hybridgroup/gobot/v2/platforms/opencv/lena-256x256.jpg

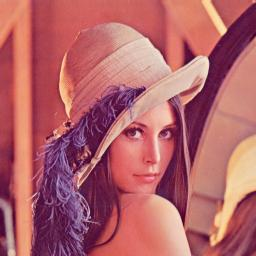
v2/platforms/opencv/lena-256x256.jpg
