hybridgroup/gobot/platforms/dji/README.md

# DJI

This package contains the Gobot drivers for DJI (https://www.dji.com/) drones.

This package currently supports the following drones:
- [DJI Tello](https://www.ryzerobotics.com/tello)
