hybridgroup/gobot/platforms/upboard/README.md

# Upboard

This package contains the Gobot adaptor for the [UP2]() IoT platforms.

This package currently supports the following hardware:
- UP2 (Squared)
