hybridgroup/gobot/.chglog/CHANGELOG.gobot.md

# {{ .Info.Title }}

Please adjust manually before add content to CHANGELOG.md.

{{ if .Versions -}}
## [Unreleased]({{ .Info.RepositoryURL }}/compare/{{ $latest := index .Versions 0 }}{{ $latest.Tag.Name }}...HEAD)

{{ if .Unreleased.CommitGroups -}}
{{ range .Unreleased.CommitGroups -}}
### {{ .Title }}
{{ range .Commits -}}
* {{ if .Scope }}**{{ .Scope }}:** {{ end }}{{ .Subject }}
{{ end }}
{{ end -}}
{{ end -}}
{{ end -}}

{{ range .Versions }}## {{ if .Tag.Previous }}[{{ .Tag.Name }}]({{ $.Info.RepositoryURL }}/compare/{{ .Tag.Previous.Name }}...{{ .Tag.Name }}){{ else }}{{ .Tag.Name }}{{ end }} ({{ datetime "2006-01-02" .Tag.Date }})

{{ range .CommitGroups -}}
### {{ .Title }}

{{ range .Commits -}}
* {{ if .Scope }}**{{ .Scope }}:** {{ end }}{{ .Subject }}
{{ end }}
{{ end -}}

{{- if .NoteGroups -}}
{{ range .NoteGroups -}}
### {{ .Title }}

{{ range .Notes }}
{{ .Body }}
{{ end }}
{{ end -}}
{{ end -}}
{{ end -}}
