hybridgroup/gobot/(threads)

Thread 166 (2014-12-21):

Cant start gobot with raspberry pi adapter and servo driver

razic, 2014-12-21:
here is my code:

```go
package main

import (
        "github.com/hybridgroup/gobot"
        "github.com/hybridgroup/gobot/platforms/gpio"
        "github.com/hybridgroup/gobot/platforms/raspi"
        "log"
        "time"
)

func main() {
        gbot := gobot.NewGobot()
        r := raspi.NewRaspiAdaptor("raspi")
        servo := gpio.NewServoDriver(r, "servo", "23")
        work := func() {
                gobot.Every(10*time.Second, func() {
                        i := uint8(gobot.Rand(180))
                        log.Printf("Moving servo to %d", i)
                        servo.Move(i)
                })
        }
        robot := gobot.NewRobot(
                "servoBot",
                []gobot.Connection{r},
                []gobot.Device{servo},
                work,
        )

        gbot.AddRobot(robot)
        gbot.Start()
}
```

and this is the error is get

```bash
./main.go:14: cannot use r (type *raspi.RaspiAdaptor) as type gpio.Servo in argument to gpio.NewServoDriver:                                                                                                        │
        *raspi.RaspiAdaptor does not implement gpio.Servo (missing InitServo method)
```

any suggestions?

razic, 2015-01-03:
@zankich great. sounds like we're almost there. is it possible you would be able to explain on a high level a bit more in-depth what it would take to get the pi blaster support going?

correct me if i'm wrong, but it seems like pi-blaster is either a process or a script that needs to be run at least once. then, we can write values to `/dev/pi-blaster`?

zankich, 2015-01-03:
@razic I created a branch with initial pi-blaster support https://github.com/hybridgroup/gobot/tree/raspi_pwm. In order to get this to work you'll have to follow the installation instructions for [pi-blaster](https://github.com/sarfata/pi-blaster#how-to-build-and-install). I don't currently have access to a raspberry pi, so I only tested locally with manually verifying values and it should work.... If you're feeling brave you can check out that branch and let me know how it goes!

SellJamHere, 2015-06-25:
Has there been any further work on PWM support?

zankich, 2015-06-30:
@razic and @SellJamHere pwm support has just landed in the master branch. You need to follow the instructions [here](https://github.com/hybridgroup/gobot/tree/master/platforms/raspi#enabling-pwm-output-on-gpio-pins) to enable PWM pins.

edgarsilva, 2015-07-03:
We should close this since pwm support has been added, or are we waiting for release?

zankich, 2015-07-03:
This has been released and I tested with a servo and led on a raspi b+

matipan, 2018-10-08:
@zankich Do you have an example I could follow? I'm trying with a MG90 servo tower connected to GPIO 11 on a pi b+ but it does not seem to be working

deadprogram, 2018-10-08:
You might want to open a new issue @matipan this one has been closed for a long time.

Closed 2015-07-03.

Thread 172 (2015-01-15):

Servos: setting minimum and maximum "pulse width" - Arduino

pipejesus, 2015-01-15:
Using the Arduino libraries i can set the maximum and minimum pulse width for my servo so that i can calibrate it. Is it possible with Gobot ? What i mean is this : http://arduino.cc/en/Reference/ServoAttach

zankich, 2015-01-15:
@pipejesus at the moment no, we don't have that capability, however I'm currently working on a refactor of our firmata implementation and based off of the [servo](https://github.com/firmata/protocol/blob/master/servos.md) protocol document, it should be easy to add.

pipejesus, 2015-01-15:
Superb! Great project, thank you Adrian for bringing Gobot to Earth :-)

losinggeneration, 2016-07-17:
It looks like this might be implemented (at least on the client library.) https://github.com/hybridgroup/gobot/blob/dev/platforms/firmata/client/client.go#L217 However, it looks like the bytes are sent as max,min instead of min,max unless I'm misunderstanding the code and/or protocol doc.

deadprogram, 2016-07-19:
Hi @losinggeneration looks to me like you are absolutely correct. Would you be willing to submit a PR with that fix?

losinggeneration, 2016-07-20:
I'll pick up a servo tomorrow to verify it works and then get a PR in for it.

deadprogram, 2016-11-05:
Seems like this was addressed already. Please reopen if needed.

Closed 2016-11-05.

Thread 173 (2015-02-04):

Running firmata_blink on Arduino fails on second attempt.

dkinzer, 2015-02-04:
If I control C out of a running process and retry then the new process hangs unless I unplug and replug the USB port from the Arduino device.

```

(examples)(master)$./firmata_blink
2015/02/04 09:51:06 Initializing Robot bot ...
2015/02/04 09:51:06 Initializing connections...
2015/02/04 09:51:06 Initializing connection arduino ...
2015/02/04 09:51:06 Initializing devices...
2015/02/04 09:51:06 Initializing device led ...
2015/02/04 09:51:06 Starting Robot bot ...
2015/02/04 09:51:06 Starting connections...
2015/02/04 09:51:06 Starting connection arduino on port /dev/ttyACM0...
2015/02/04 09:51:12 Starting devices...
2015/02/04 09:51:12 Starting device led on pin 13...
2015/02/04 09:51:12 Starting work...
^C2015/02/04 09:51:35 Stopping Robot bot ...
dkinzer09:51[~/go/src/github.com/hybridgroup/gobot/examples]
(examples)(master)$./firmata_blink
2015/02/04 09:51:47 Initializing Robot bot ...
2015/02/04 09:51:47 Initializing connections...
2015/02/04 09:51:47 Initializing connection arduino ...
2015/02/04 09:51:47 Initializing devices...
2015/02/04 09:51:47 Initializing device led ...
2015/02/04 09:51:47 Starting Robot bot ...
2015/02/04 09:51:47 Starting connections...
2015/02/04 09:51:47 Starting connection arduino on port /dev/ttyACM0...
```

saljam, 2015-03-31:
I can reproduce this but only on Linux. OS X seems to work fine.

Also worth mentioning that unbinding and rebinding the USB serial driver doesn't seem to affect it. Only unplugging and plugging back in again or pressing the reset button on the Arduino seems to do the job.

dkinzer, 2015-03-31:
Yes, I should have mentioned that I was using Ubuntu 14.04 LTS when I ran into this issue.

saljam, 2015-03-31:
OK it seems that when the Firmata firmware is reset it preemptively sends over its firmwareQuery answer, which triggers the rest of the initialisation process in the package.

But for some reason, the reset command doesn't actually register on my Arduino when send from a Linux host :-/ Explicitly sending a firmwareQuery when connecting works around this, however. I'll send a PR in a bit.

zankich, 2015-04-06:
@dkinzer does https://github.com/hybridgroup/gobot/pull/180 fix the problem you're experiencing?

dkinzer, 2015-04-07:
Sorry, I can't check this until tomorrow.

dkinzer, 2015-04-08:
@saljam @zankich it works, but not consistently.  Almost invariable on the first attempt it fails.  I control C out of that and try again and then it works.  Sometimes have to even try several failed attempts before it works.

By the way, what's the canonical way of trying out patches in go projects.  For this one I just manually made the change on my local firmata.go file.

saljam, 2015-04-08:
@dkinzer thanks for testing! I'll try to make it produce the same behaviour as that when I get some time. When I tried it it seemed to work fine here.

To try out a pull request you could run:

    $ git fetch origin pull/<pull-request-id>/head:<new-branch-name>
    $ git checkout <new-branch-name>

and rebuild the project. The [GitHub documentation](https://help.github.com/articles/checking-out-pull-requests-locally/) has more about this.

dkinzer, 2015-04-08:
@saljam thanks.  The problem regarding testing of a patch had more to do with the Go System then the technicality of pulling in new code and running it, because go imports take repo source direclty (i.e "github.com/hybridgroup/gobot/platforms/firmata").

saljam, 2015-04-08:
The go tool checks out the repository into $GOPATH if it doesn't already exist, and that's pretty much all it knows about version control. Other than that, the import path is just the path to the package source files. So if you `cd $GOPATH/github.com/hybridgroup/gobot` then fetch and checkout the pull request in there it will use the new version.

dkinzer, 2015-04-08:
cool. thanks!

zankich, 2015-06-30:
@dkinzer the firmata package has been updated, can you please pull the latest master branch and test, thanks!

saljam, 2015-07-01:
FWIW the latest master works for me. Thanks again.

edgarsilva, 2015-07-04:
Closing this since it seems fixed in master and latest release.

Closed 2015-07-04.

Thread 174 (2015-02-04):

beaglebone usr led path incorrect

blalor, 2015-02-04:
Trying out gobot with a white Beaglebone running Debian.  The path to the usr leds on my device is `/sys/devices/ocp.3/gpio-leds.7/leds/beaglebone:green:`, but the Beaglebone adaptor is hard-coded to `/sys/devices/ocp.3/gpio-leds.8/leds/beaglebone:green:`.  So the blinking doesn't happen (and worse, there's no error).

I haven't found a canonical source for this info, but from [this](http://derekmolloy.ie/beaglebone-controlling-the-on-board-leds-using-c/) it appears (and I've verified) that there are symlinks in `/sys/class/leds` that point to the appropriate `gpio-leds.X` location.  Also referenced [here](http://robotic-controls.com/book/export/html/69).

If there's not already a fix in the works (haven't seen any other issues filed for this), I'll whip up a PR.

zankich, 2015-02-04:
@blalor it seems like doing a `glob` similarly to how the `ocp` and `slots` are figured out should be an easy fix. I would gladly accept a pr to fix this issue :+1:

deadprogram, 2015-11-07:
Hi, @blalor

Did you ever create a fix for this issue, and if so, can you submit a PR?

Thanks!

deadprogram, 2016-11-27:
This issue should now be addressed in the https://github.com/hybridgroup/gobot/tree/feature/beaglebone-4 branch.

deadprogram, 2016-11-30:
Here is a PR for any comments: https://github.com/hybridgroup/gobot/pull/342

deadprogram, 2016-12-03:
This has been merged into the `dev` branch. Thanks everyone!

Closed 2016-12-03.

Thread 176 (2015-02-21):

problem in blink led gobot

myalexer, 2015-02-21:
hi
my platform is arduino - os : win7
my code :
package main

import (
	"time"
	"github.com/hybridgroup/gobot"
	"github.com/hybridgroup/gobot/platforms/firmata"
	"github.com/hybridgroup/gobot/platforms/gpio"
)

func main() {
	gbot := gobot.NewGobot()

	firmataAdaptor := firmata.NewFirmataAdaptor("arduino", "COM15")
	led := gpio.NewLedDriver(firmataAdaptor, "led", "13")

	work := func() {
		gobot.Every(1 * time.Second, func() {
			led.Toggle()
		})
	}

	robot := gobot.NewRobot("bot3",
		[]gobot.Connection{firmataAdaptor},
		[]gobot.Device{led},
		work,
	)

	gbot.AddRobot(robot)

	gbot.Start()
}

all things is ok
i type go run blink.go
it return :
2015/02/21 00:07:40 Initializing Robot bot3 ...
2015/02/21 00:07:40 Initializing connections...
2015/02/21 00:07:40 Initializing connection arduino ...
2015/02/21 00:07:40 Initializing devices...
2015/02/21 00:07:40 Initializing device led ...
2015/02/21 00:07:40 Starting Robot bot3 ...
2015/02/21 00:07:40 Starting connections...
2015/02/21 00:07:40 Starting connection arduino on port COM15...

program start successful but led do not Toggle every 1 second
how do i do?

zankich, 2015-02-23:
@myalexer Is your arduino flashed with firmata and are you sure that COM15 is the correct port number? I just tested on windows 7 and it worked for me...

myalexer, 2015-02-24:
yes i test it with arduino program - in arduino ide port is COM15  - blink program with arduino syntax is ok and it work

myalexer, 2015-02-24:
how can i found COM port number?

mukosolu, 2015-04-09:
Hi, I also struggled with this problem. it might be an idea for this page: http://gobot.io/documentation/getting-started/ to also tell users to run the firmata example first.

myalexer, 2015-04-12:
i test it but it can't work
i found port . but led not toggle every second
i think it's bug

LaraChicharo, 2015-04-27:
I have the same problem on Arduino uno, but Ubuntu 14.10. It blinks three times no matter what port I set, even when led is not in that port. According to me, my serial port is correct 'ttyACM0'. If I get something I will let you know.

LaraChicharo, 2015-04-27:
I can run it now!
My problem was that I was not flashed the Arduino with firmata.
http://firmata.org/wiki/Main_Page#Arduino_Uno

I'm not really sure, but, in gobot's getting started documentation there is nothing about firmata.

zankich, 2015-04-27:
@LaraChicharo I'll add more documentation about steps for loading firmata on your arduino, sorry for the confusion!

myalexer, 2015-05-02:
zankich please help me for solved this problem
i start 2 month ago , but still i have problem in blink led !!!!

pedromorgan, 2015-06-20:
Yea I;m kinda stuck with Firmata not working also,... amd confused..

edgarsilva, 2015-07-03:
Hi guys,

First things first, the process to get the blink example working is as follows:

### Upload Firmata Sketch to the Arduino.
You can do this using the Arduino IDE or using (gort.io)[gort.io].

When using the Arduino IDE just click on file > examples > firmata > StandardFirmata and upload that sketch to the arduino.

When using (gort.io)[gort.io] first install it, then run:
```
# This installs avrdude, which allows to upload the firmata sketch to the arduino
gort arduino install

# Scan serial port for arduino serialport address
gort scan serial

# Upload firmata protocol/sketch to the correct port the arduino is connected to
$ gort arduino upload firmata /dev/ttyACM0
```

### Compile and run arduino_blink.go

Make sure you are using the correct port, in the case of windows you can check the port is the correct one if you can upload an example (like blink sketch) in the arduino IDE. If it uploads and works you should be good. Just update the port in the gobot example and compile.

In Linux is even easier to identify the serial port by using either `gort scan serial` or just checking `/dev/ttyACM*`.

Compile and run the program, after that it should work fine.

Let me know if that helps.

deadprogram, 2015-11-07:
Hi, everyone

I think the docs located here are sufficient: https://github.com/hybridgroup/gobot/blob/dev/platforms/firmata/README.md

If not, someone can re-open this issue. Thanks, and closing.

kedare, 2017-01-07:
Same problem here, Arduino Uno with the firmata firmware flashed fine ( I could use pyFirmata to test), nothing happens, I added some logs in the program to have more information :

```
package main

import (
	"fmt"
	"time"

	"gobot.io/x/gobot"
	"gobot.io/x/gobot/drivers/gpio"
	"gobot.io/x/gobot/platforms/firmata"
)

func main() {
	firmataAdaptor := firmata.NewAdaptor("/dev/cu.usbmodem1411")
	led := gpio.NewLedDriver(firmataAdaptor, "13")

	work := func() {
		gobot.Every(1*time.Second, func() {
			fmt.Println("Updating LED")
			led.Toggle()
		})
	}

	robot := gobot.NewRobot("bot",
		[]gobot.Connection{firmataAdaptor},
		[]gobot.Device{led},
		work,
	)

	fmt.Println("Starting")
	robot.Start()
	fmt.Println("Started")
}
```

```
2017/01/07 22:43:22 Initializing connections...
2017/01/07 22:43:22 Initializing connection Firmata ...
2017/01/07 22:43:22 Initializing devices...
2017/01/07 22:43:22 Initializing device LED ...
2017/01/07 22:43:22 Robot bot initialized.
Starting
2017/01/07 22:43:22 Starting Robot bot ...
2017/01/07 22:43:22 Starting connections...
2017/01/07 22:43:22 Starting connection Firmata on port /dev/cu.usbmodem1411...
```

It's not even running the work function.

The TTY port is correct (Detected by Arduino IDE and working fine with pyFirmata)

What could be the cause ?

kedare, 2017-01-07:
Ok I found the issue, looks like for master part is missing from the example code, here is the working one :

```
package main

import (
	"fmt"
	"time"

	"gobot.io/x/gobot"
	"gobot.io/x/gobot/drivers/gpio"
	"gobot.io/x/gobot/platforms/firmata"
)

func main() {
	gbot := gobot.NewMaster()
	firmataAdaptor := firmata.NewAdaptor("/dev/cu.usbmodem1411")
	led := gpio.NewLedDriver(firmataAdaptor, "13")

	work := func() {
		gobot.Every(1*time.Second, func() {
			fmt.Println("Updating LED")
			led.Toggle()
		})
	}

	robot := gobot.NewRobot("bot",
		[]gobot.Connection{firmataAdaptor},
		[]gobot.Device{led},
		work,
	)

	gbot.AddRobot(robot)

	fmt.Println("Starting")
	gbot.Start()
	fmt.Println("Started")
}
```

deadprogram, 2017-01-08:
Hi @kedare the original example code works for me, albeit by changing my serial port to `/dev/ttyACM0` as I am on Linux.

```
$ go run ./examples/check.go
2017/01/08 17:29:05 Initializing connections...
2017/01/08 17:29:05 Initializing connection Firmata ...
2017/01/08 17:29:05 Initializing devices...
2017/01/08 17:29:05 Initializing device LED ...
2017/01/08 17:29:05 Robot bot initialized.
Starting
2017/01/08 17:29:05 Starting Robot bot ...
2017/01/08 17:29:05 Starting connections...
2017/01/08 17:29:05 Starting connection Firmata on port /dev/ttyACM0...
2017/01/08 17:29:10 Starting devices...
2017/01/08 17:29:10 Starting device LED on pin 13...
2017/01/08 17:29:10 Starting work...
Updating LED
Updating LED
Updating LED
Updating LED
Updating LED
Updating LED
```

Since the v1.0 release you can use "Classic Gobot" as the first example does, so no need for the `Master()` part.

I then tested the code on OSX, and both examples worked with my serialport `/dev/tty.usbmodem1421`. I suggest you use the `tty` vs the `cu` version of the serial port on OSX.

Hope that helps!

Closed 2015-11-07.

Thread 177 (2015-02-26):

Arduino LED example doesnt work with runtime error: index out of range

lkalneus, 2015-02-26:
Error screenshot: https://yadi.sk/i/3PPaJ05eeuQ9Z

OS: Win8 x64, Platform: Arduino UNO v3.0

deadprogram, 2015-02-26:
Hi, @lkalneus did you flash the Firmata sketch onto your Arduino before running Gobot? You can use Gort (http://gort.io) to do this.

lkalneus, 2015-03-16:
@deadprogram, yeah you are right.
It was a stupid mistake, sorry)

Closed 2015-03-16.

Thread 182 (2015-04-15):

Docs clarification: what is the MCP?

Symmetric, 2015-04-15:
I've had a look at the docs, and this project looks very useful -- but the demo examples don't discuss the high-level architecture very thoroughly.

There's mention of an MCP in a few places, but this isn't really covered in the docs. After a bit of digging and watching your videos and so on, I think I've got a grasp on these concepts -- but I think it would be useful to extend the docs to clearly cover a few of these points:

* What is the MCP?
 * For a "Hello world" usecase, probably a laptop
 * For an IOT household sensor project, I suppose this could be a Raspberry Pi?
 * Any other use cases you have envisioned?
* Can you load a program onto a microcontroller and then run it in standalone mode?
 * The docs seem to suggest that I need to keep my laptop (MCP?) connected all the time, rather than the Arduino way of compiling and loading a program onto the microcontroller. This is a big difference which isn't explicitly called out, and I think should be clarified.
 * I think a corrolary of this is that if I want to use an Arduino with GoBot, it must be connected to another device at all times.
 * What about ARM microcontrollers (such as the Teensy) which can run Go code natively? It looks like GoBot doesn't currently support running these guys in standalone mode.

If any of these points are wrong/incomplete please correct me, this is just what I've gleaned from a bunch of digging on your site.

zankich, 2015-04-15:
@Symmetric so basically the `MCP` is what controls and coordinates all of your [robots](http://godoc.org/github.com/hybridgroup/gobot#Robot). It is represented as the [gobot](http://godoc.org/github.com/hybridgroup/gobot#Gobot) type. When you do a `NewGobot()` you are instantiating a new `MCP` which you can then add robots to. The `MCP` can run locally on a computer, in the case of a laptop or raspberry pi, or it can run in a cloud instance, and remotely control robots, or communicate with other `MCP` instances to do some work. The `MCP` is the part that allows the [api](http://godoc.org/github.com/hybridgroup/gobot/api) to access your robots, and does the auto initialization and cleanup of your robots in your program. This architecture [diagram](http://cylonjs.com/images/elements/architecture-mcp.png) might help understand what's going on. Our sister project cylon.js has a section on the website discussing the architecture, which needs to be added to the gobot site as well. You can check it out [here](http://cylonjs.com/documentation/architecture/) and even though it's talking about cylon, the general architecture is still the same.

As far as running gobot on a microcontroller, that is currently not possible due the limitations in the go language. Go requires an operating system to run, so if your board does not have an OS then you can't run go on it. This however does not mean that you can't use gobot to control a microcontroller. If the microcontroller has a remote interface, such as firmata, littlewire, etc, then you can use gobot to remotely control the device. In the case of a teensy or an arduino, if you add something like a zigbee or wifi radio, you can use gobot to remotely control them from a central server, which will hold your app logic and coordinate your devices.

I hope this helps answer some of your questions. The architecture diagram and info really needs to be added to the website so that more of this stuff is clear.

deadprogram, 2016-10-21:
The `dev` branch of Gobot has many changes, one of which is that you can now run Gobot just using Robots aka "Classic Gobot". You can also use "Master Gobot" if what you want is to control multiple robots or use the API.

I am going to close this issue, please reopen if needed. Thanks.

Closed 2016-10-21.

Thread 183 (2015-04-15):

Suppor for Teensy boards?

Symmetric, 2015-04-15:
Currently there's no support listed for the ARM Cortex-M4 based [Teensy 3.1](https://www.pjrc.com/store/teensy31.html) board. Do you have plans to add support for this board?

It's appealing since it has an interrupt-driven USB stack, so it can support high bandwidth applications.

zankich, 2015-04-15:
@Symmetric I've used gobot on a teensy 3.0 using the [firmata](https://github.com/hybridgroup/gobot/tree/master/platforms/firmata) package, so it should work with the 3.1. The teensy website has more information about firmata compatibility [here](http://www.pjrc.com/teensy/td_libs_Firmata.html). Unfortunately you can't run go directly on the board itself, due to go's runtime requirements.

Symmetric, 2015-04-18:
Thanks!

Closed 2015-04-18.

Thread 188 (2015-05-13):

Gobot not working on Arduino Duemilanove

razasayed, 2015-05-13:
I have an Arduino Duemilanove. It works fine and i am able to use it from Processing code in Arduino IDE v1.6.3 on my OSX machine.
I installed gobot,but the arduino example given on gobot.io does not work on it. The LED on pin 13 does not blink every 1 second. I see the list of supported hardware is Arduino uno R3 and Teensy, as given on http://gobot.io/documentation/platforms/arduino/.
Any way i can make gobot work with Arduino Duemilanove  ?

Thanks

razasayed, 2015-05-13:
OK, finally got it to work :). Uploaded Standard Firmata to the board using the IDE.

Closed 2015-05-13.

Thread 195 (2015-07-09):

Stack trace when ctrl+c this program

zankich, 2015-07-09:
This program stack traces when you ctrl+c it

```go
package main                                                                                 
                                                                                             
import (                                                                                     
  "fmt"                                                                                      
                                                                                             
  "github.com/hybridgroup/gobot"                                                             
  "github.com/hybridgroup/gobot/platforms/gpio"                                              
  "github.com/hybridgroup/gobot/platforms/intel-iot/edison"                                  
)                                                                                            
                                                                                             
func main() {                                                                                
  gbot := gobot.NewGobot()                                                                   
                                                                                             
  board := edison.NewEdisonAdaptor("board")                                                  
  sensor := gpio.NewAnalogSensorDriver(board, "sensor", "0")                                 
                                                                                             
  work := func() {                                                                           
    gobot.On(sensor.Event("data"), func(data interface{}) {                                  
      fmt.Println("sensor", data)                                                            
    })                                                                                       
  }                                                                                          
                                                                                             
  robot := gobot.NewRobot("sensorBot",                                                       
    []gobot.Connection{board},                                                               
    []gobot.Device{sensor},                                                                  
    work,                                                                                    
  )                                                                                          
                                                                                             
  gbot.AddRobot(robot)                                                                       
                                                                                             
  gbot.Start()                                                                               
}
```
```
^C2015/07/09 17:21:26 Stopping Robot sensorBot ...
panic: runtime error: invalid memory address or nil pointer dereference
[signal 0xb code=0x1 addr=0x1 pc=0x8098519]

goroutine 1 [running]:
github.com/hybridgroup/gobot/platforms/intel-iot/edison.(*EdisonAdaptor).Finalize(0x1843a060, 0x0, 0x0, 0x0)
        /home/adrian/code/go/gopath/src/github.com/hybridgroup/gobot/platforms/intel-iot/edison/edison_adaptor.go:298 +0x4e9
github.com/hybridgroup/gobot.(*Connections).Finalize(0x18438130, 0x0, 0x0, 0x0)
        /home/adrian/code/go/gopath/src/github.com/hybridgroup/gobot/connection.go:66 +0xb3
github.com/hybridgroup/gobot.func·006(0x1843a090)
        /home/adrian/code/go/gopath/src/github.com/hybridgroup/gobot/gobot.go:82 +0x3db
github.com/hybridgroup/gobot.(*Robots).Each(0x184380e0, 0x18478ea8)
        /home/adrian/code/go/gopath/src/github.com/hybridgroup/gobot/robot.go:73 +0x5e
github.com/hybridgroup/gobot.(*Gobot).Start(0x18436480, 0x0, 0x0, 0x0)
        /home/adrian/code/go/gopath/src/github.com/hybridgroup/gobot/gobot.go:88 +0x341
main.main()
        /home/adrian/code/hybridgroup/gobot/examples/edison_grove_rotary_sensor.go:31 +0x409

goroutine 5 [syscall]:
os/signal.loop()
        /home/adrian/code/go/go1.4.2/src/os/signal/signal_unix.go:21 +0x21
created by os/signal.init·1
        /home/adrian/code/go/go1.4.2/src/os/signal/signal_unix.go:27 +0x34

goroutine 6 [chan receive]:
github.com/hybridgroup/gobot.(*Event).Read(0x184380f0)
        /home/adrian/code/go/gopath/src/github.com/hybridgroup/gobot/event.go:39 +0x52
github.com/hybridgroup/gobot.func·003()
        /home/adrian/code/go/gopath/src/github.com/hybridgroup/gobot/event.go:22 +0x31
created by github.com/hybridgroup/gobot.NewEvent
        /home/adrian/code/go/gopath/src/github.com/hybridgroup/gobot/event.go:24 +0x125

goroutine 7 [chan receive]:
github.com/hybridgroup/gobot.(*Event).Read(0x18438100)
        /home/adrian/code/go/gopath/src/github.com/hybridgroup/gobot/event.go:39 +0x52
github.com/hybridgroup/gobot.func·003()
        /home/adrian/code/go/gopath/src/github.com/hybridgroup/gobot/event.go:22 +0x31
created by github.com/hybridgroup/gobot.NewEvent
        /home/adrian/code/go/gopath/src/github.com/hybridgroup/gobot/event.go:24 +0x125

goroutine 8 [runnable]:
github.com/hybridgroup/gobot/platforms/gpio.func·002()
        /home/adrian/code/go/gopath/src/github.com/hybridgroup/gobot/platforms/gpio/analog_sensor_driver.go:71 +0x186
created by github.com/hybridgroup/gobot/platforms/gpio.(*AnalogSensorDriver).Start
        /home/adrian/code/go/gopath/src/github.com/hybridgroup/gobot/platforms/gpio/analog_sensor_driver.go:77 +0xc6
```

zankich, 2015-07-09:
fixed with https://github.com/hybridgroup/gobot/commit/5b94e593ec443639c2f0ca38d47d3fc6c5d0d22b

Closed 2015-07-09.

Thread 205 (2015-07-11):

PWM exported functions for Intel Edison

mattetti, 2015-07-11:
To be able to properly use the PWM possibilities of the Edison, one needs to set the `period` and `duty cycle` to create a pulse at a given frequency:

```
If you want a 1.6kHz wave that is a 625 microsecond period or 626000 nanoseconds (assuming a 50% duty cycle).

echo -n "625000" > /sys/class/pwm/pwmchip0/pwm3/period
echo -n "312500" > /sys/class/pwm/pwmchip0/pwm3/duty_cycle
```

Unfortunately, right now, gobot developers don't have access to period and duty cycle, as a matter of fact, they have almost no access to anything pwm related and only `func (e *EdisonAdaptor) PwmWrite` seems exposed (and it does a lot of magic).

My suggestion is to export `pwmPin` and its methods so developers interested in going a bit lower level can have fun ;)

mattetti, 2015-07-11:
@zankich @deadprogram This is currently a blocker for me to generate a proper audio signal via PWM.
For anyone else looking at this issue, here is a good document on PWM: https://www.arduino.cc/en/Tutorial/SecretsOfArduinoPWM

mattetti, 2015-07-13:
Adrian and I discussed this issue in RL and he suggested to create a new PWM interface for devices offering access to period and duty cycles

deadprogram, 2017-05-03:
Finally addressed this is part of the working done in reference to https://github.com/hybridgroup/gobot/pull/410

There is now a PWMPin that can used with all of the Linux SoC boards for more granular control over the PWM on each board.

For example:

```
a := edison.NewAdaptor()
pin := a.PWMPin("3")

// get period
period := pin.Period()

// set to 50% duty cycle
duty := period / 2
pin.SetDutyCycle(duty)
```

This is all available in the `dev` branch. I will close this issue as soon as it lands in `master` as part of the next release.

deadprogram, 2017-05-10:
This code has now been released as part of Gobot 1.5 so please either open a new issue if needed with any specifics, or reopen this one.

Thanks.

mattetti, 2017-05-10:
😎 thanks

Closed 2017-05-10.

Thread 206 (2015-07-11):

Grove LCD / Intel Edison text not displaying

mattetti, 2015-07-11:
For some reason, the demo example of the LCD doesn't correctly work on my device. While the backlit RGB colors do change properly, no text gets displayed.

deadprogram, 2015-07-11:
Make sure the switch on the side of the Grove shield is set to 5V instead of 3.3V

mattetti, 2015-07-11:
That was indeed the issue, thank you Ron!

Closed 2015-07-11.

Thread 207 (2015-07-12):

jhd1313m1 driver is missing the scrolling API

mattetti, 2015-07-12:

mattetti, 2015-07-12:
I tried to implement this method:

```go
// Scroll scrolls the dispay to the right or the left based on the passed
// param.
func (h *JHD1313M1Driver) Scroll(leftToRight bool) error {

	if leftToRight {
		return h.connection.I2cWrite(h.rgbAddress, []byte{LCD_CMD, LCD_CURSORSHIFT | LCD_DISPLAYMOVE | LCD_MOVELEFT})
	}

	return h.connection.I2cWrite(h.rgbAddress, []byte{LCD_CMD, LCD_CURSORSHIFT | LCD_DISPLAYMOVE | LCD_MOVERIGHT})
}
```

Which is supposed to be a port of https://github.com/intel-iot-devkit/upm/blob/master/src/lcd/jhd1313m1.cxx#L109

Unfortunately this feature doesn't seem to work, I'm not getting an error but nothing happens and the backlit seems to be in a weird state where I can't set the rgb colors anymore.
I also tried on an arduino and on the edison. I tried to change the first byte we write, from `0x80` to `0x40`, it wasn't doing anything on the arduino and it returned an error on the edison.

mattetti, 2015-07-12:
addressed in #209

Closed 2015-07-13.

Thread 211 (2015-07-12):

errors when reading from LIDARLiteDriver and JHD1313M1Driver

mwhooker, 2015-07-12:
code to reproduce is here https://github.com/mwhooker/speedo/tree/b6a116c9403cd26db63183fe1aaea9f006d43dc7

Every time I run the program I get an error, although the behavior varies:

```
root@edison:~# ./speedo
2015/07/12 07:04:36 Initializing Robot screenBot ...
2015/07/12 07:04:36 Initializing connections...
2015/07/12 07:04:36 Initializing connection edison ...
2015/07/12 07:04:36 Initializing devices...
2015/07/12 07:04:36 Initializing device lidar ...
2015/07/12 07:04:36 Initializing device screen ...
2015/07/12 07:04:36 Starting Robot screenBot ...
2015/07/12 07:04:36 Starting connections...
2015/07/12 07:04:36 Starting connection edison...
2015/07/12 07:04:36 Starting devices...
2015/07/12 07:04:36 Starting device lidar...
2015/07/12 07:04:36 Starting device screen...
[  505.390547] i2c-designware-pci 0000:00:09.1: i2c_dw_handle_tx_abort: lost arbitration
2015/07/12 07:04:36 Error: Robot "screenBot": Device "screen": write /dev/i2c-6: resource temporarily unavailable
2015/07/12 07:04:36 Stopping Robot screenBot ...
root@edison:~# ./speedo
2015/07/12 07:04:40 Initializing Robot screenBot ...
2015/07/12 07:04:40 Initializing connections...
2015/07/12 07:04:40 Initializing connection edison ...
2015/07/12 07:04:40 Initializing devices...
2015/07/12 07:04:40 Initializing device lidar ...
2015/07/12 07:04:40 Initializing device screen ...
2015/07/12 07:04:40 Starting Robot screenBot ...
2015/07/12 07:04:40 Starting connections...
2015/07/12 07:04:40 Starting connection edison...
2015/07/12 07:04:40 Starting devices...
2015/07/12 07:04:40 Starting device lidar...
2015/07/12 07:04:40 Starting device screen...
2015/07/12 07:04:40 Starting work...
Distance (in) 0
Distance (in) 0
Distance (in) 0
^C2015/07/12 07:04:42 Stopping Robot screenBot ...
```

I can get the lidar to start outputting correct distance if I unplug both the screen and the lidar, and then plug the lidar back in. Unplugging and replugging only one or the other does not work.

zankich, 2015-07-12:
@mwhooker the problem is that the i2c rgb led on the jhd1313m1 has the same i2c address of the lidar....

mwhooker, 2015-07-12:
that's unfortunate. Is there any chance of a workaround? perhaps I can take a screwdriver to the lcd i2c controller...

zankich, 2015-07-12:
@mwhooker there is a [pwm](https://github.com/PulsedLight3D/LIDARLite_Basics/blob/master/Arduino/LIDARLite_PWM_GetDistance_ContinuousRead/LIDARLite_PWM_GetDistance_ContinuousRead.ino) interface to the lidar, but that will require implementing a `pulseIn` equivalent in Gobot

mwhooker, 2015-07-12:
okay. I think I'll just modify https://github.com/hybridgroup/gobot/blob/f63fab81a3fecf2d9cc6fdfd643625fdb60fd834/platforms/i2c/jhd1313m1_driver.go to not interact with the led, or perhaps a hardware solution. thanks!

mwhooker, 2015-07-13:
above didn't work, which should have been obvious. the i2c slave still listens on the conflicting address

according to http://www.nxp.com/documents/data_sheet/PCA9533.pdf, the slave address is hard coded, but there's another version I can get with a different address (PCA9533/02). I think I'll try to track down one of those. closing, thanks!

I'm not sure this is possible, but it would be neat if gobot could detect i2c collisions and give me an error about it.

Closed 2015-07-13.

Thread 213 (2015-07-14):

Robot.Start should run r.Work() as a goroutine.

pborman, 2015-07-14:
In gobot/robot.go, around line 134, func (r *Robot) Start() calls r.Work().  If r.Work() does not return then Start will hang.  If this hangs then func (r *Robots) Start() will also hang and not call Start on any further Robots.  The solution is to make the call a goroutine.  Patch attached below.

diff --git a/robot.go b/robot.go
index 8775e87..131fade 100644
--- a/robot.go
+++ b/robot.go
@@ -131,7 +131,7 @@ func (r *Robot) Start() (errs []error) {
 	}
 	if r.Work != nil {
 		log.Println("Starting work...")
-		r.Work()
+		go r.Work()
 	}
 	return
 }

pborman, 2015-07-14:
The patch, without being marked down, is:

```
diff --git a/robot.go b/robot.go
index 8775e87..131fade 100644
--- a/robot.go
+++ b/robot.go
@@ -131,7 +131,7 @@ func (r *Robot) Start() (errs []error) {
 	}
 	if r.Work != nil {
 		log.Println("Starting work...")
-		r.Work()
+		go r.Work()
 	}
 	return
 }
```

zankich, 2015-07-14:
@pborman can you please create a pull request with this patch?

joushou, 2015-07-21:
The suggestion in #216 (split gobot.Start into gobot.Start and gobot.Stop) would most likely deprecate Work (it would no longer serve a purpose), which I find to be a bit of a peculiar construct.

zankich, 2015-07-21:
@joushou the work routine is a primitive of a `Robot` once it has successfully `Started`. When you start your `Robot` it has it's `Work` that it does. Adding the `Gobot.Start/Stop` wouldn't change that behavior.

joushou, 2015-07-21:
Ah, I think I was a bit too quick and rough in my wording. Work is called is called at the end of Robot.Start. It is currently necessary because Gobot.Start, which has the responsibility of calling Robot.Start, blocks, and doesn't terminate before os.Interrupt is issued.

Now, if Gobot.Start only called Robot.Start, or a Robot.Stop is made available so that Gobot.Start wasn't necessar, then normal program flow can follow immediately after Robot.Start/Gobot.Start, effectively making Work a slightly funky construct. It would make:

       r := gbot.NewRobot(lalala, lalala, func(){ fmt.Println("DONE!") })
       r.Start()

completely equivalent to:

       r := gbot.NewRobot(lalala, lalala)
       r.Start()
       fmt.Println("DONE!")

Therefore, while the issue of changing Gobot.Start/Stop doesn't directly affect the behaviour of Work, it does make it somewhat redundant, and I was suggesting that its presence should maybe be reconsidered.

Does my message make more sense this way?

deadprogram, 2015-10-31:
@joushou the `Work` is the user's defined function for whatever the `Robot` is supposed to do. `robot.Start` should mean "robot, start doing your defined work".

As such, "work" is an important part of the semantics of the design patterns behind Gobot.

Anyhow, this is somewhat off topic of the original issue. @pborman any chance of getting a PR against `dev` branch?

Thanks everyone!

deadprogram, 2016-10-21:
There has been substantial changes to how Gobot handles Work. Cross-posted from https://github.com/hybridgroup/gobot/issues/283#issuecomment-255311798

There has been subtancial changes to how Gobot creates and manages the goroutines used. Please take a look at the dev branch to see what we've been doing: https://github.com/hybridgroup/gobot/tree/dev

In short:

    every Robot's Work is now run inside of a separate goroutine that exists for the life of the Robot.
    every Device's On and Once event handlers are each run in a separate goroutine that exists for the life of the Device.
    channels are now used for Events, and the implementations of On and Once use the event channels as their implementation to communicate when things happen.

The dev branch has a lot of breaking changes, but I think you will find the syntax is simpler, and the implementation much cleaner and more concurrent by default.

I am going to close this issue, please reopen if so needed. Thanks everyone!

Closed 2016-10-21.

Thread 219 (2015-07-21):

Aggressive spam with firmata

joushou, 2015-07-21:
I haven't debugged this issue deeper, but making a simple robot with firmata, and making an analog reader with interval of 5 seconds causes the arduino to send aggressive rates of messages, which does not seem right (if I log in firmata/client.go@process, my stdout is spammed to death, and the TX light is practically permanently lit on the arduino).

Unsure if bug in firmware or gobot, or if but at all.

deadprogram, 2015-08-25:
Hi, @joushou

Using Firmata requires polling the serial port that is connected to the Arduino. THis is needed to determine if there are any pin changes, new i2c data, etc. As such, a fairly constant rate of communication is required with the serial port being used when using the Firmata protocol.

Please let me know if I can provide any further info, and reopen this issue if so. Thanks!

joushou, 2015-08-25:
If I read the implementation correctly, you're not supposed to poll any of that. REPORT_DIGITAL is supposed to handle info about digital pins, I2C will report back if it's set to continous mode, etc., etc.. It's meant to be a push protocol, not polling.

Of course, I may be wrong, but that's what it looks like from the StandardFirmata Arduino implementation.

joushou, 2015-08-25:
Also, I can't reopen issues. :/

deadprogram, 2016-11-04:
Hi @joushou the implementation of the Firmata's digital and analog readers should have been awaiting report notifications for a while now. I did not testing myself recently and did not see the behavior you are describing. This time I really am going to close, please open a new issue if you see this behavior. Thanks again!

joushou, 2016-11-04:
Sounds good to me. I'll reopen if I get around to testing and trying this again.

Closed 2016-11-04.

Thread 222 (2015-08-24):

Cannot run non-main package

4ur3l13n, 2015-08-24:
trying to (re) install gobot on beagleblone (archlinux) because of the issue https://github.com/hybridgroup/gobot/issues/221 I get a new issue.
bot@icecube:~/go/src/github.com/hybridgroup/gobot/platforms/beaglebone$ ls
beaglebone_adaptor.go  beaglebone_adaptor_test.go  doc.go  LICENSE  pwm_pin.go  README.md
bot@icecube:~/go/src/github.com/hybridgroup/gobot/platforms/beaglebone$ go build beaglebone_adaptor.go
 command-line-arguments
./beaglebone_adaptor.go:130: undefined: pwmPin
bot@icecube:~/go/src/github.com/hybridgroup/gobot/platforms/beaglebone$ go run beaglebone_adaptor.go
go run: cannot run non-main package
bot@icecube:~/go/src/github.com/hybridgroup/gobot/platforms/beaglebone$ uname -a && go version
Linux icecube 4.1.6-1-ARCH #1 Thu Aug 20 22:52:03 MDT 2015 armv7l GNU/Linux
go version go1.5 linux/arm
bot@icecube:~/go/src/github.com/hybridgroup/gobot/platforms/beaglebone$

deadprogram, 2015-08-25:
The problem here is that you are trying to run the wrong thing in Gobot. You want to run your own program, that uses the various adaptors/drivers. For example, you should be trying to run one off the BBB examples.

Hope that helps!

4ur3l13n, 2015-08-28:
Thanks for your light!
Sorry for the disturb.
Sure that helps!

Closed 2015-08-28.

Thread 223 (2015-08-26):

beaglebon_led_brightness.go run but does not do the job on the board BBB

4ur3l13n, 2015-08-26:
I have copy/write and execute your code directly on a BBB
It does not change the brightness of the led, it make blink like other code. I have read he beaglebone pdf and try to find the led ... it correspond to a gpio and change it to another one and the result is just same.
I have also modify the value in the code itself and the result is the same.
I conclude for the moment that the code modify something on the BBB but does not run as it should.
I have get time to also look the bonescript, it use the same led.
http://beagleboard.org/show/makerfairedetroit2013
/*

BeagleBone Led Brightness - GoBot - beaglebone_led_brightness.go

*/

package main

import (
        "time"

        "github.com/hybridgroup/gobot"
        "github.com/hybridgroup/gobot/platforms/beaglebone"
        "github.com/hybridgroup/gobot/platforms/gpio"
)

func main() {
        gbot := gobot.NewGobot()
        beagleboneAdaptor := beaglebone.NewBeagleboneAdaptor("beaglebone")
        led := gpio.NewLedDriver(beagleboneAdaptor, "led", "p9_14")

        work := func() {
                brightness := uint8(0)
                fadeAmount := uint8(5)

                gobot.Every(100*time.Millisecond, func() {
                        led.Brightness(brightness)
                        brightness = brightness + fadeAmount
                        if brightness == 0 || brightness == 255 {
                                fadeAmount = -fadeAmount
                        }
                })
        }

        robot := gobot.NewRobot("pwmBot",
                []gobot.Connection{beagleboneAdaptor},
                []gobot.Device{led},
                work)

        gbot.AddRobot(robot)

        gbot.Start()
}

4ur3l13n, 2015-08-26:
I have get time to also look the bonescript, it use the same led.

4ur3l13n, 2015-08-27:
Sorry I was wrong .. I have not well writtent the line "p9_14" it should be "P9_14"

Closed 2015-08-27.

Thread 224 (2015-08-27):

How to communicate wirelessly with Arduino

alioygur, 2015-08-27:
hi,

how can i direct upload my go project to arduino ? I tried that,

```
gort arduino upload blink  /dev/ttyACM0

avrdude: AVR device initialized and ready to accept instructions

Reading | ################################################## | 100% 0.00s

avrdude: Device signature = 0x1e950f
avrdude: reading input file "gobot"
avrdude: invalid record at line 5316 of "gobot"
avrdude: read from file 'gobot' failed

avrdude done.  Thank you.

2015/08/27 20:27:03 exit status 1
```

deadprogram, 2015-08-27:
Hi, @alioygur

You cannot run Golang directly on an Arduino. Gobot communicates with the Firmata program running on an Arduino microcontroller, by using a serial interface.

Please let me know if that is clear. Thank you!

alioygur, 2015-08-27:
So it doesn't work standalone ?
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

stewart, 2015-08-27:
Hey @alioygur - Arduinos are [microcontrollers](https://en.wikipedia.org/wiki/Microcontroller), and incapable of hosting an operating system or running Go code directly. To provide support in Gobot, we leverage the [Firmata protocol](https://www.arduino.cc/en/Reference/Firmata) to communicate with a sketch the Arduino _is_ capable of running. We then send commands to Firmata over a serial port the Arduino is connected to, and Firmata executes them for us.

However, on more complex single-board Linux computers (Beaglebone Black, Intel Edison, Raspberry Pi, etc), Gobot can be installed and run directly on-board.

alioygur, 2015-08-27:
Okey, thank you so much
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

alioygur, 2015-08-27:
Dear, can I communicate with it over network instead of USB?
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

deadprogram, 2015-08-28:
People have done this several different ways, usually with some cloud-based component such as how Particle does it. I do not have any specific links offhand, I will look into it.

deadprogram, 2017-01-04:
Hi @alioygur please checkout the recent support added to the `dev` branch for the ESP8266 using `firmata.TCPAdaptor()` here: https://github.com/hybridgroup/gobot/blob/dev/examples/wifi_firmata_blink.go

This will also work with any Arduino that is using a WiFi shield and has the Wifi variation of ConfigurableFirmata loaded onto the board.

alioygur, 2017-01-04:
good job!

deadprogram, 2017-01-09:
Experimental support for this was just released as part of v1.1.0. Now closing.

Closed 2017-01-09.

Thread 227 (2015-09-04):

support camera

brunoksato, 2015-09-04:
Gotbot support camera work with arduino

example drive camera OV9655

have support ? thanks

deadprogram, 2015-09-05:
Hi, @brunoksato we currently use the "Firmata" protocol with the Arduino platform. You would need to either extend Firmata, or use some different custom firmware on the Arduino, to support the digital interface used by most of these cameras (SCCB).

We do have OpenCV support, but that is running on a Linux system, not on the Arduino itself. Perhaps that might suit your needs?

brunoksato, 2015-09-06:
i'm need communication for camera + motor + arduino, need to make the communication of these three synchronous way, one depending on the other, using opencv the Gobot I can integrate with Arduino Gobot?

deadprogram, 2015-09-06:
If in that scenario you will have a Linux single-board computer controlling everything, then yes. Since you cannot run Golang on the Arduino itself, that is the only way to do what you describe.

deadprogram, 2015-11-10:
@brunoksato did my last answer address your question?

brunoksato, 2015-11-11:
Sorry delay, yes resolved !

Thanks

Closed 2015-11-11.

Thread 236 (2015-10-01):

Constant Values with MPU6050 on Raspberry Pi

ryanskidmore, 2015-10-01:
I've got my MPU6050 connected via I2C to my Raspberry Pi (WHOAMI returns correct address) but I seem to be getting constant values, despite moving the sensor (quite a lot!).

I've attached a stripped down version of my code below in hopes that it's just an issue with my code, rather than deeper in the Gobot library.

If it isn't a code issue on my end, could there potentially be an issue with the way Gobot configures the MPU6050?

```go
MPU6050Work := func() {
		gobot.Every(50*time.Millisecond, func() {
			fmt.Println("Accelerometer", qc.Sensors.MPU6050.MPU6050Driver.Accelerometer)
			fmt.Println("Gyroscope", qc.Sensors.MPU6050.MPU6050Driver.Gyroscope)
			fmt.Println("Temperature", qc.Sensors.MPU6050.MPU6050Driver.Temperature)
			qc.Sensors.MPU6050.Accel.Values = &qc.Sensors.MPU6050.MPU6050Driver.Accelerometer
			qc.Sensors.MPU6050.Gyro.Values = &qc.Sensors.MPU6050.MPU6050Driver.Gyroscope
		})
	}
MPU6050Bot := gobot.NewRobot("MPU6050Bot", []gobot.Connection{qc.RPiAdaptor}, []gobot.Device{qc.Sensors.MPU6050.MPU6050Driver}, MPU6050Work)
qc.GBot.AddRobot(MPU6050Bot)
qc.GBot.Start()

go func(ss *Sensor_MPU6050, dm *map[int64]string) {
		DLInst := &DataLog{
			Accel: ss.Accel.Values,
			Gyro:  ss.Gyro.Values,
		}
		CTime := time.Now().UnixNano()
		DLInstString, err := json.Marshal(structs.Map(DLInst))
		if err != nil {
			color.Red("[!] Failed to marshal DataLog map:" + err.Error())
		} else {
			(*dm)[CTime] = string(DLInstString)
		}
		time.Sleep(25 * time.Millisecond)
	}(qc.Sensors.MPU6050, &DataMap)

```

deadprogram, 2015-10-03:
Hi, @ryanskidmore

I was just looking at our implementation for MPU6050 in Cylon.js and I see a couple of differences. One in particular being https://github.com/hybridgroup/cylon-i2c/blob/master/lib/mpu6050.js#L113

I will try to find my MPU6050 and play around with this, but if you have a chance to write a little code to send the "wake up" that looks to be worth trying.

ryanskidmore, 2015-10-03:
@deadprogram When I first looked at the driver I initially thought the wakeup instruction was handled by https://github.com/hybridgroup/gobot/blob/dev/platforms/i2c/mpu6050_driver.go#L104, but now that i've looked at it again I can't see any wake up instruction. Just noticed this line though https://github.com/hybridgroup/gobot/blob/dev/platforms/i2c/mpu6050_driver.go#L128 - not entirely sure what this does "setSleepEnabled" gives the impression it's putting it back into sleep mode.

I know that a 0x00 needs to be sent to the PWR_MGMT_1 Register, so I'm guessing that's what's going wrong. I'll try and work on a fix next week sometime.

ryanskidmore, 2015-10-07:
I've had a chance to modify the gobot code but no luck - I removed the set sleep enabled part and send the wake up byte to pwr_mgmt_1 but still getting constant values.

deadprogram, 2015-10-07:
I will play with this when I'm back in the lab later this week. Thanks for reporting.

sgilani, 2015-10-30:
Hi @ryanskidmore

i think you have the same problem like me before. I think this will help you:

open the file mpu6050_driver.go and change:

const MPU6050_PWR1_SLEEP_BIT = 6

to

const MPU6050_PWR1_SLEEP_BIT = 0

Closed 2016-02-17.

Thread 239 (2015-10-25):

Arduino MPU6050

sgilani, 2015-10-25:
I get only back this when i run the Go Prog. on Windows, i checked the Adress with I2C Scanner for Adruino and i get back 0x68, some where the communication is broken.

Plattform Windows 8.1 & Adruino Mega 2560 and the RX/TX Light are On on the Board when i run "go run test_mpu.go", COM Port is set to 57600.

Connection: Adruino to MPU6050 (Not Sparkfun Version)

ADRUINO - 5V to MPU6050 VCC
ADRUINO - GND to MPU6050 GND
ADRUINO - SCL 21 to MPU6050 SCL
ADRUINO - SDA 20 to MPU6050 SDA

Any ideas?

Accelerometer {0 0 0}
Gyroscope {0 0 0}
Temperature 0

package main

import (
  "fmt"
  "time"

  "github.com/hybridgroup/gobot"
  "github.com/hybridgroup/gobot/platforms/firmata"
  "github.com/hybridgroup/gobot/platforms/i2c"
)

func main() {
  gbot := gobot.NewGobot()

  firmataAdaptor := firmata.NewFirmataAdaptor("firmata", "COM4")
  mpu6050 := i2c.NewMPU6050Driver(firmataAdaptor, "mpu6050")

  work := func() {
    gobot.Every(300*time.Millisecond, func() {
      fmt.Println("Accelerometer", mpu6050.Accelerometer)
      fmt.Println("Gyroscope", mpu6050.Gyroscope)
      fmt.Println("Temperature", mpu6050.Temperature)
    })
  }

  robot := gobot.NewRobot("mpu6050Bot",
    []gobot.Connection{firmataAdaptor},
    []gobot.Device{mpu6050},
    work,
  )

  gbot.AddRobot(robot)

  gbot.Start()
}

sgilani, 2015-10-26:
By the end i solved my problem in another way for get the values in go:

1.: Adruino Uploaded the MPU6050 RA Example
2.: Done a conection with serial to get the values

package main

import (
         serial "github.com/tarm/serial"
         "log"

)

func main() {
         conf := new(serial.Config)
         conf.Name = "COM4"
         conf.Baud = 57600
				 conf.ReadTimeout = 0

         sc, err := serial.OpenPort(conf)
         if err != nil {
                 log.Fatal(err)
         }

         buf := make([]byte, 1024)

         for {
                 n, err := sc.Read(buf)
                 if err != nil {
                         log.Fatal(err)
                 }
                 log.Printf("%s\n", buf[:n])
         }
}

sgilani, 2015-10-26:
UPDATE:

In Release 8.2 the MPU6050 Driver is Broken. In Version 8.1 it works more or less, the Values are not refreshed, after removing in github.com/hybridgroup/gobot/platforms/i2c/mpu6050_driver.go this part:

	// setSleepEnabled
	if err = h.connection.I2cWrite([]byte{MPU6050_RA_PWR_MGMT_1,
		MPU6050_PWR1_SLEEP_BIT,
		0}); err != nil {
		return
	}

All looks fine and i have all my values. Later i will make a diff between 8.2 and 8.1 to see what is broken and why.

Maybe for the moment it is helpfull for other users.

deadprogram, 2015-10-26:
Hi, @sgilani

Can you please try this code in substitute for the `initialize` method?

```
func (h *MPU6050Driver) initialize() (err error) {
	if err = h.connection.I2cStart(mpu6050Address); err != nil {
		return
	}

	// setClockSource
	if err = h.connection.I2cWrite(mpu6050Address, []byte{MPU6050_RA_PWR_MGMT_1,
		MPU6050_PWR1_CLKSEL_BIT,
		MPU6050_PWR1_CLKSEL_LENGTH,
		MPU6050_CLOCK_PLL_XGYRO}); err != nil {
		return
	}

	// setFullScaleGyroRange
	if err = h.connection.I2cWrite(mpu6050Address, []byte{MPU6050_RA_GYRO_CONFIG,
		MPU6050_GCONFIG_FS_SEL_BIT,
		MPU6050_GCONFIG_FS_SEL_LENGTH,
		MPU6050_GYRO_FS_250}); err != nil {
		return
	}

	// setFullScaleAccelRange
	if err = h.connection.I2cWrite(mpu6050Address, []byte{MPU6050_RA_ACCEL_CONFIG,
		MPU6050_ACONFIG_AFS_SEL_BIT,
		MPU6050_ACONFIG_AFS_SEL_LENGTH,
		MPU6050_ACCEL_FS_2}); err != nil {
		return
	}

	return nil
}
```

Please let me know if that works for you!

sgilani, 2015-10-26:
HI deadprogramm,

thanks for help, this is the result after implentation, no values.

Accelerometer {0 0 0}
Gyroscope {0 0 0}
Temperature 0

sgilani, 2015-10-27:
Maybe also helpful for debuging:

This freezes the values:

h.adaptor().I2cWrite([]byte{MPU6050_RA_PWR_MGMT_1,
		MPU6050_PWR1_SLEEP_BIT,
		0})

but when i remove just MPU6050_RA_PWR_MGMT_1 so the part looks like this:

h.adaptor().I2cWrite([]byte{
		MPU6050_PWR1_SLEEP_BIT,
		0})

I get again refreshed values, but some are missing:

Accelerometer {20268 -120 14648}
Gyroscope {-5008 -747 0}
Temperature 0

Gyro part 3 and Temp are lost somewhere... really strange

sgilani, 2015-10-27:
Solved for v.8.1, change this

const MPU6050_PWR1_SLEEP_BIT = 6

to this

const MPU6050_PWR1_SLEEP_BIT = 0

then we can also use the setSleepEnabled part without troubles, to get the right values:

Accelerometer {16472 -680 1772}
Gyroscope {-3872 406 -13133}
Temperature 35
Accelerometer {17472 408 4456}
Gyroscope {-3888 -3898 -3417}
Temperature 33
Accelerometer {16836 -120 856}
Gyroscope {-3824 -625 238}
Temperature 35

deadprogram, 2015-10-27:
According to the MPU6050 docs I could find:

```
Get sleep mode status. Setting the SLEEP bit in the register puts the device into very low power sleep mode. In this mode, only the serial interface and internal registers remain active, allowing for a very low standby current. Clearing this bit puts the device back into normal mode. To save power, the individual standby selections for each of the gyros should be used if any gyro axis is not used by the application.
```

So perhaps, a better thing would be to add a new constant `const MPU6050_PWR1_ENABLE_BIT = 0` and use that. I'd love a a PR that did that! :)

sgilani, 2015-10-27:
You are right and i like your idea :) i will change it and share it.

deadprogram, 2015-11-18:
Hi, @sgilani did you ever have a chance to work up a PR with this? :)

Closed 2016-02-17.

Thread 240 (2015-10-29):

OpenCV Window Crash Windows

sgilani, 2015-10-29:
Hello again,

when i try the examples from go-opencv, i have no troubles the webcam and also the hello.go works fine, but with gobot opencv i think the camera works fine (LED is ON), but the window to show the image from the camera, freezes.. not responding.. i tryed on different pc with different web cam, all with the same results.. window not responding.

Then i removed everything with the camera, so just a simple basic window.. result: window not responding..

I tryed this example on different windows computers and with version 0.10 and 0.8, any ideas?

package main

import (
    cv "github.com/hybridgroup/go-opencv/opencv"
    "github.com/hybridgroup/gobot"
    "github.com/hybridgroup/gobot/platforms/opencv"
)

func main() {
    gbot := gobot.NewGobot()

```
window := opencv.NewWindowDriver("window")
camera := opencv.NewCameraDriver("camera", 1)

work := func() {
    gobot.On(camera.Event("frame"), func(data interface{}) {
        window.ShowImage(data.(*cv.IplImage))
    })
}

robot := gobot.NewRobot("cameraBot",
    []gobot.Device{window, camera},
    work,
)

gbot.AddRobot(robot)

gbot.Start()
```

}

sgilani, 2015-10-29:
I changed the code and for creating the window i am using now the original go-opencv and a cv.WaitKey(0) helps a lot, i think you need ti implement this WaitKey to, then all will be fine.

package main

import (
	cv "github.com/hybridgroup/go-opencv/opencv"
	"github.com/hybridgroup/gobot"
	"github.com/hybridgroup/gobot/platforms/opencv"
)

func main() {
	gbot := gobot.NewGobot()

	window := cv.NewWindow("Go-OpenCV")
	defer window.Destroy()

	camera := opencv.NewCameraDriver("camera", 0)

	work := func() {
		gobot.On(camera.Event("frame"), func(data interface{}) {
			window.ShowImage(data.(*cv.IplImage))
			cv.WaitKey(0)
		})
	}

	robot := gobot.NewRobot("cameraBot",
		[]gobot.Device{camera},
		work,
	)

	gbot.AddRobot(robot)

	gbot.Start()
}

deadprogram, 2015-10-30:
Hi, @sgilani thanks for looking into this. From reading OpenCV docs, seems like `WaitKey(0)` waits indefinitely until keyboard input occurs. Can you please try `WaitKey(10)` and see if it redraws display correctly for you?

sgilani, 2015-10-30:
Hello,

Yes also with WaitKey(10) all is fine, but we need to fix some other parts.

Like:

window := cv.NewWindow("Go-OpenCV")
defer window.Destroy()

Here i am using the original part from opencv the gobot part for creating the window crashes. and another point for the Camera which is missing in Gobot Opencv is the camera.Release()  without this every frame stays in the memory and the app crash after the memory is full.

Regards,
Saber

deadprogram, 2015-10-30:
What exact version of opencv are you using? Also which version of Windows?

sgilani, 2015-10-30:
Hi,

i tryed 2.4.2 , 2.4.9 , 2.4.10 and 3.0 with gobot 0.8.2 and 0.10 in differnt combination, all with the same result.

Tryed on Windows 8.1 32bit and 64bit and also on Windows 10 32bit and 64bit all with the same result, i would like to try on Windows 7 but i have no active install anymore.

deadprogram, 2015-10-30:
OK, so if I get it working correctly with any of those versions, sounds like we should be good. I'll get my Windows 8.1 VM unpacked.

sgilani, 2015-10-30:
Ohh yes please when you got it working, share with me your setup details so i can get it working with gobot. :) Thanks

deadprogram, 2017-10-23:
The previous OpenCV implementation in Gobot has now been replaced by GoCV (https://gocv.io) in this release https://github.com/hybridgroup/gobot/releases/tag/v1.7.0

I am going to close this issue, please reopen if needed.

Closed 2017-10-23.

Thread 241 (2015-10-29):

Reading from Arduino analog pin A5

fjukstad, 2015-10-29:
Hey,

I'm trying to read some input on analog pin A5 from an Arduino Uno, but it fails with a `index out of bounds` at `github.com/hybridgroup/gobot/platforms/firmata/firmata_adaptor.go:206`. This is how I get things going:

```
gbot := gobot.NewGobot()
firmataAdaptor := firmata.NewFirmataAdaptor("firmata", "/dev/cu.wchusbserial1420")
sensor := gpio.NewAnalogSensorDriver(firmataAdaptor, "sensor", "5")
work := func() {
        gobot.On(sensor.Event("data"), func(data interface{}) {
            fmt.Println(data)
        })
}
robot := gobot.NewRobot("myrobot",
        []gobot.Connection{firmataAdaptor},
        []gobot.Device{sensor},
        work,
    )
gbot.AddRobot(robot)
gbot.Start()
```

Any idea of what might be wrong? It works fine to read analog input from pin A0 and A1.

Cheers!

sgilani, 2015-10-30:
You are using firmata and A4 & A5 is by default for I2C, open the StandardFirmata.ino and disable I2C, then all must be fine i think.

deadprogram, 2015-10-31:
Sounds like this could use to be in the README for the Firmata platform.

deadprogram, 2016-12-23:
This is now part of the docs for the Firmata platform https://github.com/hybridgroup/gobot/tree/master/platforms/firmata#how-to-use

Thanks everyone!

Closed 2016-12-23.

Thread 244 (2015-11-07):

Fill Out Bebop Events, GPS Support?

cathalgarvey, 2015-11-07:
Hi folks,

Gobot support figured highly in my purchasing decision to get a Bebop, and I'm having fun already getting to know Gobot and imagining ways to paste my Bebop to Arduino or microcomputer hacks.

Looking through the Bebop code in Gobot versus other frameworks, including some by HybridGroup, I see that it doesn't have much support yet for onboard events? For example, the "flying" event is fired by Gobot presumptively after sending the TakeOff instruction, whereas it seems (from perusal of the...difficult...official API documentation) that the device itself issues events when its state changes from "Taking off" to "Hovering" to "Flying" to "Landing" to "Emergency".

Likewise, the official API makes it very difficult to understand, but I gather the device either regularly, or on request, issues sensor updates including GPS, accelerometer, etcetera. GPS in particular would be *very* valuable, because it would allow one to write homing code to help the device navigate through flight-paths.

I would happily help contribute these features, if there were somewhere to go learn about the low-level Bebop API that Gobot is reimplementing. Which of the defined magic Bytes are commands sent *to* the drone, and which are tokens designating what kind of data is being received *from* the drone? How does one write code to issue an instruction including arguments, and how does one receive and post (all?) events to the Gobot event handler? If I could get this kind of information I'd happily run off and try to implement this stuff myself, but the official API is very oddly laid out and the documentation stops short of anything but the basics, much less GPS.

Thanks again for Gobot, looking forward to helping or at least making use of it. :)

cathalgarvey, 2015-11-08:
Just documenting my learning process as I tease apart the code..

In [bebop's client](https://github.com/hybridgroup/gobot/blob/dev/platforms/bebop/client/client.go), UDP messages seem to be received by the goroutine on line *273*, and are passed to the `Bebop.packetReceiver([]byte)` method, which at present appears to only decide what, if any, ACKs to send.

If I'm not mistaken then, this is the appropriate place to put code that decodes the data returned by the device, looking for telemetry data and state changes?

For a more specific guidance-question then, is there any readable documentation on how incoming packets are structured, how to parse and identify them relative to one another, and how the payload data is structured (besides its being Little-Endian..)? Will keep digging.

If I figure this out and can parse packets, I can start doing something with them.. what's the `Gobot`-way to handle streams of incoming events like this? I imagine registering more event handlers (currently only "flying") is a good place to start, and then just start pushing them to the global event queue?

deadprogram, 2015-11-08:
Hi, @cathalgarvey

Totally love what you are doing here.

So yes, you are exactly correct about `packetReceiver`.

This is how we did the same thing in node-bebop https://github.com/hybridgroup/node-bebop/blob/master/lib/bebop.js#L198

If you implemented the same equivalent in Gobot as we have done there in Node.js, it would be an amazing step forward.

The best docs I've found on the Bebop protocol are thanks to @robotika located here:

https://github.com/robotika/katarina/blob/master/bebop-protocol.md

cathalgarvey, 2015-11-08:
Fantastic, thanks; I'll go read up. :)

cathalgarvey, 2015-11-08:
By way of documentation and to invite comment early: I'm in the process of writing something I hope will suffice. Rough outline of where I'm going with this so far:

* Adding a method to the Bebop client: `Telemetry() chan struct{Title string, Data []byte}` (I don't know if re-using anon structs between packages in this way is kosher, I'll find out when it fails to compile). This returns a 10-buffered channel that telemetry events are sent back on. All non-video Bebop frames received are sent; if they aren't handled specifically, they are sent as "unknown". Telemetry data is parsed if it's understood, but is still returned as a `[]byte`. So, a uint32 decoded to an expected byte between 1 and 8 is cast to a single byte and sent back. This is probably the wrong way to do things.
* Setting up a goroutine in the Bebop driver to pull from this channel and post global events in the usual way. This happens in the drivers' "start" method.
* Trying to cleanly shut down this telemetry system when the driver's "stop" method is called. Likewise the client's "Stop" method closes a channel to let all existing goroutines waiting on Telemetry stop.

Has anyone got a handy reference of the heirarchy of constants? I.e. which Classes belong to which Types/Projects, and which Ids belong to which Classes? Assuming they are heirarchical, which is perhaps not a reasonable assumption, but it *is* based on an XML template..

cathalgarvey, 2015-11-08:
Finally getting the hang of reading the XML code, thanks to having @robotika's [code to compare against](https://github.com/robotika/katarina/blob/master/navdata.py) and learn from.

Have some [raw, untested, incomplete code committed to my repo](https://github.com/hybridgroup/gobot/compare/dev...cathalgarvey:dev), will spend some time tomorrow adding more.

Looking forward to testing this. If even the GPS works, I'll be happy; killer feature, right there. :)

cathalgarvey, 2015-11-08:
Oh yea, and I changed things so the events are emitting JSON, which is slightly more sane than emitting parsed-then-re-dumped binary. Not ideal, but compatible with the way things are done in gobot already and somewhat intuitive provided the keys in the JSON correspond to Bebop API parameters (which I've tried to hew to).

deadprogram, 2015-11-08:
Seems like you are making some great progress!

Please let me know anything I can do to help out.

cathalgarvey, 2015-11-09:
OK, I've pushed to my own repo some incomplete additions that have partial telemetry support. It appears to be working on my Bebop *while it rests on the table*, and when it encounters events it can't yet handle it posts "unknown" event with a useful message.

There's a new example file: `platforms/bebop/client/examples/telemetry.go` (which properly ought to live a directory down as technically it's using the Driver, not the Client). This connects to the 'bot, issues no instructions, and just prints all incoming events that aren't too spammy to handle.

Observation: there are only two "commandProject" values expected according to the XML layouts and other reference code, but according to this it's picking up an incrementing set of commandProjects that rise to 255 and roll over. This likely indicates something nasty going on in the frame handling code. It doesn't stop the spammier events (camerastate!) from getting through though, so actual data frames appear unaffected?

I'm not confident that this won't blow up a drone yet so I'm not issuing a PR, but would love thoughts if you have time. Or, if you feel like risking a bot and have space to test (which I lack right now), a flight test! :)

cathalgarvey, 2015-11-11:
OK, good news: I tracked down and killed a bunch of bugs, implemented an incomplete but acceptable set of telemetry class handlers, and tested on my drone in live flight, and I've got telemetry working. :)

There's a lot of it: It spams a load of information about attitude/altitude/gps, though GPS is either broken or simply returns dummy values (500,500,500) in indoor mode. Altitude only reports greater than nil in flight. Attitude appears to work even when inactive.

I don't suggest a pull yet, and am not issuing a PR, because the Land() method seems not to be working anymore, which is odd because I don't recall touching it! When I get that working I'll issue a PR?

Before I do, if you have a chance to check out the coding arrangement I've got going it might avoid questions later.

Basic strategy: Dataframes go to a dispatcher, which looks up commandProject in a map, then looks up commandClass in the returned sub-map, and issues the frame to the handler. Handlers mostly use a switch to pick the right code by commandId, and dispatch, passing back (found bool, commandName string, err error) for error messaging context. Dispatching of all telemetry is done in its own goroutine but when it comes to messaging to the global cue it happens through a 10-length channel, discarding overflow, so if the telemetry channel isn't read the messages (and goroutines) are discarded.

The incoming telemetry is pulled by a goroutine that's spun up at Bebop starttime and posted to the Gobot event cue, though the event names could do with an overhaul to namespace them and make them clearer.

Hope you like it! :)

deadprogram, 2016-02-17:
Hi, @cathalgarvey just wondering if you were still up for submitting a PR for your changes for Bebop?

In the interim, we've got the "full API" supported now in https://github.com/hybridgroup/node-bebop thanks to work from @johan-olsson that might be helpful to look at.

cathalgarvey, 2016-02-17:
Yes, absolutely; they should still be considered "beta grade" though, I
haven't flown the Bebop much yet and certainly haven't been controlling
it much from the computer, either (life's been busy..). Here be dragons
and flying death machines of another sort, etcetera.

I'll give it a code review later and check my stale notes to be sure
nothing glaring is yet to be finished, finally check if it's OK with the
master branch as-is, then issue a PR.

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

deadprogram, 2016-02-17:
Sounds great, thanks @cathalgarvey

cathalgarvey, 2016-02-17:
Right.. I've done some cleanup, and some re-org, currently incomplete. I haven't tested the code as-is on my bebop, so I'm not comfortable PRing yet. But, you're welcome to give it a look over, if you like!

deadprogram, 2016-12-27:
Hi @cathalgarvey I was just checking out your branch with the Bebop changes, and there are a bunch of interesting ideas and useful-looking code there. Thanks again for having worked on that.

Of course is way out of date with the massive refactors that have happened with Gobot 1.0. Sorry about that. You might not be doing anything with Bebop these days, but I'd love to figure out how to get some of this back into the mainline Gobot, if possible. Or at least incorporate some of it. Any thoughts?

Thread 246 (2015-11-11):

Arduino and Ultrasonic Sensor (firmata)

sgilani, 2015-11-11:
Hi,

i have now no ideas anymore, how can a get the distance from a Ultrasonic Sensor and Arduino with Gobot.

Can you give me a Tip, i am stocked here:

//----------AND NOW??--------------//
//This is the Part from a Arduino Sketch
duration = pulseIn(echoPin, HIGH)
//--------------------------------//

I have no idea how to dev. this in Go "pulseIn(echoPin, HIGH)"

package main

import (
    "fmt"
    "time"

```
"github.com/hybridgroup/gobot"
"github.com/hybridgroup/gobot/platforms/firmata"
"github.com/hybridgroup/gobot/platforms/gpio"
```

)

func main() {
    gbot := gobot.NewGobot()

```
firmataAdaptor := firmata.NewFirmataAdaptor("firmata", "COM7")
trigPin := gpio.NewDirectPinDriver(firmataAdaptor, "sensor", "11")
echoPin := gpio.NewDirectPinDriver(firmataAdaptor, "sensor", "12")
led := gpio.NewLedDriver(firmataAdaptor, "led", "13")

work := func() {

    maximumRange := 200
    minimumRange := 0

    duration := 0
    distance := 0

    gobot.Every(100*time.Millisecond, func() {

        trigPin.DigitalWrite(byte(0))
        time.Sleep(2 * time.Microsecond)

        trigPin.DigitalWrite(byte(1))
        time.Sleep(10 * time.Microsecond)

        trigPin.DigitalWrite(byte(0))

        //----------AND NOW??--------------//
        //This is the Part from Arduino Sketch
        duration = pulseIn(echoPin, HIGH)
        //--------------------------------//

        //Calculate the distance (in cm) based on the speed of sound.
        distance = duration / 58

        if distance > maximumRange || distance < minimumRange {
            /* Send a negative number to computer and Turn LED ON
            to indicate "out of range" */
            fmt.Println("-1")
            led.On()
        } else {
            /* Send the distance to the computer using Serial protocol, and
            turn LED OFF to indicate successful reading. */
            fmt.Println(distance)
            led.Off()
        }

    })

}

robot := gobot.NewRobot("makeyBot",
    []gobot.Connection{firmataAdaptor},
    []gobot.Device{trigPin, echoPin, led},
    work,
)

gbot.AddRobot(robot)

gbot.Start()
```

}

deadprogram, 2015-11-20:
Well, in that case I am closing this issue :sob:

All joking aside, I think this is a duplicate of https://github.com/hybridgroup/gobot/issues/152

Bottom line is I need to work on this!

billettc, 2016-12-21:
Here your solution ...

`package main

import (
	"gobot.io/x/gobot/platforms/raspi"
	"gobot.io/x/gobot/drivers/gpio"
	"gobot.io/x/gobot"
	"time"
	"fmt"
)

func main() {
	r := raspi.NewAdaptor()

	trigPin := gpio.NewDirectPinDriver(r, "11")
	echoPin := gpio.NewDirectPinDriver(r, "12")
	led := gpio.NewLedDriver(r, "7")

	work := func() {

		gobot.Every(1 * time.Second, func() {

			println("Starting probing ")
			led.Toggle()

			trigPin.DigitalWrite(byte(0))
			time.Sleep(2 * time.Microsecond)

			trigPin.DigitalWrite(byte(1))
			time.Sleep(10 * time.Microsecond)

			trigPin.DigitalWrite(byte(0))
			start := time.Now()
			end := time.Now()

			for {
				val, err := echoPin.DigitalRead();
				start = time.Now()

				if (err != nil) {
					println(err)
					break
				}

				if val == 0 { continue }

				break
			}

			for {
				val, err := echoPin.DigitalRead();
				end = time.Now()
				if (err != nil) {
					println(err)
					break
				}

				if val == 1 {
					continue
				}

				break
			}

			duration := end.Sub(start)
			durationAsInt64 := int64(duration)
			distance := duration.Seconds() * 34300
			distance = distance / 2 //one way travel time
			fmt.Printf("Duration : %v %v %v \n", distance, duration.Seconds(), durationAsInt64)
		})
	}

	robot := gobot.NewRobot("makeyBot",
		[]gobot.Connection{r},
		[]gobot.Device{trigPin, echoPin, led},
		work,
	)

	robot.Start()
}`

willmendil, 2020-12-28:
Have there been any updates on this mater?

gen2thomas, 2023-01-29:
An alternative sensor would be the SRF08 I2C sensor, see #327

gen2thomas, 2023-11-10:
I'm going to close this issue, because there will be no good solution for this requirement. Please see the referenced issues for better alternatives.

Closed 2023-11-10.

Thread 247 (2015-11-20):

Restrictive I2c modelization

abourget, 2015-11-20:
Hi there,

I'm trying to implement the Edison miniboard and I see that the I2cStart, I2cRead and I2cWrite functions are all attached to the Adaptor. However, the Edison miniboard has 2 I2C controllers..

The mraa exposes the different I2C controllers using an `i2c_context`.. and you can have many such contexts (or `devices`) for a given board.

Also, it's not possible for a user to select a certain I2C device, the Adaptor has its default and that's it.

Could you imagine reworking this design ?  Would such a proposition be mergeable ?

abourget, 2015-11-20:
I'm looking at many things in `mraa` that we could use.. is the goal here to have a clean rewrite of those features ? or could we imagine using `mraa` (cgo)  at some point ?

deadprogram, 2015-11-20:
You could be easily done in Gobot by extending via the needed Linux files paths to the other i2c buses in the intel-iot-/edison platform. I do not think you need to drag in all of MRAA just for that.

MRAA has the limitations of blocking, and cgo also has many limitations. The current implementation has the advantage of being pure Go.

That said, there are platforms in Gobot that use cgo wrappers, such as opencv. Nothing prevents a parallel implementation that wraps mraa and/or upm. But the pure Golang approach has many benefits.

abourget, 2015-11-20:
Yeah.. I'd want to keep pure go too.. what about adding a layer behind I2cStart / I2cRead / I2cWrite .. which would use a `DefaultI2cBus`.. and add the notion of an I2cBus .. I2cStart for all platforms that have only one would continue to work, creating a Adaptor.I2cBus .. but some adaptors could expose the different `I2cBus`es as a list or map or something..

This would keep retrocompatibility, keep the easy way like it is, but allow for adaptors with many buses.. and give you a way to pass the I2cBus around if you want..

What do you think ?

deadprogram, 2015-11-20:
That sounds like a good approach towards a first implementation to me. If you work on this, and you want feedback, submit a PR early with comment that it is Work In Progress and not ready to merge. Or just do it! :)

abourget, 2015-11-24:
I wanted to implement the LSM9DS0 first.. and see what would be needed.

You can take a look here: https://github.com/abourget/gobot/commits/master

The i2c interface isn't very slick.. but I do feel it should be more furnished.. It *is* a re-implementation
of what we have in C in the kernel or in mraa.. and I agree it's useful that it be in Go, but I think we'd need to make it a more generic solution.. perhaps that other projects could use.. but that would be more complete.

What do you think ?  Most boards use the /dev/i2c-X bus.. only the firmara doesn't use that.. I'm not sure what messages can go through there.. but it'd be neat to have a solid /dev/i2c-X interface.

I'd like to model an I2CDevice with its address (and keep Go conventions of caps for acronyms), an `I2CBus` to represent `/dev/ì2c-X`..  and a few read/write methods.. this would make porting libs a lot easier..  Also, it'd be nice to be able to decouple the Adaptor from an I2CBus.. and perhaps get a DefaultI2CBus() on the Adaptor .. or embed it, so the Adaptor is also an I2CBus (with a default bus?)

there.. my 2 cents and a half ! good night

ryanhatfield, 2016-02-18:
If there's no objections, I'll likely take a crack at this in the next week or so.

My plan is to convert the [i2cStarter.i2cStart](https://github.com/hybridgroup/gobot/blob/dev/platforms/i2c/i2c.go#L24) method to accept a params object, something like below:

```go
type i2cParams struct {
  // Address would help retain existing functionality
  Address int
  // BusID would default to existing behavior in platforms with multiple i2c bus
  //   but be configurable now for platforms like the Intel Edison that have multiple i2c bus available
  BusID int
}
```

I need to be able to use the `/dev/i2c-2` bus instead of the `/dev/i2c-6` bus that's currently hard coded. What's the best way to do this, so I can have it pulled back into the main repo? :smile:

@deadprogram or @abourget thoughts?

deadprogram, 2016-02-18:
The only possible problem would be with breaking compatibility with other platforms. Since we're really only talking about 1 more optional param, perhaps a variadic param would be a better idea.

abourget, 2016-02-19:
Didn't I push any proposal ? I remember working on this quite a bit.. maybe
it's only in my fork..

Le jeu. 18 févr. 2016 12:50, Ron Evans <notifications@github.com> a écrit :

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

deadprogram, 2016-02-19:
Looks like you really did make progress on this, @abourget sorry I did not look into it sooner. @ryanhatfield this does appear to solve some of your needs, although I think you have a good idea in making the code modular to support multitudes of different breakout boards.

How can we put this all together into something coherent with the latest dev branch? Seems to me there is some good work here, we just need to put it all together.

deadprogram, 2016-02-27:
Hi, @abourget & @ryanhatfield anything I can do to help unify your respective work? :busts_in_silhouette:

deadprogram, 2016-10-07:
As mentioned here https://github.com/hybridgroup/gobot/issues/317#issuecomment-252161858 after the current refactoring effort merges, I'll *also* be turning my attentions back to this issue. Likewise, if there has been any progress, or further ideas, please share. Thanks everyone!

Hadlock, 2016-10-22:
Merging in lsm9ds0 would be fantastic, currently using @abourget 's fork for my project due to support for this device

deadprogram, 2016-12-23:
Now that version 1.0 is out, I'd like to help out further with this effort.

erkkah, 2017-01-19:
I spent a little time on this, since I needed to get better control of i2c when working on drivers for the Adafruit TSL2561 and DRV2605L lux meter and haptic controller.

I incorporated some of the changes from @abourget to sysfs/i2c_device.go and added a layer in drivers/i2c/i2c.go to use multiple buses.

I kept the old interface in parallel, but an added bonus is that the new interface is leaner on each adaptor as well.

https://github.com/erkkah/gobot/commits/better-i2c

deadprogram, 2017-02-08:
The code from https://github.com/hybridgroup/gobot/pull/364 is now in the `dev` branch. I'd love to hear any feedback from anyone about it.

Next step will be another set of changes intended to expose to developer the ability to specify exactly which bus to use for a particular i2c device.

deadprogram, 2017-02-16:
All of the work I referred to has now been released as part of v1.2.0 thanks again everyone!

Closed 2017-02-16.

Thread 248 (2015-12-15):

Gobot spawns thousands of goroutines causing it to crash everytime

osiloke, 2015-12-15:
Not sure why robot spawns that many threads (assuming, multiple goroutines are running), but it seems to be spawning threads exponentially. I'm using the current master, connecting to an arduino  uno and just blinking the led (based on the example). It spans over 2150 grooviness. That seems a bit too weird. Any suggestions would be great, i'm also taking a look at gobots source.
```
func setupArduino() *gobot.Robot {
	//Arduino bot
	device := findArduino()
	arduino := firmata.NewFirmataAdaptor("arduino", device)
  statusLed := gpio.NewLedDriver(arduino, "led", "13")

	work := func() {
    gobot.Every(1*time.Second, func() {
      statusLed.Toggle()
    })
  }

  return gobot.NewRobot("arduinoExpansion",
    []gobot.Connection{arduino},
		[]gobot.Device{statusLed},
    work,
  )
}
func main() {
  gbot := gobot.NewGobot()
  gbot.AddRobot(setupArduino())

  gbot.Start()
}
```

osiloke, 2015-12-15:
reinstalled gobot, and it stopped spawning infinite goroutines. I must not have been using the latest master. Although, i now notice that a signal interrupt (ctrl+c) does not shut it down

trevrosen, 2015-12-15:
@osiloke have a look at the commits referenced in #216 and you should have a sense of how to get the behavior you're looking for. Thanks for using Gobot!

Closed 2015-12-15.

Thread 250 (2015-12-29):

LED pin 18 not blinking with raspb

TheInsideMan, 2015-12-29:
Hello, Im trying to get a LED on pin 18 to flash with a raspberry pi 2 with the following code... any help appreciated...

error: Starting work... open /sys/class/gpio/gpio24/direction: permission denied
```
gbot := gobot.NewGobot()
r := raspi.NewRaspiAdaptor("raspi")
led := gpio.NewLedDriver(r, "led", "18")

work := func() {
   gobot.Every(1*time.Second, func() {
      err := led.Toggle()
      if err != nil {
	      fmt.Println(err.Error())
      }
   })
}

robot := gobot.NewRobot("blinkBot",
   []gobot.Connection{r},
   []gobot.Device{led},
   work,
)

gbot.AddRobot(robot)
gbot.Start()
```

I've got pi-blaster deamon running.

Im able to get the LED flashing using python so I know it isnt a hardware issue.
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

TheInsideMan, 2015-12-29:
I tried to run $ sudo ./aambr

This does stop the error printing but still no flashing LED :(

deadprogram, 2015-12-29:
Hi, @TheInsideMan thank you for the photo. Looks to me line you are plugged into pin labeled on board number 12, which maps to Linux BCM18. When programming using Gobot, you just use whatever the board is labelled, and we do the mapping for you, so you code should be using "12" for the pin number. We probably need to make a bigger deal of explaining this on every platform.

TheInsideMan, 2015-12-30:
thank you @deadprogram thats working now! much appreciated. Let take the opportunity to thank you fro you work on Gobot.

Depado, 2016-03-28:
Hi, yes that sure needs some explanation !
I had the exact same issue as you @TheInsideMan, thanks a lot for the clarification @deadprogram :D
(When I say, exact same issue, we have the exact same setup and approximately quite the same code haha)

gherlein, 2017-06-25:
Probably need some error handling if you call gpio.NewLedDriver with a pin that is not a GPIO pin...

nilskuhn, 2018-01-12:
Where do you see labels on the raspberry gpio pins?
I'm using version 2 B of the pi.

deadprogram, 2018-01-12:
I highly recommend https://pinout.xyz/

nilskuhn, 2018-01-12:
thx, I already found it in the meanwhile

Closed 2015-12-30.

Thread 255 (2016-01-19):

Support for Chip

hrishikesh195, 2016-01-19:
I was wondering if anybody is planning to add support for the new $9 single-board computer C.H.I.P. (http://www.getchip.com/). If not, I'd be happy to start working on that. I don't have any I2C or PWM devices right now to test any code for that but I can submit a pull request for basic GPIO digital read/write functionality to get the ball rolling.

deadprogram, 2016-01-19:
I'd love to see this. I have a couple of them, but have not had a chance to really dig into cross-compiling golang for it yet.

hrishikesh195, 2016-01-31:
I have coded up the support for GPIO and I2C for the CHIP. The GPIO (digital read/write) seems to be working fine but I'm having trouble with I2C. The device I'm using is a Wii Nunchuk. When I start the code the following error floods the screen -

```
2016/01/31 22:15:53 Event does not exist
2016/01/31 22:15:53 Event does not exist
2016/01/31 22:15:53 Event does not exist
2016/01/31 22:15:53 Event does not exist
2016/01/31 22:15:53 Event does not exist
...
...
```

To see if this was something specific to the CHIP, I tried to run it on a Raspberry Pi but the same thing happened. Here's the raspi example code -

```go
package main

import (
	"fmt"

	"github.com/hybridgroup/gobot"
	"github.com/hybridgroup/gobot/platforms/i2c"
	"github.com/hybridgroup/gobot/platforms/raspi"
)

func main() {
	gbot := gobot.NewGobot()

	raspiAdaptor := raspi.NewRaspiAdaptor("raspi")
	wiichuck := i2c.NewWiichuckDriver(raspiAdaptor, "wiichuck")

	work := func() {
		gobot.On(wiichuck.Event("joystick"), func(data interface{}) {
			fmt.Println("joystick", data)
		})

		gobot.On(wiichuck.Event("c"), func(data interface{}) {
			fmt.Println("c")
		})

		gobot.On(wiichuck.Event("z"), func(data interface{}) {
			fmt.Println("z")
		})
	}

	robot := gobot.NewRobot("chuck",
		[]gobot.Connection{raspiAdaptor},
		[]gobot.Device{wiichuck},
		work,
	)

	gbot.AddRobot(robot)

	gbot.Start()
}
```

Using the command line tools (i2cset and i2cdump) I'm able to read bytes off of the nunchuk on both the CHIP and the Pi -

```
# i2cset -y 0 0x52 0x40 0x00
# i2cset -y 0 0x52 0x00
# i2cdump -y -r 0-5 0 0x52 c
     0  1  2  3  4  5  6  7  8  9  a  b  c  d  e  f    0123456789abcdef
00: 7e 70 8e 4b 73 7b                                  ~p?Ks{
```

Are there any known issues with the Wii Nunchuk code in gobot? I'm using the code from the latest `dev` branch.

deadprogram, 2016-02-01:
Hi, @hrishikesh195 I have not been using my wiichuck for so long, it is certainly possible there is some problem with the Gobot driver. Do you have any other i2c devices to test with? Perhaps you can submit a preliminary PR, and I can setup my CHIP to test with.

hrishikesh195, 2016-02-01:
Unfortunately I don't have any other I2C device right now. I have submitted a PR. It would be great if you could test it with some other I2C device. Thanks.

deadprogram, 2016-02-03:
Hi, @hrishikesh195 took a little longer to test things, but I was able to use my GroveLCD https://vine.co/v/iJ6VwDqB737

Seems like we need to open a separate issue on the wiichuck. In the meantime, I am merging this, thank you!

hrishikesh195, 2016-02-05:
Great! Thanks.

I looked into the wiichuck problem a little bit more. Let me open a new issue and add my findings there.

Also, I had tried the forums to get more details on PWM (here's the [post](https://bbs.nextthing.co/t/chip-pwm-output/1474/9?u=hrishikesh195)) but didn't have much luck there. Let me see if directly emailing them helps.

deadprogram, 2016-02-05:
There is a Node.js module from @sandeepmistry that looks like it may have run into the same blocker. I added a GH issue on that repo, just so we can all share info on implementation. https://github.com/sandeepmistry/node-chip-io/issues/1

deadprogram, 2016-02-18:
This was released, closing. Thanks again @hrishikesh195

Closed 2016-02-18.

Thread 256 (2016-01-27):

Stepper motor

SellJamHere, 2016-01-27:
Does the current roadmap include support for stepper motors? If not, I'll take a crack at implementing it.

deadprogram, 2016-01-28:
Hi, @SellJamHere we'd love your PR adding support for steppers. Please and thank you!

deadprogram, 2016-02-27:
Hi, @SellJamHere ever have a chance to work on this? :) We'd still love your PR, if you have.

npotts, 2016-07-29:
So Im giving this a shot.  Before I start getting buried in details and state charts - A few questions:
  - Should there be a "platforms/motors" category or just cram everything in "platforms/gpio"?
  - In order to fulfill the gobot.Driver interface, Ill need to implement the gobot.Connection interface.  Do you have any other places where multiple pins are marshaled into a single robot.Connection (eg i2c, spi, etc) so I can see what would be a reasonable approach?

deadprogram, 2016-07-29:
Hi, @npotts

A couple answers:

- Probably should go into GPIO, since that is the required interface to be able to support s stepper motor controller.
- The RGB Led is the closest one to what you are doing, I think. Check it out here: https://github.com/hybridgroup/gobot/blob/dev/platforms/gpio/rgb_led_driver.go

Thank you!

npotts, 2016-07-30:
Hey @deadprogram

Im not ready for a pull request as Ive got to mock this mess up and actually make some motors move, but Ive stubbed out the logic [on my fork](https://github.com/npotts/gobot/blob/dev/platforms/gpio).  My question is more asking if [this](https://github.com/npotts/gobot/blob/dev/platforms/gpio/unipolar-stepper.go) the right idea?  Ive never used a stepper in "go" mode, but always in more of a "step 230 times to the left" fashion.

Ravenwater, 2016-08-25:
Is there appetite to design a proper abstraction for the concept of motor control so that both stepper as well as DC+Encoder solutions can be used to accomplish motion control? The higher level abstractions would be valuable for simplifying/unifying GN&C solutions, so it would be good to build this into the overall structure of Gobot. As motion control requires the geometry of the drive configuration this is a non-trivial task. Hierarchical GN&C can be used to subsystem the motion control so that you can used closed loop motor control algorithms to approximate positioning.

From a system design point of view the idea that stepper motors are like LEDs is not helping the architecture of the software.

deadprogram, 2016-08-26:
Well, these are really 2 different activities (simple motor control vs. coordinated steppers).

For sure, some higher level abstraction around stepper motor control would be very useful. For example, something that would allow for an "easy" inverse kinematics API.

deadprogram, 2017-03-24:
Hello, all. I'm getting ready to devote some attention again to this subject. I will likely implement the simplest possible 4-pin stepper based on the ULN200XA first, and then look at any abstractions on top of it.

Any thoughts on this from anyone here?

coding-yogi, 2017-11-29:
any updates on this? If not, I would like to contribute as well

deadprogram, 2017-11-29:
Hi @coding-yogi I have not had tome to work on this. However, I think that perhaps someone has done so in a fork? In any case, we'd love to have a contribution!

coding-yogi, 2017-11-29:
I am planning to replicate [this](https://github.com/mikedamage/wpi-stepper/blob/master/es6/lib/stepper.js)

deadprogram, 2017-11-29:
That looks good to me!

coding-yogi, 2017-12-02:
@deadprogram , please check [this](https://github.com/coding-yogi/gobot/commit/0fa30aeb62b6b777d70df00c03b367f76f44bed6). Works fine for me

deadprogram, 2017-12-02:
That looks great to me, @coding-yogi

Please submit a PR at your convenience, and thank you!

deadprogram, 2017-12-02:
The new stepper created by @coding-yogi is now in the `dev` branch. Please check it out, everyone.

I will close this issue once the code makes it into the next release.

deadprogram, 2017-12-21:
Stepper motor driver was included in v1.8.0 so I am now closing this issue. Please reopen if needed, and thank you to everyone especially @coding-yogi for the PR.

Closed 2017-12-21.

Thread 258 (2016-02-01):

1wire protocol

pbdeuchler, 2016-02-01:
I'm currently trying to use a DS18B20 temperature sensor with an arduino and gobot but I can't find any golang implementations of the 1wire protocol. Has anyone used one of these sensors in go? If not does anyone know where the protocol is documented so I can implement it in go?

pbdeuchler, 2016-02-01:
FYI there is support with [arduino configurable firmata](https://github.com/firmata/ConfigurableFirmata/blob/master/src/OneWireFirmata.cpp), if that would be easier to write a go shim for

ryanhatfield, 2016-02-18:
As I remember, the 1 wire protocol is fairly slow and easy to implement if you can time things right.

Here's the [wiki article about the 1 wire protocol](https://en.wikipedia.org/wiki/1-Wire), and they explain the timing structure there if you wanted to implement it in go.

Also, here's a [1 wire protocol for RaspberryPi](https://github.com/aqua/raspberrypi) written in go, and looks simple enough.

deadprogram, 2016-02-18:
Hi, @ryanhatfield thanks for those links... I'll dig in soon.

pbdeuchler, 2016-02-18:
Seconded on the thanks @ryanhatfield... I might implement this as well @deadprogram since I'm currently in need of it for a project. Just glad I don't have to reverse engineer the arduino library.

pbdeuchler, 2016-02-18:
On a quick inspection it looks like that go library is just using the official driver to read/write from a device file, which we won't have the luxury of doing since AFAIK gobot requires direct control due to the different platforms

deadprogram, 2016-02-18:
The solution to that in Gobot, is to define an interface for 1Wire, and then adaptors for different platforms can implement that interface in their own way. For Raspi & other Linux systems probably using driver, for Arduino targeting ConfigurableFirmata, etc.

gen2thomas, 2025-02-16:
fixed in v2.5.0

Closed 2025-02-16.

Thread 259 (2016-02-05):

Wiichuck driver doesn't work with the sysfs i2cDevice

hrishikesh195, 2016-02-05:
When using the Wiichuck driver with a Raspberry Pi or C.H.I.P. (through the sysfs i2cDevice implementation), the following error floods the screen -

```
2016/01/31 22:15:53 Event does not exist
2016/01/31 22:15:53 Event does not exist
...
...
```

Some findings -

There are 2 parts to this problem - a) what is the event that's triggering the specific "event does not exist" error? b) why is that event getting generated?

a) The Wiichuck driver only adds the C, Z and Joystick events, but not the Error event. In `wiichuck_driver.go` -

```go
	w.AddEvent(Z)
	w.AddEvent(C)
	w.AddEvent(Joystick)
	return w
```

So whenever any kind of error is encountered (eg in I2cRead()) the above message gets generated. The fix for that is trivial. Just add `w.AddEvent(Error)` before returning.

b) The i2cDevice code in `sysfs/i2c_device.go` uses the I2C_SMBUS block transfer mode. It appears that the Wii nunchuk doesn't support it -

```
# i2cdump -y 0 0x52 s
Error: Adapter does not have SMBus block read capability
```

The thing to note here is that this only affects I2cRead() for the wiichuck. Although I2cWrite is also called, it is only called for writing 1 or 2 bytes and for those lengths, the code doesn't do I2C_SMBUS but instead writes directly on the file descriptor -

```go
func (d *i2cDevice) Write(b []byte) (n int, err error) {
	if len(b) <= 2 {
		return d.file.Write(b)
	}
...
```

Looking at the relevant i2c header file in linux kernel source (http://lxr.free-electrons.com/source/include/uapi/linux/i2c-dev.h#L47) it appears that there is an ioctl command to get the functionality (I2C_FUNCS). So a possible way to fix this would be to first query the [functionality supported](http://lxr.free-electrons.com/source/include/uapi/linux/i2c.h#L83) by the specific adapter and then pick an appropriate transfer mode.

hrishikesh195, 2016-02-06:
It turns out that the ioctl for I2C_FUNCS doesn't take in any argument identifying the specific device address. So the available I2C functionality depends on the hardware and not the device being used. I wrote a little [C program](http://pastebin.com/pzx78BwQ) to get the functionality available on a Raspberry Pi.

The mask turns out to be `0xeff0009`, which includes the following -

```
#define I2C_FUNC_I2C            0x00000001                                                                                                                                                                                 
#define I2C_FUNC_SMBUS_PEC      0x00000008                                                                                                                                                                                 
#define I2C_FUNC_SMBUS_QUICK        0x00010000                                                                                                                                                                             
#define I2C_FUNC_SMBUS_READ_BYTE    0x00020000                                                                                                                                                                             
#define I2C_FUNC_SMBUS_WRITE_BYTE   0x00040000                                                                                                                                                                             
#define I2C_FUNC_SMBUS_READ_BYTE_DATA   0x00080000                                                                                                                                                                         
#define I2C_FUNC_SMBUS_WRITE_BYTE_DATA  0x00100000                                                                                                                                                                         
#define I2C_FUNC_SMBUS_READ_WORD_DATA   0x00200000                                                                                                                                                                         
#define I2C_FUNC_SMBUS_WRITE_WORD_DATA  0x00400000                                                                                                                                                                         
#define I2C_FUNC_SMBUS_PROC_CALL    0x00800000                                                                                                                                                                                                                                                                                                                                                              
#define I2C_FUNC_SMBUS_WRITE_BLOCK_DATA 0x02000000                                                                                                                                                                         
#define I2C_FUNC_SMBUS_READ_I2C_BLOCK   0x04000000 /* I2C-like block xfer  */                                                                                                                                              
#define I2C_FUNC_SMBUS_WRITE_I2C_BLOCK  0x08000000 /* w/ 1-byte reg. addr. */
```

Notably absent is -

```
#define I2C_FUNC_SMBUS_READ_BLOCK_DATA  0x01000000
```

On a CHIP, the mask is 0xeff000b (for `/dev/i2c-1`); I2C_FUNC_SMBUS_READ_BLOCK_DATA is absent there as well.

I ran an experiment to read and write using basic read/write syscalls on the file descriptor and it seems to be pretty reliable. Here's the C code to do that on the Raspberry Pi -

```C
#include <sys/ioctl.h>
#include <sys/types.h>
#include <sys/stat.h>
#include <linux/i2c-dev.h>
#include <stdio.h>
#include <stdlib.h>
#include <fcntl.h>
#include <errno.h>
#include <string.h>
#include <unistd.h>

#define WII_ADDR 0x52

int main()
{
        int i, fd;
        char init_seq[] = {0x40, 0x00};
        char reset_seq[] = {0x00};
        char buf[6];
        bzero(buf, sizeof(buf));

        if ((fd = open("/dev/i2c-0", O_RDWR)) < 0) {
                fprintf(stderr, "open failed: %s\n", strerror(errno));
                exit(1);
        }
        if (ioctl(fd, I2C_SLAVE, WII_ADDR) < 0) {
                fprintf(stderr, "ioctl failed: %s\n", strerror(errno));
                exit(1);
        }
        if (write(fd, init_seq, sizeof(init_seq)) < 0) {
                fprintf(stderr, "write init sequence failed: %s\n", strerror(errno));
                exit(1);
        }
        usleep(10000);  // let the wiichuck recover
        if (write(fd, reset_seq, sizeof(reset_seq)) < 0) {
                fprintf(stderr, "write reset sequence failed: %s\n", strerror(errno));
                exit(1);
        }
        usleep(10000);  // let the wiichuck recover
        if (read(fd, buf, sizeof(buf)) < sizeof(buf)) {
                fprintf(stderr, "read failed: %s\n", strerror(errno));
                exit(1);
        }

        printf("Wiichuck data: ");
        for (i = 0; i < sizeof(buf); i++) {
                printf("%x ", buf[i]);
        }
        printf("\n");
        return 0;
}
```

Example run -

```
$ gcc -Wall basic_io.c && ./a.out
Wiichuck data: 70 71 81 7f 69 3
```

So we can fix this by either always doing direct read/write calls to the file descriptor like in the code above, or by querying for functionality first and falling back to the above method if SMBus block read/write is not available. What do you think @deadprogram ?

hrishikesh195, 2016-02-07:
Resolved by commit 4fdcb6e71850458134aec567c1507a6ba649283e. Closing the issue.

Closed 2016-02-07.

Thread 262 (2016-02-18):

Errors on Intel Edison, Sans-Arduino

ryanhatfield, 2016-02-18:
I have an Intel Edison without the Arduino Development board, and the [edison_adapter](https://github.com/hybridgroup/gobot/blob/dev/platforms/intel-iot/edison/edison_adaptor.go#L199) is looking for pins that don't exist.

According to this [Guide on Multiplexing](http://www.emutexlabs.com/project/215-intel-edison-gpio-pin-multiplexing-guide) with the Intel Edison, some of the pins with hard references in code won't exist if you're using the Intel Edison without the pin expanders.

Removing any [GPIO Pins larger than 200](https://github.com/hybridgroup/gobot/blob/dev/platforms/intel-iot/edison/edison_adaptor_test.go#L64) should help show what would happen if those pins are missing, and any pins over 200 are added by the i2c port expander. (as I understand it).

I'll be working to remove the pins that are causing issues right now, but is there any larger issues I'll run into with these pins being unavailable?

deadprogram, 2016-02-18:
Hi, @ryanhatfield thanks for pointing this out, you are correct that the current implementation makes some assumptions about the Arduino-compatible breakout board being present.

Are you using the mini-breakout board, the Sparkfun board, or something else entirely?

One possible solution that comes to mind, is pulling out the shared Edison muxing functions into a separate file, and then creating new adaptors for each of the specific breakout boards.

What do you think?

ryanhatfield, 2016-02-18:
I think having the _Arduino_ section as it's own _Platform_ or device would be another way to solve this. I would think since the i2c expansion is being added, a "i2c port expander" device could be added, and the edison arduino might have a platform specific version to handle the unique way it gets added?

I have the mini-breakout board, the Sparkfun Edison blocks, and a fully custom board at my disposal, so pure abstraction of the Intel Edison's base functionality is a requirement for me.

Also, I do a certain amount of Kernel configuration for some pins / registers, I will likely look into a way of dynamically or statically defining the pin mappings (if different than default) and that could also facilitate the additional pins available on the Arduino variant.

ryanhatfield, 2016-02-18:
Also, with the speed I'm moving at with some of these things, I might not take the time to back port functionality into all platforms right away. I might just keep a branch open on my fork to hold these modifications and when someone (possibly me) has time, they can be fully integrated or modified to be pulled back upstream.

deadprogram, 2016-02-18:
I also have mini-breakout board + Sparkfun blocks, so I can help as well, as far as either covering, or at least documenting any gaps. This sounds great!

devfubar, 2016-10-06:
Is there any update on this?  I just ran into exactly this issue.....

deadprogram, 2016-10-07:
As mentioned here https://github.com/hybridgroup/gobot/issues/317#issuecomment-252161858 after the current refactoring effort merges, I'll be turning my attentions back to this. If there has been any progress, or further ideas, please do tell. Thanks!

devfubar, 2016-10-07:
Thanks, was just interested to see if this was still on the agenda since the last comment was a while ago.

I'm under a bit of time pressure for my project to create a POC.  I really want to use gobot so is there anything I can do as a work around?  I have tried commenting out the offending parts such as [this section](https://github.com/hybridgroup/gobot/blob/5442e0bd8b0c909b552677b2790b4eddbb7e7e48/platforms/intel-iot/edison/edison_adaptor.go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) as @ryanhatfield mentioned however I suspect this has consequences as I see some weird behaviour.

deadprogram, 2016-10-07:
@devfubar which board are you using?

devfubar, 2016-10-07:
Sparkfun with GPIO block

deadprogram, 2016-10-07:
OK, I have a WIP branch here https://github.com/hybridgroup/gobot/tree/feature/edison-other-boards that I cannot test myself due to not having the HW right now. However, it might work :)

To use, you need to change the expansion board using `SetBoard()` to something other than `"arduino"` like this:

```go
board := edison.NewAdaptor()
board.SetBoard("miniboard")
```

If anyone can give this a try with a Miniboard or Sparkfun expansion board, that would be awesome!

devfubar, 2016-10-07:
Thanks @deadprogram .  I'll give it a bash and see how far I get...

deadprogram, 2016-10-21:
All of these changes have been merged into the current `dev` branch https://github.com/hybridgroup/gobot/tree/dev please take a look and try it out!

Note that there have been some other substantial changes to Gobot that will be coming soon as part of the upcoming 1.0 release that are also part of the dev branch.

devfubar, 2016-10-21:
OK, I'll probably give it a shot over the weekend.  I also want to add an Edison pinmap file and a switch [here](https://github.com/hybridgroup/gobot/blob/54d9b161417e4b329dc27070d460936be35ba444/platforms/intel-iot/edison/edison_adaptor.go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) to handle the arduino, miniboard and SparkFun GPIO block.
The reason for the new pinmap is because the miniboard one has differant labels to what people with a SparkFun would expect eg ["J19-9"](https://github.com/hybridgroup/gobot/blob/54d9b161417e4b329dc27070d460936be35ba444/platforms/intel-iot/edison/miniboard_pinmap.go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) should be just "14".

How does that sound @deadprogram ?

deadprogram, 2016-10-21:
That sounds amazing, exactly what it needs. Thanks!

deadprogram, 2016-11-01:
The `dev` branch now has all of these changes, any interested parties should please give it a try. Reopen this issue if needed, thank you very everyone who contributed to the discussion and the resulting code.

Closed 2016-11-01.

Thread 266 (2016-02-21):

Analog joystick lag

kittuov, 2016-02-21:
### How to reproduce the issue:
run example provide and move the analog stick of device very fast (Basically producing events faster than poll interval) the last state is reflected after a lag. the lag is even prominent if two sticks are used at the same time.
### Possible fix:
in ```go func (j *JoystickDriver) Start() (errs []error) ``` the goroutine can be modified as
>Note:  *this leads to yet another bug*
```go
go func() {
		for {
			event := j.poll()
			for {
				if tem:=j.poll();tem==nil{
					break
				}else {
					event = tem
				}
			}
			if event != nil {
				if err = j.handleEvent(event); err != nil {
           ...

The code above is actually gets the latest event and lets the gobot process that.
### Bug in this code:
* If two axis are moved at the same time, only one of the event is processed.
* some button events also may not be processed.

#### TODO: In case of stacked events, loop through all new events and,
1. get latest of all axis events and processes them.
2. get all of button events and process them.
3. *No idea what a hat is*

deadprogram, 2016-02-22:
This was fixed by @kittuov https://github.com/hybridgroup/gobot/commit/e84326b129610719bbad88ab3d596411b3839e7e

Closed 2016-02-22.

Thread 272 (2016-03-17):

Intel Edison read specific i2c register

allanglen, 2016-03-17:
I am writing a driver for the MPU9150 IMU.  I am attempting to read a byte from a specific register and am always getting back the value from the first register on the device.

The sysfs i2c implementation sets the command byte to 0 for all reads:
https://github.com/hybridgroup/gobot/blob/dev/sysfs/i2c_device.go#L103

Per the documentation here (https://www.kernel.org/doc/Documentation/i2c/smbus-protocol), an I2C_SMBUS_I2C_BLOCK_DATA operation uses the command byte to set the starting register for the read but that is always set to 0.

An I2C_SMBUS_READ_BYTE operation will use the register from a previous write but not I2C_SMBUS_I2C_BLOCK_DATA.

Are all drivers that currently implemented just happening to be reading from the first register or am I missing something obvious?

deadprogram, 2016-03-18:
Looks like this is an oversight that does not impact you if you are using an i2c adaptor that does not support the block data reads.

The solution is probably use the first byte of `b` as the register for that call. What do you think?

deadprogram, 2016-12-06:
Hi @allanglen looked at this with fresh eyes, and I see that the `Write()` command is doing the right thing: https://github.com/hybridgroup/gobot/blob/dev/sysfs/i2c_device.go#L128

I am going to make a similar change to `Read()`, would you be able to test this out on your hardware config?

deadprogram, 2017-01-02:
Hi @allanglen this should now be fixed in the `dev` branch.

Closed 2017-01-09.

Thread 275 (2016-04-03):

Support for new cape manager in Linux 4.x on Beaglebone Black

dsockwell, 2016-04-03:
Since the Beaglebone cape manager has been moved to kernel mainline, some parts of it have changed. The existing beaglebone GPIO driver works great on Linux 3.8 as delivered with the Wheezy images for bbb, but fails in a cryptic way on 4.x. Users might not know to downgrade in order for gobot to work.

The best documentation/example I've been able to find on the difference is at https://github.com/cdsteinkuehler/beaglebone-universal-io/blob/master/config-pin - the script branches based on the existence of a certain part of the 4.x implementation and configures pins a little differently.

I am working on my first Go project, but I may come up with a PR for 4.x kernels in the future. Someone else already more proficient with Go would probably not have much trouble making an alternate driver or putting the alternate behavior in the current one.

deadprogram, 2016-04-03:
Hi @dsockwell thanks for creating this issue. I'm still running Wheezy myself on my various BBBs, so I've not run into this yet.

dsockwell, 2016-04-03:
A big part of the difference is that the current GPIO driver calls on cape files that are not present in 4.x. It looks like individual pin configuration could be worked into the individual pin drivers as opposed to the overarching GPIO driver for the BBB, but also approximating the PWM configuration at least could go into the connect code to keep things laid out the same. This is a plug-and-play framework so i wouldn't be too upset about dictating pin configurations for the sake of keeping it uniform.

nevers, 2016-08-07:
I just upgraded to Debian Jessy and I stumbled on this very same issue. Really sad that its still broken... Is anyone still working on this? I'll try and an have a look myself too.

deadprogram, 2016-11-26:
Hi everyone. Please check out the https://github.com/hybridgroup/gobot/tree/feature/beaglebone-4 branch which should work with the latest Debian, as well as with the older kernel versions if needed.

deadprogram, 2016-11-30:
Here is a PR for any comments: https://github.com/hybridgroup/gobot/pull/342

deadprogram, 2016-12-03:
This has been merged into the `dev` branch. Thanks everyone!

Closed 2016-12-03.

Thread 276 (2016-04-14):

Add GoPiGo Support

DexterInd, 2016-04-14:
Is it possible to add GoPiGo support?  https://github.com/DexterInd/GoPiGo/tree/master/Software

deadprogram, 2016-04-15:
Hi @DexterInd I was reviewing your code/hardware. I see you have a daughterboard which is an i2c device. Seems like the slick route is to use the Gobot raspi platform and its i2c support, to create a new platform for GoPiGo. This new platform would implement an adaptor with the standard Gobot interfaces:

```
var _ gobot.Adaptor = (*GoPiGoAdaptor)(nil)

var _ gpio.DigitalReader = (*GoPiGoAdaptor)(nil)
var _ gpio.DigitalWriter = (*GoPiGoAdaptor)(nil)
var _ gpio.AnalogReader = (*GoPiGoAdaptor)(nil)
var _ gpio.PwmWriter = (*GoPiGoAdaptor)(nil)
var _ gpio.ServoWriter = (*GoPiGoAdaptor)(nil)
```

This would allow using any of the current GPIO devices.

The new GoPiGo Gobot platform would also want to additionally implement some Gobot devices specific to the GoPiGo's built-in hardware, such as the IRReceiver. These devices would ideally define their own interfaces. In the IRReceiver's case something based on `io.Reader` might be cool.

Does all this make sense?

deadprogram, 2016-05-13:
Hi @DexterInd I was looking thru my gear, and seems I was one of your Kickstarter backers, as I have one of your boards. Do please let us know anything needed to help out.

DexterInd, 2016-05-16:
Hey @deadprogram , we are going to put this on our list of projects, sorry for the slow response here.  Just need to find the time.  If anyone is interested in developing on this or working on this though, we're happy to send along a GoPiGo.

deadprogram, 2017-10-23:
GoPiGO3 support has just been released as part of https://github.com/hybridgroup/gobot/releases/tag/v1.7.0 so I am now going to close this. Thank you everyone who contributed!

Closed 2017-10-23.

Thread 277 (2016-04-14):

MQTT reconnect?

tlrobinson, 2016-04-14:
It looks like MQTT doesn't support automatic reconnection (or a way to set custom ClientOptions): https://github.com/hybridgroup/gobot/blob/dev/platforms/mqtt/mqtt_adaptor.go#L92

This seems like it would be a very useful thing. Is there a reason it's not exposed?

deadprogram, 2016-04-15:
Him @tlrobinson we for sure need a way to set all the various `ClientOptions`. A PR that added this would be very appreciated... :)

tlrobinson, 2016-04-16:
(Sorry, accidentally closed this)

Happy to submit a PR, just wanted to make sure it was desirable.

I'm guessing even if you set `AutoReconnect` to true it won't automatically re-subscribe to any topics you initially subscribed to, so you should do so in an `OnConnectHandler`. I'm new to gobot, is there an existing pattern for that sort of thing?

deadprogram, 2016-04-17:
The simplest implementation is probably:

- add a slice to the Adaptor struct to keep track of the current topics.
- in the Adaptors's `Connect()` method you can hookup the `OnConnectHandler` to a method that subscribes to all of the topics in your list.
- the Adaptor's `On` handler can add new topics to the list, and also calls `Subscribe()` if the connection is already live.
- When a connect or reconnect occurs, it will call the `OnConnectHandler` to subscribe to all the list topics

Does that sound about right to you?

tlrobinson, 2016-04-18:
That makes sense, and would be really nice to use in a lot of cases. I went ahead and implemented this and it seems to work well.

However, in my case I need to ignore the first message my MQTT server sends when I subscribe, so if we transparently re-subscribe I won't be able to know if it's the first message or not (though I suppose I could check to see if it's identical to the previous message). There may be other reasons why someone would want to know if the connection is lost as well, so perhaps we should expose `OnConnect` and `OnDisconnect` events?

deadprogram, 2016-04-18:
That sounds like a very reasonable idea to me as well.

deadprogram, 2016-05-02:
Hi @tlrobinson did you ever have a chance to do anything on this, or do you need any additional assistance? Please let us know if there is anything we can do to help. Thanks.

deadprogram, 2017-01-26:
I was just looking at the code for the Paho MQTT lib, and looks to me like a `reconnect()` will maintain the same subscribe handlers, since all of the clidnt.msgRouter routes are preserved until the `mqtt.Client` is destroyed.

Basically, all we need to do is expose the clientoptions, and let Paho do the rest.

deadprogram, 2017-01-26:
OK this feature is now in the `dev` branch, and I verified it against a remote MQTT broker. I will close this issue next release.

Closed 2017-02-16.

Thread 283 (2016-06-06):

run only one goroutine at a time

nhooyr, 2016-06-06:
Every time a button is pressed, I want to ensure that if a goroutine is already running and handling previous input, the new goroutine exits. I see two ways to do this. One is using a channel with one sized buffer or launching a always running goroutine and sending the button presses to it using a select to make it nonblocking.

Here is option one (work is the robot's work function):

``` go
var running = make(chan struct{}, 1)

func work() {
    gobot.On(button.Event("push"), func(data interface{}) {
        log.Print(data)
        select {
        case running <- struct{}{}:
        default:
            return
        }
        defer func() {
            <-running
        }()
        // work
    })
}
```

``` go
var push = make(chan struct{})

func work() {
    go realWork()
    gobot.On(button.Event("push"), func(data interface{}) {
        log.Print(data)
        select {
        case push <- struct{}{}:
        default:
            return
        }
    })
}

func realWork() {
    for {
        <-push
        // work
    }
}
```

Which would be better?

nhooyr, 2016-06-07:
I think I realized a small problem with option two. There is no guarantee that the real work goroutine is launched and listening on the channel for input when the button is pressed whereas in option one it is guaranteed. Thus I think option one is the cleaner approach.

nhooyr, 2016-06-23:
I think I realized a small problem with option two. There is no guarantee that the work goroutine is launched and listening on the channel for input when the button is pressed. Thus at the start, it could lose input (unless I add a timeout or something instead of using default) whereas in option one it is guaranteed. Thus I think option one is the cleaner approach.

Ravenwater, 2016-08-25:
Conceptually, what would be the situation you want to avoid:
1- that the initiator has multiple outstanding requests queuing up, or
2- that the target has multiple overlapping state updates?

For #1, the initiator would test the button press state and filter out concurrent presses (it doesn't matter that you don't know if the down stream has started, all you need to know is if you have dispatched the work, at which point it is in play). For #2, the target would filter the state update overlap. Using a single slot channel should be sufficient to never have multiple overlapping state updates). There is one condition that is up to you to define and that is what to do with multiple button presses? Do you want to keep them as actual actionable events, or can you drop them if they overlap? Clearly, dropping them would yield a simpler system.

deadprogram, 2016-08-31:
I've been thinking a lot about this issue since it was opened, and it identified 2 things. One was that the internal architecture of how Gobot handled events needed to be refactored. The second was that we needed to explain a lot better what is happening "under the hood" as well as better allow for "bare metal" style of development using Gobot as a library and not necessarily the entire framework.

https://github.com/hybridgroup/gobot/pull/306 is the result of our current work on the first issue. Events will be now handled using event channels, which makes the concurrency just work how you expect in Golang.

Regarding the documentation of this, we've started an issue here https://github.com/hybridgroup/gobot-site/issues/48 that should also include information such as being discussed in this one.

Let the conversation continue, and thanks!

deadprogram, 2016-10-21:
Hi there.

There has been subtancial changes to how Gobot creates and manages the goroutines used. Please take a look at the `dev` branch to see what we've been doing: https://github.com/hybridgroup/gobot/tree/dev

In short:

- every Robot's Work is now run inside of a separate goroutine that exists for the life of the Robot.
- every Device's On and Once event handlers are each run in a separate goroutine that exists for the life of the Device.
- channels are now used for Events, and the implementations of On and Once use the event channels as their implementation to communicate when things happen.

The `dev` branch has a lot of breaking changes, but I think you will find the syntax is simpler, and the implementation much cleaner and more concurrent by default.

nhooyr, 2016-10-21:
Thank you, I will take a closer look when I get back to using my raspberry pi.

deadprogram, 2016-11-03:
I am going to close this issue now, please reopen if needed. Thanks, everyone!

Closed 2016-11-03.

Thread 284 (2016-06-08):

raspberry pi does not support analog

nhooyr, 2016-06-08:
https://gobot.io/documentation/drivers/analog-sensor/

It says below that the raspberry pi is supported but the pi has no analog pins?

deadprogram, 2016-06-08:
Hi, @nhooyr you are correct, that is an error in that docs page. As you pointed out, the raspi has no AIO.

If you have a moment, would you mind opening an issue on https://github.com/hybridgroup/gobot-site

Thanks!

deadprogram, 2016-12-21:
The docs are now updated with this info. Thanks, everyone.

Closed 2016-12-21.

Thread 287 (2016-06-11):

why is raspberry pi PWM limited between 0 and 255?

nhooyr, 2016-06-11:
The underlying pi-blaster daemon supports 1000 steps. Why only limit PWM write values between 0 and 255?

deadprogram, 2016-07-20:
Hi, @nhooyr the interface only supports that many, to provide compatibility with other interfaces such as Firmata etc. So really no good reason at all.

Perhaps a "PWMScale" method or something like that to allow setting different variations of PWM control. What do you think?

I'd be happy to accept a PR for the Raspi platform which added this. ;)

deadprogram, 2016-11-04:
I'm going to close this issue due to inactivity, please reopen if needed. Thanks!

verrol, 2019-07-31:
Hi,

Please re-open this issue to add some kind of scale method for PWM modules that uses more than 8bits.

Since gpio.DirectPinDriver.PwmWrite() uses a byte value, the max duty cycle on an ESP8266 is ~25%.

The ESP8266 appears to have a 10-bit resolution, so when specifying 255, the duty cycle is only a fraction of the max. Please see the attached screenshot from my logic analyzer.

The following code was used to test all 4 PWM pings for the ESP8266.

Thanks,

.v

```go
package main

import (
	"flag"
	"log"
	"time"

	"gobot.io/x/gobot"
	"gobot.io/x/gobot/drivers/gpio"
	"gobot.io/x/gobot/platforms/firmata"
)

/*

 NodeMCU Pin  | GPIO   | Function Pin
--------------+--------+-------
 10           | 12     | PWM0
 13           | 15     | PWM1
 9            | 14     | PWM2
 16           | 4      | PWM3

*/
const (
	pwm0Pin     = "12"
	pwm1Pin     = "15"
	pwm2Pin     = "14"
	pwm3Pin     = "4"
	defaultPort = "10.10.100.175:3030"
)

func main() {
	flag.Parse()

	port := defaultPort

	if len(flag.Args()) == 1 {
		port = flag.Args()[0]
	}

	log.Printf("Using port %v\n", port)

	board1 := firmata.NewTCPAdaptor(port)
	pwm0 := gpio.NewDirectPinDriver(board1, pwm0Pin)
	pwm1 := gpio.NewDirectPinDriver(board1, pwm1Pin)
	pwm2 := gpio.NewDirectPinDriver(board1, pwm2Pin)
	pwm3 := gpio.NewDirectPinDriver(board1, pwm3Pin)

	var speed byte

	work := func() {
		gobot.Every(2*time.Second, func() {
			log.Printf("Setting PWM to %v", speed)
			pwm0.PwmWrite(speed)
			pwm1.PwmWrite(speed)
			pwm2.PwmWrite(speed)
			pwm3.PwmWrite(speed)

			speed ^= 0xFF // toggle between 0% and 100% duty
		})

	}

	robot := gobot.NewRobot("my-robot",
		[]gobot.Connection{board1},
		[]gobot.Device{pwm0, pwm1, pwm2, pwm3},
		work,
	)

	robot.Start()
}
```

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

Closed 2016-11-04.

Thread 298 (2016-07-18):

ble/gatt/ollie: panic: runtime error: cgo argument has Go pointer to Go pointer

broady, 2016-07-18:
```
$ go run rover/ollie/1-color.go BB-EFCC
2016/07/17 21:25:43 Initializing Robot ollieBot ...
2016/07/17 21:25:43 Initializing connections...
2016/07/17 21:25:43 Initializing connection ble ...
2016/07/17 21:25:43 Initializing devices...
2016/07/17 21:25:43 Initializing device ollie ...
2016/07/17 21:25:43 Starting Robot ollieBot ...
2016/07/17 21:25:43 Starting connections...
2016/07/17 21:25:43 Starting connection ble...
State: PoweredOn
scanning...
2016/07/17 21:25:44 Unhandled event: xpc.Dict{"kCBMsgId":53, "kCBMsgArgs":xpc.Dict{"kCBMsgArgDeviceUUID":xpc.UUID{0xf6, 0x92, 0xb4, 0x84, 0xa6, 0xe1, 0x47, 0xa, 0x94, 0x5b, 0x8f, 0x1e, 0xb4, 0xef, 0xaf, 0x85}, "kCBMsgArgATTMTU":23}}

Connected Peripheral ID:f692b484a6e1470a945b8f1eb4efaf85, NAME:()
Failed to set MTU, err: Not implemented
2016/07/17 21:25:44 Unhandled event: xpc.Dict{"kCBMsgId":81, "kCBMsgArgs":xpc.Dict{"kCBMsgArgConnectionLatency":0, "kCBMsgArgSupervisionTimeout":175, "kCBMsgArgDeviceUUID":xpc.UUID{0xf6, 0x92, 0xb4, 0x84, 0xa6, 0xe1, 0x47, 0xa, 0x94, 0x5b, 0x8f, 0x1e, 0xb4, 0xef, 0xaf, 0x85}, "kCBMsgArgConnectionInterval":11}}
2016/07/17 21:25:45 Starting devices...
2016/07/17 21:25:45 Starting device ollie...
panic: runtime error: cgo argument has Go pointer to Go pointer

goroutine 35 [running]:
panic(0x40e5560, 0xc420110a50)
    /Users/cbro/go/src/runtime/panic.go:500 +0x1a1
github.com/currantlabs/gatt/xpc._cgoCheckPointer0(0xc42005c724, 0x0, 0x0, 0x0, 0x40d8901)
    ??:0 +0x59
github.com/currantlabs/gatt/xpc.valueToXpc(0x40d8900, 0xc420112480, 0x97, 0x40d8900)
    /Users/cbro/src/gocode/src/github.com/currantlabs/gatt/xpc/xpc_darwin.go:254 +0x3ff
github.com/currantlabs/gatt/xpc.valueToXpc(0x40e2f40, 0xc420110a40, 0x94, 0x40da560)
    /Users/cbro/src/gocode/src/github.com/currantlabs/gatt/xpc/xpc_darwin.go:269 +0x68b
github.com/currantlabs/gatt/xpc.valueToXpc(0x40f8e00, 0xc420011830, 0x15, 0x40f8e00)
    /Users/cbro/src/gocode/src/github.com/currantlabs/gatt/xpc/xpc_darwin.go:239 +0x8b2
github.com/currantlabs/gatt/xpc.valueToXpc(0x40e2f40, 0xc4201109c0, 0x94, 0x40da560)
    /Users/cbro/src/gocode/src/github.com/currantlabs/gatt/xpc/xpc_darwin.go:269 +0x68b
github.com/currantlabs/gatt/xpc.valueToXpc(0x40f8e00, 0xc4200118c0, 0x15, 0xc4200118c0)
    /Users/cbro/src/gocode/src/github.com/currantlabs/gatt/xpc/xpc_darwin.go:239 +0x8b2
github.com/currantlabs/gatt/xpc.goToXpc(0x40f8e00, 0xc4200118c0, 0x0)
    /Users/cbro/src/gocode/src/github.com/currantlabs/gatt/xpc/xpc_darwin.go:213 +0x57
github.com/currantlabs/gatt/xpc.(*XPC).Send(0xc4200a00b0, 0x40f8e00, 0xc4200118c0, 0xc4200f7e00)
    /Users/cbro/src/gocode/src/github.com/currantlabs/gatt/xpc/xpc_darwin.go:23 +0x85
github.com/currantlabs/gatt.(*device).sendCBMsg(0xc4200a0080, 0x42, 0xc420011830)
    /Users/cbro/src/gocode/src/github.com/currantlabs/gatt/device_darwin.go:509 +0x15b
github.com/currantlabs/gatt.(*peripheral).loop.func1(0xc4200a0180, 0xc4200d8000)
    /Users/cbro/src/gocode/src/github.com/currantlabs/gatt/peripheral_darwin.go:243 +0x119
created by github.com/currantlabs/gatt.(*peripheral).loop
    /Users/cbro/src/gocode/src/github.com/currantlabs/gatt/peripheral_darwin.go:253 +0x7f
exit status 2
Exit code 1
```

broady, 2016-07-18:
```
$ go version
go version devel +29ed5da Wed Jul 13 21:18:19 2016 +0000 darwin/amd64
```

deadprogram, 2016-07-19:
You have to disable the cgo check by using the flag `GODEBUG=cgocheck=0` flag when running on OSX, as mentioned here: https://github.com/paypal/gatt/issues/76

For example, use:

```
GODEBUG=cgocheck=0 go run rover/ollie/1-color.go BB-EFCC
```

deadprogram, 2016-12-21:
The docs are now updated with this info. Thanks, everyone.

Closed 2016-12-21.

Thread 302 (2016-08-18):

Is it possible to use gobot libraries without all the gobot/robot initialization.

ericho, 2016-08-18:
I'm wondering if it's possible to have a program like this

```go
package main

import (
    "time"

    "github.com/hybridgroup/gobot/platforms/gpio"
    "github.com/hybridgroup/gobot/platforms/intel-iot/edison"
)

func main() {
    e := edison.NewEdisonAdaptor("edison")
    led := gpio.NewLedDriver(e, "led", "13")
    for {
        led.Toggle()
        time.Sleep(1)
    }
}
```

That could be part of another program. For instance if I want to read values from a sensor and send it to a database or another process. I think that I can achieve this by using a channel but the idea would be to have a simple way to get the ports/sensors data, something like the mraa library.

Is there a way to have such functionality on gobot?

Thanks

trevrosen, 2016-08-20:
Try something like this, but with the Edison adaptor and let me know what happens.

https://github.com/hybridgroup/gobot/blob/dev/examples/beaglebone_basic_direct_pin.go

trevrosen, 2016-08-20:
You're basically on the right track, you just need to `Connect()` the adaptor.

ericho, 2016-08-23:
Awesome! The `connect()` was the thing I needed. Now this code works

```go
package main

import (
	"time"
	"github.com/hybridgroup/gobot/platforms/gpio"
	"github.com/hybridgroup/gobot/platforms/intel-iot/edison"
)

func main() {
	e := edison.NewEdisonAdaptor("edison")
	led := gpio.NewLedDriver(e, "led", "13")
	e.Connect()
	for {
		led.Toggle()
		time.Sleep(1000 * time.Millisecond)
	}
}
```

Thanks :)

deadprogram, 2016-08-23:
One other small thing worth mentioning. You should also call `Start()` on the driver, to ensure that it is properly initialized:

```
package main

import (
    "time"
    "github.com/hybridgroup/gobot/platforms/gpio"
    "github.com/hybridgroup/gobot/platforms/intel-iot/edison"
)

func main() {
    e := edison.NewEdisonAdaptor("edison")
    led := gpio.NewLedDriver(e, "led", "13")
    e.Connect()
    led.Start()
    for {
        led.Toggle()
        time.Sleep(1000 * time.Millisecond)
    }
}
```

deadprogram, 2016-08-23:
We should update the docs with this info, so people realize they can use Gobot as a set of Golang device libraries, not just use the entire framework.

trevrosen, 2016-08-23:
@deadprogram if you want to make an issue and assign it to me w/ some details about what you'd like to see and what platforms to cover, I can take on that docs update.

deadprogram, 2016-08-25:
Hi @trevrosen I just added https://github.com/hybridgroup/gobot-site/issues/48 to discuss this.

Closed 2016-08-23.

Thread 304 (2016-08-27):

"Cannot read from unknown characteristic" when connect to rolling spider via the BLE support from latest gobot

deadjoe, 2016-08-27:
Hi , after long waiting finally got the ble support to my device(rolling spider). #234
Great works !
Just gave it a try and failed, below are the environment and running information.
Appreciate if any clue.
## 1. Environment

uname -a
Darwin bearbone-2.local 15.6.0 Darwin Kernel Version 15.6.0:

go version
go version go1.7 darwin/amd64
## 2.Return info by running gatt/example/discover.go

`go run discoverer.go`

```
Peripheral ID:8b2f8032290143e18fc7c426619632e8, NAME:()
  Local Name        = RS_B016314
  TX Power Level    = 0
  Manufacturer Data = [67 0 207 25 0 9 1 0]
  Service Data      = []

Peripheral ID:8b2f8032290143e18fc7c426619632e8, NAME:()
  Local Name        = RS_B016314
  TX Power Level    = 0
  Manufacturer Data = []
  Service Data      = []
```
## 3. Main test code

``` Go
package main

import (
        "fmt"
        "os"

        "github.com/hybridgroup/gobot"
        "github.com/hybridgroup/gobot/platforms/ble"
)

func main() {
        gbot := gobot.NewGobot()

        bleAdaptor := ble.NewBLEClientAdaptor("ble", os.Args[1])
        info := ble.NewBLEDeviceInformationDriver(bleAdaptor, "info")

        work := func() {
                fmt.Println("Model number:", info.GetModelNumber())
                fmt.Println("Firmware rev:", info.GetFirmwareRevision())
                fmt.Println("Hardware rev:", info.GetHardwareRevision())
                fmt.Println("Manufacturer name:", info.GetManufacturerName())
                fmt.Println("PnPId:", info.GetPnPId())
        }

        robot := gobot.NewRobot("bleBot",
                []gobot.Connection{bleAdaptor},
                []gobot.Device{info},
                work,
        )

        gbot.AddRobot(robot)

        gbot.Start()
}
```
## 4.Failed info when running the above test code

`go run spider.go 8b2f8032290143e18fc7c426619632e8 (this ID was obtained from the above discover.go step which represented to my rolling spider device)`

```
2016/08/28 01:21:55 Initializing Robot bleBot ...
2016/08/28 01:21:55 Initializing connections...
2016/08/28 01:21:55 Initializing connection ble ...
2016/08/28 01:21:55 Initializing devices...
2016/08/28 01:21:55 Initializing device info ...
2016/08/28 01:21:55 Starting Robot bleBot ...
2016/08/28 01:21:55 Starting connections...
2016/08/28 01:21:55 Starting connection ble...
State: PoweredOn
scanning...
2016/08/28 01:21:56 Unhandled event: xpc.Dict{"kCBMsgId":81, "kCBMsgArgs":xpc.Dict{"kCBMsgArgConnectionInterval":22, "kCBMsgArgConnectionLatency":0, "kCBMsgArgSupervisionTimeout":500, "kCBMsgArgDeviceUUID":xpc.UUID{0x8b, 0x2f, 0x80, 0x32, 0x29, 0x1, 0x43, 0xe1, 0x8f, 0xc7, 0xc4, 0x26, 0x61, 0x96, 0x32, 0xe8}}}
2016/08/28 01:21:56 Unhandled event: xpc.Dict{"kCBMsgArgs":xpc.Dict{"kCBMsgArgDeviceUUID":xpc.UUID{0x8b, 0x2f, 0x80, 0x32, 0x29, 0x1, 0x43, 0xe1, 0x8f, 0xc7, 0xc4, 0x26, 0x61, 0x96, 0x32, 0xe8}, "kCBMsgArgATTMTU":104}, "kCBMsgId":53}

Connected Peripheral ID:8b2f8032290143e18fc7c426619632e8, NAME:()
Failed to set MTU, err: Not implemented
2016/08/28 01:21:57 **Unhandled event: xpc.Dict{"kCBMsgId":81, "kCBMsgArgs":xpc.Dict{"kCBMsgArgConnectionInterval":18, "kCBMsgArgConnectionLatency":0, "kCBMsgArgSupervisionTimeout":500, "kCBMsgArgDeviceUUID":xpc.UUID{0x8b, 0x2f, 0x80, 0x32, 0x29, 0x1, 0x43, 0xe1, 0x8f, 0xc7, 0xc4, 0x26, 0x61, 0x96, 0x32, 0xe8}}}**
2016/08/28 01:22:00 Starting devices...
2016/08/28 01:22:00 Starting device info...
2016/08/28 01:22:00 Starting work...
2016/08/28 01:22:00 Unknown service ID: 180a
2016/08/28 01:22:00 Cannot read from unknown characteristic
Model number:
2016/08/28 01:22:00 Unknown service ID: 180a
2016/08/28 01:22:00 Cannot read from unknown characteristic
Firmware rev:
2016/08/28 01:22:00 Unknown service ID: 180a
2016/08/28 01:22:00 Cannot read from unknown characteristic
Hardware rev:
2016/08/28 01:22:00 Unknown service ID: 180a
2016/08/28 01:22:00 Cannot read from unknown characteristic
Manufacturer name:
2016/08/28 01:22:00 Unknown service ID: 180a
2016/08/28 01:22:00 Cannot read from unknown characteristic
PnPId:
```

deadjoe, 2016-08-27:
Just to confirm that the central to device are working well, i tried the cylon.js via https://github.com/ChrisTheBaron/cylon-rolling-spider and it does working perfect.

```
"use strict";

var Cylon = require("cylon");

Cylon.robot({
       	connections: {
       		/*
       		 * Remember to change the uuid to your own devices uuid
       		 */
       		spider: { adaptor: "rolling-spider", uuid: "8b2f8032290143e18fc7c426619632e8" }
       	},

       	devices: {
       		drone: { driver: "rolling-spider" }
       	},

       	work: function (my) {
       		my.drone.wheelOn();
       		my.drone.flatTrim();
       		my.drone.takeOff();

       		after(5000, function () {
       			my.drone.land();
       		});
       	}
}).start();
```

deadprogram, 2016-08-31:
Wow @deadjoe that is one incredibly well entered Github issue. Let me look into that on my OSX machine, and I will get back to you.

deadjoe, 2016-09-12:
Any luck  or clue?

deadprogram, 2016-09-14:
Hi @deadjoe I do not think that the Parrot Minidrone supports those particular characteristics. Did you try running https://github.com/hybridgroup/gobot/blob/master/examples/minidrone.go by any chance?

deadjoe, 2016-09-22:
Hi @deadprogram , below are the result when running minidrone.go

```
 examples git:(master) ✗ go run minidrone.go 8b2f8032290143e18fc7c426619632e8
2016/09/22 21:33:38 Initializing Robot bleBot ...
2016/09/22 21:33:38 Initializing connections...
2016/09/22 21:33:38 Initializing connection ble ...
2016/09/22 21:33:38 Initializing devices...
2016/09/22 21:33:38 Initializing device drone ...
2016/09/22 21:33:38 Starting Robot bleBot ...
2016/09/22 21:33:38 Starting connections...
2016/09/22 21:33:38 Starting connection ble...
State: PoweredOn
scanning...
2016/09/22 21:33:39 Unhandled event: xpc.Dict{"kCBMsgId":81, "kCBMsgArgs":xpc.Dict{"kCBMsgArgConnectionInterval":22, "kCBMsgArgConnectionLatency":0, "kCBMsgArgSupervisionTimeout":500, "kCBMsgArgDeviceUUID":xpc.UUID{0x8b, 0x2f, 0x80, 0x32, 0x29, 0x1, 0x43, 0xe1, 0x8f, 0xc7, 0xc4, 0x26, 0x61, 0x96, 0x32, 0xe8}}}
2016/09/22 21:33:39 Unhandled event: xpc.Dict{"kCBMsgId":53, "kCBMsgArgs":xpc.Dict{"kCBMsgArgDeviceUUID":xpc.UUID{0x8b, 0x2f, 0x80, 0x32, 0x29, 0x1, 0x43, 0xe1, 0x8f, 0xc7, 0xc4, 0x26, 0x61, 0x96, 0x32, 0xe8}, "kCBMsgArgATTMTU":104}}

Connected Peripheral ID:8b2f8032290143e18fc7c426619632e8, NAME:()
Failed to set MTU, err: Not implemented
2016/09/22 21:33:40 Unhandled event: xpc.Dict{"kCBMsgId":81, "kCBMsgArgs":xpc.Dict{"kCBMsgArgConnectionInterval":18, "kCBMsgArgConnectionLatency":0, "kCBMsgArgSupervisionTimeout":500, "kCBMsgArgDeviceUUID":xpc.UUID{0x8b, 0x2f, 0x80, 0x32, 0x29, 0x1, 0x43, 0xe1, 0x8f, 0xc7, 0xc4, 0x26, 0x61, 0x96, 0x32, 0xe8}}}
2016/09/22 21:33:41 Starting devices...
2016/09/22 21:33:41 Starting device drone...
2016/09/22 21:33:41 Starting work...
[4 1 2 3 0 0]
panic: runtime error: cgo argument has Go pointer to Go pointer

goroutine 35 [running]:
panic(0x40ea540, 0xc42011c450)
	/usr/local/go/src/runtime/panic.go:500 +0x1a1
github.com/currantlabs/gatt/xpc._cgoCheckPointer0(0xc42005a104, 0x0, 0x0, 0x0, 0x40dd601)
	??:0 +0x59
github.com/currantlabs/gatt/xpc.valueToXpc(0x40dd6e0, 0xc42011a5e0, 0x97, 0x40dd6e0)
	/Users/joe/goproj/src/github.com/currantlabs/gatt/xpc/xpc_darwin.go:254 +0x3ff
github.com/currantlabs/gatt/xpc.valueToXpc(0x40e7f80, 0xc42011c440, 0x94, 0x40df300)
	/Users/joe/goproj/src/github.com/currantlabs/gatt/xpc/xpc_darwin.go:269 +0x68b
github.com/currantlabs/gatt/xpc.valueToXpc(0x40fe180, 0xc420113890, 0x15, 0x40fe180)
	/Users/joe/goproj/src/github.com/currantlabs/gatt/xpc/xpc_darwin.go:239 +0x8b2
github.com/currantlabs/gatt/xpc.valueToXpc(0x40e7f80, 0xc42011c380, 0x94, 0x40df300)
	/Users/joe/goproj/src/github.com/currantlabs/gatt/xpc/xpc_darwin.go:269 +0x68b
github.com/currantlabs/gatt/xpc.valueToXpc(0x40fe180, 0xc4201138c0, 0x15, 0xc4201138c0)
	/Users/joe/goproj/src/github.com/currantlabs/gatt/xpc/xpc_darwin.go:239 +0x8b2
github.com/currantlabs/gatt/xpc.goToXpc(0x40fe180, 0xc4201138c0, 0x0)
	/Users/joe/goproj/src/github.com/currantlabs/gatt/xpc/xpc_darwin.go:213 +0x57
github.com/currantlabs/gatt/xpc.(*XPC).Send(0xc4200a0030, 0x40fe180, 0xc4201138c0, 0xc4200d6e00)
	/Users/joe/goproj/src/github.com/currantlabs/gatt/xpc/xpc_darwin.go:23 +0x85
github.com/currantlabs/gatt.(*device).sendCBMsg(0xc4200a0000, 0x42, 0xc420113890)
	/Users/joe/goproj/src/github.com/currantlabs/gatt/device_darwin.go:509 +0x15b
github.com/currantlabs/gatt.(*peripheral).loop.func1(0xc4200a0200, 0xc4200cc3c0)
	/Users/joe/goproj/src/github.com/currantlabs/gatt/peripheral_darwin.go:243 +0x119
created by github.com/currantlabs/gatt.(*peripheral).loop
	/Users/joe/goproj/src/github.com/currantlabs/gatt/peripheral_darwin.go:253 +0x7f
exit status 2
```

deadjoe, 2016-09-22:
and corresponding code of /Users/joe/goproj/src/github.com/currantlabs/gatt/peripheral_darwin.go:253 is

```
236 func (p *peripheral) loop() {
237         rspc := make(chan message)
238
239         go func() {
240                 for {
241                         select {
242                         case req := <-p.reqc:
243                                 p.d.sendCBMsg(req.id, req.args)
244                                 if req.rspc == nil {
245                                         break
246                                 }
247                                 m := <-rspc
248                                 req.rspc <- m.args
249                         case <-p.quitc:
250                                 return
251                         }
252                 }
253         }()
```

deadprogram, 2016-09-25:
Hi, @deadjoe

Just noticed you have the `panic: runtime error: cgo argument has Go pointer to Go pointer` error as discussed here: https://github.com/hybridgroup/gobot/issues/298

Please try running your code like this:

```
GODEBUG=cgocheck=0 go run minidrone.go 8b2f8032290143e18fc7c426619632e8
```

deadprogram, 2016-10-21:
Hi @deadjoe did you ever have a chance to try the command i suggested?

juliancheal, 2016-11-16:
I have a feeling this is related to https://github.com/currantlabs/ble/issues/16 in either `currantlabs/ble` or `currantlabs/gatt`

deadprogram, 2016-12-21:
The docs are now updated with this info. Thanks, everyone.

Closed 2016-12-21.

Thread 307 (2016-08-31):

Change new adaptor/new driver function signatures to not require name

deadprogram, 2016-08-31:
This is derived from an email conversation I had with @mattetti thanks Matt!

It started me thinking about the naming thing. Seems like a little more separation of concerns might be useful to better accommodate devs who want to use Gobot as library not the full framework.

Specifically, I think that devs who care about a specific name to be used by the API can easily define that themselves, and everyone else will be satisfied with an auto-generated name, or not care about the internal name.

So what is currently this:

```go
e := edison.NewEdisonAdaptor("edison")
led := gpio.NewLedDriver(e, "led", "13")
button := gpio.NewButtonDriver(e, "button", "5")
```

would become:

```go
e := edison.NewAdaptor()
led := gpio.NewLedDriver(e, "13")
button := gpio.NewButtonDriver(e, "5")
```

If you wanted a specific name, you would then just do this:

```go
e := edison.NewAdaptor()
e.Name = "board"
led := gpio.NewLedDriver(e, "13")
led.Name = "flashlight"
button := gpio.NewButtonDriver(e, "5")
button.Name = "on-switch"
```

To reduce stuttering we should rename all single adaptors and drivers such as this:

```go
ardrone.ArdroneAdaptor
ardrone.NewArdroneAdaptor()
```

to this:

```go
ardrone.Adaptor
ardrone.NewAdaptor()
```

I think this will simplify most people use cases, however it would mean a breaking change to the new Adaptor and new Driver functions.

Feedback, please!

trevrosen, 2016-09-02:
👍 this is much more idiomatic and clear. Since it's a breaking change, would you want to take the version to `1.0.0` here? That's what semver compliance would require. That being said, there are probably enough people NOT doing this yet that you might be able to get away with just a minor version bump (i.e. to `0.13.1`)

agocs, 2016-09-02:
Would it make sense to allow currying `NewAdaptor()` and `Name`, e.g.

```
e := edison.NewAdaptor().Name("board")
```

deadprogram, 2016-09-03:
@trevrosen I was thinking exactly the same thing.

@agocs given that currying is not a common Golang idiom, I am very hesitant to add this.

agocs, 2016-09-03:
@deadprogram It wouldn't have to disallow the other method. E.g.

```
func (a *Adaptor) Name(name string) *Adapter {}
```

would both mutate the adaptor on which it is a method, and would return a reference to the mutated adaptor such that

```
e := edison.NewAdaptor()
e.Name("Bob")
```

is equivalent to

```
e := edison.NewAdaptor().Name("Bob")
```

Nevertheless, I understand why you might not want to add an affordance for currying.

trevrosen, 2016-09-06:
Yeah I'd also be hesitant to use currying here. I feel like porting the existing behavior of passing in the name as the constructor's only argument keeps it simple and honors the principle of least surprise.

deadprogram, 2016-09-06:
Well-thought out feedback, thanks.

@trevrosen adding `SetName` to the interface, combined with a clearly-defined auto-naming, seems like a nicer way to go. The common case where there are params to the constructor that are significant such as pin numbers or a port, are more interesting to consider than the simpler Edison case. For example, if we just go with "default" names:

```go
a := firmata.NewFirmataAdaptor("firmata", "/dev/ttyACM0")
led := gpio.NewLedDriver(a, "led", "13")
```

looks a lot better to me as:

```go
a := firmata.NewAdaptor("/dev/ttyACM0") // Name() == "firmata"
led := gpio.NewLedDriver(a, "13") // Name() == "led"
```

If we do care about specific names to be used by external APIs:

```go
a := firmata.NewFirmataAdaptor("arduino", "/dev/ttyACM0")
led := gpio.NewLedDriver(a, "blinker", "13")
```

becomes

```go
a := firmata.NewAdaptor("/dev/ttyACM0")
a.SetName("arduino")
led := gpio.NewLedDriver(a, "13")
led.SetName("blinker")
```

I do appreciate the consideration of reducing the breakage, but since it would change anyhow, seems like getting the work out of the way all at once would be kinder.

deadprogram, 2016-09-25:
This is the branch where my WIP on this can be found: https://github.com/hybridgroup/gobot/tree/feature/new-adaptor-driver-signatures

deadprogram, 2016-10-10:
This has now been merged into the `dev` branch, thanks everyone for all the great feedback!

Closed 2016-10-10.

Thread 310 (2016-09-06):

I²C mcp23017 pin input mode

th002, 2016-09-06:
How to setting mcp23017 pin input mode?

deadprogram, 2016-09-06:
Hi @th002 looks to me that https://github.com/hybridgroup/gobot/blob/dev/platforms/i2c/mcp23017_driver.go#L160 is missing some code like https://github.com/hybridgroup/gobot/blob/dev/platforms/i2c/mcp23017_driver.go#L147-L150 to set to input mode.

I do not have one of these handy to test out with at the moment, but a PR with this would be gladly accepted.

th002, 2016-09-06:
I had add function PinMod
```
func (m *MCP23017Driver) PinMode(pin, val uint8, portStr string) (err error) {
	selectedPort := m.getPort(portStr)
	// Set IODIR register bit for given pin to an output/input.
	if err = m.write(selectedPort.IODIR, uint8(pin), val); err != nil {
		return
	}
	return
}
```

deadprogram, 2016-09-06:
That looks like a good approach.

deadprogram, 2016-09-07:
Hi @th002 can you submit a PR with this fix? I'm sure all users of this expander would appreciate it.

Thanks!

Closed 2016-09-07.

Thread 311 (2016-09-07):

raspberry pi 3 support SMBus block read

th002, 2016-09-07:
raspberry pi 3 support SMBus block read, but gobot/sysfs/i2c_device.go L92
```
if d.funcs&I2C_FUNC_SMBUS_READ_BLOCK_DATA == 0 {
	// Adapter doesn't support SMBus block read
	return d.file.Read(b)
}
```
but the if condition is true

deadprogram, 2016-09-07:
If the platform does not support block reads, it performs the file-based read https://github.com/hybridgroup/gobot/blob/dev/sysfs/i2c_device.go#L94

Otherwise, it continues executing the `Read()` using the block-based read https://github.com/hybridgroup/gobot/blob/dev/sysfs/i2c_device.go#L97-L119

Hope that helps!

th002, 2016-09-07:
The data from file-based read is difference of the data from SMBus block-base read

deadprogram, 2016-09-07:
Hi @th002 please provide some more specific details about the differences, and then we can come up with a plan to accommodate them. Sounds good?

th002, 2016-09-09:
```
package main

import (
	"fmt"
	"os"
	"syscall"
	"unsafe"
)

const (
	I2C_SLAVE = 0x0703
	I2C_SMBUS = 0x0720

	I2C_SMBUS_READ           = 1
	I2C_SMBUS_I2C_BLOCK_DATA = 8
	// Adapter functionality
	I2C_FUNCS = 0x0705
)

type i2cSmbusIoctlData struct {
	readWrite byte
	command   byte
	size      uint32
	data      uintptr
}

func main() {
	f, err := os.OpenFile("/dev/i2c-1", os.O_RDWR, os.ModeExclusive)
	if err != nil {
		fmt.Println("open file error====>", err)
		return
	}

	var funcs uint64
	_, _, errno := syscall.Syscall(
		syscall.SYS_IOCTL,
		f.Fd(),
		I2C_FUNCS,
		uintptr(unsafe.Pointer(&funcs)),
	)
	if errno != 0 {
		fmt.Printf("Querying functionality failed with syscall.Errno %v\n", errno)
		return
	}

	_, _, errno = syscall.Syscall(
		syscall.SYS_IOCTL,
		f.Fd(),
		I2C_SLAVE,
		uintptr(byte(0x20)),
	)

	if errno != 0 {
		fmt.Printf("Setting address failed with syscall.Errno %v\n", errno)
		return
	}

	//SMBus block read mcp23017 pin 0 port A
	b := make([]byte, 19)
	data := make([]byte, len(b)+1)
	data[0] = byte(len(b))

	smbus := &i2cSmbusIoctlData{
		readWrite: I2C_SMBUS_READ,
		command:   0,
		size:      I2C_SMBUS_I2C_BLOCK_DATA,
		data:      uintptr(unsafe.Pointer(&data[0])),
	}
	_, _, errno = syscall.Syscall(
		syscall.SYS_IOCTL,
		f.Fd(),
		I2C_SMBUS,
		uintptr(unsafe.Pointer(smbus)),
	)

	if errno != 0 {
		fmt.Printf("Read failed with syscall.Errno %v\n", errno)
		return
	}
	copy(b, data[1:])
	fmt.Println("read from SMBus data==========>", b)
	f.Close()

	f, err = os.OpenFile("/dev/i2c-1", os.O_RDWR, os.ModeExclusive)
	if err != nil {
		fmt.Println("open file error====>", err)
		return
	}
	defer f.Close()

	_, _, errno = syscall.Syscall(
		syscall.SYS_IOCTL,
		f.Fd(),
		I2C_FUNCS,
		uintptr(unsafe.Pointer(&funcs)),
	)

	if errno != 0 {
		fmt.Printf("Querying functionality failed with syscall.Errno %v\n", errno)
		return
	}

	_, _, errno = syscall.Syscall(
		syscall.SYS_IOCTL,
		f.Fd(),
		I2C_SLAVE,
		uintptr(byte(0x20)),
	)

	if errno != 0 {
		fmt.Printf("Setting address failed with syscall.Errno %v\n", errno)
		return
	}

        //file-base read mcp23017 pin 0 port A
	data2 := make([]byte, 19)
	_, err = f.Read(data2)
	if err != nil {
		fmt.Println("file-based read error====>", err)
		return
	}
	fmt.Println("read from file-base data=======>", data2)
}
```
* This result is the first run this code:
```
    read from SMBus data==========> [255 255 0 0 0 0 0 0 0 0 0 0 1 0 0 0 0 0 255]
    read from file-base data=======> [127 0 0 255 255 0 0 0 0 0 0 0 0 0 0 1 0 0 0]
```

* This result is the second run this code:
```
   read from SMBus data==========> [255 255 0 0 0 0 0 0 0 0 0 0 1 0 0 0 0 0 3]
   read from file-base data=======> [0 0 0 255 255 0 0 0 0 0 0 0 0 0 0 1 0 0 0]
```

* This result is the third run this code:
```
   read from SMBus data==========> [255 255 0 0 0 0 0 0 0 0 0 0 1 0 0 0 0 0 3]
   read from file-base data=======> [0 0 0 255 255 0 0 0 0 0 0 0 0 0 0 1 0 0 0]
```

* This result is the fourth run this code:
```
   read from SMBus data==========> [255 255 0 0 0 0 0 0 0 0 0 0 1 0 0 0 0 0 255]
   read from file-base data=======> [255 0 0 255 255 0 0 0 0 0 0 0 0 0 0 1 0 0 0]
```

Platform is raspberry pi 3 B

deadprogram, 2016-09-20:
Hi @th002 did you mean to close this on purpose?

th002, 2016-09-20:
Yeah,Raspberry pi 3 is not support SMBus block read.
```
 smbus := &i2cSmbusIoctlData{
        readWrite: I2C_SMBUS_READ,
        command:   0,
        size:      I2C_SMBUS_I2C_BLOCK_DATA,
        data:      uintptr(unsafe.Pointer(&data[0])),
    }
```
This code is i2c_smbus_read_i2c_block_data?

Closed 2016-09-20.

Thread 314 (2016-09-14):

Support for kuman relay boards?

DaBlitzStein, 2016-09-14:
Hello,
I understad Kuman relay boards are not supported (https://www.amazon.es/gp/product/B014L10Q52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)

If i am wrong and they are supported, how can use it (Raspberry PI 3B+)

deadprogram, 2016-09-14:
Hola, @DaBlitzStein

Looks like that board is basically 8 relays on a single board. You should be able to use the Gobot `Relay` driver with it, just by connecting the various Raspi pins to the `IN1`, `IN2` pins on the Kuman board.

For example, this should work with the Raspi pins 32-40 conneccted to IN1 thru IN8 on the Kuman board:

```go
package main

import (
	"time"

	"github.com/hybridgroup/gobot"
	"github.com/hybridgroup/gobot/platforms/raspi"
  "github.com/hybridgroup/gobot/platforms/gpio"
)

func main() {
	gbot := gobot.NewGobot()

	r := raspi.NewRaspiAdaptor("raspi")
	relay1 := gpio.NewRelayDriver(r, "relay1", "33")
        relay2 := gpio.NewRelayDriver(r, "relay2", "34")
        relay3 := gpio.NewRelayDriver(r, "relay3", "35")
        relay4 := gpio.NewRelayDriver(r, "relay4", "36")
        relay5 := gpio.NewRelayDriver(r, "relay5", "37")
        relay6 := gpio.NewRelayDriver(r, "relay6", "38")
        relay7 := gpio.NewRelayDriver(r, "relay7", "39")
        relay8 := gpio.NewRelayDriver(r, "relay8", "40")

	work := func() {
		gobot.Every(3*time.Second, func() {
			relay1.Toggle()
                        relay2.Toggle()
                        relay3.Toggle()
                        relay4.Toggle()
                        relay5.Toggle()
                        relay6.Toggle()
                        relay7.Toggle()
                        relay8.Toggle()
		})
	}

	robot := gobot.NewRobot("kuman",
		[]gobot.Connection{r},
		[]gobot.Device{relay1, relay2, relay3, relay4, relay5, relay6, relay7, relay8},
		work,
	)

	gbot.AddRobot(robot)

	gbot.Start()
}
```

DaBlitzStein, 2016-09-14:
Thank you, I will try. I tell you. If not, we will try to develop the driver.

deadprogram, 2016-09-17:
Hi, @DaBlitzStein I'm going to close this issue. Please reopen if you need further assist.

DaBlitzStein, 2016-09-17:
It worked perfectly, only the pinout have to be changed due the gnd pins. After this everything ok. Thank you!

Closed 2016-09-17.

Thread 315 (2016-09-26):

Platform request: SPI using GPIO's for e.g. LED strip LDP8806

Inux, 2016-09-26:
I would like to implement an LED strip driver in the GPIO package. But I have some questions which have to be answered before I can start.

The LDP8806 is basically an SPI slave but I would like to implement it with normal GPIO's instead of the HW SPI. Therefore I thought it would make sense to add a new interface into gpio.go.
I would like to implement it so that other led strips can be integrated easily.

To my questions:
Does it makes sense to implement a new interface in gpio.go for SW SPI? (SW SPI means SPI with normal GPIO's) or is there an other way?
Are there already plans for led strip implementation?

deadprogram, 2016-10-03:
Hi, @Inux I think we need a standard SPI interface. If there is a software SPI implementation, also, that would be great.

Then whatever SPI drivers can use that interface, such as the LED strip you mention.

Does this make sense?

gen2thomas, 2022-12-08:
As far as I can see, the "warthogs gpiod" implementation brings such [SPI implementation](https://github.com/warthog618/gpiod/blob/master/spi/spi.go) using the GPIOs. So I will prepare the possibility to switch between different implementations and maybe already integrate the new implementation, since we use the library already for character device Kernel ABI.

gen2thomas, 2023-05-15:
part of release v2.0.0

Closed 2023-05-15.

Thread 317 (2016-10-06):

Edison documentation

devfubar, 2016-10-06:
I am new to gobot and I was trying to get my Intel Edison working. I do not have the arduino breakout board and spent some time figuring our that you make an assumption that it is present when using the Edison. I am interested in issue #262 however I think that the documentation should be updated to state the Arduino breakout board assumption to prevent people scratching their heads for as long as I did.

deadprogram, 2016-10-07:
Hi @devfubar that is no doubt true. Once the current refactoring in PR has been merged into master, I expect to add some code to handle the Arduino as well as the mini-breakout board, as well as to show other contributors how to more easily add other Edison breakout boards.

devfubar, 2016-10-07:
Thanks @deadprogram for getting back to me.  I was just interest to see if this was still the plan as the last comment on #262 was in Feb. I raised this issue as an interim solution to prevent people from wondering why the basic example wasn't working.

I'm happy to contribute so some sort of guide that you mentioned would be very useful.

deadprogram, 2016-11-01:
The `dev` branch now has all of these changes, thank you very much @devfubar for your awesome contributions on this.

Closed 2016-11-01.

Thread 319 (2016-10-10):

go get failing due to missing platform libs in dev branch

conoro, 2016-10-10:
I'm trying to install Gobot on a C.H.I.P and I'm failing on the first hurdle.

```
go get -d -u github.com/hybridgroup/gobot/...
```

gives

```
cannot find package "github.com/hybridgroup/gobot/platforms/i2c"
```

i2c and gpio seem to be missing on the default dev branch in GitHub but they are on master. Is there some trick to getting master other than checking everything out manually? Thanks.

deadprogram, 2016-10-10:
Hi @conoro

both the `i2c` and `gpio` packages are now under `/drivers` in the `dev` branch, but this seems to be an unforeseen consequence of Github, having set the default branch to `dev`, and how Golang gets packages.

What I thought was happening was Golang would simply always get the `master` branch, sinec that used to be the default behavior. My knowledge on that subject was way out of date, it would seem. What appears to actually be happening is that Github serves up the default branch https://github.com/golang/go/issues/9032

Ouch, my bad. So much for our careful release planning.

I think the best thing to do for now, is switch the default branch back to master. Hopefully that will give a chance to complete the refactoring work taking place right now, for which the docs are not yet complete.

conoro, 2016-10-10:
@deadprogram Thanks! I also found a quick workaround which was just to use govendor like so:

```
govendor init
govendor fetch github.com/hybridgroup/gobot/...@master
```

I was then able to build and run the sample app

deadprogram, 2016-10-10:
Did you obtain the code for that sample from the web site? I ask because the code in the repo itself has been modified for compatibility with the latest changes.

conoro, 2016-10-10:
Yeah I just used the code from the bottom of this page: https://gobot.io/documentation/platforms/chip/

deadprogram, 2016-10-11:
I cut a release yesterday (0.13.0) with the code up the point I merged the new refactored branch on Monday, and then switched back the master branch to be the default branch. This way, anyone who was tracking the default up to that point has a master branch to match.

I will close this issue now, thanks for pointing it out @conoro

Closed 2016-10-11.

Thread 324 (2016-10-21):

Initial level question

gpaixao, 2016-10-21:
Hi,

I'm starting now with arduino and already developing in Golang, my problem is maybe easy.

My `func` work don't work 😄

```go
package main

import (
	"fmt"

	"github.com/hybridgroup/gobot"
	"github.com/hybridgroup/gobot/platforms/firmata"
	"github.com/hybridgroup/gobot/platforms/gpio"
)

func main() {
	gbot := gobot.NewGobot()

	firmataAdaptor := firmata.NewFirmataAdaptor("arduino", "/dev/cu.usbmodem1421")
	sensor := gpio.NewAnalogSensorDriver(firmataAdaptor, "sensor", "0")

	work := func() {
		fmt.Println(sensor.Read())
	}

	robot := gobot.NewRobot("bot",
		[]gobot.Connection{firmataAdaptor},
		[]gobot.Device{sensor},
		work,
	)

	gbot.AddRobot(robot)

	gbot.Start()
}

```

Anybody, can you help me ?

tks

deadprogram, 2016-10-21:
Hi, @gpaixao

I ran your code against the current release, and received the following output:

```
$ go run examples/firmata_analog.go
2016/10/21 08:40:44 Initializing Robot bot ...
2016/10/21 08:40:44 Initializing connections...
2016/10/21 08:40:44 Initializing connection arduino ...
2016/10/21 08:40:44 Initializing devices...
2016/10/21 08:40:44 Initializing device sensor ...
2016/10/21 08:40:44 Starting Robot bot ...
2016/10/21 08:40:44 Starting connections...
2016/10/21 08:40:44 Starting connection arduino on port /dev/ttyACM0...
2016/10/21 08:40:49 Starting devices...
2016/10/21 08:40:49 Starting device sensor on pin 0...
2016/10/21 08:40:49 Starting work...
0 <nil>
```

It ran, and printed a single value from the sensor, in this case 0. Is that not what you expected? If you want to print the value over and over, you need to do that in your work. For example, to read and print the value every 1 second:

```go
package main

import (
	"fmt"
	"time"

	"github.com/hybridgroup/gobot"
	"github.com/hybridgroup/gobot/platforms/firmata"
	"github.com/hybridgroup/gobot/platforms/gpio"
)

func main() {
	gbot := gobot.NewGobot()

	firmataAdaptor := firmata.NewFirmataAdaptor("arduino", "/dev/cu.usbmodem1421")
	sensor := gpio.NewAnalogSensorDriver(firmataAdaptor, "sensor", "0")

	work := func() {
		gobot.Every(1*time.Second, func() {
			fmt.Println(sensor.Read())
		})
	}

	robot := gobot.NewRobot("bot",
		[]gobot.Connection{firmataAdaptor},
		[]gobot.Device{sensor},
		work,
	)

	gbot.AddRobot(robot)

	gbot.Start()
}
```

Hope that helps!

gpaixao, 2016-10-23:
Don't work, my log:

Closed 2016-10-24.

Thread 325 (2016-10-22):

Request: PIR Motion Sensor

rraulinio, 2016-10-22:
I recently got a motion sensor for my Arduino Uno and I'm interested in programming it via Gobot, because I've done everything so far in Gobot. Are you able to dev something in the next 2-3 months? Because I would like to use this application I'm making in Golang+Gobot as my bachelor's degree project. :)
The sensor is [this one](https://www.google.ro/search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).

Looking forward for an answer!

deadprogram, 2016-10-22:
Hi @rraulinio please take a look at this feature branch with initial PIR sensor support: https://github.com/hybridgroup/gobot/tree/feature/devices/pirmotion

You would use it as follows:

```go
package main

import (
	"github.com/hybridgroup/gobot"
	"github.com/hybridgroup/gobot/drivers/gpio"
	"github.com/hybridgroup/gobot/platforms/firmata"
)

func main() {
	firmataAdaptor := firmata.NewAdaptor("/dev/ttyACM0")

	sensor := gpio.NewPIRMotionDriver(firmataAdaptor, "5")
	led := gpio.NewLedDriver(firmataAdaptor, "13")

	work := func() {
		sensor.On(gpio.MotionDetected, func(data interface{}) {
			led.On()
		})
		sensor.On(gpio.MotionStopped, func(data interface{}) {
			led.Off()
		})
	}

	robot := gobot.NewRobot("motionBot",
		[]gobot.Connection{firmataAdaptor},
		[]gobot.Device{sensor, led},
		work,
	)

	robot.Start()
}
```

Note that this branch is based on the `dev` branch, and so will not be compatible with the current `master`. Please give it a try if you have a chance.

rraulinio, 2016-10-22:
You forgot to put the gpio folder in platforms/ ?
Also, here is the output I receive when I try to compile a simple blink program.
[https://s17.postimg.org/ineo61zv3/Untitled.png](https://s17.postimg.org/ineo61zv3/Untitled.png)

rraulinio, 2016-10-22:
@deadprogram I will test the PIR sensor on monday and come back with a later edit. Tested the branch files, everything works fine (after editing main.go as you said). Also, when will it be available on master? I'm asking because I need to know if it's worth to commit to git or not. :)

rraulinio, 2016-10-26:
Nope, the function doesn't work. The sensor is not detecting anything or it isn't starting, don't know exactly. Please help me asap!

deadprogram, 2016-10-30:
Hi @rraulinio I had to make another commit to correct an error in the original code, and I just tested it with my HC-SR501 sensor. Please give another try when you get a chance.

rraulinio, 2016-10-30:
Are you sure that you commited the right code? It still doesn't work and you forgot that fmt.println in an infinite loop...

deadprogram, 2016-10-30:
The correct code is now checked in. This is my output:

```
$ go run examples/firmata_pir_motion.go
2016/10/30 22:05:21 Initializing connections...
2016/10/30 22:05:21 Initializing connection Firmata ...
2016/10/30 22:05:21 Initializing devices...
2016/10/30 22:05:21 Initializing device PIRMotion ...
2016/10/30 22:05:21 Initializing device LED ...
2016/10/30 22:05:21 Robot motionBot initialized.
2016/10/30 22:05:21 Starting Robot motionBot ...
2016/10/30 22:05:21 Starting connections...
2016/10/30 22:05:21 Starting connection Firmata on port /dev/ttyACM0...
2016/10/30 22:05:26 Starting devices...
2016/10/30 22:05:26 Starting device PIRMotion on pin 5...
2016/10/30 22:05:26 Starting device LED on pin 13...
2016/10/30 22:05:26 Starting work...
motion-detected
motion-stopped
motion-detected
motion-stopped
motion-detected
```

rraulinio, 2016-10-30:
Mnope, still not working. Not detecting any motion at all, don't even know if it's calibrating or something... Be sure that everything is plugged corectly, because as I said, it works runned by Arduino compiler. I'm running this very basic example and nothing... led on 13, sensor on 7... nothing. I don't know...

deadprogram, 2016-10-30:
I know my HW is plugged in correctly, and as you can see form the above output is working. There is no calibration on the sensor from software, it just does it's thing.

rraulinio, 2016-10-31:
Mnope, tested again via Arduino's compiler and works perfectly.
Reuploaded Firmata.
Testing via Gobot, not working. I'm out of ideas...

rraulinio, 2016-10-31:
https://s17.postimg.org/rdo910isf/image.png

deadprogram, 2016-10-31:
I'd check your version of Firmata. Where did you obtain it from? Also verify your pin, my test used digital pin 5, you mentioned you were using digial 7. Also make sure you are using correct 5v voltage.

I used an Arduino Uno. Are you using some other Arduino variant?

In any case, check all the above, since we know the code itself "works".

rraulinio, 2016-10-31:
Firmata is at ir's latest version, from October 2016, being updated in Arduino's compiler and then uploaded by me.
I'm sure that the cables are plugged in ok and the sensor works, because as i said, if i run "pir motion example on arduino compiler" it works perfectly.
I'm using Uno, compatible with Arduino... it's the same thing.

rraulinio, 2016-10-31:
I really can't see why it does not work, mostly because it worked for you. Are you sure that you uploaded all the corrections for the code? Maybe you forgot something, don't know.

deadprogram, 2016-10-31:
Did you verify that the Gobot `firmata_blink.go` program works as you expect? Try testing that on the Gobot `dev` branch as sanity check.

I use ConfigurableFirmata with most everything activated (DigitalIO, AIO, I2C), usually uploaded via the latest version of Gort (https://github.com/hybridgroup/gort). Also have tested using Arduino101 using the Firmata uploaded via IMRAA.

If not, something else must be different on your setup. Are you just running the https://github.com/hybridgroup/gobot/blob/feature/devices/pirmotion/examples/firmata_pir_motion.go program, or something else?

rraulinio, 2016-10-31:
Everything runs properly.
In parallel, I run 3 leds and a buzzer from the breadboard, so yes, everything is allright at this point.
I'm running that example, yes.

deadprogram, 2016-10-31:
This is my hw setup:
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

rraulinio, 2016-10-31:
Uploaded firmata via Gort, retested...  still nothing.
Tested in that very basic example... nothing.
It can't be possible that the configuration could have something, because in this case, running it via Arduino's compiler wouldn't work at all, in the first place. It's crystal clear that the problem is either at my version of firmata (don't think so, it's the last one), either on something related to gobot. Please post 2-3 more pictures, with the connections of wires and all, so I can make a check with yours.

deadprogram, 2016-10-31:
When you said "Tested in that very basic example... nothing" did you mean that the `firmata_blink.go` example did not work for you?

deadprogram, 2016-10-31:
Here are my connections to the HC-SR501:

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

The OUT pin on the sensor is connected to the digital pin 5.

rraulinio, 2016-10-31:
Yes, very basic example = firmata_blink.go.
I'm gonna get back at it in a few hours (it's morning here in Romania and I need to go away from home).

deadprogram, 2016-10-31:
Did the firmata_blink.go work, or not work?

rraulinio, 2016-10-31:
Not work. Initialising and starting sensor, but that's it, no detection further on.

deadprogram, 2016-10-31:
I was asking about the firmata_blink.go, not the firmata pir.

rraulinio, 2016-10-31:
Sorry, I was in s hurry, didn't pay full attention. Yes, it worked perfectly.

rraulinio, 2016-10-31:
I will get back at in about 6-7 hours. I think i'm gonna record a short video with the configuration and with the startup and email it to you on your account's address. Is that ok?

deadprogram, 2016-10-31:
Sounds great, thanks.

rraulinio, 2016-10-31:
No, I thank you. Than, talk to you via email and i will get back here with a new post with the solution when it's done (for others in the same situation).

rraulinio, 2016-10-31:
Email sent, check your inbox.

deadprogram, 2016-11-01:
You probably want to set the jumper to "auto-reset" right now looks like you are set to "no reset": https://www.mysensors.org/build/motion

The Arduino code from what I could tell in the video looks opposite to what I would expect. The HC-SR501 goes HIGH when motion is detected, and LOW when no motion.

rraulinio, 2016-11-01:
So what should I do? I don't understand.

deadprogram, 2016-11-01:
Switch your jumper to the "auto-reset" position, I suppose.

rraulinio, 2016-11-01:
Switched, no change... still not working. Sometimes (not always), if I replug the red wire (GRD), it goes on and detects, and than goes off. After that... nothing. I tried every single posibility, with the jumper on L and on H, nothing.

deadprogram, 2016-11-01:
I have a bunch of these same sensors, they are very slow to reset (needs at minimum 5 seconds) but generally reliable if you set the calibration. You for sure need auto reset or it will only trigger once.

I have tested successfully with a real Arduino Uno, a clone Arduino Uno, and an Arduino 101. I've also tested with a couple of different pins.

In any case, check your sensor, or your cables, or try another Arduino. Seems like everything is working as expected to me.

rraulinio, 2016-11-01:
Ok, I will see, than. I will try to figure it out. Thanks for all the help,
I really thank you. Hope this will help others, too.

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

deadprogram, 2016-11-01:
I have merged this branch into the dev branch, so please continue to test from there.

2 other questions:

- which brand of Arduino are you using?
- what version of Golang are you running.

Please let me know anything new you might discover.

rraulinio, 2016-11-01:
Uno R3, made like Arduino. Is a replica of Arduino, it's around $6-7 here and does the same thing as an original one. :)) I've tested a lot of algorithms on it, made by me or not, and it works very well. I'm running Go 1.7.3 on Win.

rraulinio, 2016-11-01:
No, I just can't make it work. I've tried everything, really everything. I doesn't work with Gobot... only with that Arduino's Compiler. I need to give up for now, I can't focus on this anymore. I will get back at it in a few weeks or something like this. Thanks again for all your help!

deadprogram, 2016-11-04:
This device is now in the 'dev' branch. I am closing this issue, please reopen if needed, and thanks to @rraulinio for your work on this.

Closed 2016-11-04.

Thread 329 (2016-10-25):

Buzzer beep Arduino

rraulinio, 2016-10-25:
How can I play a simple beep on the Arduino's buzzer, like using beep() in the Arduino compiler? I just can't find the tone for that... it's annoying.
Example of function in c here: [click](http://www.hobbytronics.co.uk/arduino-tutorial7-piezo-beep).

rraulinio, 2016-10-25:
I've managed to play a perfect beep by modifying the function by myself, in a way that I want it to be. Let me know if there is any other way, without modifying the original function.

New function:
`func (l *BuzzerDriver) Tone(duration float64, out bool) (err error) {
	// Modified by Raul M Crivineanu
	if out == true {
		return
	}
	tempo := ((60 / l.BPM) * (duration * 1000))
	for i := 0.0; i < tempo*7000; i += 550 {
			l.connection.DigitalWrite(l.Pin(), 100)
			time.Sleep(time.Duration(duration)*time.Millisecond)
			l.connection.DigitalWrite(l.Pin(), 0)
			time.Sleep(time.Duration(duration)*time.Millisecond)
	}
	return
}
`

Calling:
`buzzer1.Tone(1.0, false)`

rraulinio, 2016-10-25:
I've managed to do it properly. I've left Tone() alone and created a separate function called Buzz, with some code similiar with that above.
Look at the result (<3): [https://www.youtube.com/watch?v=hYrdMETpcW0](https://www.youtube.com/watch?v=hYrdMETpcW0)

Closed 2016-10-31.

Thread 348 (2016-12-28):

Sphero BB-8 sample does not work correctly on MacOS

durgeshm, 2016-12-28:
Referring to the "color change" sample here https://gobot.io/documentation/platforms/bb8/

BB-8 changes colors about 2 or 3 times and then stops. There are some errors as shown below, when the program starts.

$ GODEBUG=cgocheck=0 go run main.go BB-XXXX
2016/12/28 01:10:33 Initializing connections...
2016/12/28 01:10:33 Initializing connection BLECLient ...
2016/12/28 01:10:33 Initializing devices...
2016/12/28 01:10:33 Initializing device BB-8 ...
2016/12/28 01:10:33 Robot bb8 initialized.
2016/12/28 01:10:33 Starting Robot bb8 ...
2016/12/28 01:10:33 Starting connections...
2016/12/28 01:10:33 Starting connection BLECLient...
State: PoweredOn
scanning...
2016/12/28 01:10:37 Unhandled event: xpc.Dict{"kCBMsgId":53, "kCBMsgArgs":xpc.Dict{"kCBMsgArgDeviceUUID":xpc.UUID{0xa7, 0xc3, 0x11, 0x24, 0x17, 0x9d, 0x46, 0x68, 0x8b, 0x61, 0x7a, 0xec, 0x8c, 0x76, 0xf9, 0x65}, "kCBMsgArgATTMTU":23}}

Connected Peripheral ID:a7c31124179d46688b617aec8c76f965, NAME:()
Failed to set MTU, err: Not implemented
2016/12/28 01:10:37 Unhandled event: xpc.Dict{"kCBMsgId":81, "kCBMsgArgs":xpc.Dict{"kCBMsgArgConnectionInterval":18, "kCBMsgArgConnectionLatency":0, "kCBMsgArgSupervisionTimeout":175, "kCBMsgArgDeviceUUID":xpc.UUID{0xa7, 0xc3, 0x11, 0x24, 0x17, 0x9d, 0x46, 0x68, 0x8b, 0x61, 0x7a, 0xec, 0x8c, 0x76, 0xf9, 0x65}}}
2016/12/28 01:10:39 Starting devices...
2016/12/28 01:10:39 Starting device BB-8...
2016/12/28 01:10:39 Starting work...

Same program when cross-compiled for ARM/Linux, runs fine on Linux (on a Raspberry Pi 3) - the colors keep changing indefinitely.

Also, tested the Cylon.js example color/color.js on the same Mac against the same BB-8. That also works correctly - colors changing indefinitely.

Thus, it looks like a problem specific to MacOS and Gobot.

$ go version
go version go1.7.4 darwin/amd64

deadprogram, 2016-12-28:
What version of OSX are you running?

durgeshm, 2016-12-28:
macOS Sierra  10.12.2

deadprogram, 2016-12-28:
Hi @durgeshm if you can, please give this branch a try https://github.com/hybridgroup/gobot/tree/feature/currantlabs-ble

It uses https://github.com/currantlabs/ble instead of https://github.com/currantlabs/gatt and seems to work well on my OSX with El Capitan.

durgeshm, 2016-12-28:
Yes, feature/currantlabs-ble branch works correctly. No errors. Thank you.

mtoto, 2018-12-11:
I encountered the same issue on OSX High Sierra 10.13.6.

nehagup, 2019-11-23:
I encountered the same error on OSX Mojave 10.14.6

deadprogram, 2019-11-24:
Please see https://github.com/hybridgroup/gobot/issues/661 for more discussion on this topic.

Closed 2016-12-28.

Thread 349 (2016-12-29):

Sphero BB-8 driver - does it support collision detection?

durgeshm, 2016-12-29:
Not sure if I am missing something obvious, but does BB8Driver support collision detection?

I see that sphero.SpheroDriver has support for collision events. But BB8Driver does not use SpheroDriver at all. It basically uses ollie.Driver which does not seem to handle collisions as well. At least, that is how I am reading the code. Please correct me if I am missing anything.

deadprogram, 2016-12-29:
Hi @durgeshm you are correct, the implementation is still incomplete. There is a bunch of code in /platforms/sphero that can be reused for ollie and bb8, but I've not had a chance to work on that yet. Specifically all the packet creation code can be reused, since ollie & bb8 are the same API, but sent/received using BLE characteristics instead of Bluetooth serial.

A PR that worked on this would be gratefully accepted :)

durgeshm, 2016-12-29:
Thanks Ron. Just wanted to clarify if the code from sphero could be applied to ollie/bb8 except for BLE/serial and there wasn't some other fundamental difference. Thanks for confirming. I will see what I can do.

deadprogram, 2017-01-15:
Hi @durgeshm not sure if you are working on this, or possibly planning to, but you should check out the changes in the `dev` branch. We're now using https://github.com/currantlabs/ble for our BLE communication, and it works a lot better. There have been a couple internal API changes to be aware of that you can see in that branch.

durgeshm, 2017-01-15:
Is this different than the changes in master branch? It looks like 1.1 release already uses currantlabs/ble. Please correct me if I am missing something.

deadprogram, 2017-01-15:
https://github.com/hybridgroup/gobot/tree/dev is the dev branch.

1.1 uses currantlabs/gatt, but not currantlabs/ble which is pretty similar name.

durgeshm, 2017-01-16:
Is there a way to test the HandleResponses method? https://github.com/hybridgroup/gobot/blob/dev/platforms/sphero/ollie/ollie_driver.go#L154

It gets added as an event handler/subscriber at https://github.com/hybridgroup/gobot/blob/dev/platforms/sphero/ollie/ollie_driver.go#L107 .

I also copied (and invoked) the ConfigureCollisionDetection method from sphero_driver.

Under what conditions/events, is the "HandleResponses" method supposed to get called? Any insights would be great. Thanks.

deadprogram, 2017-01-17:
Hi @durgeshm the HandleResponses method is called whenever there is a data notification that comes in from the `responseCharacteristic`. When using any of the Sphero robots, you send commands to the `commandsCharacteristic` and then get the responses via the `responseCharacteristic`.

One way to test, would be to call HandleResponses directly using some known response byte arrays, and insure that whatever event handlers you are creating in your new implementation are being called as expected.

durgeshm, 2017-01-24:
Hi Ron,

The accompanied pull request (https://github.com/hybridgroup/gobot/pull/360) works for me. I have also added an example that is tested for BB-8.

Admittedly, I am new to BLE, but it was was not very obvious to me why ReadCharacteristic had to be called (repeatedly) in order to start receiving notification events (that were registered with Subscribe). But, this was the only way, HandleResponses started getting invoked with collision response packets.

deadprogram, 2017-01-25:
Hi @durgeshm the Sphero API does not start sending the collision packets until it receives the command packet to begin doing so. Then the notifications are just the means for sending the data. This is how the Sphero API works, which is an artifact of the serial interface on which the API was originally designed. I agree it is not exactly what a "normal" BLE app would do, but it certainly works once you understand the interaction model.

Anyhow, this is now in the `dev` branch, I will close the issue once the next release comes out. Thanks again!

deadprogram, 2017-02-16:
This has now been released as part of v1.2.0 thanks again!

Closed 2017-02-16.

Thread 354 (2017-01-06):

undefined: syscall.SYS_IOCTL (build fails on Windows)

DerekL, 2017-01-06:
Looks like missing syscall functions, can't build on Windows. Looks like this:

`C:\Work\pitest>go build -o test test.go
# gobot.io/x/gobot/sysfs
..\src\gobot.io\x\gobot\sysfs\i2c_device.go:60: undefined: syscall.SYS_IOCTL
..\src\gobot.io\x\gobot\sysfs\i2c_device.go:74: undefined: syscall.SYS_IOCTL
..\src\gobot.io\x\gobot\sysfs\i2c_device.go:107: undefined: syscall.SYS_IOCTL
..\src\gobot.io\x\gobot\sysfs\i2c_device.go:146: undefined: syscall.SYS_IOCTL
..\src\gobot.io\x\gobot\sysfs\syscall.go:32: not enough arguments in call to syscall.Syscall`

deadprogram, 2017-01-06:
Hi @DerekL you cannot build Gobot code intended for Raspi without using the correct cross-compilation flags as mentioned here https://gobot.io/documentation/platforms/raspi/#how-to-connect

The correct syntax in your case should be `GOARM=6 GOARCH=arm GOOS=linux go build -o test test.go`

DerekL, 2017-01-06:
Can confirm this works, thanks!

deadprogram, 2017-01-10:
Glad to have been of assistance. OK, closing.

Closed 2017-01-10.

Thread 359 (2017-01-23):

ServoDriver / ServoWriter inconsistencies

erkkah, 2017-01-23:
While adding a ServoWriter implementation to c.h.i.p, I noticed that the ServoDriver accepts movement in angles (0-180) and calls the underlying ServoWriter with a span (0-255).

However, the ServoWriter implementations for raspi and beaglebone both expect movement argument to be in angles, which breaks when someone uses a ServoDriver to talk to the device.

Not sure how to proceed, and not cause more problems / break compatibility.

deadprogram, 2017-01-24:
Hi @erkkah that was an error that was introduced thru some incomplete refactoring. Thanks for the catch.

What we want to be happening, is that the `gpio.ServoDriver` should be passing along the angle value to `adaptor.ServoWrite()`. Then the specific adaptor can handle it however it needs to. In the Beaglebone case, by accepting an angle and scaling to a pwm duty cycle and calling PWMWrite. In the Firmata case, by just passing along the angle value.

So the conversion logic should be in the adaptor, not the `ServoDriver`.

erkkah, 2017-01-24:
Great, thanks, that makes sense.
Then I know and will adapt the implementation accordingly.

deadprogram, 2017-01-25:
I've just corrected the servo part with this commit https://github.com/hybridgroup/gobot/commit/53ffbbd2bb0d8671362480fc0e62badf43d2ac1b which is now in the `dev` branch so you should be all good for your C.H.I.P. implementation.

Thanks again @erkkah for the report.

Closed 2017-01-30.

Thread 361 (2017-01-29):

Support DHT11/22

tiagoboldt, 2017-01-29:
Please consider adding a GPIO driver for DHT22/11 temperature and humidity sensors.

deadprogram, 2017-01-31:
This requires a `pulseIn` style of API to be able to function, in similar fashion to what https://github.com/hybridgroup/gobot/issues/246 would need.

deadprogram, 2017-02-02:
Also same as #152

pakohan, 2017-03-01:
I'd also be interested in that. I'm a little concerned about the fact that we're dealing with a digital signal where we'd need to differentiate a 28µs signal from a 50µs signal (from what I can see in the [data-sheet](http://www.micropik.com/PDF/dht11.pdf). My concern is that the Go garbage collector and/or scheduler will make it impossible to read the correct value of the GPIO pin.

I was searching for another driver that solves this problem already but the only drivers reading values from a pin are button drivers that poll in a relatively long interval to get the value of the input.

Since I'd be interested in writing the driver, here's my background: I'm a experienced Go backend software developer (writing REST APIs for our company) but I'm not very deep into the Go runtime and garbage collector. Additionally, some years ago when studying I had to write a C-Linux driver for the RPi, but just for reading a button value and toggling a LED. After that, I've done nothing anymore with embedded systems, and I never worked with Gobot before.

From [this tutorial](https://tutorials-raspberrypi.de/raspberry-pi-luftfeuchtigkeit-temperatur-messen-dht11-dht22/) I found some python that includes a C driver for the sensor. It seems like it is running in user space and so we might be able to write a driver using CGo. The relevant parts of the driver can be found [here](https://github.com/adafruit/Adafruit_Python_DHT/blob/master/source/Raspberry_Pi/pi_dht_read.c#L62). I think the fact that it sets the kernels scheduler priority so the reading process doesn't get interrupted speaks for itself.

Nevertheless, it's a nice challenge. What could be the best solution? Maybe we can implement some tiny low-level reading logic in C and make it available via a generic driver that outputs `[]byte` via the `io.Reader` interface? Asking @deadprogram, what is already there? What is missing? Since you know Gobot, how would you do it?

I'm really interested about the solution we'll come up with ;-)

pakohan, 2017-03-05:
Hey guys, I've hacked sth. together :-)

@tiagoboldt That could be interesting for you: https://github.com/pakohan/dht

@deadprogram I'd like to see [this](https://github.com/pakohan/dht) in the Gobot repo, but I think before supporting the other two platforms of the [upstream](https://github.com/adafruit/Adafruit_Python_DHT) driver the quality isn't good enough. Also, do you really want to have CGo in the Gobot repo, I think this will affect the compilation time of the whole library :-(

If you have any ideas or a solution that would be great. I still hope it's possible to write it entirely in Go, but the weather is too nice to develop and debug all of this until it works ;-)

stevemcquaid, 2018-04-25:
I'd recommend doing what pyfirmata did and use a modified firmata sketch. The network latency is never going to be fast or stable enough to get any sort of accuracy for these sensors. the timing differential really needs to be done on the hardware itself.

I will make a PR to get these changed into firmata. Would someone be able to implement that firmata PulseIn/PulseOut method in gobot?
https://github.com/jgautier/arduino-1/commit/eb48b875db50b467b59f6cd0e0b741efbf1e6a97

Thread 363 (2017-02-06):

Data races in example

anisse, 2017-02-06:
I've seen a pattern used in this example:
https://github.com/hybridgroup/gobot/blob/3daa17dd99916c36bc29018d8f985da1e19321d6/examples/ardrone_ps3.go

Which is to use a variable to share the current state of sensor (here rightStick and leftStick). This is a data-race when you copy the variable. I've wrote a simple test that reproduces the same pattern:
```go
func TestEventerDataRace(t *testing.T) {
        var r int
        e := NewEventer()

        e.On("test", func(data interface{}) {
                r++
        })

        Every(10*time.Microsecond, func() {
                x := r // this should be a race
                t.Logf("%d ...", x)
        })
        for i := 0; i < 10000; i++ {
                e.Publish("test", true)
        }
}
```
Running this `go test -race  -run DataRace` detects the issue.

It would be better to communicate using channels instead of shared memory, or even use a mutex.

I haven't looked at all the examples, but it might be good to do a sweep to ensure this isn't a common pattern.

deadprogram, 2017-02-06:
That example, and a couple others, should probably be more like this:

https://gist.github.com/deadprogram/dfe1ebf67d0b64c542a10c4260983462

@anisse what do you think?

anisse, 2017-02-07:
@deadprogram this looks good, but you'd need to drain the channels to get the same functionality as before (use latest value). Something like this:
```go
func getLeftStick() {
	for {
		select {
		case leftStick.x = <-leftX:
		case leftStick.y = <-leftY:
		default:
			return
		}
	}
}
```
And even then, it is not enough, because since channels are blocking, the function called by the stick.On Eventer will block, and you won't have the latest value all the time.

Thinking more about this, the mutex is probably the easy way out. But I'd probably use the atomic package; it doesn't support directly using float64s, but you can convert them using the math package.

deadprogram, 2017-02-07:
That was my first implementation (muted), but then I tried channels. Just discovered atomic, interesting...

deadprogram, 2017-02-07:
Not "muted", "mutex". Autocorrect...

anisse, 2017-02-07:
Just discovered the abstract atomic.Value. Looks nice. I'd probably use it with the whole structure for the sake of simplicity, like this:
```go
var leftValue atomic.Value
var leftStick pair
leftStick = pair{x: 0, y: 0}
setLeftStick(leftStick)

func setLeftStick(l pair) {
	leftValue.Store(l)
}

func getLeftStick() pair {
	return leftValue.Load()
}
```
I'm not sure this is correct code though. Needs more testing.

deadprogram, 2017-02-07:
Due to how joystick sends data indepenently per axis per stick, in this case we cannot update both at the same time. But I agree this is a much nicer implementation using `sync/atoomic`.

Here is my take on this: https://gist.github.com/deadprogram/a103e6fe5868ef24c282e73bf472d9f7

anisse, 2017-02-07:
@deadprogram : I like your implementation. Simple and straightforward.

deadprogram, 2017-02-07:
@anisse I'm glad you brought up this issue. Going to do some testing, but I think this helps refine the pattern in a way that is much clearer as well as actually thread safe, not just "seems to work".

deadprogram, 2017-02-07:
@anisse I've just pushed a commit to the `dev` branch with these changes.

Going to close this issue now, please reopen if you think is needed.

Thank you again!

Closed 2017-02-07.

Thread 371 (2017-02-19):

UART Support

kevinjos, 2017-02-19:
Has thought been put into what gobot/drivers/uart/uart.go might look like? I have a UART sensor that I am considering to control with gobot.

Examples of prior work on go serial drivers include:
https://godoc.org/github.com/pkg/term
https://godoc.org/github.com/tarm/serial

deadprogram, 2017-02-21:
Hi @kevinjos

Which sensor are you thinking about?

We have a couple of platforms that already use serial connections. For example, Firmata (https://github.com/hybridgroup/gobot/blob/master/platforms/firmata/firmata_adaptor.go#L9), and also Sphero (https://github.com/hybridgroup/gobot/blob/master/platforms/sphero/sphero_adaptor.go#L8).

How we look at the architecture, is that an Adaptor that is part of a Gobot platform typically provide an interface that uses a platform-specific implementation. An example would be GPIO. Then Gobot drivers consume that interface.

Serial interfaces, on the other hand, are more like a transport than a protocol. The protocol is dependent on the device being communicated with. For example, a GPS sensor is not going to use a different serial interface, just a different port.

Anyhow, I hope that makes some sense. I'd like to know more about what you want to do, to better understand how to address your desired use case.

Thanks!

kevinjos, 2017-02-21:
Hi @deadprogram

Here are the serial devices that I am hooking up to a BeagleBone Black:

http://www.co2meter.com/products/k-30-co2-sensor-module
https://learn.sparkfun.com/tutorials/openscale-applications-and-hookup-guide

I agree that serial UART is a transport for sensor specific protocol. I am thinking about serial UART as similar to I2C and GPIO.. a ReadWriteCloser with transport specific configurations (baud rate, data bits, parity bits, stop bits, etc.).

deadprogram, 2017-05-13:
Hi, @kevinjos

I just switched several of the Gobot platforms that use serial communication over to use https://github.com/bugst/go-serial so this issue has returned to my attentions.

One thought, is to create an Adaptor to wrap around the serial communication, and then provide Drivers as needed. Those Drivers would not need necessarily to live inside of gobot/drivers/uart or gobot/drivers/serial or whatever one might wish to call it, although that also seems like a good place to put them.

Anyhow, what do you think?

kevinjos, 2017-05-15:
Hi @deadprogram,

Thanks for bumping this back up.

I like your idea to wrap github.com/bugst/go-serial and standardize interacting with serial devices on the Adaptor and Driver interface.

gen2thomas, 2024-11-05:
Fixed with [v2.4.0](https://github.com/hybridgroup/gobot/releases/tag/v2.4.0)

Closed 2024-11-05.

Thread 372 (2017-02-20):

I2C WriteBlockData not working as expected

owenwaller, 2017-02-20:
Hi,

As discussed in [this](https://groups.google.com/forum/#!topic/golang-nuts/0_cZNZ3vykM) thread on the golang-nuts list.

I am using GoBot v1.2 that has the rewritten i2c subsystem, to try to drive a [PiGlow](https://shop.pimoroni.com/products/piglow) (based on a SN3218 IC) connected to a Raspberry Pi 1.
The code is written using the "metal bot" style as I would like to reuse this as part of another project.

My sample code is available on the Go playground as:
[https://play.golang.org/p/Xma_6zBtT2](https://play.golang.org/p/Xma_6zBtT2)

When I run this code it shows no output. None of the error values are non-nil and led zero does not light on the PiGlow.

As far as I can tell I am communicating with the PiGlow over i2c correctly. My code is based on that of Toon Schoenmakers [code](https://github.com/schoentoon/piglow). This code is not based on the GoBot 12c subsystem. However. Toon's test code works correctly and drives the PiGlow as expected.

Can someone with more experience of GoBots i2c subsystem make a suggestion as to what I might be doing wrong, or if this is a new bug in the i2c subsystem on a RaspPi.

Thanks

Owen

erkkah, 2017-02-20:
Hi there.

A difference from Toon's code is that you do a "reset" and then return. I don't know how the PiGlow works, but it seems as you init everything, turn on a light, and then reset everything again before exiting. Don't know what "reset" does, but it's not used in Toon's example.

Possibly the default raspi bus in GoBot is not the same as bus 1 used in the other code. But you should have gotten errors then, I guess.

owenwaller, 2017-02-20:
Hi Erkkah,

Firstly, if I take out the reset behaviour (aka the call to PiGlow.Halt()) I see the same behaviour - i.e. nothing. So it's not the reset call that is the problem. Although you are correct that pointing it in does seem a bit pointless if I want the led to stay on.

Secondly there is only one i2c device on the Rasp Pi 1 and its at /dev/i2c-1.
If I print the result of Adaptor.GetDefaultBus() call as used in the Adaptor.GetConnection call it will return 1.
Toon's code also uses 1 as the i2c bus number.

In fairness, I do believe that on a Rasp Pi 2 and 3 the default i2c bus is in fact 0.

Owen

deadprogram, 2017-02-20:
Hi, everyone

I notice that the implementation being used by PiGlow calls to `WriteByte()` and `WriteByteBlock()` are basically does the equivalent of what Gobot is doing as `WriteByteData()` and `WriteBlockData()`.

At least one immediate difference I see, is that the implementation of `WriteByte()` is simply using the sysfs and not actually calling the SMBUS implementation:
https://bitbucket.org/gmcbay/i2c/src/1235f1776ee749f0eaeb6de69d8804a6dd70d9d5/i2c_bus.go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

Not sure if that is actually the issue here, but seems worth pointing out.

erkkah, 2017-02-20:
Interesting.
So I guess one test would be to use the Write method instead of WriteByteData to see if it works any better.

owenwaller, 2017-02-20:
Erkkahj,

I'm not 100% sure what you mean here but...

All the WriteXXX, ReadXXX, Write and Read calls in i2c.go are just wrappers around calls to

sysfs.I2cDevice.Write(byte) or sysfs.I2cDevice.Read()

The source is [here](https://github.com/hybridgroup/gobot/blob/master/drivers/i2c/i2c.go#L49)

Where as Toon's code bypasses sysfs entirely, and writes directly on the SMBUS. Which I think is Ron's point above.

erkkah, 2017-02-20:
Hi Owen,

I think it's the other way around, or something like it :)

The WriteXXX and ReadXXX calls in i2c call the corresponding methods in sysfs, which in turn are implemented using the SMBUS ioctl calls.

The Write and Read calls on the other hand use direct file IO (direct I2C).

The library used by Toon's code mixes, and uses SMBUS for the block call and file IO for the WriteByte call.

To test with as little differences as possible, you could try to replace your WriteByteData calls with Write calls.
That was all I meant.

owenwaller, 2017-02-20:
Erkkah,

Err exactly which type do you want me to call Write on? The Connection type?

Owen

owenwaller, 2017-02-20:
Ah ha!

Okay if I take Erkkah's suggestion and swap all of the WriteXXX calls to i2cDevice.Write calls then it works. I get exactly what I expect - no errors and lights in the PiGlow.

My updated code is here:
[https://play.golang.org/p/-zcc2ODfLZ](https://play.golang.org/p/-zcc2ODfLZ)
Which enables LED zero for 5 seconds before turning it off again.

So, if this is a direct write to the i2c bus then it works. But if the WriteXXX calls are via syscalls to the ioctl on the smbus then it doesn't.

So it looks like you syscalls aren't working as you expect. Which at least narrows down the problem.

Owen

deadprogram, 2017-02-21:
This is great work, thanks for looking into it!

One question: if you replace only the `WriteByteData()` with `Write()`, but left in the `WriteBlockData()` did that work? Trying to determine of all the syscalls were not working as expected, or only that one, since this is similar to what the gmcbay/i2c package does.

erkkah, 2017-02-21:
Yes, great find!

Really interesting if the device supports SMBUS block operations but not the `WriteByteData()` call.

owenwaller, 2017-02-21:
OK so I have just tried this.

In the Start() method if I swap out the 2nd call to Write()
```
// Start initiates the Driver
func (p *PiGlowDriver) Start() error {
	b := []byte{enableOutput, 0xFF}
	w, err := p.conn.Write(b)
	if err != nil {
		return err
	}
	if w != 2 {
		return errors.New("Start: Failed to write the enableOutput bytes")
	}

	b2 := []byte{enableLeds, 0xFF, 0xFF, 0xFF}
	w, err = p.conn.Write(b2)
	if err != nil {
		return err
	}
	if w != 4 {
		return errors.New("Start: Failed to write the enableLeds bytes")
	}
}
```
for a call to WriteBlockData() like this:
```
// Start initiates the Driver
func (p *PiGlowDriver) Start() error {
	b := []byte{enableOutput, 0xFF}
	w, err := p.conn.Write(b)
	if err != nil {
		return err
	}
	if w != 2 {
		return errors.New("Start: Failed to write the enableOutput bytes")
	}
	err = p.conn.WriteBlockData(enableLeds, []byte{0xFF, 0xFF, 0xFF})
	if err != nil {
		return err
	}

	return nil
}

```
It breaks the code. Nothing happens on the PiGlow after the change to WriteBlockData - no lights and no errors when the code runs.

So whatever is going on WriteBlockData() is broken.

Owen

owenwaller, 2017-02-21:
And just to confirm this.

If I swap a call to Write() for a call to WriteByteData() for the `enableOutut` byte at the start of the Start() method. And then replace the WriteDataBlock() with a Write() again for the `enableLeds` write in the above code everything still works.

So the combinations of:
Write() everywhere works ok
WriteByteData() and Write works ok
WriteByteData() and WriteBlockData() fails
Write() and WriteBlockData() fails

So the issue is defiantly under the call-stack of WriteBlockData.

Owen

deadprogram, 2017-02-22:
Thanks @owenwaller for helping track this down. I renamed the issue to better reflect what the problem seems to be here.

Also, please feel free to create a PR with your PIGlow driver, if you get a chance. We would probably however want it to accept a `Connector` instead of an already existing `Connection` as the param, which would break your own current code.

owenwaller, 2017-02-22:
NP. Once things are fixed I'd be happy to put together a PR for the PiGlow.

I'll open a new issue for it as I need some advice as how best to achieve that.

erkkah, 2017-02-22:
I found a difference between the i2c module used in Toon's code and the Gobot implementation in that that the prior always uses the PEC block transaction while Gobot always uses the non-PEC.
Added a possible fix in PR #378.

deadprogram, 2017-02-23:
@owenwaller if you get a chance to test this, it would be greatly appreciated.

owenwaller, 2017-02-23:
So pulling the request with:
```
git fetch origin pull/378/head:i2c-pec-fix
git checkout i2c-pec-fix
```
Then trying a quick a dirty test, by swapping the previous and working call to Write() to WriteBlockByte in the Start() method. So from this:
```
func (p *PiGlowDriver) Start() error {
	err := p.conn.WriteByteData(enableOutput, 0x01)
	if err != nil {
		return err
	}
	b2 := []byte{enableLeds, 0xFF, 0xFF, 0xFF}
	w, err := p.conn.Write(b2)
	if err != nil {
		return err
	}
	if w != 4 {
		return errors.New("Start: Failed to write the enableLeds bytes")
	}
	return nil
}

```
to this
```
func (p *PiGlowDriver) Start() error {
	err := p.conn.WriteByteData(enableOutput, 0x01)
	if err != nil {
		return err
	}
	err = p.conn.WriteBlockData(enableLeds, []byte{0xFF, 0xFF, 0xFF})
	if err != nil {
		return err
	}
	return nil
}
```
The code fails. There are no lights. The first version works, the later doesn't.
So WriteDataBlock() is still broken in the PR :(

Owen

erkkah, 2017-02-23:
Hi Owen, that's curious, thanks for trying it out.

Can you go directly to  `WriteBlockData` in `sysfs/i2c_device.go` and hard code it to use `I2C_SMBUS_BLOCK_DATA_PEC`?

With that, it should be the exact same code as in the other library, it would be interesting to figure out if it's the functionality check that fails or what it is.

/Erik

owenwaller, 2017-02-23:
Hi Erkkah,

Err, I can do but I'm not entirely sure what I'm supposed to change in `WriteBlockData` to enable this.
Can you paste in a diff of some sort and I'll make the change?

Owen

owenwaller, 2017-02-23:
Err but while I look in `sysfs/i2c.go` at the `WriteBlockData code, it looks like you are throwing away data, if the function is passed more than 32 bytes. We have this circa line 167...
```
	if len(data) > 32 {
		data = data[:32]
	}
```
Which is silently throwing away data. Why? And surely that should fail with an error - the input data byte slice was to large or something similar?
In my case I'm only ever passing in 19 bytes, so I'm not falling foul of this. But others might be.

Owen

erkkah, 2017-02-23:
Sure, change the WriteBlockData method to this: https://gist.github.com/erkkah/503607981df5c3ed2b74bbde61221a3a

The 32 byte limit comes from the SMBus standard. I agree I could document the 32 byte limiting better. I did not want to change the contract when I changed the implementation during refactoring, but I guess we should return an error for too large requests.

erkkah, 2017-02-24:
Looks like I made a mistake when importing constants from the c headers. Really confusing.
I have updated the PR,  but I need to get a device that behaves consistently with block transfers to test and really fix this.
Thanks again Owen for reporting and testing on your end.
/Erik

owenwaller, 2017-02-24:
Hi Erkkah,

Yeah, it works! And err, I need to eat some humble pie....

So what I have just tried is this:
```
git fetch origin pull/378/head:i2c-pec-fix
git checkout i2c-pec-fix
```
I am assuming this includes the updates to the PR.

If I then replace just the `Start()` method with the version [above](https://github.com/hybridgroup/gobot/issues/372#issuecomment-281978596) then I get what I expect. No errors and a light on the PiGlow.

At the minute this is the only `Write()` that I have replaced with a call to `WriteDataBlock()`.

Let me add calls to `WriteDataBlock` everywhere else to confirm things, but at the minute it looks like the PR is good and works. Adding the extra error when the data is truncated would be nice, as I didn't actually know there was a 32 byte limit on the data block size.

And now for my humble pie...

Erkkah, I feel I own you an apology. I suspect your PR, may have worked first if I'd have tested it correctly.
At some point I have done either `go get github.com/hybridgroup/gobot` or a `git clone https://github.com/hybridgroup/gobot ~/go/src/github.com/hybridgroup/`. So I'd shadowed the gobot tree under `~/go/src/github.com/hybridgroup/gobot`.

Then of course when I tested your PR I pulled your PR into the source tree rooted under `~/go/src/github.com/hybridgroup/gobot` which is the wrong source tree and err, not even being built. I only realised this when I added some trace lines into you PR and they didn't appear.

`go get` aliasing might be useful in terms of keeping a project canonical path consistent but it does rely on a very fallible human, like me, to remember _not_ to `go get` or `git clone` the root repository directly from github.

Apologies if I mislead you or Ron.

Owen

owenwaller, 2017-02-24:
Hi Erkkah,

Nope we are __still__ broken. Sorry. I can't write more than a single byte using `WriteDataBlock`.
As soon as I change the code that writes the 18 byte data block needed to turn on the leds I get no output (and no errors). If I replace that call with a `Write()` that writes the 18 bytes I need for the leds + one more for the command, everything works again.

As far as I can tell there are two separate issues going on. One I can fix the second I think is down to you.

In the code the call to `copy` is wrong. You had:
```
copy(buf[:1], data)
```
But that needs to be:
```
copy(buf[1:], data)
```
Copy copies min(len(dest), len(src)) bytes. In your code `buf[:1]` is a slice is one byte. So you only copy one byte, not the whole array.

My current version - with some tracing and error detection - looks like [this gist](https://gist.github.com/owenwaller/593cfb0193e41acecbce153845edf588)

As an example of what I am trying this output using the above gist should explain things:
```
Number of bytes copied: 18
len(data)=18
data:[]byte{0xff, 0x0, 0x0, 0x0, 0x0, 0x0, 0x0, 0x0, 0x0, 0x0, 0x0, 0x0, 0x0, 0x0, 0x0, 0x0, 0x0, 0x0}
len(buf)=19
buf:[]byte{0x12, 0xff, 0x0, 0x0, 0x0, 0x0, 0x0, 0x0, 0x0, 0x0, 0x0, 0x0, 0x0, 0x0, 0x0, 0x0, 0x0, 0x0, 0x0}
```
It looks like the call to `d.smbusAccess(...)` just isn't writing (all?) of the bytes.
Your gist, includes an undefined constant `I2C_SMBUS_BLOCK_DATA_PEC` which might fix things but I need the value to try it. :)

Owen

erkkah, 2017-02-24:
Hi Owen.

Great find that silly copy thing! Looks like we can share that humble pie :)
And - that shadowing thing can be really confusing. I mainly use vendoring, and have fooled myself a number of times. Thank you so much for continuing to investigate.

My confusion, and what I would like to understand better, is the different "size" argument options. I have seen a bit of contradictory information, but now trust the "latest" linux header files (/usr/include/linux/i2c.h).

I believe the constants I have in https://github.com/erkkah/gobot/blob/i2c-pec-fix/sysfs/i2c_device.go, should work, and that the `I2C_SMBUS_BLOCK_DATA` (value 5) you use in your gist is correct.

However, the I2C lib that Toon's code is using uses `I2C_SMBUS_I2C_BLOCK_DATA` (value 8).

If it turns out that the latter is more widely supported, we should probably move to that, and change the functionality check accordingly.

Your latest gist, does it work?

/Erik

erkkah, 2017-02-24:
BTW, that copy fix made both my devices "behave", accepting `I2C_SMBUS_BLOCK_DATA` writing just fine. Changing to `I2C_SMBUS_I2C_BLOCK_DATA` made one of the devices (TSL2561) fail.

/Erik

owenwaller, 2017-02-24:
Ah ha! I have success.

So my change is:
```
I2C_SMBUS_BLOCK_DATA       = 8 //5
```
i.e. from 5 to 8. If I rebuild everying (with my copy fix) it works. I get a light on the PiGlow and no errors.

On my Pi a `uname -r` returns `4.4.38+`

So yes, redefining I2C_SMBUS_BLOCK_DATA and using my gist means I have a working solution.
But what you seem to be saying is that the value of I2C_SMBUS_BLOCK_DATA is kernel version dependant. Is that correct?

Owen

erkkah, 2017-02-24:
Great news!

To answer your question - no, but I'll try to explain.

When entering this, I did what I use to do, and read the documentation. In this case, I went to https://www.kernel.org/doc/Documentation/i2c/dev-interface and https://www.kernel.org/doc/Documentation/i2c/smbus-protocol.

From there, I got the picture that `I2C_SMBUS_BLOCK_DATA` is to be preferred over `I2C_SMBUS_I2C_BLOCK_DATA`:
```
The following I2C block transactions are supported by the
SMBus layer and are described here for completeness.
They are *NOT* defined by the SMBus specification.
```

However, when I started to look into other I2C libraries, I found that they used the `I2C_SMBUS_BLOCK_DATA_PEC` constant (value 8) for block operations, which made me read up on PEC.

Now - the meaning of that constant seems to have changed with Linux versions, and PEC control is now a separate ioctl.

Don't know exactly when that changed, but it looks like a 2.X vs 4.X change. We should be safe with the values now in `/usr/include/linux/i2c.h`.

In addition to this confusion, different devices, as we now have shown, support different block operations. The PiGlow likes 8 but not 5, while the TSL2561 is the exact opposite. The DRV2605L supports both.

I'm starting to think that we should expose both, and document thoroughly.

@deadprogram, what do you think?

/Erik

owenwaller, 2017-02-24:
You mean have a

`WriteBlockData(...)`
and new
`WriteBlockI2CData(...)`

We could make `WriteBlockData(...)` take a `[32]byte` not a `[]byte`. That would both remove the if check, and fix the block length at a maximum. Which is what the protocol docs seem to suggest. That would be a breaking change though. `WriteBlockI2CData(...)` would still take a `[]byte`. But then the protocol docs aren't clear. As I read this:
```
I2C block transactions do not limit the number of bytes transferred
but the SMBus layer places a limit of 32 bytes.
```
You can send more than 32 bytes to the IC, but things will be chunked into 32 byte blocks. So should the implementation do this chunking for the programmer?
In this case the COMM "byte" can be multi-byte so presumably more than 32 bytes + whatever length of data it needs.

All of this would be fine with me. As a driver writer you'd then have to read the IC docs and take your best guess. If as I've found out, if one write call fails then you'd just have to try the other one.

Owen

deadprogram, 2017-02-25:
This is a great conversation here.

Regarding block operations, that might also be platform/kernal version based, not device based. @owenwaller you are on Raspi but @erkkah you are using CHIP, correct? Some platforms still work on older kernels right now, I'd rather not lose that.

I'd also rather continue to let Driver authors avoid knowing quite this much about the low level i2c implementations if they do not have to. The original naive sysfs implementation has the advantage of not having to know as much about what you are doing to get it to work as you expect.

On a side not, we should probably failover to the sysfs equivalent operation if the desired block operation is not available, so Drivers can "just work", but can use the new helper functions.

The current `WriteBlockData()` should probably continue to accept `[]byte` and then either return an error if over the limit, or automatically chunk the write. We should not make Driver authors have to deal with that themselves.

If for a particular Driver we need a specific block operation, and it is supported on the platform, we could use an optional config to set that, or something?

Anyhow those are a few of my thoughts. This is awesome.

erkkah, 2017-02-25:
In my case the support is device dependent, but might very well be platform dependent as well.
So, three dimensions of compatibility.. I'm starting to think that block operations are too complex to be worth supporting at this level. It seems as direct sysfs writes "always works" for block type writes.

Failover would be great, but in my case, would not work either. I never get any errors, the functionality checks seem to pass, yet it did not work.

If we keep `WriteBlockData()` I agree we should keep the `[]byte` interface. Passing a `[32]byte` would need a separate length argument for all cases where the intention is to write less than 32 bytes.

Why I started to work on this area in the first place was that I could not get word size reads to work on the TSL2561 using the original implementation. Then I tried to make the interface as close to the underlying system calls as possible, reusing the same operation names, et.c.

I think it's easier now to write correct driver code using the exposed Byte and Word methods, but the Block stuff so far has proven the opposite.

So, right now, I would suggest removing block operations, or adding separate methods for the two kinds.

deadprogram, 2017-02-25:
That probably makes sense, @erkkah

How about we leave in the `WriteBlockData()` interface, but just use it as a wrapper for a sysfs implementation for now. We can revisit the details on the "pure" SMBUS impl in the near future.

owenwaller, 2017-02-25:
@deadprogram. Yes, I am on using a Raspi 1 running a `4.4.38+` kernel on jessie.

`WriteBlockData` should not chunk It can only ever write 32 bytes max.. The SMBus spec seems to forbid chunking in this case. From the [spec ](https://www.kernel.org/doc/Documentation/i2c/smbus-protocol)
```
The opposite of the Block Read command, this writes _up to_ 32 bytes to
a device, to a designated register that is specified through the
Comm byte. The amount of data is specified in the Count byte.
```
If the data parameter remains as a `[]byte` then it should error if its passed more than 32 bytes.
The new `WriteBlockI2CData` that I'm suggesting has no max limit, but would instead write all the data out in 32 byte chunks automatically.

I would agree that the signature or `WriteBlockData` should not change. But nor should we delete/depreciate it in favour of just a `Read`/`Write` pair.

@erkkah one difference I have with the PiGlow is that its a write only device. You can't read the values of registers from the IC itself.

In terms of knowing which function to use. I've just checked the [PiGlow's datasheet](https://github.com/pimoroni/piglow/blob/master/datasheets/sn3218-datasheet.pdf) and it doesn't say anything about writing to the SMBus in  `I2C_SMBUS_BLOCK_DATA` vs. `I2C_SMBUS_I2C_BLOCK_DATA` mode. To paraphrase the data-sheet it just says "write bytes to this address to get things to happen". So from the data-sheet alone I'd have no way to know which one of `WriteBlockData` or `WriteBlockI2CData` to call. I'd just have to try both and find which one works.
Having thought about again it this it is not ideal. It makes my question my suggestion of a new `WriteBlockI2CData` method in the first place.

But I don't see a way to avoid it. The functions act differently in relation to chunking - as per the spec.

The only other option that I see, would be to replace the implementation of `WriteBlockData` (and maybe all the `WriteXXXX` methods) with simple call the the underlying `Write`. @deadprogam is this in effect way you are saying? But then do you error if you are passed more than 32 bytes? I'm not sure you can...

Is the flip-side of this decision that we'd be using userland access to the i2c device. Rather than off loading the work to the kernel side driver as the native SMBus ioctl's would do?

I am not sure there are any easy or clear cut decisions on this, other than that we can't break existing code that is out in the wild.

Owen

Owen

owenwaller, 2017-02-25:
@erkkah Thinking about this for 2 seconds more :).

Why don't you try the reverse of what I did. In your TSL2561 code, swap all of your `ReadXXX` calls for `Read` and similarly swap all of the `WriteXXX` calls for `Write`.

Does your device still work? Do you need to care if you write (or Read?) form the SMBus in `I2C_SMBUS_BLOCK_DATA` or `I2C_SMBUS_I2C_BLOCK_DATA`?

Owen

erkkah, 2017-02-27:
Hi @owenwaller, the reason I started to look into this in the first place was that I could not get the TSL2561 to work using simple Read/Write operations. :)

I like the suggestion from @deadprogram, to back off the smbus block operations until they are really needed, but keeping the `WriteBlockData()` as a convenience. However, I think we should remove `ReadBlockData()` for now since that is not easily implemented using `Read()`.

That would leave us with a less confusing, and more widely compatible I2C layer.

The `WriteBlockData()` implementation should still limit writes to 32 bytes. Don't think it will be a problem, since that is the expected behavior. If there is a need to write more, we are back in I2C (non-SMBus) land and plain `Write()` is the appropriate operation.

deadprogram, 2017-02-27:
This seems like a good plan. What needs to be done next?

erkkah, 2017-02-27:
I put together a version with the suggested changes in place, and added capabilities checks for all smbus operations: https://github.com/erkkah/gobot/commits/i2c-remove-smbusblock.

Had to extend `MockSyscall` to make tests pass, hope that was OK.

Take a look, if it seems to work, I can make it a PR.

owenwaller, 2017-02-27:
I'm not sure. But I need to check my facts first :)

So for the PiGlow, I'm calling
`(d *i2cDevice) WriteBlockData(reg uint8, data []byte) (err error)` in `sysfs/i2c_device.go`.
And that needs to write to the SMBus in `I2C_SMBUS_I2C_BLOCK_DATA` mode not `I2C_SMBUS_BLOCK_DATA` modes which is what the code v1.2 code currently does.

But just to confuse things there we also have this:
`func (c *i2cConnection) WriteBlockData(reg uint8, b []byte) (err error) `
in `drivers/i2c/ic2.go`. Which as far as I know I'm not calling at all...

So my first dumb question is:
Why do we have both of these? They appear to do the same things in different ways. Where are they different? Which one is the "SMBus" one and which one is the "ic2" one?

I actually have two bits of code at the minute. A really simple "light an led" program for the PiGlow. This is the code I'm be using to debug the  `(d *i2cDevice) WriteBlockData` problems. I'm using GoBot with @erkkah's patch when I build this code. This is the PiGlow code I'm been discussing so far.

But I also have a much larger bit of code that I plan to turn iinto the PiGlow driver got GoBot. That code is working well but it replaces `(d *i2cDevice) WriteBlockData` with this:
```
unc (p *PiGlowDriver) writeBlockData(address byte, values []byte) error {
	b := []byte{address}
	b = append(b, values...)
	w, err := p.conn.Write(b)
	if err != nil {
		return err
	}
	if w != len(b) {
		return fmt.Errorf("failed to write the expected number of bytes. Wrote %d but expected %d", w, len(b))
	}
	return nil
}
```
where `conn` is an `	i2c.Connection`.
This code has been completely reliable.

So why don't we just replace:
`(d *i2cDevice) WriteBlockData`with a similar `Write()` in a loop approach? This has the benefit of never needing to know which SMBus(?) write mode you should be in. If we want to clip this at 32 bytes then we can.

@erkkah at the minute I don't understand why `ReadDataBlock` (I assume from `i2cDevice`) can't be similarly implemented as a `Read` in a loop.

Thoughts?

Owen

owenwaller, 2017-02-27:
@erkkah So looking at the PR you have more of less done what I suggested in `WriteBlockData`. So that's fine. I believe the `Write()` I am calling maps down to you `d.file.Write()`. But correct me if I am wrong.

But looking at the `ReadBlockData` calls that you have removed it does look like it can be reimplemented as a `Read()` in a loop.

Owen

erkkah, 2017-02-27:
@owenwaller, the layer in `drivers/i2c` does two things, first it adds support for i2c on platforms that do not have sysfs, currently the firmata has it's own implementation. Second, it makes it possible to support several different i2c buses at the same time in a consistent manner.

In the sysfs case, it acts as a proxy on top of `sysfs/i2c_device.go`, so you are right that the interfaces are duplicated.

The general idea of the chosen set of methods is to make it easy to follow datasheets and preexisting example code. WriteBlockData happens to be part of the SMBus lingo, and is always limited to 32 bytes. For a pure SMBus device, it is not possible to use `Write()` with bigger blocks.

The challenge with implementing `ReadBlockData()` using `Read()` is to write the register/command byte to the device before reading. Some devices will accept setting the register/command by a single byte write before reading. If that is not accepted, `Read()` will always start from register 0, so even if you want to read from regs 5 to 15 you would have to read the first 5 and throw away the result.

Because of this, I think it is safe to leave `ReadBlockData()` out.

owenwaller, 2017-02-28:
@erkkah. OK two different implementations to access i2c for platforms with different capabilities. That makes sense.

If I follow this correctly. Then a Raspi has both implementations available. Yes?

If I need to use `I2C_SMBUS_I2C_BLOCK_DATA` to do a block write to the PiGlow. That would suggest it's not an SMBus compliant device. SMBus isn’t mentioned in the data sheet for the IC either.
Yes?

So, if `sysfs` exists on a platform, is it intended to support the full range of i2c or just the SMBus subset?

In terms of `ReadBlockData()` yes I see what you mean. I don't think its hard to implement. You'd always try the `Write()` to limit the data first. Then, depending on the failure of the write (or not) you'd know if you needed to throw away bytes from the following `Read()`. But it is yucky.

Owen

erkkah, 2017-02-28:
Hey, @owenwaller, I'm moving forward with the PR then, it should resolve this issue.
Regarding your questions, I really don't know :) There is a lot to read on the
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

Thread 374 (2017-02-20):

Firmata fails to start a connection with Arduino mega2560

matipan, 2017-02-20:
Hi!
I'm trying to run the [blinking example](https://gobot.io/documentation/platforms/arduino/) with an Arduino MEGA2560.
These are the steps I followed:
```
$ gort scan serial
/dev/cu.Bluetooth-Incoming-Port		/dev/tty.Bluetooth-Incoming-Port
/dev/cu.usbmodem1421			/dev/tty.usbmodem1421
```
So I changed the NewAdaptor to `firmata.NewAdaptor("/dev/tty.usbmodem1421")`.
Then `gort arduino install` and it installed `avrdude-6.3` successfully.
Now I run:
```
$ gort arduino upload firmata /dev/tty.usbmodem1421 -b mega2560
avrdude: AVR device initialized and ready to accept instructions

Reading | ################################################## | 100% 0.01s

avrdude: Device signature = 0x1e9801 (probably m2560)
avrdude: reading input file "/var/folders/2l/2x1l6t5530s25fzgvyfzdp_r0000gn/T/816739554"
avrdude: writing flash (12224 bytes):

Writing | ################################################## | 100% 1.97s

avrdude: 12224 bytes of flash written
avrdude: verifying flash memory against /var/folders/2l/2x1l6t5530s25fzgvyfzdp_r0000gn/T/816739554:
avrdude: load data flash data from input file /var/folders/2l/2x1l6t5530s25fzgvyfzdp_r0000gn/T/816739554:
avrdude: input file /var/folders/2l/2x1l6t5530s25fzgvyfzdp_r0000gn/T/816739554 contains 12224 bytes
avrdude: reading on-chip flash data:

Reading | ################################################## | 100% 1.57s

avrdude: verifying ...
avrdude: 12224 bytes of flash verified

avrdude done.  Thank you.
```
According to the output of that command, the firmata software was successfully loaded. So the only thing left to do is run the program:
```
$ go run main.go
2017/02/20 20:10:49 Initializing connections...
2017/02/20 20:10:49 Initializing connection Firmata-3BD25BC8D8022818 ...
2017/02/20 20:10:49 Initializing devices...
2017/02/20 20:10:49 Initializing device LED-4A0D0593775CB601 ...
2017/02/20 20:10:49 Robot bot initialized.
2017/02/20 20:10:49 Starting Robot bot ...
2017/02/20 20:10:49 Starting connections...
2017/02/20 20:10:49 Starting connection Firmata-3BD25BC8D8022818 on port /dev/tty.usbmodem1421...
```
And it just hangs there.

I tried debugging it, and I got [here](https://github.com/tarm/serial/blob/master/serial_posix.go#L180). For some reason, the program stays in that `Read` method forever.

I'm running **macOS Sierra 10.12.2** and **go version 1.8**

**PS**: I tried the blinking example from the Arduino IDE and it worked fine

deadprogram, 2017-02-21:
Hi @matipan thanks for the detailed report.

I personally do not have a MEGA2560 to test with, so a little hard to diagnose your problem.

Any way you can provide the call stack at the point where it hangs?

matipan, 2017-02-21:
Hi @deadprogram, thanks for the quick response!

Sure, this is the stack trace I could get:
```
panic: STACK TRACE

goroutine 1 [running]:
github.com/tarm/serial.(*Port).Read(0xc420080058, 0xc42006f482, 0x3, 0x3, 0x2, 0x4294960, 0x0)
	/Users/Matias/Code/GoWorkspace/src/github.com/tarm/serial/serial_posix.go:180 +0x64
io.ReadAtLeast(0x4504098, 0xc420080058, 0xc42006f482, 0x3, 0x3, 0x3, 0x41385e0, 0x4010700, 0x4504098)
	/usr/local/opt/go/libexec/src/io/io.go:307 +0xa9
io.ReadFull(0x4504098, 0xc420080058, 0xc42006f482, 0x3, 0x3, 0x3, 0x4031afe, 0xc4200001a0)
	/usr/local/opt/go/libexec/src/io/io.go:325 +0x58
gobot.io/x/gobot/platforms/firmata/client.(*Client).read(0xc4200b6280, 0x3, 0x4, 0xc42006f481, 0x1, 0x1, 0x0)
	/Users/Matias/Code/GoWorkspace/src/gobot.io/x/gobot/platforms/firmata/client/client.go:343 +0xbb
gobot.io/x/gobot/platforms/firmata/client.(*Client).process(0xc4200b6280, 0x0, 0x12)
	/Users/Matias/Code/GoWorkspace/src/gobot.io/x/gobot/platforms/firmata/client/client.go:348 +0x4c
gobot.io/x/gobot/platforms/firmata/client.(*Client).Connect(0xc4200b6280, 0x41f37e0, 0xc420080058, 0xc420080058, 0x0)
	/Users/Matias/Code/GoWorkspace/src/gobot.io/x/gobot/platforms/firmata/client/client.go:192 +0x3db
gobot.io/x/gobot/platforms/firmata.(*Adaptor).Connect(0xc4200b0240, 0x1, 0x1)
	/Users/Matias/Code/GoWorkspace/src/gobot.io/x/gobot/platforms/firmata/firmata_adaptor.go:83 +0x53
gobot.io/x/gobot.(*Connections).Start(0xc4200826c0, 0x3, 0x3)
	/Users/Matias/Code/GoWorkspace/src/gobot.io/x/gobot/connection.go:54 +0x293
gobot.io/x/gobot.(*Robot).Start(0xc4200b0300, 0x0, 0x0, 0x0, 0xc420084190, 0xc42006f200)
	/Users/Matias/Code/GoWorkspace/src/gobot.io/x/gobot/robot.go:151 +0x1a7
main.main()
	/Users/Matias/Code/GoWorkspace/src/github.com/kriox26/gobot/main.go:30 +0x33d
exit status 2
```
The problem is that this stack trace is not complete, this is right before it hangs. I don't know which `Read` method [this function](https://github.com/tarm/serial/blob/master/serial_posix.go#L180) uses, so I can't get inside that funcion and run panic there to get the real call stack.

Do you know how I can do that?

Thanks!

matipan, 2017-02-21:
So I created a Docker image with all the things I needed to run the program.
Then I executed:
```
docker run -it --privileged --device=/dev/tty.usbmodem1411:/dev/ttyS0 [image_id]
```
to run the program inside the container, and It gets stuck in the same point. So it's not a problem of Mac OS apparently

matipan, 2017-02-22:
Hi again! I tried running the exact same program on an Arduino UNO and it worked. So it's clearly an issue with the mega2560 in general or there is a problem with mine!

tampajohn, 2017-03-06:
I just tested blink with my mega2560 and all seems to work.  It certainly may be your board.  I'm running on OSX Sierra with go 1.7.3.

tampajohn, 2017-03-06:
Well that's weird, it worked once, and now no longer works.  Will try to see what's going on.

deadprogram, 2017-03-12:
Anyone find out more information on this?

matipan, 2017-03-14:
Hi there, no updates here. I don't know what else I can do though

rkjdid, 2017-04-07:
Just want to say that I have a 95% hang-at-connect problem with a Arduino Nano (I think v3.2) - just starting to tackle that but I'm under the impression that there's a problem either with locks or order of "Events" triggered (CapabilityQuery etc.)

So yeah basically the board never connects 95/100 times, I've seen it work 2 times so far...

rkjdid, 2017-04-07:
here's the stack with relevant routines - definitely a deadlock here :

```
goroutine 10 [running]:
main.main.func3()
        /home/rkj/go/src/github.com/solar3s/regenbox/goregen/main.go:52 +0x9e
created by main.main
        /home/rkj/go/src/github.com/solar3s/regenbox/goregen/main.go:53 +0x3a1

goroutine 1 [chan receive]:
main.main()
        /home/rkj/go/src/github.com/solar3s/regenbox/goregen/main.go:55 +0x3d7

goroutine 17 [syscall, locked to thread]:
runtime.goexit()
        /usr/local/go/src/runtime/asm_amd64.s:2197 +0x1

goroutine 5 [syscall]:
os/signal.signal_recv(0x0)
        /usr/local/go/src/runtime/sigqueue.go:116 +0x104
os/signal.loop()
        /usr/local/go/src/os/signal/signal_unix.go:22 +0x22
created by os/signal.init.1
        /usr/local/go/src/os/signal/signal_unix.go:28 +0x41

goroutine 6 [chan send]:
gobot.io/x/gobot.NewEventer.func1(0xc42000c8a0)
        /home/rkj/go/src/gobot.io/x/gobot/eventer.go:68 +0x115
created by gobot.io/x/gobot.NewEventer
        /home/rkj/go/src/gobot.io/x/gobot/eventer.go:73 +0x154

goroutine 7 [chan receive]:
gobot.io/x/gobot.NewEventer.func1(0xc42000c8c0)
        /home/rkj/go/src/gobot.io/x/gobot/eventer.go:65 +0x6c
created by gobot.io/x/gobot.NewEventer
        /home/rkj/go/src/gobot.io/x/gobot/eventer.go:73 +0x154

goroutine 8 [chan receive]:
gobot.io/x/gobot.NewEventer.func1(0xc42000c9c0)
        /home/rkj/go/src/gobot.io/x/gobot/eventer.go:65 +0x6c
created by gobot.io/x/gobot.NewEventer
        /home/rkj/go/src/gobot.io/x/gobot/eventer.go:73 +0x154

goroutine 9 [chan send]:
gobot.io/x/gobot.(*eventer).Publish(0xc42000c8a0, 0x55571c, 0xd, 0x520760, 0xc420011650)
        /home/rkj/go/src/gobot.io/x/gobot/eventer.go:102 +0xa3
gobot.io/x/gobot/platforms/firmata/client.(*Client).process(0xc4200a0140, 0x0, 0x0)
        /home/rkj/go/src/gobot.io/x/gobot/platforms/firmata/client/client.go:481 +0x655
gobot.io/x/gobot/platforms/firmata/client.(*Client).Connect(0xc4200a0140, 0x7f3a40, 0xc42000e078, 0xc42000e078, 0x0)
        /home/rkj/go/src/gobot.io/x/gobot/platforms/firmata/client/client.go:192 +0x3db
gobot.io/x/gobot/platforms/firmata.(*Adaptor).Connect(0xc42006e2a0, 0x1, 0x1)
        /home/rkj/go/src/gobot.io/x/gobot/platforms/firmata/firmata_adaptor.go:83 +0x53
gobot.io/x/gobot.(*Connections).Start(0xc42000c9e0, 0x3, 0x3)
        /home/rkj/go/src/gobot.io/x/gobot/connection.go:54 +0x293
gobot.io/x/gobot.(*Robot).Start(0xc42006e3c0, 0x0, 0x0, 0x0, 0x0, 0x0)
        /home/rkj/go/src/gobot.io/x/gobot/robot.go:151 +0x1a7
main.main.func2(0xc42006e3c0)
        /home/rkj/go/src/github.com/solar3s/regenbox/goregen/main.go:44 +0x4a
created by main.main
        /home/rkj/go/src/github.com/solar3s/regenbox/goregen/main.go:48 +0x389

goroutine 13 [semacquire]:
sync.runtime_SemacquireMutex(0xc42000c8bc)
        /usr/local/go/src/runtime/sema.go:62 +0x34
sync.(*Mutex).Lock(0xc42000c8b8)
        /usr/local/go/src/sync/mutex.go:87 +0x9d
gobot.io/x/gobot.(*eventer).Unsubscribe(0xc42000c8a0, 0xc42006e540)
        /home/rkj/go/src/gobot.io/x/gobot/eventer.go:116 +0x3a
gobot.io/x/gobot.(*eventer).Once.func1(0xc42006e540, 0x55571c, 0xd, 0xc420011470, 0xc42000c8a0)
        /home/rkj/go/src/gobot.io/x/gobot/eventer.go:146 +0xe9
created by gobot.io/x/gobot.(*eventer).Once
        /home/rkj/go/src/gobot.io/x/gobot/eventer.go:150 +0x79

goroutine 14 [chan receive]:
gobot.io/x/gobot.(*eventer).Once.func1(0xc42006e5a0, 0x555cec, 0xf, 0xc420011480, 0xc42000c8a0)
        /home/rkj/go/src/gobot.io/x/gobot/eventer.go:143 +0x4e
created by gobot.io/x/gobot.(*eventer).Once
        /home/rkj/go/src/gobot.io/x/gobot/eventer.go:150 +0x79

goroutine 15 [chan receive]:
gobot.io/x/gobot.(*eventer).Once.func1(0xc42006e600, 0x5567f0, 0x12, 0xc420011490, 0xc42000c8a0)
        /home/rkj/go/src/gobot.io/x/gobot/eventer.go:143 +0x4e
created by gobot.io/x/gobot.(*eventer).Once
        /home/rkj/go/src/gobot.io/x/gobot/eventer.go:150 +0x79
```

rkjdid, 2017-04-07:
this above solves it for me, probably not the way to do it though.

@matipan could you try it on your hardware?

deadprogram, 2017-04-07:
Hi @rkjdid to me that makes sense to increase the size of the one buffered channel, and to the make the other one buffered. It does not introduce any race conditions that are not already there, certainly.

I'd be happy to accept a PR with that change, if you wanted to submit one. :)

rkjdid, 2017-04-07:
gladly, let me get back to you soon

deadprogram, 2017-04-12:
The buffered channel code that seems to have addressed this has now been released as part of Gobot 1.4 so I am now closing this issue. Please reopen if needed. Thank you!

anweiss, 2017-04-28:
I'm currently seeing this issue using the latest release of Gobot. Running go 1.8.1 on macOS 10.12.4

emmeblm, 2017-08-02:
Hi! I'm having the exact same problem with Arduino Mega2560, the blinking example, MacOS Sierra 10.12.5 but instead of running gobot, I'm running Artoo. It just stops at:

I, [2017-08-01T19:48:42.463021 #22491]  INFO -- : Registering connection 'arduino'...
I, [2017-08-01T19:48:42.463138 #22491]  INFO -- : Registering device 'board'...
I, [2017-08-01T19:48:42.463169 #22491]  INFO -- : Registering device 'led'...
I, [2017-08-01T19:48:42.463193 #22491]  INFO -- : Preparing work...
I, [2017-08-01T19:48:42.463942 #22491]  INFO -- : Initializing artoo::connection arduino...
I, [2017-08-01T19:48:42.472186 #22491]  INFO -- : Initializing artoo::device board...
I, [2017-08-01T19:48:42.473928 #22491]  INFO -- : Initializing artoo::device led...
I, [2017-08-01T19:48:42.476191 #22491]  INFO -- : Starting work...
I, [2017-08-01T19:48:42.476433 #22491]  INFO -- : Connecting to 'arduino' on port '/dev/cu.usbmodem1421'...

Any updates on the possible problem? Maybe it's not something specific with gobot but shared with artoo.

emmeblm, 2017-08-02:
Hi everyone!

I'm having the exact same problem as the original one in this issue. I'm using an Arduino Mega 2560 with the blinking example.
The problem now is that instead of hanging out in the `Starting connection Firmata-7E113A8AAF4C13D2 on port /dev/cu.usbmodem1411...` line, some seconds later this error message appears:

```
2017/08/02 15:34:45 1 error occurred:

* unable to connect. Perhaps you need to flash your Arduino with Firmata?
```

But firmdata was sucessfully loaded in the Arduino.

I'm not able to run any gobot nor artoo program into my arduino. I checked the hardware loading the same blinking example in c with Arduino Ide and the hw works fine. It's definitely something with the firmdata platform creating the adaptor that's not able to communicate with Mega 2560.

For instance, when running:
`gort arduino upload firmata /dev/tty.usbmodem1411 -b mega2560`
you can see that the _-b mega2560_ option is needed (as it doesn't work when it is not specified). Only when sending this option in the gort command, it is able to sync with the arduino and load firmdata on it. The error that outputs when you just type _gort arduino upload firmata /dev/tty.usbmodem1411_ is the following:

```
avrdude: stk500_recv(): programmer is not responding
avrdude: stk500_getsync() attempt 1 of 10: not in sync: resp=0x00
avrdude: stk500_recv(): programmer is not responding
avrdude: stk500_getsync() attempt 2 of 10: not in sync: resp=0x00
avrdude: stk500_recv(): programmer is not responding
avrdude: stk500_getsync() attempt 3 of 10: not in sync: resp=0x00
avrdude: stk500_recv(): programmer is not responding
avrdude: stk500_getsync() attempt 4 of 10: not in sync: resp=0x00
avrdude: stk500_recv(): programmer is not responding
avrdude: stk500_getsync() attempt 5 of 10: not in sync: resp=0x00
avrdude: stk500_recv(): programmer is not responding
avrdude: stk500_getsync() attempt 6 of 10: not in sync: resp=0x00
avrdude: stk500_recv(): programmer is not responding
avrdude: stk500_getsync() attempt 7 of 10: not in sync: resp=0x00
avrdude: stk500_recv(): programmer is not responding
avrdude: stk500_getsync() attempt 8 of 10: not in sync: resp=0x00
avrdude: stk500_recv(): programmer is not responding
avrdude: stk500_getsync() attempt 9 of 10: not in sync: resp=0x00
avrdude: stk500_recv(): programmer is not responding
avrdude: stk500_getsync() attempt 10 of 10: not in sync: resp=0x00

avrdude done.  Thank you.

2017/08/02 17:27:55 exit status 1
```

I can just imagine that the same is happening at the firmdata adaptor level of gobot as the error that I see is printed on port communication timeout.

Can you help me?

Thanks!

deadprogram, 2017-08-03:
Hi @emmeblm I suspect that the problem lies in the specific firmware being loaded to the Mega. The version that is part of Gort is specific to the Uno and clones, and so even tho it might flash properly, it probably is not executing correctly.

One way to test this out is to try compiling and flashing Firmata onto the Mega directly from the Arduino IDE, and then try running the Gobot code.

My man @thoughtentity is working on some updates to Gort to allow for compiling and flashing with different boards, such as the mega. Also, I now have a Mega (somewhere) to test with.

I am going to reopen this issue, since it seems like it is still around.

emmeblm, 2017-08-03:
Hi @deadprogram, thanks for the answer.. I tried what you mentiones sadly with no success.. Uploaded firmata directly from Arduino Ide and still get the message:

```
2017/08/03 12:40:19 1 error occurred:
* unable to connect. Perhaps you need to flash your Arduino with Firmata?
```

when running go run blink_led.go. I still have the feeling that this problem lies at the firmata client level.

deadprogram, 2017-08-04:
I just tried flashing my Arduino Mega 2560 with the StandardFirmata sketch. I then ran the `firmata_blink.go` program with no problems:

```
$ go run examples/firmata_blink.go /dev/ttyACM0
2017/08/04 11:25:28 Initializing connections...
2017/08/04 11:25:28 Initializing connection Firmata-19F592BB979D619A ...
2017/08/04 11:25:28 Initializing devices...
2017/08/04 11:25:28 Initializing device LED-4AC7E7C7618A98B1 ...
2017/08/04 11:25:28 Robot bot initialized.
2017/08/04 11:25:28 Starting Robot bot ...
2017/08/04 11:25:28 Starting connections...
2017/08/04 11:25:28 Starting connection Firmata-19F592BB979D619A on port /dev/ttyACM0...
2017/08/04 11:25:31 Starting devices...
2017/08/04 11:25:31 Starting device LED-4AC7E7C7618A98B1 on pin 13...
2017/08/04 11:25:31 Starting work...
```

I did notice that I needed to exit the Arduino IDE before trying to run the Gobot program, possibly the Arduino IDE connected itself to the serial port for debugging?

Also which version of Arduino and StandardFirmata did you use to flash your board?

deadprogram, 2017-09-15:
Hello, there. Just checking in to see if there was any further info, I am not able to reproduce with the latest code.

allsputnik, 2017-11-08:
Hello, I also had a problem with Arduino Mega 2560.

`sudo ./gobot
2017/11/09 00:26:10 Initializing connections...
2017/11/09 00:26:10 Initializing connection Firmata-382E6917 ...
2017/11/09 00:26:10 Initializing devices...
2017/11/09 00:26:10 Initializing device LED-789CC02E ...
2017/11/09 00:26:10 Robot bot initialized.
2017/11/09 00:26:10 Starting Robot bot ...
2017/11/09 00:26:10 Starting connections...
2017/11/09 00:26:10 Starting connection Firmata-382E6917 on port /dev/ttyACM0...
2017/11/09 00:26:25 1 error occurred:

* unable to connect. Perhaps you need to flash your Arduino with Firmata?`

"I did notice that I needed to exit the Arduino IDE before trying to run the Gobot program, possibly the Arduino IDE connected itself to the serial port for debugging?" - Did not quite understand what you meant?
I ran both in the MAC OS and in the Raspberry Pi result is the same (

allsputnik, 2017-11-09:
Hello, now I tried to do the same with Arduino Uno
```
gort scan serial

1 serial port(s) found.

1. [/dev/ttyACM0] - [usb-Arduino__www.arduino.cc__0043_5543830343935101A1D0-if00]
  USB device:  Bus 001 Device 004: ID 2341:0043 Arduino SA Uno R3 (CDC ACM)

```

```
./gobotLinux
2017/11/09 09:15:55 Initializing connections...
2017/11/09 09:15:55 Initializing connection Firmata-BA337390F6407B4 ...
2017/11/09 09:15:55 Initializing devices...
2017/11/09 09:15:55 Initializing device LED-7B8343061C1A48E4 ...
2017/11/09 09:15:55 Robot bot initialized.
2017/11/09 09:15:55 Starting Robot bot ...
2017/11/09 09:15:55 Starting connections...
2017/11/09 09:15:55 Starting connection Firmata-BA337390F6407B4 on port /dev/ttyACM0...
2017/11/09 09:16:10 1 error occurred:

* unable to connect. Perhaps you need to flash your Arduino with Firmata?
```

deadprogram, 2017-11-12:
I've been doing a bunch of experiments with different boards, and have found some cases where when  partial data has been read from the board, the messages can get out of sync. Currently experimenting with some different fixes for additional robustness.

More very soon...

deadprogram, 2017-11-12:
The `dev` branch now includes this commit https://github.com/hybridgroup/gobot/commit/eb3b166158e8a3e0acb449bda54bf5c3d70603da which should better handle cases with extra out-of-sync data bytes.

I've just tested on a real Arduino Uno R3, a real Arduino 101, a clone Arduino Uno, and a clone Arduino Mega 2560, and they all were able to connect multiple times.

Next release of Gobot will include this update. In the meantime, any testing/feedback is appreciated.

deadprogram, 2017-12-21:
This code was released in v1.8.0 so now closing. Please reopen if needed. Thanks everyone!

gyldcs, 2018-11-16:
I am getting the same issue with esp8266 and gobot 1.12

akshitj1, 2019-06-23:
For future readers still encountering this error.
`gort arduino upload firmata /dev/tty.usbmodem1411 -b mega2560`
seems to flash correctly but blinking_led eg. doesn't runs and shows message:
`* unable to connect. Perhaps you need to flash your Arduino with Firmata?`

I instead uploaded Firmata Using arduino IDE and led eg. worked fine.
Quoting [doc](https://gobot.io/documentation/platforms/arduino/)
> Open arduino IDE and go to File > Examples > Firmata > StandardFirmata and open it. Select the appriate port for your arduino and click upload.

Closed 2017-12-21.

Thread 376 (2017-02-22):

Gobot hangs while finalizing connections with Firmata on OSX

matipan, 2017-02-22:
Hi there!
This happened to me wihle running [a simple go program](https://gist.github.com/matipan/af6f0c5a4fa826984267e070d62027bd) :
```
2017/02/22 11:01:13 Initializing connections...
2017/02/22 11:01:13 Initializing connection Firmata-72720CD878A08339 ...
2017/02/22 11:01:13 Initializing devices...
2017/02/22 11:01:13 Initializing device LED-3FA3E55721925098 ...
2017/02/22 11:01:13 Robot bot initialized.
2017/02/22 11:01:13 Starting Robot bot ...
2017/02/22 11:01:13 Starting connections...
2017/02/22 11:01:13 Starting connection Firmata-72720CD878A08339 on port /dev/tty.usbmodem1411...
2017/02/22 11:01:18 Starting devices...
2017/02/22 11:01:18 Starting device LED-3FA3E55721925098 on pin 13...
2017/02/22 11:01:18 Starting work...

2017/02/22 11:01:21 HELLO

2017/02/22 11:01:22 HELLO
^C2017/02/22 11:01:24 Stopping Robot bot ...

2017/02/22 11:01:25 HELLO

2017/02/22 11:01:25 HELLO

2017/02/22 11:01:25 HELLO
2017/02/22 11:01:36 HELLO
2017/02/22 11:01:36 HELLO
2017/02/22 11:01:37 HELLO
2017/02/22 11:01:38 HELLO
2017/02/22 11:01:39 HELLO
^C^C^C^C
2017/02/22 11:01:45 HELLO
```
The go program never stops(even when I repeatedly send the interruption signal), It keeps executing what is inside the work func.

I think the problem is inside the [Stop](https://github.com/hybridgroup/gobot/blob/master/robot.go#L196) function, when it tries to finalize all the connections, for some reason it never returns from that method.
Here is the stack trace:
```
panic: STACK TRACE

goroutine 1 [running]:
github.com/matipan/gobot/vendor/gobot.io/x/gobot.(*Robot).Stop(0xc4200b0300, 0xc4200b0540, 0x0)
	/Users/Matias/Code/GoWorkspace/src/github.com/matipan/gobot/vendor/gobot.io/x/gobot/robot.go:196 +0x19e
github.com/matipan/gobot/vendor/gobot.io/x/gobot.(*Robot).Start(0xc4200b0300, 0x0, 0x0, 0x0, 0xc420084190, 0x10)
	/Users/Matias/Code/GoWorkspace/src/github.com/matipan/gobot/vendor/gobot.io/x/gobot/robot.go:182 +0x335
main.main()
	/Users/Matias/Code/GoWorkspace/src/github.com/matipan/gobot/some.go:32 +0x378
exit status 2
```

I'm using an Arduino UNO but I think that is irrelevant

Thanks!

deadprogram, 2017-04-12:
The buffered channel code that seems to have addressed this has now been released as part of Gobot 1.4 so I am now closing this issue. Please reopen if needed. Thank you!

anweiss, 2017-04-28:
I'm currently seeing this issue using the latest release of Gobot. Running go 1.8.1 on macOS 10.12.4. Running simple program:

```go
package main

import (
	"time"

	"gobot.io/x/gobot"
	"gobot.io/x/gobot/drivers/gpio"
	"gobot.io/x/gobot/platforms/firmata"
)

func main() {
	firmataAdapter := firmata.NewAdaptor("/dev/tty.usbmodem1421")
	led := gpio.NewLedDriver(firmataAdapter, "8")

	work := func() {
		gobot.Every(1*time.Second, func() {
			led.Toggle()
		})
	}

	robot := gobot.NewRobot("bot",
		[]gobot.Connection{firmataAdapter},
		[]gobot.Device{led},
		work,
	)

	robot.Start()
}
```

deadprogram, 2017-05-13:
Hello, everyone

I'm made some changes to the https://github.com/hybridgroup/gobot/tree/dev branch to refactor the Firmata client/adaptor as well as switching to https://github.com/bugst/go-serial for all serial port communication.

This bug appears to be fixed from my testing on OSX El Capitan. If anyone else can confirm or deny that it is  working for them, it would be greatly appreciated.

Thanks!

deadprogram, 2017-06-15:
Version 1.6.0 is now out, and includes fixes for this. Now closing, please reopen if needed. Thank you!

Closed 2017-06-15.

Thread 377 (2017-02-22):

[PiGlow] How to write a driver?

owenwaller, 2017-02-22:
With regard to issue #372

I'm happy to put together a pull request for the PiGlow but I do need some advice on how best to go about this. It looks like the preferred way to do this might be a new "PiGlowDriver", rooted under the drivers/i2c tree.

However the process of writing a driver seems to be pretty much undocumented.
Could someone please walk me though the process, and explain the drivers architecture?

For example what's the Commander and Eventer and why do you seem to need both in the Config. What's the Config supposed to show etc.

I don't think any of this is very hard  code to write. I already have large parts of what would be required, but a little explanation would help at this stage.

Thanks

Owen

deadprogram, 2017-02-23:
This page exists https://gobot.io/documentation/guides/adding-hardware-support/ but needs a lot more information.

owenwaller, 2017-02-23:
Hi Ron,

Yes, I've seen that page but it doesn't really help :) I'm looking for an explanation of the drivers architecture and a set of steps to create a new driver.

Although all of the existing drivers seem to follow an similar style, it is not actually obvious - at least not to me at the minute :) - what you need to to to create a new driver.

Owen

deadprogram, 2017-02-23:
Actually, I was more pointing out that is the placeholder page for the needed explanation. Right now as you mention, it tells you very little.

owenwaller, 2017-02-27:
@deadprogram I think I am going to need a few hints on this in the coming days.

At the minute the test code I have that I plan to move into the driver can:
* light any single led in any spiral
* light a single arm/spiral, so that's all 6 leds in a arm
* light a single ring, so that's the same colour lit in each of the three spiral arms
* light any random pattern of leds
* fade up-down or down-up over a period any single led, spiral arm or ring
* throb so, that's fade up-down-up or down-up-down, over a period for any led, spiral arm or ring
* flash n times over a period for any led, spiral arm or ring
* Fade, throb, or flash any random pattern of leds
* Turn all of the leds off

Plus the usual `Start()`, `Halt()`, `GetName()` and `SetName()` functions.

Also far, as far as I can tell, the code is also go routine safe.  If a fade (for example) is called in one go routing to take place over 3 second, that driver will block and prevent any changes to the PiGlows leds until the fade has finished.

So, things are getting close to needing to refactor this into the GoBot driver plan.

Owen

owenwaller, 2017-04-19:
And finally... :)

I've got my skeletal PIGlow driver in a state that I can do an early preview off.
The code is in  my new [PiGlow repo](https://github.com/owenwaller/piglow).

Please see the README for details of the current state of play. The code is released under the same Apache 2 license as GoBot. You will need GoBot v1.3.0 or better to use this as the code relies on the fix to issue #372 to function correctly.

Can someone please help me out with converting this to a proper GoBot driver so that the rest of the GoBot community can make use of this. I would very much welcome pull requests for both this and general code review comments.

Once the driver is in the correct form I can start the process of adding it to the root GoBot tree.

In the meantime I need to create a proper set of `go test` style tests by converting the demo `piglow` program into something more test friendly.

Thanks

Owen

owenwaller, 2017-04-19:
Oops... I accidentally closed the issue. Re-opening it...

gen2thomas, 2023-06-04:
The CLI was removed and the documentation was updated. Currently there is a [known issue](https://github.com/hybridgroup/gobot/issues/920) with v2+ modules. For new driver/platform one of the latest driver/platform should be used as a blueprint.

gen2thomas, 2023-06-04:
Hi @owenwaller , if you still interested in to get your driver to be part of gobot, please open a PR and I will have a look on it.

Thanks Thomas

owenwaller, 2023-06-04:
@gen2thomas My PiGlow driver been dormant for a very long time, due to many other life related things getting in the way!

Yes, if no-one else has created a alternative driver in the past 6 years, you are welcome to use my source as a starting point. Last time I looked it was complete - which was when Go added module support.

If you need any help, I can find a Pi and a PiGlow and try rebuilding the source code. I've no idea what has changed in GoBot in the intervening period however.

NB. If you do need help I don't have the bandwidth until the middle if next week at the earliest..

Good luck

Owen

owenwaller, 2023-06-04:
@gen2thomas Sorry, I spoke to soon.

Looking at my code again, it was never a fork from gobot. I built it independently an used gobot. Also, contrary to what I have just said it's not module aware yet.

So, a better idea would be for you to fork my code, and get that into shape, so that:

a) It uses go modules
b) It uses the latest gobot
c) Split my code into a pair of cmd's one that drives the hw (see mainhw.go) and one for the sim (see mainsim.go) and then change the package of piglow.go away from main to "piglow".

and send me a PR.

We can then set about transforming my piglow.go to refactor it as a gobot driver.

Regards

Owen

gen2thomas, 2023-06-05:
Hi @owenwaller , thanks for your fast reply. I can not drive this topic forward, I could just support it. So I would close this issue for now if nobody has enough time for implementing the missing tests and transform it as driver for gobot.

Best regards, Thomas

Closed 2023-07-07.

Thread 383 (2017-03-02):

Broken link on website

BChip, 2017-03-02:
I went over to: https://gobot.io/documentation/platforms/digispark/

If you click on the API Reference button, it takes you to a broken link: https://godoc.org/gobot.io/x/gobot/platforms/digispark#DigisparkAdaptor

deadprogram, 2017-03-12:
Hi @BChip this commit to the docs site https://github.com/hybridgroup/gobot-site/commit/fa6d1f638a08dcfab668653cf5239b4052559c2b corrects this problem.

Thank you!

Closed 2017-03-12.

Thread 390 (2017-03-21):

gobot.io will not build with gcc7.0 (v1.8)

rgdaddio, 2017-03-21:
I have tested gobot.io Arduino example with GCC-7.0 (gccgo)and golang v1.8 and there are build errors due to the following known go issue:
https://github.com/golang/go/issues/15628

There are workarounds if gcc is required.

Builds fine with the standard compiler.

trex58, 2017-03-27:
Would you mind elaborate about how a workaround can be built ?

rgdaddio, 2017-03-27:
At least in the Gobot with Arduino case I tested, the file causing the build error is:

github.com/hashicorp/go-multierror/prefix.go

I don't believe this file is actually used with this architecture as the link completes without it. And so can probably be safely removed or commented out to build and run successfully.

I built and ran with GCC-7.0 and golang v1.8 with the gccgo option without the prefix.go file and had no issues in a very basic compile and run it test.

HTH,
Rich

trex58, 2017-03-28:
Thx.
However, I expected a generic patch, for any Go product with the 15628 issue.
I'll reread 15628 explanations.
Tony

rgdaddio, 2017-03-28:
It didn't seem like there were anything other than "dodgy" workarounds for issue in 15628 AFAICT. Not aware of any patches. This issue with gccgo has been around for almost a year.

The best current workaround for our project was to use the standard gc compiler which works fine and seems to have much more consistent support than gccgo at this point.

gccgo is not supported for golang v1.6 and golang v1.7. in the GCC-6.x releases (golang v1.5) series. Maybe there are patches I don't know.

GCC-7.0 does support golang v1.8. So that means that you cannot use GCC with current gobot.io unless you use the yet unreleased GCC-7.0,  since gobot.io no longer support anything below golang v1.7: https://github.com/hybridgroup/gobot/issues/387

HTH,

Rich

gen2thomas, 2022-10-19:
Seems to be closed and/or outdated., so I will going to close this issue.

Closed 2022-10-19.

Thread 398 (2017-03-29):

Gobot Bebop: Fatal Error Concurrent Map Writes

mccurdyc, 2017-03-29:
When trying to use the API and Bebop libraries, I get the following issue. Before trying this, I was just using http handler functions and received the same issue. I have also posted a minimal example. The commands DO work. I am able to takeoff and land, then the program crashes.

```
2017/03/29 14:50:17 Initializing API on :3000...
2017/03/29 14:50:17 Initializing connections...
2017/03/29 14:50:17 Initializing connection Bebop-361A1C107A69ECB7 ...
2017/03/29 14:50:17 Initializing devices...
2017/03/29 14:50:17 Initializing device Bebop-32188FCF05C4CB81 ...
2017/03/29 14:50:17 Robot drone initialized.
2017/03/29 14:50:17 Starting Robot drone ...
2017/03/29 14:50:17 Starting connections...
2017/03/29 14:50:17 Starting connection Bebop-361A1C107A69ECB7...
2017/03/29 14:50:17 WARNING: API using insecure connection. We recommend using an SSL certificate with Gobot.
2017/03/29 14:50:17 Starting devices...
2017/03/29 14:50:17 Starting device Bebop-32188FCF05C4CB81...
2017/03/29 14:50:17 Starting work...
fatal error: concurrent map writes

goroutine 11 [running]:
runtime.throw(0x7030e4, 0x15)
	/usr/lib/go/src/runtime/panic.go:596 +0x95 fp=0xc42003abf0 sp=0xc42003abd0
runtime.mapassign(0x6a99a0, 0xc420015590, 0xc42003acd9, 0xc4200b8af3)
	/usr/lib/go/src/runtime/hashmap.go:499 +0x667 fp=0xc42003ac90 sp=0xc42003abf0
gobot.io/x/gobot/platforms/parrot/bebop/client.networkFrameGenerator.func1(0xc42015a770, 0xc420150d02, 0x8)
	/home/mccurdyc/dev/gocode/src/gobot.io/x/gobot/platforms/parrot/bebop/client/client.go:127 +0xd9 fp=0xc42003ad20 sp=0xc42003ac90
gobot.io/x/gobot/platforms/parrot/bebop/client.(*Bebop).createARStreamACK(0xc4200d6000, 0x1c7, 0x0, 0x0, 0x1, 0xc42014a00c, 0x1971, 0x9ff4, 0x1971)
	/home/mccurdyc/dev/gocode/src/gobot.io/x/gobot/platforms/parrot/bebop/client/client.go:795 +0x703 fp=0xc42003ae18 sp=0xc42003ad20
gobot.io/x/gobot/platforms/parrot/bebop/client.(*Bebop).packetReceiver(0xc4200d6000, 0xc42014a000, 0x197d, 0xa000)
	/home/mccurdyc/dev/gocode/src/gobot.io/x/gobot/platforms/parrot/bebop/client/client.go:546 +0x227 fp=0xc42003af30 sp=0xc42003ae18
gobot.io/x/gobot/platforms/parrot/bebop/client.(*Bebop).Connect.func2(0xc4200d6000)
	/home/mccurdyc/dev/gocode/src/gobot.io/x/gobot/platforms/parrot/bebop/client/client.go:290 +0x19f fp=0xc42003afd8 sp=0xc42003af30
runtime.goexit()
	/usr/lib/go/src/runtime/asm_amd64.s:2197 +0x1 fp=0xc42003afe0 sp=0xc42003afd8
created by gobot.io/x/gobot/platforms/parrot/bebop/client.(*Bebop).Connect
	/home/mccurdyc/dev/gocode/src/gobot.io/x/gobot/platforms/parrot/bebop/client/client.go:292 +0x322

goroutine 1 [chan receive]:
gobot.io/x/gobot.(*Master).Start(0xc420016380, 0x6fe265, 0x4)
	/home/mccurdyc/dev/gocode/src/gobot.io/x/gobot/master.go:70 +0x118
main.main()
	/home/mccurdyc/allegheny/cs383s2017/cs383s2017-team1-lab6/main.go:47 +0x428

goroutine 17 [syscall, locked to thread]:
runtime.goexit()
	/usr/lib/go/src/runtime/asm_amd64.s:2197 +0x1

goroutine 5 [syscall]:
os/signal.signal_recv(0x0)
	/usr/lib/go/src/runtime/sigqueue.go:116 +0x104
os/signal.loop()
	/usr/lib/go/src/os/signal/signal_unix.go:22 +0x22
created by os/signal.init.1
	/usr/lib/go/src/os/signal/signal_unix.go:28 +0x41

goroutine 6 [chan receive]:
gobot.io/x/gobot.NewEventer.func1(0xc4200b86a0)
	/home/mccurdyc/dev/gocode/src/gobot.io/x/gobot/eventer.go:65 +0x6c
created by gobot.io/x/gobot.NewEventer
	/home/mccurdyc/dev/gocode/src/gobot.io/x/gobot/eventer.go:73 +0x154

goroutine 7 [chan receive]:
gobot.io/x/gobot.NewEventer.func1(0xc4200b86c0)
	/home/mccurdyc/dev/gocode/src/gobot.io/x/gobot/eventer.go:65 +0x6c
created by gobot.io/x/gobot.NewEventer
	/home/mccurdyc/dev/gocode/src/gobot.io/x/gobot/eventer.go:73 +0x154

goroutine 8 [IO wait]:
net.runtime_pollWait(0x7fbda2695f00, 0x72, 0x0)
	/usr/lib/go/src/runtime/netpoll.go:164 +0x59
net.(*pollDesc).wait(0xc420110068, 0x72, 0x0, 0xc420232000)
	/usr/lib/go/src/net/fd_poll_runtime.go:75 +0x38
net.(*pollDesc).waitRead(0xc420110068, 0xffffffffffffffff, 0x0)
	/usr/lib/go/src/net/fd_poll_runtime.go:80 +0x34
net.(*netFD).accept(0xc420110000, 0x0, 0x831800, 0xc420232000)
	/usr/lib/go/src/net/fd_unix.go:430 +0x1e5
net.(*TCPListener).accept(0xc420112000, 0xc420228120, 0x6a32c0, 0xffffffffffffffff)
	/usr/lib/go/src/net/tcpsock_posix.go:136 +0x2e
net.(*TCPListener).AcceptTCP(0xc420112000, 0xc420034e38, 0xc420034e40, 0xc420034e30)
	/usr/lib/go/src/net/tcpsock.go:215 +0x49
net/http.tcpKeepAliveListener.Accept(0xc420112000, 0x70fc70, 0xc4202280a0, 0x8358c0, 0xc42010e120)
	/usr/lib/go/src/net/http/server.go:3044 +0x2f
net/http.(*Server).Serve(0xc42010a000, 0x835440, 0xc420112000, 0x0, 0x0)
	/usr/lib/go/src/net/http/server.go:2643 +0x228
net/http.(*Server).ListenAndServe(0xc42010a000, 0xc42010a000, 0xc420102010)
	/usr/lib/go/src/net/http/server.go:2585 +0xb0
net/http.ListenAndServe(0xc420102010, 0x5, 0x0, 0x0, 0x1, 0x6fe11d)
	/usr/lib/go/src/net/http/server.go:2787 +0x7f
gobot.io/x/gobot/api.NewAPI.func1.1(0xc420054070)
	/home/mccurdyc/dev/gocode/src/gobot.io/x/gobot/api/api.go:45 +0x12c
created by gobot.io/x/gobot/api.NewAPI.func1
	/home/mccurdyc/dev/gocode/src/gobot.io/x/gobot/api/api.go:47 +0x178

goroutine 9 [chan receive]:
gobot.io/x/gobot.NewEventer.func1(0xc4200b8880)
	/home/mccurdyc/dev/gocode/src/gobot.io/x/gobot/eventer.go:65 +0x6c
created by gobot.io/x/gobot.NewEventer
	/home/mccurdyc/dev/gocode/src/gobot.io/x/gobot/eventer.go:73 +0x154

goroutine 10 [runnable]:
syscall.Syscall(0x1, 0x3, 0xc420110480, 0x14, 0x14, 0x14, 0x0)
	/usr/lib/go/src/syscall/asm_linux_amd64.s:18 +0x5
syscall.write(0x3, 0xc420110480, 0x14, 0x40, 0x77, 0x0, 0x0)
	/usr/lib/go/src/syscall/zsyscall_linux_amd64.go:1064 +0x55
syscall.Write(0x3, 0xc420110480, 0x14, 0x40, 0x17, 0x3, 0x0)
	/usr/lib/go/src/syscall/syscall_unix.go:181 +0x49
net.(*netFD).Write(0xc420054230, 0xc420110480, 0x14, 0x40, 0x0, 0x0, 0x0)
	/usr/lib/go/src/net/fd_unix.go:332 +0x15e
net.(*conn).Write(0xc42000e090, 0xc420110480, 0x14, 0x40, 0x14, 0x0, 0x0)
	/usr/lib/go/src/net/net.go:193 +0x70
gobot.io/x/gobot/platforms/parrot/bebop/client.(*Bebop).Connect.func1(0xc4200d6000)
	/home/mccurdyc/dev/gocode/src/gobot.io/x/gobot/platforms/parrot/bebop/client/client.go:274 +0x9c
created by gobot.io/x/gobot/platforms/parrot/bebop/client.(*Bebop).Connect
	/home/mccurdyc/dev/gocode/src/gobot.io/x/gobot/platforms/parrot/bebop/client/client.go:280 +0x2fd

goroutine 12 [sleep]:
time.Sleep(0x17d7840)
	/usr/lib/go/src/runtime/time.go:59 +0xf9
gobot.io/x/gobot/platforms/parrot/bebop/client.(*Bebop).Connect.func3(0xc4200d6000)
	/home/mccurdyc/dev/gocode/src/gobot.io/x/gobot/platforms/parrot/bebop/client/client.go:303 +0xb4
created by gobot.io/x/gobot/platforms/parrot/bebop/client.(*Bebop).Connect
	/home/mccurdyc/dev/gocode/src/gobot.io/x/gobot/platforms/parrot/bebop/client/client.go:305 +0x347

goroutine 18 [chan receive]:
gobot.io/x/gobot.(*Robot).Start.func2(0xc420060480)
	/home/mccurdyc/dev/gocode/src/gobot.io/x/gobot/robot.go:166 +0x52
created by gobot.io/x/gobot.(*Robot).Start
	/home/mccurdyc/dev/gocode/src/gobot.io/x/gobot/robot.go:167 +0x291

goroutine 19 [select, locked to thread]:
runtime.gopark(0x7101c8, 0x0, 0x6fe84f, 0x6, 0x18, 0x2)
	/usr/lib/go/src/runtime/proc.go:271 +0x13a
runtime.selectgoImpl(0xc420039f50, 0x0, 0x18)
	/usr/lib/go/src/runtime/select.go:423 +0x1364
runtime.selectgo(0xc420039f50)
	/usr/lib/go/src/runtime/select.go:238 +0x1c
runtime.ensureSigM.func1()
	/usr/lib/go/src/runtime/signal_unix.go:434 +0x2dd
runtime.goexit()
	/usr/lib/go/src/runtime/asm_amd64.s:2197 +0x1

goroutine 50 [IO wait]:
net.runtime_pollWait(0x7fbda2695cc0, 0x72, 0x7)
	/usr/lib/go/src/runtime/netpoll.go:164 +0x59
net.(*pollDesc).wait(0xc42015ac38, 0x72, 0x8329c0, 0x82f538)
	/usr/lib/go/src/net/fd_poll_runtime.go:75 +0x38
net.(*pollDesc).waitRead(0xc42015ac38, 0xc4201b8000, 0x1000)
	/usr/lib/go/src/net/fd_poll_runtime.go:80 +0x34
net.(*netFD).Read(0xc42015abd0, 0xc4201b8000, 0x1000, 0x1000, 0x0, 0x8329c0, 0x82f538)
	/usr/lib/go/src/net/fd_unix.go:250 +0x1b7
net.(*conn).Read(0xc420112008, 0xc4201b8000, 0x1000, 0x1000, 0x0, 0x0, 0x0)
	/usr/lib/go/src/net/net.go:181 +0x70
net/http.(*connReader).Read(0xc4200169c0, 0xc4201b8000, 0x1000, 0x1000, 0x0, 0xc4201c5bb0, 0x55d538)
	/usr/lib/go/src/net/http/server.go:754 +0x140
bufio.(*Reader).fill(0xc420106060)
	/usr/lib/go/src/bufio/bufio.go:97 +0x117
bufio.(*Reader).Peek(0xc420106060, 0x4, 0x0, 0x0, 0x0, 0x0, 0xc4201c5c10)
	/usr/lib/go/src/bufio/bufio.go:129 +0x67
net/http.(*conn).readRequest(0xc420084640, 0x835800, 0xc420016980, 0x0, 0x0, 0x0)
	/usr/lib/go/src/net/http/server.go:931 +0xe91
net/http.(*conn).serve(0xc420084640, 0x835800, 0xc420016980)
	/usr/lib/go/src/net/http/server.go:1763 +0x49a
created by net/http.(*Server).Serve
	/usr/lib/go/src/net/http/server.go:2668 +0x2ce
exit status 2
```

```
package main

import (
	"fmt"

	"gobot.io/x/gobot"
	"gobot.io/x/gobot/api"
	"gobot.io/x/gobot/platforms/parrot/bebop"
)

func main() {
	// bebop drone
	bebopAdaptor := bebop.NewAdaptor()
	drone := bebop.NewDriver(bebopAdaptor)

	// Starts the API server on default port 3000
	gbot := gobot.NewMaster()
	api.NewAPI(gbot).Start()

	// Accessible via http://localhost:3000/api/commands/say_hello
	gbot.AddCommand("say_hello", func(params map[string]interface{}) interface{} {
		return "Master says hello!"
	})

	d := gbot.AddRobot(gobot.NewRobot("drone",
		[]gobot.Connection{bebopAdaptor},
		[]gobot.Device{drone},
	))

	// Accessible via http://localhost:3000/robots/Eve/commands/say_hello
	d.AddCommand("say_hello", func(params map[string]interface{}) interface{} {
		return fmt.Sprintf("%v says hello!", d.Name)
	})

	d.AddCommand("takeoff", func(params map[string]interface{}) interface{} {
		drone.TakeOff()
		return 0
	})

	d.AddCommand("land", func(params map[string]interface{}) interface{} {
		drone.Land()
		return 0
	})
	gbot.Start()
}
```

mccurdyc, 2017-03-29:
Here is information about my Go version: `go version go1.8 linux/amd64`
And system information: `4.9.11-1-ARCH x86_64 GNU/Linux`
Wireless chip: `04:00.0 Network controller: Intel Corporation Wireless 8260 (rev 3a)`

Let me know if there is any additional information that would help you! Thank you in advance!

losinggeneration, 2017-07-15:
@mccurdyc After GopherCon would you be able to give my branch a try?

mccurdyc, 2017-07-15:
@losinggeneration I would love to, but I don't have access to the drone anymore. It was a course I was taking in school.

losinggeneration, 2017-07-16:
I talked with @deadprogram and he said he has some, it's just a matter of digging them out and trying it out.

matiasinsaurralde, 2017-08-31:
I'm having the same issue, also I'm not able to get the video when using Bebop 2, any idea?

gen2thomas, 2024-11-05:
Fixed with [v2.4.0](https://github.com/hybridgroup/gobot/releases/tag/v2.4.0)

Closed 2024-11-05.

Thread 399 (2017-03-29):

Raspberry Pi 3 Completely Unresponsive

SafaiWeb, 2017-03-29:
I'm sorry if there is something I am not seeing in here, I'm really trying to use this framework and any help would be appreciated:

I have had issues with this for days using a RP3 and the newest version of Raspbian.

I copy/pasted the program from the platform page at https://gobot.io/documentation/platforms/raspi/.

I set up the circuit exactly as shown in the led light diagram.

The program compiled without errors on MacOSX (cross-compiled with GOARM=7 GOARCH=arm GOOS=linux).

When I run the program from the Pi (transferred with a USB drive), I get no response. I do have to use chmod to execute the program.

I tested the circuit against one of the power pins, and the LED lights up.

But, when used with the GPIO pins, I can't get so much as a flicker.

Any suggestions or am I just going crazy?

deadprogram, 2017-03-30:
Hello, @SafaiWeb perhaps you can upload a photo of your exact setup, in particular your circuit.

SafaiWeb, 2017-03-30:
Thank you so much, I feel like it has to be something very silly on my part:

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

deadprogram, 2017-03-30:
Looks like the LED is reversed in that photo. The flat side should be GND (negative). Normally I use a black wire to indicate ground, and use colors for pins. I reserve red for power.

Hope that helps!

SafaiWeb, 2017-03-30:
I have tried it in both directions just to be sure :(

deadprogram, 2017-03-30:
It will only work in one direction, that is for sure! :) Flat means GND.

deadprogram, 2017-03-30:
Also, looks like you are using a 1K ohm resistor. You might want to try 270 ohm instead.

SafaiWeb, 2017-04-01:
Have now tried a different resistor.  Have tried a different RP3.  No response.

Took circuit and switched to an arduino UNO. Followed instructions, used Gort. Uploaded Firmata, copy-pasted led blinking program.  No response.  The only discernable difference between the arduino and the RP3 is that when I execute the compiled program for the RP3 the terminal says "starting work..." before not responding, whereas with the arduino it says "starting connection firmata...on port...." before giving me a new command prompt and also not responding.

I'm as lost as a lamb in a snowstorm as to what could be wrong.

SafaiWeb, 2017-04-01:
I also attached a PIR Motion Sensor to both the PI and the Arduino with the hopes of printing a line on the screen when motion was detected.  The Pi gave no response to either motion or lack of motion.

The Arduino returns a new command prompt, so there was no way to print to the terminal.

Given the strange behavior of lights, and inability of motion sensing technology to detect me, current working theory is that I am a vampire.

deadprogram, 2017-04-01:
Hi @SafaiWeb I'm not exactly sure what you mean by "The Arduino returns a new command prompt, so there was no way to print to the terminal."

Perhaps bringing in both an Arduino and other sensors into the mix might be clouding your original issue, as opposed to clearing it. Not sure on that, perhaps it is helping establish a baseline.

In any case, a few more basic questions:
- What version of OS X are you using on your desktop machine?
- What version of Golang do you have installed?
- How exactly did you load Fimata onto your Arduino?
- Which Arduino model are you using?
- What is the command line you are using to run the firmata_blink.go program?

SafaiWeb, 2017-04-01:
I wasn't sure if it was helpful to change up the hardware or not. I thought there might be a potential defect in my actual pi, but it seems my issue is not there.

1. MacOS Sierra. I have also tried using an Ubuntu 14.04 installation on a separate computer.
2. I am using Golang 1.8. Installed via the binary on the Go project webpage on the mac. Installed via gvm on tge ubuntu machine
3. I uploaded with gort using the "gort arduino upload firmata /dev/ttyACM0". As this is the default address I also tried it once without the /dev/ttyACM0. This was the address given by gort scan serial. I really like Gort, by the way.
4. Arduino UNO R3.
5. Go run firmata_blink.go

deadprogram, 2017-04-01:
If you are running the firmata_blink.go from your OSX machine to the connected Arduino, you would need to change up the serial interface name here https://github.com/hybridgroup/gobot/blob/master/examples/firmata_blink.go#L16 to match the name of whatever serial port your Arduino is mapped to on OS X.

SafaiWeb, 2017-04-01:
I am running it on my Ubuntu machine, gort scan serial gives me the address [/dev/ttyACM0] as the address for my arduino.

deadprogram, 2017-04-01:
Ubuntu happens to be my own preferred desktop OS. Perhaps permissions related? Try building, and then execute your program using sudo.

deadprogram, 2017-04-01:
You probably will need to run your code on the raspi using sudo as well, unless you have added udev rules to give yourself whatever needed permissions to read/write to GPIO.

deadprogram, 2017-04-01:
OK so I have a solution now thanks to a tip from @fivdi to ensure that the GPIO exports have correctly happened before trying to use the GPIO pins. This addresses the issue when running as a normal user.

The code is now in the `dev` branch @SafaiWeb if you want to try it out on your raspi. I will leave this issue open until this code has made it into the next release.

Thanks you @SafaiWeb for pointing this problem out.

trevrosen, 2017-04-07:
@deadprogram just chiming in to say I think this export check is a great idea and something that has bitten me in the past, so I'm excited to see it land on mainline.

deadprogram, 2017-04-12:
This code has now been released as part of Gobot 1.4 so I am now closing this issue. Please reopen if needed. Thank you everyone!

Closed 2017-04-12.

Thread 401 (2017-04-01):

importing firmata causes a `signal: killed`

matipan, 2017-04-01:
Hi there, I have an issue that appeared a few days ago. The import `gobot.io/x/gobot/platforms/firmata` causes a `signal: killed` when trying to run a simple program.

This is how I verified it was that import:
```go
package main

import (
	"log"

	_ "gobot.io/x/gobot"
	_ "gobot.io/x/gobot/drivers/gpio"
	_ "gobot.io/x/gobot/platforms/firmata"
)

func main() {
	log.Println("hello")
}
```
When you do a `go run main.go` to that file, it prints a `signal: killed`
Now, if we run this program:
```go
package main

import (
	"log"

	_ "gobot.io/x/gobot"
	_ "gobot.io/x/gobot/drivers/gpio"
	// _ "gobot.io/x/gobot/platforms/firmata"
)

func main() {
	log.Println("hello")
}
```
It logs as I expected `hello`.

So there seems to be an issue with the `firmata` import. Any idea what it could be?

go version:`go version go1.8 darwin/amd64`
I'm on macOS

deadprogram, 2017-04-01:
Hmm, @matipan only thing I could find on this error is https://forum.golangbridge.org/t/go-build-exits-with-signal-killed/513

deadprogram, 2017-04-01:
OK seems like an open issue possibly https://github.com/golang/go/issues/19734

matipan, 2017-04-02:
Ok, thanks for pointing out that issue. It seems to be a problem with Xcode 8.3. I checked the update logs and the day this started to happen is the day Xcode got updated.

So, for anybody that reads this issue, a quick workaround is to build the program using the `-ldflags` and `-s` flags. There seems to be with an issue with how the linker in Darwin invokes dsymutil. The `-s` flag disables that invocation.

Another workaround is going back to Xcode 8.2

According to what is being discussed they will try to have it fix for go 1.8.1, but there are no guarantees.

As always, thanks for the quick response @deadprogram!

Closed 2017-04-02.

Thread 404 (2017-04-07):

Microbit OSX signal:killed

willis7, 2017-04-07:
I can't seem to get the ubit to work with gobot. I did the firmware install with gort:

```
gort microbit download
gort microbit install /Volumes/MICROBIT
```

but when I run (with the example):

`GODEBUG=cgocheck=0 go run main.go "BBC micro:bit [tupov]"`

I get `signal: killed`.

I used LightBlue to discover the Bluetooth name on the mac, but the ubit isn't doing anything.

Happy to make a PR with doc updates if I can fix it.

deadprogram, 2017-04-08:
Hi @willis7 I think your problem is probably the same as https://github.com/hybridgroup/gobot/issues/401

willis7, 2017-04-09:
Thanks for getting back to me. If I add the flags as suggested then the application gets a little further, but there's still no output on the device:

```
wills7:pomodoro-bit/ $ GODEBUG=cgocheck=0 go run -ldflags -s main.go "BBC micro:bit [tupov]"                                                                                                                                                                         [17:05:00]
2017/04/09 17:05:07 Initializing connections...
2017/04/09 17:05:07 Initializing connection BLEClient-666C9345B9D5A4E4 ...
2017/04/09 17:05:07 Initializing devices...
2017/04/09 17:05:07 Initializing device Microbit LED-583534B99F62E730 ...
2017/04/09 17:05:07 Robot blinkBot initialized.
2017/04/09 17:05:07 Starting Robot blinkBot ...
2017/04/09 17:05:07 Starting connections...
2017/04/09 17:05:07 Starting connection BLEClient-666C9345B9D5A4E4...
2017/04/09 17:05:10 Starting devices...
2017/04/09 17:05:10 Starting device Microbit LED-583534B99F62E730...
2017/04/09 17:05:10 Starting work...
```

deadprogram, 2017-04-10:
Hi @willis7 try connecting by ID instead of name, that might help you out.

deadprogram, 2017-04-10:
This might sound silly, but did you rotate the Microbit in a circle first after flashing the firmware, but before trying to connect?

Step 4 from here:
https://github.com/sandeepmistry/node-bbc-microbit#flashing-microbit-firmware

We absolutely need to add this to the Gobot docs.

deadprogram, 2017-04-12:
The docs have now been updated. @willis7 did that solve your problem?

willis7, 2017-04-12:
Hi @deadprogram,

I stupidly took the ubit into work and haven't been able to test it. I will test it tomorrow and get back to you.

If it helps I had actually performed the calibration step. I haven't tried connecting by ID, so I shall give that a go.

deadprogram, 2017-04-27:
Hi @willis7 any update on testing this? Thanks!

willis7, 2017-05-02:
Apologies for the delay.

I had performed the rotation and got the smiley face.

I tried using the UUID of the device, but it didn't even reach the `Starting work...` line in the logs.

Are there any restrictions on versions? I'm fairly certain I had one of the pre-release devices.

deadprogram, 2017-05-03:
No restrictions I am aware of. That said, I do almost all of my work on Linux.

The `ble` package that Gobot uses is different for Linux vs. OSX, in that the OSX code uses the Mac's API. I will need to setup to do some further testing.

willis7, 2017-05-03:
Is there anything I can do my end to support the debugging?

Thread 405 (2017-04-08):

Robot.AutoRun feature and Robot.done chan

rkjdid, 2017-04-08:
Hello, I think there is a bad implementation out of a proper intention, around robot.done chan and AutoRun feature.

First question I had was around this line : https://github.com/hybridgroup/gobot/blob/dev/robot.go#L196
I like using channels for the idea of notifying a work is done, but to me this is a case where channel needs to be closed. So anybody waiting on this can exit, not only one guy.

Further inquiries showed me that the only place that I can see where the channel actually read, is right here, https://github.com/hybridgroup/gobot/blob/dev/robot.go#L196 - which makes no apparent sense to me - I think this is a bug, maybe the idea behind is would be instead to notify Work() has returned - notifying AutoRun block, that it can safely exit since work is over. (nothing more is to be done)

So yeah, this train of thoughts lead to the 2 patches here: https://github.com/solar3s/gobot/commits/autorun  - let me know if you find it relevant

On a side note, I will be working (if I manage to organize my time correctly) on a small Arduino project for a little while, nothing too fancy but there is data to be collected etc. so yeah I want to be up here with go, it's easier for me, so this project seems the obvious choice. I can see there is work to be done though, are there concrete directions to contribute, a roadmap or something you guys want help on?

This kind of stuff I like, channels sync and race funniness.. Not an expert at all but I've been doing a fair amount of it last year on bittorrent stuff in go (see taipei-torrent which was our base fork)

Cheers,
Romain

deadprogram, 2017-04-08:
Hi @rkjdid thanks for your thoughts.

The idea, perhaps not well expressed, is that in most cases, what you want is for your Gobot code to run indefinately, letting the various goroutines that have been started up by `On()` and `Once()` event handlers run awaiting their events. We called this `Autorun == true` although in retrospect that was not a good naming. Perhaps it would be better to call it `TrapInterrupts`? In any case, this is supposed to run until the user interrrupts the program with a Ctrl-C.

In the case of a program that is supposed to just do some Work, and exit afterwards, the condition is supposed to be `Autorun == false`. Since this is not my own personal usual use case, it has not received the kind of attentions the first case has.

Regarding the implementation of Work being done, etc. it would be much better to switch to using `context`, since we have already stated the intentions of only supporting Golang 1.7+ for all active Gobot development. I agree that we need to way for Work itself to notify any calling goroutine that the Work is done. However, in the "Autorun" case, the Work is never done, it just gets started, and runs until interrupted.

I really like this conversation and seeing your ideas. What do you think of the above?

deadprogram, 2017-04-28:
Hi @rkjdid not sure if you saw my response. What do you think?

rkjdid, 2017-04-28:
Hey @deadprogram, I wanted to give a proper answer but I've been a swamped mofo these last weeks..

I agree with you, the use-case of no Autorun makes sense, and the trap makes sense too. What troubled me is that Work() routine which has litteraly no way of ever doing any more "work", waiting on a chan receive - taking into account the debugging purpose of seeing your routine running makes sense, but I would argue that it can be achieved better with a simple log.Print("work done"), although that might be opinionated.

What I didn't take into account are the event handlers, thus calling bot.Stop() is probably not the way to go I agree with that.

I would really like diving more into the project, unfortunately I've had to switch to a more handcrafted / simplistic communication protocol, since I had an inconsist uint value using firmata adapter when reading on an analog pin, and since I have very little time on this side project I didn't dive in the debugging of that and opted for the simple approach, for now.

rkjdid, 2017-04-28:
for the record the project lies here: https://github.com/solar3s/goregen - is just starting and is about regeneration of standard alcaline batteries : https://regenbox.org/

deadprogram, 2017-04-28:
Thanks for the response @rkjdid if you could provide any details about any problem you encountered with the Firmata adaptor that would be greatly appreciated.

https://github.com/bugst/go-serial looks like a good package, might switch over to that since it has a few cool features such as enumerating serial ports.

rkjdid, 2017-04-28:
yeah that's why I opted for it, but I have no clue who's doing the best underlying implementation, you might want to use only the port-discover feature and keep whatever serial lib you're using.

Currently I'm trying to get a proper way of keeping touch with the serial connection throughout savage disconnects/reconnects, not trivial at all!

rkjdid, 2017-04-28:
I will try to reproduce/illustrate my analog test-case, and get back to you

gm42, 2019-05-27:
It would be nice if the control flow was manageable or at least inspectable externally, this would allow to coordinate with other channels/contexts.

Thread 411 (2017-04-22):

How to stop a robot

triberraar, 2017-04-22:
I am using gobot to lean go, so please don't judge my code too harshly.
I am using gobot togheter with a sphero and want do do some simple things, right now just flashing some colors. My code looks like this:
```
package main

import (
	"bufio"
	"fmt"
	"log"
	"os"
	"strings"
	"time"

	"gobot.io/x/gobot"
	"gobot.io/x/gobot/platforms/sphero"
)

type color struct {
	r uint8
	g uint8
	b uint8
}

func main() {
	reader := bufio.NewReader(os.Stdin)
	fmt.Print("Enter the sphero port: ")
	spheroPort, _ := reader.ReadString('\n')
	// spheroPort = "/dev/tty.Sphero-GRY-AMP-SPP"
	spheroPort = strings.TrimSpace(spheroPort)

	adaptor := sphero.NewAdaptor(spheroPort)
	driver := sphero.NewSpheroDriver(adaptor)

	go goSphero(driver, adaptor)
}

func goSphero(driver *sphero.SpheroDriver, adaptor *sphero.Adaptor) {
	red := color{255, 0, 0}
	green := color{0, 255, 0}
	blue := color{0, 0, 255}
	yellow := color{255, 255, 0}
	work := func() {
		fmt.Print("Colors used are: ")
		fmt.Print("Red")
		driver.SetRGB(red.r, red.g, red.b)
		time.Sleep(1000 * time.Millisecond)
		fmt.Print("Green")
		driver.SetRGB(green.r, green.g, green.b)
		time.Sleep(1000 * time.Millisecond)
		fmt.Print("Blue")
		driver.SetRGB(blue.r, blue.g, blue.b)
		time.Sleep(1000 * time.Millisecond)
		fmt.Print("Yellow")
		driver.SetRGB(yellow.r, yellow.g, yellow.b)
		time.Sleep(1000 * time.Millisecond)
		// would like to disconnect from the robot or stop the program
	}

	robot := gobot.NewRobot("sphero",
		[]gobot.Connection{adaptor},
		[]gobot.Device{driver},
		work,
	)

	error := robot.Start()
	if error != nil {
		fmt.Print("something went horribly wrong")
		log.Fatal(error)
	}
}
```

Where i have the comment i would like the program to end or to disconnect from the robot. I tried inserting driver.Stop() at several places, but it didn't help me. Can you help me with what I am missing?

Eventually i would like to write a webservice where you can post a color and the sphero will flash in this color. I am a bit confused that you want a robot to do has to be in the work function. So any help with that is also appreciated.

deadprogram, 2017-04-28:
Hi @triberraar if what you want to do is immediately terminate your Gobot program after running, instead of continuing to run and await commands and events, you can pass `false` to the `Start()` method, which turns off the "autorun" feature.

For example:

```go
package main

import (
	"fmt"
	"time"

	"gobot.io/x/gobot"
	"gobot.io/x/gobot/platforms/sphero"
)

func main() {
	adaptor := sphero.NewAdaptor("/dev/rfcomm0")
	spheroDriver := sphero.NewSpheroDriver(adaptor)

	work := func() {
		r := uint8(gobot.Rand(255))
		g := uint8(gobot.Rand(255))
		b := uint8(gobot.Rand(255))
		spheroDriver.SetRGB(r, g, b)
	}

	robot := gobot.NewRobot("sphero",
		[]gobot.Connection{adaptor},
		[]gobot.Device{spheroDriver},
		work,
	)

	robot.Start(false)
}
```

Notice that when the program disconnects from the Sphero, the Sphero will turn off once the Bluetooth connection is broken. This is the behavior of the Sphero's firmware, not something specific to Gobot.

Hope that helps!

gm42, 2019-05-27:
I would be interested in an example for graceful termination e.g. upon SIGTERM or SIGINT, expect the robot to terminate gracefully and exit.

I could not find an (exposed) channel or context to implement such pattern. I have read in another comment (#405) about this and I agree with those conclusions.

peteut, 2020-04-17:
If a robot is used with `systemd`, `KillSignal=SIGINT` must be set, as robot looks for `os.Interrupt`.

Thread 416 (2017-05-05):

GPIO Interrupt Support

pauleyj, 2017-05-05:
Any thoughts or plans on supporting GPIO interrupts?

larsth, 2017-05-12:
Epoll is your friend:

https://godoc.org/syscall#EpollCreate
https://godoc.org/syscall#EpollCreate1
https://godoc.org/syscall#EpollCtl
https://godoc.org/syscall#EpollWait

epoll(7) man page: http://man7.org/linux/man-pages/man7/epoll.7.html
epoll(2) man page: https://linux.die.net/man/4/epoll

Use EPOLLET mode / flag when using EpollCreate, EpollCreate1

mikegleasonjr, 2017-10-22:
So should we implement this in userland and not user specific drivers?

deadprogram, 2017-10-22:
Hi everyone. Somehow I previously missed @larsth comment when it was originally made. Yes, epoll would be a great solution. Seems like by adding some wrapper code to the Gobot sysfs package, getting to work on any Linux such as Raspi, Beaglebone Black, etc. would be straightforward.

@larsth if there is a kernel module that blocks the interrupt, that probably means a kernel driver that is already using it, and so it would be best for Gobot to leave it alone, right? What is the correct way to handle this?

@mikegleasonjr yes, that seems like the most likely pattern for a Gobot implementation. I personally avoid adding kernel modules unless absolutely needed for some special purpose.

larsth, 2017-10-23:
> @larsth if there is a kernel module that blocks the interrupt, that probably means a kernel driver that is already using it, and so it would be best for Gobot to leave it alone, right?

Yes

> What is the correct way to handle this?

The only thing that can be done is to remove the module from the kernel:
`sudo rmmod >name of the offending kernel module goes here<`

What happens after that command shows whether or not removing the module from the kernel was a good idea, however, I think it would be safe to remove the module, because the user of Gobot is probably doing something else with the GPIO pins.

Controlling a piece of hardware with only one GPIO pin at a time is highly undesirable because context switches creates long delays.
If only there was a GPIO kernel module with poll syscall support it would be great, but I don't have any time anytime soon to create such a module. The 2 times earlier that I had made a character device module was very fun. It was 9 years ago.

BTW,
It is fun to watch that after fx a shell command like this:
`echo 1 > /dev/my_character_device_file`
... there continues to be action, because inertia prevents anything to happen instantly.

gen2thomas, 2023-05-15:
part of release v2.0.0

Closed 2023-05-15.

Thread 420 (2017-05-14):

firmata: analog pin number to digital mapping is not always +14

1lann, 2017-05-14:
In `firamta_adaptor.go` line 221: https://github.com/hybridgroup/gobot/blob/51f6aba47c369d95e395fca722d91ea48037ecda/platforms/firmata/firmata_adaptor.go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

The digital mapping for analog pins is hard coded as `+ 14`, however, this is not always true for some boards. For example, on the Arduino Yún, it's `+ 18`. This should be documented and/or changed to allow people to specify offset, have a database of boards, or somehow detect the correct offset value.

deadprogram, 2017-11-16:
Hello @1lann was finally looking into this, and I see that actually the `Client` is doing a `AnalogMapping` query, and so obtains the actual pin mappings for any board on initial connection.

The problem is that the Adaptor is not using this information, instead using the "hard wired" value as you pointed out. I have not had a chance to actually work on the code, but https://github.com/hybridgroup/gobot/blob/master/platforms/firmata/client/client.go#L450 is where the values are populated. The https://github.com/hybridgroup/gobot/blob/master/platforms/firmata/firmata_adaptor.go#L239 function should probably be renamed to `analogPinLookup()` and the implementation use the f.Board.Pins() to lookup the actual mapping.

Hopefully this makes sense. I will try to get to working in the next weeks on an improvement to handle this case, but if someone else wanted to write a PR to handle this, it would be greatly appreciated!

Thread 421 (2017-05-18):

Stuck at starting connection (with Firmata)

conejoninja, 2017-05-18:
I'm trying to connect to an Arduino Uno with Standard Firmata running on it, tried 3 different USB-cables and two different USB ports. Debian Jesie and user is on dialout group if that helps.

This issue happens _most of the time_, but not always. It just hangs at

```
➜  examples go run examplebot.go       
2017/05/18 09:39:17 Initializing connections...
2017/05/18 09:39:17 Initializing connection Firmata-5721E10BB1A30F02 ...
2017/05/18 09:39:17 Initializing devices...
2017/05/18 09:39:17 Initializing device LED-77F786BE130713F4 ...
2017/05/18 09:39:17 Robot sensorBot initialized.
2017/05/18 09:39:17 Starting Robot sensorBot ...
2017/05/18 09:39:17 Starting connections...
2017/05/18 09:39:17 Starting connection Firmata-5721E10BB1A30F02 on port /dev/ttyUSB0...
```

And that's it, it stays there, nothing more.

More information, I'm working on a _driver_ for a sensor, maybe the code crash or exits without closing properly the connection to /dev/ttyUSB0  (as an idea). But If I disconnect/re-connect the arduino, the problem is still there. Arduino IDE is able to flash the board without any problem, it only happens with gobot's code. Also, once it start happening, no matter what I run (my code, or gobot's examples), it's stuck there.

Probably it's a configuration issue of my setup, but not sure how to identify what is wrong

deadprogram, 2017-05-18:
The easy way to establish if it is permissions related, is to run your program under sudo.

If it runs correctly, it is permissions related. If not, it is something else.

Please give that a try.

Also, from where did you obtain your Firmata? Try using the Firmata that is uploaded using Gort (http://gort.io/) it was created using ConfigurableFirmata and includes all the needed capabilities.

conejoninja, 2017-05-18:
Same results with sudo and chmod the file, sometime it works, sometime it doesn't.
I tried with both, installing firmata from gort and from the IDE.

I will try with a different board, in case something is wrong with this one, since it works at times, it may be the problem. I'm running out of ideas.

deadprogram, 2017-05-18:
Did you try switching to the `dev` branch of Gobot? There are some important Firmata/serial related changes in that branch.

conejoninja, 2017-05-18:
Yes, I'm using dev branch, last commit 4e05c7f2c60604ae6f67ac4ae8f69378f6616d32

Even if this is a hardware problem, I think there could be some timeout, or at least some verbose option, that will help sort this out.

conejoninja, 2017-05-18:
I close this issue, I used a different board and so far so good, no problems for now. Looked like a hardware problem.

half2me, 2017-05-23:
I have the same problem with Arduino UNO and OSX 10.12.4
```
2017/05/23 15:51:22 Initializing connections...
2017/05/23 15:51:22 Initializing connection Firmata-A283223A5671633 ...
2017/05/23 15:51:22 Initializing devices...
2017/05/23 15:51:22 Initializing device LED-62505DE4731EE1DF ...
2017/05/23 15:51:22 Robot bot initialized.
2017/05/23 15:51:22 Starting Robot bot ...
2017/05/23 15:51:22 Starting connections...
2017/05/23 15:51:22 Starting connection Firmata-A283223A5671633 on port /dev/cu.usbmodem1421...
```

deadprogram, 2017-05-23:
Hi @half2me did you try the `dev` branch as I had suggested?

half2me, 2017-05-23:
@deadprogram I'm just starting to learn go, so I'm not sure how I would go about doing that :)

conejoninja, 2017-05-23:
@half2me go to your GOPATH/src/gobot.io/x/gobot/  and there just change the git branch with

```bash
git checkout dev && git pull origin dev

```

deadprogram, 2017-05-24:
We will release an update with these fixes once we have confirmation from someone else that this issue and https://github.com/hybridgroup/gobot/issues/376 have been addressed in the `dev` branch.

We've tested on OSX El Capitan, just need testing on some more recent OSX versions.

half2me, 2017-05-24:
@deadprogram  @conejoninja I just tested with dev branch... same problem :(

deadprogram, 2017-05-24:
@half2me did you flash the Arduino with Firmata first?

half2me, 2017-05-25:
@deadprogram nope :/ I didn't know I had to do that, didn't see it documented anywhere...

deadprogram, 2017-05-25:
https://gobot.io/documentation/platforms/arduino/ first paragraph in "How to install" documents this.

deadprogram, 2017-05-26:
@half2me I added some code to the `firmata.Connect()` to some ideas that have emerged from this issue. The new code is much cleaner, and provides a new `ConnectTimeout` field that defaults to 15 seconds.

In the case that Gobot is unable to connect, the updated Firmata "blink" example will display any connection errors: https://github.com/hybridgroup/gobot/blob/dev/examples/firmata_blink.go#L32

Also, the error displayed in the case of a timeout, suggests flashing Firmata on your Arduino, for people who might not realize that requirement.

I am going to reopen this issue until the new code makes it into a Gobot release. In the meantime, anyone who can test the `dev` branch, your feedback in appreciated.

conejoninja, 2017-05-26:
Nice, I can confirm the timeout is working properly, much better than before. In my case, it was a faulty hardware issue, that sometimes worked, sometimes not.

half2me, 2017-05-26:
@deadprogram Awesome work, thank you! I will test the dev branch as much as possible and report any bugs I might find. 👍

JDogHerman, 2017-06-14:
Seems to be working for me also, The dev branch let me know I was having a permissions error. After running ```ln -s /usr/local/go/bin/go /usr/bin/go``` I was able to run ```sudo go run blink.go``` without issue.

deadprogram, 2017-06-15:
Version 1.6.0 is now out, and includes all these fixes. Now closing, please reopen if needed. Thank you everyone!

Closed 2017-06-15.

Thread 424 (2017-05-29):

Humidity is disabled in the BME280 I2C driver because of a missing write operation

ssorc, 2017-05-29:
Calling the `Humidity()` function on the `BME280Driver` I2C driver results in the error: "Humidity disabled".

This is because the `initHumidity()` function is incomplete; it writes out the humidity data acquisition options, but doesn't then write to the "ctrl_meas" register, as per Section 5.4.3 of the BME280 data sheet:

> The “ctrl_hum” register sets the humidity data acquisition options of the device. Changes to
> this register only become effective after a write operation to “ctrl_meas”.

I have a patch so can generate a pull request if someone else can confirm that this is the case! I have tested this on a Raspberry Pi Model B using the Sparkfun BME280 Atmospheric Sensor Breakout with gobot 1.5.0 and golang 1.7.5.

deadprogram, 2017-05-30:
Hi @ssorc thanks for the report. I will setup to test this issue shortly and get back to you.

deadprogram, 2017-05-30:
Hi @ssorc yes, I can confirm that error is being returned.

Interestingly, restarting the program causes the readings to come thru correctly on subsequent runs.

In any case, your PR to address this would be appreciated. Thank you!

ssorc, 2017-05-30:
The restart may work because when the call to `d.initialization()` in `Start()` is writing to the `ctrl_meas` register (see the `bmp280RegisterControl` register in the BPM280 driver's `initialization()` function) and this may be enough to finally enable the humidity sensor.

I will send through a PR: it's only a couple of lines.

ssorc, 2017-05-31:
I've submitted the PR.

deadprogram, 2017-06-15:
Version 1.6.0 is now out, and includes this fix. Now closing, thanks again @ssorc for this!

Closed 2017-06-15.

Thread 429 (2017-06-14):

Having issues installing firmata platform features into Win10 system

JDogHerman, 2017-06-14:
I am attemting to install the firmata features following the steps listed [here](https://gobot.io/documentation/platforms/arduino/) and I am getting an error about not enough arguments.

```
go get -d -u gobot.io/x/gobot/... && go install gobot.io/x/gobot/platforms/firmata
# gobot.io/x/gobot/sysfs
go\src\gobot.io\x\gobot\sysfs\i2c_device.go:88: undefined: syscall.SYS_IOCTL
go\src\gobot.io\x\gobot\sysfs\i2c_device.go:102: undefined: syscall.SYS_IOCTL
go\src\gobot.io\x\gobot\sysfs\i2c_device.go:219: undefined: syscall.SYS_IOCTL
go\src\gobot.io\x\gobot\sysfs\syscall.go:34: not enough arguments in call to syscall.Syscall
        have (uintptr, uintptr, uintptr, uintptr)
        want (uintptr, uintptr, uintptr, uintptr, uintptr)
```
The issue seems to be with the 2nd command ``go install`` as the ``go get`` command run alone does not show an error. My version of windows is Windows 10 Pro v1607 Build 14393.1198

deadprogram, 2017-06-14:
All you need is the:

```
go get -d -u gobot.io/x/gobot/...
```

Docs were already updated here, just awaiting the next release: https://github.com/hybridgroup/gobot/blob/dev/platforms/firmata/README.md#how-to-install

Thanks for the report.

deadprogram, 2017-06-15:
Version 1.6.0 is now out, and includes documentation fixes for this. Now closing, please reopen if needed. Thank you!

miko-code, 2017-07-05:
IM having the same issue on win 10  i did the go get as you can see.

but I'm receiving the same error as above

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

GO  GET
> C:\WINDOWS\system32>go get -v -d -u gobot.io/x/gobot/...
Fetching https://gobot.io/x/gobot?go-get=1
Parsing meta tags from https://gobot.io/x/gobot?go-get=1 (status code 200)
get "gobot.io/x/gobot": found meta tag main.metaImport{Prefix:"gobot.io/x/gobot", VCS:"git", RepoRoot:"https://github.com/hybridgroup/gobot"} at https://gobot.io/x/gobot?go-get=1
gobot.io/x/gobot (download)
github.com/hashicorp/go-multierror (download)
Fetching https://gobot.io/x/gobot/api?go-get=1
Parsing meta tags from https://gobot.io/x/gobot/api?go-get=1 (status code 404)
github.com/bmizerany/pat (download)
Fetching https://gobot.io/x/gobot/api/robeaux?go-get=1
Parsing meta tags from https://gobot.io/x/gobot/api/robeaux?go-get=1 (status code 404)
Fetching https://gobot.io/x/gobot/cli?go-get=1
Parsing meta tags from https://gobot.io/x/gobot/cli?go-get=1 (status code 404)
github.com/codegangsta/cli (download)
Fetching https://gobot.io/x/gobot/drivers/aio?go-get=1
Parsing meta tags from https://gobot.io/x/gobot/drivers/aio?go-get=1 (status code 200)
get "gobot.io/x/gobot/drivers/aio": found meta tag main.metaImport{Prefix:"gobot.io/x/gobot", VCS:"git", RepoRoot:"https://github.com/hybridgroup/gobot"} at https://gobot.io/x/gobot/drivers/aio?go-get=1
get "gobot.io/x/gobot/drivers/aio": verifying non-authoritative meta tag
Fetching https://gobot.io/x/gobot?go-get=1
Parsing meta tags from https://gobot.io/x/gobot?go-get=1 (status code 200)
Fetching https://gobot.io/x/gobot/drivers/gpio?go-get=1
Parsing meta tags from https://gobot.io/x/gobot/drivers/gpio?go-get=1 (status code 200)
get "gobot.io/x/gobot/drivers/gpio": found meta tag main.metaImport{Prefix:"gobot.io/x/gobot", VCS:"git", RepoRoot:"https://github.com/hybridgroup/gobot"} at https://gobot.io/x/gobot/drivers/gpio?go-get=1
get "gobot.io/x/gobot/drivers/gpio": verifying non-authoritative meta tag
Fetching https://gobot.io/x/gobot/drivers/i2c?go-get=1
Parsing meta tags from https://gobot.io/x/gobot/drivers/i2c?go-get=1 (status code 200)
get "gobot.io/x/gobot/drivers/i2c": found meta tag main.metaImport{Prefix:"gobot.io/x/gobot", VCS:"git", RepoRoot:"https://github.com/hybridgroup/gobot"} at https://gobot.io/x/gobot/drivers/i2c?go-get=1
get "gobot.io/x/gobot/drivers/i2c": verifying non-authoritative meta tag
github.com/sigurn/crc8 (download)
github.com/sigurn/utils (download)
Fetching https://gobot.io/x/gobot/sysfs?go-get=1
Parsing meta tags from https://gobot.io/x/gobot/sysfs?go-get=1 (status code 200)
get "gobot.io/x/gobot/sysfs": found meta tag main.metaImport{Prefix:"gobot.io/x/gobot", VCS:"git", RepoRoot:"https://github.com/hybridgroup/gobot"} at https://gobot.io/x/gobot/sysfs?go-get=1
get "gobot.io/x/gobot/sysfs": verifying non-authoritative meta tag
Fetching https://gobot.io/x/gobot/examples?go-get=1
Parsing meta tags from https://gobot.io/x/gobot/examples?go-get=1 (status code 404)
Fetching https://gobot.io/x/gobot/platforms/raspi?go-get=1
Parsing meta tags from https://gobot.io/x/gobot/platforms/raspi?go-get=1 (status code 200)
get "gobot.io/x/gobot/platforms/raspi": found meta tag main.metaImport{Prefix:"gobot.io/x/gobot", VCS:"git", RepoRoot:"https://github.com/hybridgroup/gobot"} at https://gobot.io/x/gobot/platforms/raspi?go-get=1
get "gobot.io/x/gobot/platforms/raspi": verifying non-authoritative meta tag
Fetching https://gobot.io/x/gobot/gobottest?go-get=1
Parsing meta tags from https://gobot.io/x/gobot/gobottest?go-get=1 (status code 404)
Fetching https://gobot.io/x/gobot/platforms/audio?go-get=1
Parsing meta tags from https://gobot.io/x/gobot/platforms/audio?go-get=1 (status code 200)
get "gobot.io/x/gobot/platforms/audio": found meta tag main.metaImport{Prefix:"gobot.io/x/gobot", VCS:"git", RepoRoot:"https://github.com/hybridgroup/gobot"} at https://gobot.io/x/gobot/platforms/audio?go-get=1
get "gobot.io/x/gobot/platforms/audio": verifying non-authoritative meta tag
Fetching https://gobot.io/x/gobot/platforms/beaglebone?go-get=1
Parsing meta tags from https://gobot.io/x/gobot/platforms/beaglebone?go-get=1 (status code 200)
get "gobot.io/x/gobot/platforms/beaglebone": found meta tag main.metaImport{Prefix:"gobot.io/x/gobot", VCS:"git", RepoRoot:"https://github.com/hybridgroup/gobot"} at https://gobot.io/x/gobot/platforms/beaglebone?go-get=1
get "gobot.io/x/gobot/platforms/beaglebone": verifying non-authoritative meta tag
Fetching https://gobot.io/x/gobot/platforms/ble?go-get=1
Parsing meta tags from https://gobot.io/x/gobot/platforms/ble?go-get=1 (status code 200)
get "gobot.io/x/gobot/platforms/ble": found meta tag main.metaImport{Prefix:"gobot.io/x/gobot", VCS:"git", RepoRoot:"https://github.com/hybridgroup/gobot"} at https://gobot.io/x/gobot/platforms/ble?go-get=1
get "gobot.io/x/gobot/platforms/ble": verifying non-authoritative meta tag
github.com/currantlabs/ble (download)
github.com/pkg/errors (download)
Fetching https://golang.org/x/net/context?go-get=1
Parsing meta tags from https://golang.org/x/net/context?go-get=1 (status code 200)
get "golang.org/x/net/context": found meta tag main.metaImport{Prefix:"golang.org/x/net", VCS:"git", RepoRoot:"https://go.googlesource.com/net"} at https://golang.org/x/net/context?go-get=1
get "golang.org/x/net/context": verifying non-authoritative meta tag
Fetching https://golang.org/x/net?go-get=1
Parsing meta tags from https://golang.org/x/net?go-get=1 (status code 200)
golang.org/x/net (download)
Fetching https://gobot.io/x/gobot/platforms/chip?go-get=1
Parsing meta tags from https://gobot.io/x/gobot/platforms/chip?go-get=1 (status code 200)
get "gobot.io/x/gobot/platforms/chip": found meta tag main.metaImport{Prefix:"gobot.io/x/gobot", VCS:"git", RepoRoot:"https://github.com/hybridgroup/gobot"} at https://gobot.io/x/gobot/platforms/chip?go-get=1
get "gobot.io/x/gobot/platforms/chip": verifying non-authoritative meta tag
Fetching https://gobot.io/x/gobot/platforms/digispark?go-get=1
Parsing meta tags from https://gobot.io/x/gobot/platforms/digispark?go-get=1 (status code 200)
get "gobot.io/x/gobot/platforms/digispark": found meta tag main.metaImport{Prefix:"gobot.io/x/gobot", VCS:"git", RepoRoot:"https://github.com/hybridgroup/gobot"} at https://gobot.io/x/gobot/platforms/digispark?go-get=1
get "gobot.io/x/gobot/platforms/digispark": verifying non-authoritative meta tag
Fetching https://gobot.io/x/gobot/platforms/dragonboard?go-get=1
Parsing meta tags from https://gobot.io/x/gobot/platforms/dragonboard?go-get=1 (status code 200)
get "gobot.io/x/gobot/platforms/dragonboard": found meta tag main.metaImport{Prefix:"gobot.io/x/gobot", VCS:"git", RepoRoot:"https://github.com/hybridgroup/gobot"} at https://gobot.io/x/gobot/platforms/dragonboard?go-get=1
get "gobot.io/x/gobot/platforms/dragonboard": verifying non-authoritative meta tag
Fetching https://gobot.io/x/gobot/platforms/firmata?go-get=1
Parsing meta tags from https://gobot.io/x/gobot/platforms/firmata?go-get=1 (status code 200)
get "gobot.io/x/gobot/platforms/firmata": found meta tag main.metaImport{Prefix:"gobot.io/x/gobot", VCS:"git", RepoRoot:"https://github.com/hybridgroup/gobot"} at https://gobot.io/x/gobot/platforms/firmata?go-get=1
get "gobot.io/x/gobot/platforms/firmata": verifying non-authoritative meta tag
Fetching https://go.bug.st/serial.v1?go-get=1
Parsing meta tags from https://go.bug.st/serial.v1?go-get=1 (status code 200)
get "go.bug.st/serial.v1": found meta tag main.metaImport{Prefix:"go.bug.st/serial.v1", VCS:"git", RepoRoot:"https://go.bug.st/git/serial.v1.git"} at https://go.bug.st/serial.v1?go-get=1
go.bug.st/serial.v1 (download)
Fetching https://golang.org/x/sys/windows?go-get=1
Parsing meta tags from https://golang.org/x/sys/windows?go-get=1 (status code 200)
get "golang.org/x/sys/windows": found meta tag main.metaImport{Prefix:"golang.org/x/sys", VCS:"git", RepoRoot:"https://go.googlesource.com/sys"} at https://golang.org/x/sys/windows?go-get=1
get "golang.org/x/sys/windows": verifying non-authoritative meta tag
Fetching https://golang.org/x/sys?go-get=1
Parsing meta tags from https://golang.org/x/sys?go-get=1 (status code 200)
golang.org/x/sys (download)
Fetching https://gobot.io/x/gobot/platforms/firmata/client?go-get=1
Parsing meta tags from https://gobot.io/x/gobot/platforms/firmata/client?go-get=1 (status code 200)
get "gobot.io/x/gobot/platforms/firmata/client": found meta tag main.metaImport{Prefix:"gobot.io/x/gobot", VCS:"git", RepoRoot:"https://github.com/hybridgroup/gobot"} at https://gobot.io/x/gobot/platforms/firmata/client?go-get=1
get "gobot.io/x/gobot/platforms/firmata/client": verifying non-authoritative meta tag
Fetching https://gobot.io/x/gobot/platforms/intel-iot?go-get=1
Parsing meta tags from https://gobot.io/x/gobot/platforms/intel-iot?go-get=1 (status code 200)
get "gobot.io/x/gobot/platforms/intel-iot": found meta tag main.metaImport{Prefix:"gobot.io/x/gobot", VCS:"git", RepoRoot:"https://github.com/hybridgroup/gobot"} at https://gobot.io/x/gobot/platforms/intel-iot?go-get=1
get "gobot.io/x/gobot/platforms/intel-iot": verifying non-authoritative meta tag
Fetching https://gobot.io/x/gobot/platforms/intel-iot/curie?go-get=1
Parsing meta tags from https://gobot.io/x/gobot/platforms/intel-iot/curie?go-get=1 (status code 200)
get "gobot.io/x/gobot/platforms/intel-iot/curie": found meta tag main.metaImport{Prefix:"gobot.io/x/gobot", VCS:"git", RepoRoot:"https://github.com/hybridgroup/gobot"} at https://gobot.io/x/gobot/platforms/intel-iot/curie?go-get=1
get "gobot.io/x/gobot/platforms/intel-iot/curie": verifying non-authoritative meta tag
Fetching https://gobot.io/x/gobot/platforms/intel-iot/edison?go-get=1
Parsing meta tags from https://gobot.io/x/gobot/platforms/intel-iot/edison?go-get=1 (status code 200)
get "gobot.io/x/gobot/platforms/intel-iot/edison": found meta tag main.metaImport{Prefix:"gobot.io/x/gobot", VCS:"git", RepoRoot:"https://github.com/hybridgroup/gobot"} at https://gobot.io/x/gobot/platforms/intel-iot/edison?go-get=1
get "gobot.io/x/gobot/platforms/intel-iot/edison": verifying non-authoritative meta tag
Fetching https://gobot.io/x/gobot/platforms/intel-iot/joule?go-get=1
Parsing meta tags from https://gobot.io/x/gobot/platforms/intel-iot/joule?go-get=1 (status code 200)
get "gobot.io/x/gobot/platforms/intel-iot/joule": found meta tag main.metaImport{Prefix:"gobot.io/x/gobot", VCS:"git", RepoRoot:"https://github.com/hybridgroup/gobot"} at https://gobot.io/x/gobot/platforms/intel-iot/joule?go-get=1
get "gobot.io/x/gobot/platforms/intel-iot/joule": verifying non-authoritative meta tag
Fetching https://gobot.io/x/gobot/platforms/joystick?go-get=1
Parsing meta tags from https://gobot.io/x/gobot/platforms/joystick?go-get=1 (status code 200)
get "gobot.io/x/gobot/platforms/joystick": found meta tag main.metaImport{Prefix:"gobot.io/x/gobot", VCS:"git", RepoRoot:"https://github.com/hybridgroup/gobot"} at https://gobot.io/x/gobot/platforms/joystick?go-get=1
get "gobot.io/x/gobot/platforms/joystick": verifying non-authoritative meta tag
github.com/veandco/go-sdl2 (download)
Fetching https://gobot.io/x/gobot/platforms/keyboard?go-get=1
Parsing meta tags from https://gobot.io/x/gobot/platforms/keyboard?go-get=1 (status code 200)
get "gobot.io/x/gobot/platforms/keyboard": found meta tag main.metaImport{Prefix:"gobot.io/x/gobot", VCS:"git", RepoRoot:"https://github.com/hybridgroup/gobot"} at https://gobot.io/x/gobot/platforms/keyboard?go-get=1
get "gobot.io/x/gobot/platforms/keyboard": verifying non-authoritative meta tag
Fetching https://gobot.io/x/gobot/platforms/leap?go-get=1
Parsing meta tags from https://gobot.io/x/gobot/platforms/leap?go-get=1 (status code 200)
get "gobot.io/x/gobot/platforms/leap": found meta tag main.metaImport{Prefix:"gobot.io/x/gobot", VCS:"git", RepoRoot:"https://github.com/hybridgroup/gobot"} at https://gobot.io/x/gobot/platforms/leap?go-get=1
get "gobot.io/x/gobot/platforms/leap": verifying non-authoritative meta tag
Fetching https://golang.org/x/net/websocket?go-get=1
Parsing meta tags from https://golang.org/x/net/websocket?go-get=1 (status code 200)
get "golang.org/x/net/websocket": found meta tag main.metaImport{Prefix:"golang.org/x/net", VCS:"git", RepoRoot:"https://go.googlesource.com/net"} at https://golang.org/x/net/websocket?go-get=1
get "golang.org/x/net/websocket": verifying non-authoritative meta tag
Fetching https://gobot.io/x/gobot/platforms/mavlink?go-get=1
Parsing meta tags from https://gobot.io/x/gobot/platforms/mavlink?go-get=1 (status code 200)
get "gobot.io/x/gobot/platforms/mavlink": found meta tag main.metaImport{Prefix:"gobot.io/x/gobot", VCS:"git", RepoRoot:"https://github.com/hybridgroup/gobot"} at https://gobot.io/x/gobot/platforms/mavlink?go-get=1
get "gobot.io/x/gobot/platforms/mavlink": verifying non-authoritative meta tag
Fetching https://gobot.io/x/gobot/platforms/mavlink/common?go-get=1
Parsing meta tags from https://gobot.io/x/gobot/platforms/mavlink/common?go-get=1 (status code 404)
Fetching https://gobot.io/x/gobot/platforms/megapi?go-get=1
Parsing meta tags from https://gobot.io/x/gobot/platforms/megapi?go-get=1 (status code 200)
get "gobot.io/x/gobot/platforms/megapi": found meta tag main.metaImport{Prefix:"gobot.io/x/gobot", VCS:"git", RepoRoot:"https://github.com/hybridgroup/gobot"} at https://gobot.io/x/gobot/platforms/megapi?go-get=1
get "gobot.io/x/gobot/platforms/megapi": verifying non-authoritative meta tag
Fetching https://gobot.io/x/gobot/platforms/microbit?go-get=1
Parsing meta tags from https://gobot.io/x/gobot/platforms/microbit?go-get=1 (status code 200)
get "gobot.io/x/gobot/platforms/microbit": found meta tag main.metaImport{Prefix:"gobot.io/x/gobot", VCS:"git", RepoRoot:"https://github.com/hybridgroup/gobot"} at https://gobot.io/x/gobot/platforms/microbit?go-get=1
get "gobot.io/x/gobot/platforms/microbit": verifying non-authoritative meta tag
Fetching https://gobot.io/x/gobot/platforms/mqtt?go-get=1
Parsing meta tags from https://gobot.io/x/gobot/platforms/mqtt?go-get=1 (status code 200)
get "gobot.io/x/gobot/platforms/mqtt": found meta tag main.metaImport{Prefix:"gobot.io/x/gobot", VCS:"git", RepoRoot:"https://github.com/hybridgroup/gobot"} at https://gobot.io/x/gobot/platforms/mqtt?go-get=1
get "gobot.io/x/gobot/platforms/mqtt": verifying non-authoritative meta tag
github.com/eclipse/paho.mqtt.golang (download)
Fetching https://golang.org/x/net/proxy?go-get=1
Parsing meta tags from https://golang.org/x/net/proxy?go-get=1 (status code 200)
get "golang.org/x/net/proxy": found meta tag main.metaImport{Prefix:"golang.org/x/net", VCS:"git", RepoRoot:"https://go.googlesource.com/net"} at https://golang.org/x/net/proxy?go-get=1
get "golang.org/x/net/proxy": verifying non-authoritative meta tag
Fetching https://gobot.io/x/gobot/platforms/nats?go-get=1
Parsing meta tags from https://gobot.io/x/gobot/platforms/nats?go-get=1 (status code 200)
get "gobot.io/x/gobot/platforms/nats": found meta tag main.metaImport{Prefix:"gobot.io/x/gobot", VCS:"git", RepoRoot:"https://github.com/hybridgroup/gobot"} at https://gobot.io/x/gobot/platforms/nats?go-get=1
get "gobot.io/x/gobot/platforms/nats": verifying non-authoritative meta tag
github.com/nats-io/nats (download)
github.com/nats-io/go-nats (download)
github.com/nats-io/nuid (download)
Fetching https://gobot.io/x/gobot/platforms/neurosky?go-get=1
Parsing meta tags from https://gobot.io/x/gobot/platforms/neurosky?go-get=1 (status code 200)
get "gobot.io/x/gobot/platforms/neurosky": found meta tag main.metaImport{Prefix:"gobot.io/x/gobot", VCS:"git", RepoRoot:"https://github.com/hybridgroup/gobot"} at https://gobot.io/x/gobot/platforms/neurosky?go-get=1
get "gobot.io/x/gobot/platforms/neurosky": verifying non-authoritative meta tag
Fetching https://gobot.io/x/gobot/platforms/opencv?go-get=1
Parsing meta tags from https://gobot.io/x/gobot/platforms/opencv?go-get=1 (status code 200)
get "gobot.io/x/gobot/platforms/opencv": found meta tag main.metaImport{Prefix:"gobot.io/x/gobot", VCS:"git", RepoRoot:"https://github.com/hybridgroup/gobot"} at https://gobot.io/x/gobot/platforms/opencv?go-get=1
get "gobot.io/x/gobot/platforms/opencv": verifying non-authoritative meta tag
github.com/lazywei/go-opencv (download)
Fetching https://gobot.io/x/gobot/platforms/parrot?go-get=1
Parsing meta tags from https://gobot.io/x/gobot/platforms/parrot?go-get=1 (status code 200)
get "gobot.io/x/gobot/platforms/parrot": found meta tag main.metaImport{Prefix:"gobot.io/x/gobot", VCS:"git", RepoRoot:"https://github.com/hybridgroup/gobot"} at https://gobot.io/x/gobot/platforms/parrot?go-get=1
get "gobot.io/x/gobot/platforms/parrot": verifying non-authoritative meta tag
Fetching https://gobot.io/x/gobot/platforms/parrot/ardrone?go-get=1
Parsing meta tags from https://gobot.io/x/gobot/platforms/parrot/ardrone?go-get=1 (status code 200)
get "gobot.io/x/gobot/platforms/parrot/ardrone": found meta tag main.metaImport{Prefix:"gobot.io/x/gobot", VCS:"git", RepoRoot:"https://github.com/hybridgroup/gobot"} at https://gobot.io/x/gobot/platforms/parrot/ardrone?go-get=1
get "gobot.io/x/gobot/platforms/parrot/ardrone": verifying non-authoritative meta tag
github.com/hybridgroup/go-ardrone (download)
Fetching https://gobot.io/x/gobot/platforms/parrot/bebop?go-get=1
Parsing meta tags from https://gobot.io/x/gobot/platforms/parrot/bebop?go-get=1 (status code 200)
get "gobot.io/x/gobot/platforms/parrot/bebop": found meta tag main.metaImport{Prefix:"gobot.io/x/gobot", VCS:"git", RepoRoot:"https://github.com/hybridgroup/gobot"} at https://gobot.io/x/gobot/platforms/parrot/bebop?go-get=1
get "gobot.io/x/gobot/platforms/parrot/bebop": verifying non-authoritative meta tag
Fetching https://gobot.io/x/gobot/platforms/parrot/bebop/client?go-get=1
Parsing meta tags from https://gobot.io/x/gobot/platforms/parrot/bebop/client?go-get=1 (status code 404)
Fetching https://gobot.io/x/gobot/platforms/parrot/minidrone?go-get=1
Parsing meta tags from https://gobot.io/x/gobot/platforms/parrot/minidrone?go-get=1 (status code 200)
get "gobot.io/x/gobot/platforms/parrot/minidrone": found meta tag main.metaImport{Prefix:"gobot.io/x/gobot", VCS:"git", RepoRoot:"https://github.com/hybridgroup/gobot"} at https://gobot.io/x/gobot/platforms/parrot/minidrone?go-get=1
get "gobot.io/x/gobot/platforms/parrot/minidrone": verifying non-authoritative meta tag
Fetching https://gobot.io/x/gobot/platforms/particle?go-get=1
Parsing meta tags from https://gobot.io/x/gobot/platforms/particle?go-get=1 (status code 200)
get "gobot.io/x/gobot/platforms/particle": found meta tag main.metaImport{Prefix:"gobot.io/x/gobot", VCS:"git", RepoRoot:"https://github.com/hybridgroup/gobot"} at https://gobot.io/x/gobot/platforms/particle?go-get=1
get "gobot.io/x/gobot/platforms/particle": verifying non-authoritative meta tag
github.com/donovanhide/eventsource (download)
Fetching https://gobot.io/x/gobot/platforms/pebble?go-get=1
Parsing meta tags from https://gobot.io/x/gobot/platforms/pebble?go-get=1 (status code 200)
get "gobot.io/x/gobot/platforms/pebble": found meta tag main.metaImport{Prefix:"gobot.io/x/gobot", VCS:"git", RepoRoot:"https://github.com/hybridgroup/gobot"} at https://gobot.io/x/gobot/platforms/pebble?go-get=1
get "gobot.io/x/gobot/platforms/pebble": verifying non-authoritative meta tag
Fetching https://gobot.io/x/gobot/platforms/sphero?go-get=1
Parsing meta tags from https://gobot.io/x/gobot/platforms/sphero?go-get=1 (status code 200)
get "gobot.io/x/gobot/platforms/sphero": found meta tag main.metaImport{Prefix:"gobot.io/x/gobot", VCS:"git", RepoRoot:"https://github.com/hybridgroup/gobot"} at https://gobot.io/x/gobot/platforms/sphero?go-get=1
get "gobot.io/x/gobot/platforms/sphero": verifying non-authoritative meta tag
Fetching https://gobot.io/x/gobot/platforms/sphero/bb8?go-get=1
Parsing meta tags from https://gobot.io/x/gobot/platforms/sphero/bb8?go-get=1 (status code 200)
get "gobot.io/x/gobot/platforms/sphero/bb8": found meta tag main.metaImport{Prefix:"gobot.io/x/gobot", VCS:"git", RepoRoot:"https://github.com/hybridgroup/gobot"} at https://gobot.io/x/gobot/platforms/sphero/bb8?go-get=1
get "gobot.io/x/gobot/platforms/sphero/bb8": verifying non-authoritative meta tag
Fetching https://gobot.io/x/gobot/platforms/sphero/ollie?go-get=1
Parsing meta tags from https://gobot.io/x/gobot/platforms/sphero/ollie?go-get=1 (status code 200)
get "gobot.io/x/gobot/platforms/sphero/ollie": found meta tag main.metaImport{Prefix:"gobot.io/x/gobot", VCS:"git", RepoRoot:"https://github.com/hybridgroup/gobot"} at https://gobot.io/x/gobot/platforms/sphero/ollie?go-get=1
get "gobot.io/x/gobot/platforms/sphero/ollie": verifying non-authoritative meta tag
Fetching https://gobot.io/x/gobot/platforms/tinkerboard?go-get=1
Parsing meta tags from https://gobot.io/x/gobot/platforms/tinkerboard?go-get=1 (status code 200)
get "gobot.io/x/gobot/platforms/tinkerboard": found meta tag main.metaImport{Prefix:"gobot.io/x/gobot", VCS:"git", RepoRoot:"https://github.com/hybridgroup/gobot"} at https://gobot.io/x/gobot/platforms/tinkerboard?go-get=1
get "gobot.io/x/gobot/platforms/tinkerboard": verifying non-authoritative meta tag

Closed 2017-06-15.

Thread 430 (2017-06-17):

Neopixel RGB LED strip support?

hairyhenderson, 2017-06-17:
I'm wondering if it'd be possible to add support for NeoPixel-type RGB LED strips (https://www.adafruit.com/product/1376) - these are basically just arrays of WS2812 or SK6812 individually-addressable RGB LEDs.

There are some Raspberry-Pi specific libraries, and there's also an Arduino library, but I'm looking for something more generic that I could use with an ESP8266 over WiFi with Firmata.

Or if there's a different approach I could use, I'm open to options 🙂

hairyhenderson, 2017-06-25:
> What do you think?

I think this is awesome! Thanks @deadprogram 😁

I'll try to test this out too once I get a little free time.

joek, 2017-10-09:
Hi,
what is the status about this project? I am looking for something similar. Do you have the Arduino code, you where using somewhere? It seems the StdFirmata will not work.

One thought about the GPIO Version. There are some problems and limitations to raspberry, which makes it more complicated to implement. Details: https://learn.adafruit.com/neopixels-on-raspberry-pi/overview

deadprogram, 2017-10-10:
Hi @joek you are correct, I have a repos with some work in progress on the Arduino side of things.

https://github.com/hybridgroup/FirmataNeopixels

Sorry about the complete lack of docs, as of yet. It is a pluging for configurablefirmata if that helps get you started before I can update the READMEs.

You are indeed correct about the speed issues with the raspi, but I expect that for at least a very short length of LEDs a Golang sysfs bitbanging approach might be viable.

rucuriousyet, 2018-05-18:
any updates? I would love to use the raspberry pi with Gobot and some neopixels...

deadprogram, 2018-05-18:
Hi @hairyhenderson your best bet with Raspberry Pi is probably to use a SPI based LED strip like the APA102 https://github.com/hybridgroup/gobot/blob/master/drivers/spi/apa102.go the speed of the Raspi bus is not really enough to drive NeoPixels without an attached microcontroller.

n00dles, 2018-05-31:
Hey Guys, any update on getting this working?

Thought I had it going (1 pixel lit up for me) but I haven't been able to replicate.

When adding to the esp firmware do I need to add :

 firmataExt.addFeature(Neopixels);

or similar? to the initFirmata() function.

n00dles, 2018-05-31:
ok figured I did need to use addFeature and I get lights !!

but just a flash the I get an exception on the ESP and it goes in to a reboot loop.
I'm just using your example code.

any suggestions?

deadprogram, 2018-06-01:
The ESP8266 basically goes into the reboot loop under many circumstances and one in particular is when it does not have enough time to process all the WiFi data. I ran into that exact problem with it, and was not even using code that is so timing dependent as the Neopixels. My Neopixel experiments were using an Intel TinyTile and using BLE not WiFi, as I recall.

One thought was to switch over to using Homie on the ESP8266 https://github.com/marvinroger/homie-esp8266 and use an MQTT based protocol. I have done some experiments with defining a Firmata-like protocol on top of Homie but it is far from complete.

Another useful approach might be to do the same sort of thing as Homie, but using COAP instead of MQTT. That would have quite a few benefits, such as not requiring a server, and also allowing for pure browser-based clients to test the device, but I have not seen that anyone has done anything even close to that yet. It is just one of several ideas I have been playing with.

n00dles, 2018-06-01:
@deadprogram Thanks for the update and advise.

I have it working now on wifi on esp8266 but I still get the odd reboot after about a minute. so I'll keep at it.

I'm so close to having it for what I want, not fancy animations just to be able to light up sequences of leds.

deadprogram, 2018-06-01:
That is good news. Please update this issue with details once you get it working to your liking.

n00dles, 2018-06-03:
quick question.

what is the purpose of the lines

[code]
   Firmata.write(START_SYSEX);
   Firmata.write(NEOPIXEL_CMD);
   Firmata.write(PIXEL_SHOW);
   Firmata.write(END_SYSEX);
[/code]

in the arduino code?

Removing it seems to get rid of any exceptions I'm getting. is this required for proper operation?

deadprogram, 2018-06-04:
That is the expected Firmata response sent from the Arduino back to the caller. The exception is on the ESP8266 side or the Go side?

n00dles, 2018-06-04:
Exception is on the Arduino (esp8266) side.

without the above lines I can send pixel data for hours.
with the lines included it crashes within a minute.

Crash dump below.

`Exception: 9 (LoadStoreAlignmentCause: Load or store to an unaligned address)

epc1:     0x4022e4b5: tcp_write at core/tcp_out.c:586
epc2:     0x00000000
epc3:     0x00000000
excvaddr: 0x00110009
depc:     0x00000000

ctx: cont

sp:       0x3ffefb50
end:      0x3ffefeb0
offset:   0x000001a0

stack:
0x4022e4d8: tcp_write at core/tcp_out.c:626
0x4022e484: tcp_write at core/tcp_out.c:575
0x40203472: ClientContext::_write_some() at ??:?
0x40203514: ClientContext::_write_from_source(DataSource*) at ??:?
0x40202651: loop at ??:?
0x402035c5: WiFiClient::write(unsigned char const*, unsigned int) at ??:?
0x402060c4: WiFiClient::connect(String, unsigned short) at ??:?
0x40205921: _GLOBAL__sub_I__ZN9IPAddressC2Ev at IPAddress.cpp:?
0x4020277c: WiFiStream::write(unsigned char) at ??:?
0x4020638d: FirmataClass::sendDigitalPort(unsigned char, int) at ??:?
0x40204e1f: FirmataNeopixels::setConfig(unsigned char, unsigned short) at ??:?
0x40204f4d: FirmataNeopixels::handleSysex(unsigned char, unsigned char, unsigned char*) at ??:?
0x40204c3d: FirmataExt::handleSysex(unsigned char, unsigned char, unsigned char*) at ??:?
0x4020613c: WiFiClient::connected() at ??:?
0x40204cc3: handleSysexCallback(unsigned char, unsigned char, unsigned char*) at ??:?
0x40204140: FirmataClass::processSysexMessage() at ??:?
0x40204260: FirmataClass::parse(unsigned char) at ??:?
0x402043ca: FirmataClass::processInput() at ??:?
0x40202660: loop at ??:?
0x40205e40: esp_schedule at ??:?
0x40100700: cont_norm at cont.S.o:?`

n00dles, 2018-06-04:
Exception is on the arduino (esp8266)

Without the above line I can send data to the device for hours without issue.
With the lines the device crashes within seconds.

Dump below.

`Exception: 9 (LoadStoreAlignmentCause: Load or store to an unaligned address)

epc1:     0x4022e374: tcp_write at core/tcp_out.c:427 (discriminator 1)
epc2:     0x00000000
epc3:     0x00000000
excvaddr: 0x002b0001
depc:     0x00000000

ctx: cont

sp:       0x3ffefb30
end:      0x3ffefeb0
offset:   0x000001a0

stack:
0x4022e538: tcp_write at core/tcp_out.c:633
0x4022e4e4: tcp_write at core/tcp_out.c:586
0x40203472: ClientContext::_write_some() at ??:?
0x40203514: ClientContext::_write_from_source(DataSource*) at ??:?
0x402035c5: WiFiClient::write(unsigned char const*, unsigned int) at ??:?
0x40206124: WiFiClient::write(unsigned char) at ??:?
0x40205981: Print::write(char const*) at ??:?
0x4020277c: WiFiStream::write(unsigned char) at ??:?
0x402063ed: FirmataClass::write(unsigned char) at ??:?
0x40204e1f: FirmataNeopixels::setPixel(unsigned short, unsigned int) at ??:?
0x40204f9b: FirmataNeopixels::handleSysex(unsigned char, unsigned char, unsigned char*) at ??:?
0x40100690: free at ??:?
0x40204c3d: FirmataExt::handleSysex(unsigned char, unsigned char, unsigned char*) at ??:?
0x4020619c: WiFiClient::operator bool() at ??:?
0x40204cc3: handleSysexCallback(unsigned char, unsigned char, unsigned char*) at ??:?
0x40204140: FirmataClass::processSysexMessage() at ??:?
0x40204260: FirmataClass::parse(unsigned char) at ??:?
0x402043ca: FirmataClass::processInput() at ??:?
0x40202660: loop at ??:?
0x40205ea0: loop_wrapper() at core_esp8266_main.cpp:?
0x40100700: cont_norm at cont.S.o:?`

n00dles, 2018-06-04:
ignore the above, I was doing something stupid....

NomadMaker, 2018-06-07:
It would probably be a lot easier to use DotStar strips than NeoPixel ones. DotStar is AdaFruit's name for LED's controlled via the APA102. They don't have the strict speed requirement that the NeoPixel ones do.

I have both DotStar and NeoPixel things, but I can't get to them for the next week or so because I'm packing up my motorhome and moving it from Florida to Pennsylvania shortly. If I can find a DotStar strip fast enough then I will see if I can test it when I'm stopped for the night. However, they may be already boxed and put away and I don't have the time to search for them until I get to my destination.

I am planning on eventually replacing the LED strips on my RV with DotStar strips so that I can be ready for holidays with a simple command. Imagine various types of Christmas lighting, then 4th of July, then just basic white, then Halloween, then Easter. That way nobody can make me change lights. :)

Thread 432 (2017-06-27):

ADAFRUIT 16-CHANNEL 12-BIT PWM/SERVO DRIVER - I2C INTERFACE driver implementation

chaitanya9186, 2017-06-27:

chaitanya9186, 2017-06-27:
Overview and details: https://learn.adafruit.com/16-channel-pwm-servo-driver?view=all

deadprogram, 2017-06-27:
Hi @chaitanya9186 check out the `dev` branch where we have just recently done work on this driver:
https://github.com/hybridgroup/gobot/blob/dev/drivers/i2c/pca9685_driver.go

Example code here:
https://github.com/hybridgroup/gobot/blob/dev/examples/firmata_pca9685.go

chaitanya9186, 2017-06-27:
Awesome @deadprogram.

chaitanya9186, 2017-06-27:
Can I use this driver from Raspberry Pi as well?

deadprogram, 2017-06-27:
Yes, it is just an I2C device.

chaitanya9186, 2017-06-27:
I am pretty new to this.

In the [example](https://github.com/hybridgroup/gobot/blob/dev/examples/firmata_pca9685.go), it is using [firmata platform](https://github.com/hybridgroup/gobot/tree/dev/platforms/firmata). If I want to use in Raspberry Pi, I need to use [raspi platform](https://github.com/hybridgroup/gobot/tree/dev/platforms/raspi)

deadprogram, 2017-06-28:
Yes, that is correct. You would just use the raspi package and Adaptor instead of the firmata one. SImilar to this example: https://github.com/hybridgroup/gobot/blob/master/examples/raspi_blinkm.go#L17-L18

Hope that helps!

deadprogram, 2017-07-06:
I'm going to leave this issue open until the PCA9685 driver makes it to the master branch. Once it has been merged, I'll come back and close this issue unless further assistance is needed.

deadprogram, 2017-07-31:
Good news is this was merged into master a couple weeks ago with the release of v1.6.1 however, the needed documentation is lagging a little behind. I'll continue to leave this open until the docs update.

deadprogram, 2017-11-15:
A example of use and docs page has been added to site. Now closing this issue, thanks everyone.

Closed 2017-11-15.

Thread 434 (2017-07-04):

doesn't compile on windows

amits1995, 2017-07-04:
I get the following compilation error while trying to run the simple blink example for arduino:
```
# gobot.io/x/gobot/platforms/ble
..\go\src\gobot.io\x\gobot\platforms\ble\ble_client_adaptor.go:189: undefined: defaultDevice
# gobot.io/x/gobot/sysfs
..\go\src\gobot.io\x\gobot\sysfs\i2c_device.go:88: undefined: syscall.SYS_IOCTL
..\go\src\gobot.io\x\gobot\sysfs\i2c_device.go:102: undefined: syscall.SYS_IOCTL
..\go\src\gobot.io\x\gobot\sysfs\i2c_device.go:219: undefined: syscall.SYS_IOCTL
..\go\src\gobot.io\x\gobot\sysfs\syscall.go:34: not enough arguments in call to syscall.Syscall
	have (uintptr, uintptr, uintptr, uintptr)
	want (uintptr, uintptr, uintptr, uintptr, uintptr)
exit status 2
Process exiting with code: 1
```

Here's the actual code:
```
package main

import (
        "time"

        "gobot.io/x/gobot"
        "gobot.io/x/gobot/drivers/gpio"
        "gobot.io/x/gobot/platforms/firmata"
)

func main() {
        firmataAdaptor := firmata.NewAdaptor("COM8")
        led := gpio.NewLedDriver(firmataAdaptor, "13")

        work := func() {
                gobot.Every(1*time.Second, func() {
                        led.Toggle()
                })
        }

        robot := gobot.NewRobot("bot",
                []gobot.Connection{firmataAdaptor},
                []gobot.Device{led},
                work,
        )

        robot.Start()
}
```

deadprogram, 2017-07-06:
Hello @amits1995 this was an unexpected consequence of adding support for BLEFirmata, since there is not yet Windows support in the BLE library.

Thanks for reporting. I'll look into either making that dependency conditional, or some other soution.

eriawan06, 2017-07-07:
hallo @deadprogram, I also encountered problem like this. How to fix it?

tural-esger, 2017-07-10:
The same issue with me too.

deadprogram, 2017-07-12:
Hello, everyone.

Just committed code to the `dev` branch that corrects this issue.

In addition, I have now created a Windows-based build in Appveyor to hopefully help avoid sudden surprises in the future.

Sorry about the inconvenience, and thanks everyone who reported this issue with good debugging details.

This issue will remain open for comment until the code gets to `master` in this week's release.

deadprogram, 2017-07-18:
Hi, everyone

I released v1.6.1 a few days ago. This issue has now been resolved, so I am now closing. Thanks again to everyone who helped out!

Closed 2017-07-18.

Thread 436 (2017-07-05):

An example to convert i2c drivers written in C/C++ and Python to golang

chaitanya9186, 2017-07-05:
Hi

I would like to work on #435 (Implement LSM9DS0 device driver).

I have [reference code](https://github.com/adafruit/Adafruit_LSM9DS0_Library) available in C++. Is there anyway I can convert this straight into gobot i2c device driver.

Please provide me if there are any examples.

Thank you.

deadprogram, 2017-07-06:
Although it is possible to wrap C/C++ code in Golang, all of our i2c drivers, and most of the code that we can, is written in pure Golang to make it easier to cross-compile, and reduce dependencies.

We would normally just examine the C++ reference code, and "manually transpile" it into Golang. It would be ideal if we had some docs on this, or someone wrote a blog post.

gen2thomas, 2023-05-15:
I'm going to close this issue, because there are programs available, which can transform code to golang. Also enough documentation is out there, so we do not reinvent the wheel here.

Closed 2023-05-15.

Thread 439 (2017-07-18):

raspberry pi built-in pull up/down resistor support?

boundedinfinity, 2017-07-18:
Is there a way to configure the raspberry pi internal pull up/down resistors?  I'm looking for help (or just a pointer to documentation) do some something similar to the configuration of the GPIO pin's pull up/down resistor in the python [RPi.GPIO](https://sourceforge.net/p/raspberry-gpio-python/wiki/BasicUsage/) module.

In python the configuration is achieved by something like this:

```python
GPIO.setup(PIN, GPIO.IN, pull_up_down = GPIO.PUD_DOWN)
```

Does gobot have something similar?

spatil, 2017-11-02:
Is there any workaround for this?

gokuu, 2019-12-21:
I have the same issue :(

stuartleeks, 2020-04-25:
@deadprogram - do you have any sense of what would be needed to add this? (From what I can tell it isn't currently supported?)

gen2thomas, 2023-05-15:
part of release v2.0.0

Closed 2023-05-15.

Thread 440 (2017-07-20):

Why are we not using golang.org/x/exp/io/i2c Interface for define i2c devices?

chaitanya9186, 2017-07-20:
I have seen [golang.org/x/exp/io/i2c](https://github.com/golang/exp/blob/master/io/i2c/i2c.go), which looks most generic for the purpose of i2c interface.

1. Why did we define new [i2c interface](https://github.com/hybridgroup/gobot/blob/dev/drivers/i2c/i2c.go) when we have a one available in golang exp lib?
    What I mean is, how is the current one it different from experimental lib?
2. What are the advantages?
3. Is there any way to convert current i2c interface to use the experimental?

Thank you

deadprogram, 2017-07-21:
Hi @chaitanya9186 so the Gobot interfaces predate that work by a couple of years. Also, x/exp/io worked is not actually being developed on any longer, as you might notice from the commits. :(

The interfaces are largely equivalent. Gobot is intended to work with both embedded Linux as well as microcontrollers connected via various serial or wireless adaptors, so the interface design is informed to some extent by things like Arduino etc.

If the community at large wants to start supporting the x/exp/io interfaces, the internal implementations of Gobot could evolve in that direction. However, so far, that has not been the case.

Hope that helps clarify a bit.

chaitanya9186, 2017-07-21:
Thanks @deadprogram.

Closed 2017-07-21.

Thread 445 (2017-08-11):

Support for "retain" in MQTT messages

Remo, 2017-08-11:
I'm trying to send a message to an MQTT broker, but retain it. I did some digging and it seems like paho already supports this. The third parameters sets it to `false`: https://github.com/hybridgroup/gobot/blob/master/platforms/mqtt/mqtt_adaptor.go#L124

I'm new to go and gobot and thus wasn't able to create a pull request. Not sure how I'm uspposed to add this without optional arguments or method overloading in a way that doesn't break backwards compatibility.

Also, why not return the result of `a.client.Publish`  so that we can track the delivery of the message?

deadprogram, 2017-08-28:
Hi @Remo thanks for the comments. Seems like a good idea to implement.

Regarding optional arguments, the best way to handle this is using variadic configuration ala https://dave.cheney.net/2014/10/17/functional-options-for-friendly-apis

Gobot's i2c drivers all already do this, to provide a slightly more in-context example: https://github.com/hybridgroup/gobot/blob/master/drivers/i2c/bme280_driver.go#L42

Returning a paho.Token from Publish() certainly seems like a small but useful change, as well.

We'd be very happy to accept a PR with these changes. Please let me know if I can help out in any way.

Remo, 2017-08-28:
@deadprogram thanks! I'm still evaluating, not sure I'll spend time learning go and gobot at this point. Currently playing around with python libraries and framework.

andrewebdev, 2019-07-19:
@Remo I've just submitted a PR that should allow you to access `paho.Client` directly from the gobot `mqtt.Adaptor`.

See andrewebdev:682-public-paho-client

gen2thomas, 2022-09-19:
@deadprogram it seems the originated problem is already fixed with the merged PR #719 . Maybe you could close the issue?

Closed 2022-09-19.

Thread 446 (2017-08-20):

ssd1306_driver

qarth, 2017-08-20:
How do you display text with the ssd1306_driver driver?

deadprogram, 2017-08-28:
Hi @qarth right now the functionality is rather limited.

Once a SPI interface has landed into Gobot dev, a more performant interface to the SSD1306 will be possible, and drawing text a more reasonable prospect.

deadprogram, 2017-09-11:
I think that @ulisesflynn is going to work on the SPI version of this driver in the near future. :smile_cat:

ulisesflynn, 2017-09-11:
I've been pretty busy this past week, but I'll get to this soon!

mikegleasonjr, 2017-10-22:
Here's an example displaying the current time:

```
package main

import (
	"image"
	"time"

	"github.com/fogleman/gg"
	"gobot.io/x/gobot"
	"gobot.io/x/gobot/drivers/i2c"
	"gobot.io/x/gobot/platforms/raspi"
)

func main() {
	r := raspi.NewAdaptor()
	d := i2c.NewSSD1306Driver(r)

	work := func() {
		d.Clear()
		d.Display()

		ctx := gg.NewContext(d.Buffer.Width, d.Buffer.Height)

		gobot.Every(time.Second, func() {
			ctx.SetRGB(0, 0, 0)
			ctx.Clear()
			ctx.SetRGB(1, 1, 1)
			ctx.DrawStringAnchored(time.Now().Format("15:04:05"), 0, 0, 0, 1)
			transfer(d, ctx.Image())
		})
	}

	robot := gobot.NewRobot("blinkBot",
		[]gobot.Connection{r},
		[]gobot.Device{d},
		work,
	)

	robot.Start()
}

func transfer(d *i2c.SSD1306Driver, img image.Image) {
	d.Clear()
	for y, w, h := 0, img.Bounds().Dx(), img.Bounds().Dy(); y < h; y++ {
		for x := 0; x < w; x++ {
			c := img.At(x, y)
			r, _, _, _ := c.RGBA()
			if r == 0 {
				continue
			}
			d.Set(x, y, 1)
		}
	}
	d.Display()
}
```
Basically I render an image in memory using a 3rd party library, then I set the pixels one by one of that image on the ssd1306.

deadprogram, 2017-10-22:
Hi @mikegleasonjr that transfer looks useful. Perhaps a version of that function `TransferImage` could be added to the driver itself? I'd gladly accept such a PR.

mikegleasonjr, 2017-10-22:
@deadprogram Great, will happily do!

deadprogram, 2018-04-16:
Hi @mikegleasonjr any chance of still getting this PR? :smile_cat:

deadprogram, 2018-05-31:
Now closing this issue since ssd1306 support is in fact in Gobot. Still love to see a PR with the image transfer feature.

Closed 2018-05-31.

Thread 453 (2017-10-05):

gpiochip458 base

bake, 2017-10-05:
Hi, I am trying to use Gobot with gokrazy (on a Raspberry Pi 3). To get GPIO working, adding `CONFIG_GPIO_SYSFS=y` to the [`.config`](https://github.com/gokrazy/kernel/blob/master/cmd/gokr-build-kernel/build.go#L19) is enough. The only problem is, that the pin indices don't start with 0 but 458:

```bash
/ # ls /sys/class/gpio/
export       gpiochip458  unexport
/ # cat /sys/class/gpio/gpiochip458/base
458
/ # cat /sys/class/gpio/gpiochip458/label
pinctrl-bcm2835
```

I used [breakglass](https://github.com/gokrazy/breakglass) (as suggested in an [issue on gokrazy](https://github.com/gokrazy/gokrazy/issues/33)) to debug.

To export pin 11 ([which is mapped to GPIO17](https://github.com/hybridgroup/gobot/blob/master/platforms/raspi/raspi_pin_map.go#L23)), I had to write `458 + 17` to `/sys/class/gpio/export`.

Is there a way to, for example, set the base within Gobot (i.e. `pin + $(cat /sys/class/gpio/gpiochip*/base)`) or should pin numbers always start at 0?

gen2thomas, 2022-09-20:
Hi @bake, sorry for the long delay, but it seems there is no knowledge about working with gokrazy.

I'm not sure about this is:
* a general bug in raspi pin mapping
* a problem on interacting with gokrazy
* a request for a new/special platform (adaptation of Raspi3)

Can someone make it more clear?

bake, 2022-09-29:
Thank you for the reply! I am currently not using gocrazy but it looks like GPIO should be working now.

gen2thomas, 2022-09-29:
@bake thank your for the answer, so I going to close this issue.

Closed 2022-09-29.

Thread 454 (2017-10-07):

Use dep for dependency management

trevrosen, 2017-10-07:
## What
I'm proposing to use [dep](https://github.com/golang/dep) as a tool to ensure a canonical dependency installation process for development.

## Why
It will make development far smoother and make reproducible builds much easier.

## Caveat
The `dep` tool requires Go 1.8 or higher. I believe that this is acceptable given that the Go team has committed to making this **the** tool for managing dependencies in Go software projects, but I admit I'm not fully aware of what concerns drive Gobot using 1.7 as the minimal supported version.

deadprogram, 2017-10-08:
Hi @trevrosen this seems like a great idea to me.

deadprogram, 2017-10-08:
Hello @trevrosen regarding your question about what has been driving the backward version compatibility. We have been trying to ensure support for the current version of Go - 2, but perhaps we should instead mimic the Go languages's own policy: https://golang.org/doc/devel/release.html#policy

deadprogram, 2017-10-08:
This thread describes some specific issues regarding Go language compat. and Gobot: https://github.com/hybridgroup/gobot/issues/390#issuecomment-289812820

deadprogram, 2017-11-15:
Thanks to @trevrosen this is now in the `dev` branch. I will close this issue once it makes it into the next release.

Closed 2017-12-21.

Thread 461 (2017-10-22):

gpio.ButtonPush & gpio.ButtonRelease are inverted

mikegleasonjr, 2017-10-22:
Hi, I'm using an [adafruit oled](https://learn.adafruit.com/adafruit-128x64-oled-bonnet-for-raspberry-pi?view=all) display with buttons. Following this simple example: https://gobot.io/documentation/examples/raspi_button/, my events are reversed.

Which means I get the `release` event when I push the button, and the `push` event when I release it.

I don't know how the buttons on the hat are wired, can I do something about it beside handling the events that way?

deadprogram, 2017-10-22:
Hi @mikegleasonjr I do not have one of these hats, but was looking thru the docs on the Adafruit site. Seems like the Python code samples expect that the buttons are pulled up.

I have just added some code to the `dev` branch to the `gpio.ButtonDriver` for `DefaultState`. Please try setting `DefaultState = 1` like this:

```go
	d := NewButtonDriver(a, "1")
	d.DefaultState = 1
```

It should reverse the behavior, making a change from LOW TO HIGH trigger a release, and HIGH to LOW trigger a push.

mikegleasonjr, 2017-10-22:
@deadprogram Yup this is working fine now in dev 👍

deadprogram, 2017-10-22:
OK, cool. I'll leave this issue open until this code is released. Thanks for testing.

deadprogram, 2017-10-23:
This is now released as part of https://github.com/hybridgroup/gobot/releases/tag/v1.7.0 so closing. Thanks again!

Closed 2017-10-23.

Thread 467 (2017-11-16):

beaglebone pwm does not works as since uboot overlays there is no slots file

johanhenselmans, 2017-11-16:
Since march 2017 the beaglebone developers have decided to migrate away from kernel overlays to uboot overlays. That means there is no slots file anymore, see
https://groups.google.com/d/msg/beagleboard/iRUT7UXYjjA/LpG3OLmcBAAJ and https://elinux.org/Beagleboard:BeagleBoneBlack_Debian#U-Boot_Overlays.

I do not understand whtat the ensureSlots func in beaglebone_adaptor.go  is doing, but with the current uboot overlays it does not work.

Also mentioned is that pwmchip can change, depending on which overlay is used: so one has to look at eg (/sys/devices/platform/ocp/48302000.epwmss/48302200.pwm/pwm/) to find out which pwmchip name a specific pwm pin has.

See  https://github.com/RobertCNelson/bb.org-overlays/blob/master/examples/cape-unversal-pwm.txt#L3-L9

If I can be of any help, please let me know.

deadprogram, 2017-11-17:
Hi @johanhenselmans thanks for bringing this up.

The `ensureSlots()` function is intended to initialize the ADC interface. As you point out, that has now been deprecated.

Seems like the best solution here, is probably to use the sysfs and pixmux interfaces directly to configure pins as desired. The page https://github.com/beagleboard/bb.org-overlays/tree/master/tools/beaglebone-universal-io#details breaks down the newer simplified patterns. Seems like we just need to basically do the same thing as `config-pin` does.

So, you seem to be offering to help out, in which case the answer is "yes"!

deadprogram, 2017-11-17:
Looks like Adafruit's Python lib is doing a lot of the right things, as a source of inspiration: https://github.com/adafruit/adafruit-beaglebone-io-python

johanhenselmans, 2017-11-17:
Hmm,  I am not fluent in Gobot/Golang, so spare me some slack...
I'll see what I come up with.

deadprogram, 2017-11-17:
I can help, as well. Always happy to collaborate on improvements.

deadprogram, 2017-12-16:
Hello @johanhenselmans or anyone else interested in the BBB. I have a branch with some work in progress on this located here: https://github.com/hybridgroup/gobot/tree/feature/pocket-beaglebone

Please take a look if you can, and thanks.

johanhenselmans, 2017-12-17:
Interesting, I was working to put the adafruit python code in a go-able version. It's not working nor tested yet. I'll have time to work on it tomorrow.

deadprogram, 2017-12-20:
Code that runs on the latest Beaglebone Debian OS is now in the `dev` branch. I will leave this issue open until the next Gobot release.

deadprogram, 2017-12-26:
This was released with v1.8.0 a few days ago, so now closing. Thanks!

johanhenselmans, 2018-02-26:
Ron, I was hoping to see you at Fosdem, but was too influensa'd to get in Brussels. The current version does not take into account that about all the pins can behave as GPIO's, or as PWMs for that matter (with some PRU massaging). I tried to come up with a better solution, but I am having trouble understanding how I should compile my branch so that I can test it properly.  I seem to be missing some step.

'go build' in the $GOPATH/src/gobot.io/x/gobot does not seem to work, should I build with make? I ran make, but make ran tests, and then gave an error:

--- PASS: TestPwmPinDutyCycleError (0.00s)
PASS
ok  	gobot.io/x/gobot/sysfs	0.405s
make: *** [test] Error 2

How do I build local branches so that I can test locally and contribute afterwards?

johanhenselmans, 2018-06-12:
Ron, I have some problems with it as a bunch of pins that can also act as PWM are not defined. I have tried to come up with a solution, but I am unable to get the stuff compiled properly.

Is there some kind of manual that explains step by step how to build a test version that than can be used for submitting pull requests?

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

Vriendelijke Groeten,

Johan Henselmans
johan@netsense.nl
+31 6 51362675

Closed 2017-12-26.

Thread 471 (2017-12-02):

Question: motor driver for GoPiGo platform

kpeu3i, 2017-12-02:
Does Gobot support motor driver for GoPiGo platform?
I can't find any examples how to control motors.

Thanks in advance!

deadprogram, 2017-12-02:
Hi @kpeu3i there is support for the GoPiGo3 motors:

https://godoc.org/gobot.io/x/gobot/platforms/dexter/gopigo3#Driver.SetMotorDps
https://godoc.org/gobot.io/x/gobot/platforms/dexter/gopigo3#Driver.SetMotorLimits
https://godoc.org/gobot.io/x/gobot/platforms/dexter/gopigo3#Driver.SetMotorPosition
https://godoc.org/gobot.io/x/gobot/platforms/dexter/gopigo3#Driver.SetMotorPower

There does not appear to be a specific example using those API, but we do have a few other examples to use as reference for the GoPiGo3 in general:

https://github.com/hybridgroup/gobot/blob/master/examples/gopigo3_servo.go

Hope that helps!

kpeu3i, 2017-12-02:
Hi, @deadprogram! You've helped me a lot! it works :)

Here is a simple working example (motors will rotate forth):

```
work := func() {
    gopigoDriver.SetMotorPower(gopigo3.MOTOR_LEFT+gopigo3.MOTOR_RIGHT, 100)
}

robot := gobot.NewRobot("gopigo",
    []gobot.Connection{raspiAdaptor, dualshockAdaptor},
    []gobot.Device{gopigoDriver, servoDriver, motorDriver},
    work,
)

robot.Start()
```

kpeu3i, 2017-12-02:
It looks like method `SetMotorDps` doesn't work:

```
work := func() {
    err := gopigoDriver.SetMotorDps(gopigo3.MOTOR_LEFT, 180)
    if err != nil {
        app.workError <- err
    }
}
```

Nothing happens when I run it on my robot. Did I miss something?

deadprogram, 2017-12-03:
I'm not completely sure what that function is supposed to do. Paging Dr. @ulisesflynn for assistance.

kpeu3i, 2017-12-03:
I think this function is a port of [GoPiGo Python Driver](https://github.com/DexterInd/GoPiGo3/blob/master/Software/Python/gopigo3.py#L480).

```
Set the motor target speed in degrees per second
    Keyword arguments:
        port -- The motor port(s). MOTOR_LEFT and/or MOTOR_RIGHT.
        dps -- The target speed in degrees per second
```

ulisesflynn, 2017-12-04:
@kpeu3i I'll look at this to see if there is a problem, thanks!

ulisesflynn, 2017-12-11:
@kpeu3i I found the problem and I will get a PR soon to fix that and a few other issues.

kpeu3i, 2017-12-11:
@ulisesflynn thanks a lot for your help in resolving the problem!

deadprogram, 2017-12-21:
This code was released in v1.8.0 so now closing. Please reopen if needed.

Closed 2017-12-21.

Thread 472 (2017-12-06):

LED works, RGB not?

stuomas, 2017-12-06:
Hi, so I have one RGB led and I tried the basic example here https://gobot.io/documentation/platforms/raspi/ separately on all pins (11, 13, 15) and corresponding color fired up and blinks and everything is good.

Then I changed NewLedDriver to NewRgbLedDriver, keeping the physical connections the same. And my led does not respond to any of the functions. Anything else I need to know? Raspberry Pi 3

deadprogram, 2017-12-06:
Hello @stuomas it should work, can you please submit your exact code?

stuomas, 2017-12-06:
For example this works, and turns red led on.
`package main

import (
	"gobot.io/x/gobot"
	"gobot.io/x/gobot/drivers/gpio"
	"gobot.io/x/gobot/platforms/raspi"
)

func main() {
	r := raspi.NewAdaptor()
	led := gpio.NewLedDriver(r, "11")

	work := func() {
		led.Off()
	}

	robot := gobot.NewRobot("ledbot",
		[]gobot.Connection{r},
		[]gobot.Device{led},
		work,
	)

	robot.Start()
}`

This doesn't respond to anything
`package main

import (
	"gobot.io/x/gobot"
	"gobot.io/x/gobot/drivers/gpio"
	"gobot.io/x/gobot/platforms/raspi"
)

func main() {
	r := raspi.NewAdaptor()
	led := gpio.NewRgbLedDriver(r, "11", "13", "15")

	work := func() {
		led.SetRGB(255, 0, 0)
	}

	robot := gobot.NewRobot("ledbot",
		[]gobot.Connection{r},
		[]gobot.Device{led},
		work,
	)

	robot.Start()
}
`
On, Off, or Toggle neither work.

deadprogram, 2017-12-06:
So one important question @stuomas is have you installed pi-blaster in order to use PWM on the Raspi?

https://github.com/hybridgroup/gobot/tree/master/platforms/raspi#enabling-pwm-output-on-gpio-pins

You can now install pi-blaster using Gort, by install Gort on your Raspiberry Pi and then running the `gort raspi install piblaster` command.

stuomas, 2017-12-06:
@deadprogram I haven't. Is it mandatory with rgb functions even if you don't want to modulate the pins, but just on/off?

deadprogram, 2017-12-06:
Well, the assumption behind this particular driver is to have an LED that can support all of the RGB colors, which which requires PWM. That should probably be documented upfront.

That said, if https://github.com/hybridgroup/gobot/blob/master/drivers/gpio/rgb_led_driver.go#L141 could be modified to handle your use case.

For example:

```
if level == 0 || level == 255 {
    // use DigitalWriter instead of PwmWriter, cause we do not need it.
    return
}

// current logic using PwmWriter
```

What do you think?

stuomas, 2017-12-06:
I installed pi-blaster and now everything is fine. You're right it makes sense to require it, if you want to just turn on/off single colors of a rgb led, you can probably use the LedDriver for them separately.

Maybe it could be mentioned in the documentation though :)

Thanks!

NomadMaker, 2018-06-08:
Do you need Pi-Blaster even if you use the native PWM pins of the Raspberry Pi? There are four hardware PWM pins that I hope will work without PI-Blaster.

Unfortunately Gort can't build pi-blaster for me. And manually fails in the same way.

deadprogram, 2018-06-08:
Hi @NomadMaker the PWM mapping of the Raspi Adaptor expects that pi-blaster is installed.

Can you please open a GH issue on Gort repo with details about your pi-blaster install issue?

lw664256297, 2019-12-25:
你好，抱歉打扰你，我在使用 NewRgbLedDriver 使用上面的代码，我的RGBLED不亮，我能确保我安装了 pi-blaster 并且我使用 NewLedDriver 能正常点亮
这是我的  pi-blaster 数据
MBox Board Revision: 0xc03111
DMA Channels Info: 0x71f5, using DMA Channel: 14
Using hardware:                   PWM
Number of channels:                32
PWM frequency:                 100 Hz
PWM steps:                       1000
Maximum period (100  %):      10000us
Minimum period (0.100%):         10us
DMA Base:                  0x20007000
Initialised, Daemonized, Reading /dev/pi-blaster.

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

Closed 2024-02-21.

Thread 487 (2018-02-02):

I²C reply length should be at least 8 bytes long

conejoninja, 2018-02-02:
The length of *currentBuffer* (platform/firmata/client/client.go) of the I²C reply is 7, the code assumes it's 8 (or bigger)

I'm getting a strange bug randomly, not sure how to reproduce it or if there's anything wrong with my setup (the board, the connection,... maybe the way I'm reading the i²c replies)
I connect through TCPFirmata to an original Wemos D1 mini (it's an ESP8266-12S)
I'm developing a new driver (for APDS9960 sensor), I'm reading a bunch of data (128bytes) from an address. I tried several ways, for reading the data (the whole buffer at once or in 32-bytes batches). Not sure if any of this has any relation to the bug, which appear to be *random*

```bash
panic: runtime error: index out of range

goroutine 24 [running]:
gobot.io/x/gobot/platforms/firmata/client.(*Client).process(0xc4200b2000, 0x0, 0x0)
	/home/conejo/workspace/go/src/gobot.io/x/gobot/platforms/firmata/client/client.go:498 +0x1e26
gobot.io/x/gobot/platforms/firmata/client.(*Client).Connect.func6(0xc4200b2000)
	/home/conejo/workspace/go/src/gobot.io/x/gobot/platforms/firmata/client/client.go:230 +0x96
created by gobot.io/x/gobot/platforms/firmata/client.(*Client).Connect
	/home/conejo/workspace/go/src/gobot.io/x/gobot/platforms/firmata/client/client.go:224 +0x6d4
exit status 2
```

The I²C Reply was [240 119 0 0 24 1 247]

This bugs happens when reading sensor information, sometimes it doesn't fail and read the sensor correctly, sometimes it does fail with the above error. Any idea?

In any case, I²C is assuming the length of the buffer is at least 8 bytes
```go
Data:     []byte{byte(currentBuffer[6]) | byte(currentBuffer[7])<<7},
```
 without any checking

deadprogram, 2018-02-12:
There are some real limitations with the TCPFirmata/ESP8266 approach. The main one I ran into was that the Firmata protocol itself is just a little too chatty for the ESP8266 itself. I was locking up the microcontroller forcing it to reboot, due to this, and it took me a while to debug.

The alternative idea I was playing with was doing something based on https://github.com/maruel/homie-esp8266 and MQTT. I need to make some more progress before that could be viable.

deadprogram, 2018-02-12:
I meant to link to the main repo on Homie: https://github.com/marvinroger/homie-esp8266

conejoninja, 2018-02-12:
Thanks for the feedback, this happened with an Arduino Pro (through serial) too. I will give it another try, with different ways of reading the sensor I wasn't getting this error any more, but the ESP8266 was locking/rebooting itself.

deadprogram, 2018-02-17:
@conejoninja a couple more questions. Which version of the ESP8266 Firmata are you running? How are you controlling the number of bytes being returned in a single message?

The Firmata spec says that the data being returned uses 7-bit encoding so requires 2 bytes for each byte being moved around in LSB/MSB order, as documented here: https://github.com/firmata/protocol/blob/master/i2c.md#i2c-reply

So there should not be a proper case where there is a single byte being returned. Hope that is clear.

Regarding the ESP8266 resetting itself, that is the HW behavior when a `wdt` reset condition occurs, which can occur for many different reasons. Might be worth it to update to the master branch version of https://github.com/esp8266/Arduino since there have been a few updates that look like they might apply.

conejoninja, 2018-02-17:
I was using the one at firmatabuilder (configurable firmata 2.1.0) which should be the last stable.

I too saw the spec and it was strange, as it looks like the address is not being sent (or is 0?), there's some code for when the register is not specified and something about interrupts, which may be the issue here. I didn't have yet enough time to dig into this issue further.

I tried several ways for reading the data, reading as much bytes as the sensor told me, reading the same amount in 32-bytes batches (as the sensor really does) and reading byte by byte. And several combinations of them, reading less or more data to see if I could trigger the issue or find the bug.

I wasn't sure to open it since by the specs it shouldn't be happening, it was more of a question if anyone has experienced something similar before, I can't consistently reproduce the issue and I'm more inclined to think it's in my code. Feel free to close the issue until I could look further into it.

gen2thomas, 2022-08-25:
@deadprogram it seems nobody else has this problem reported yet. Could we close the Issue?

deadprogram, 2022-08-26:
Sounds good @gen2thomas now closing.

Closed 2022-08-26.

Thread 491 (2018-02-12):

Gobot Beaglebone Black GPIO question...

curtiswpaul, 2018-02-12:
I'm new to gobot...

I have a very simple Gobot/GPIO Button circuit.
It should show output when button is pushed and then again when released, but it doesn't do anything.
It's not working.

Running image BBB-blank-debian-9.3-iot-armhf-2018-02-04-4gb.img.xz.  (I also tried the version posted on the BeagleBone site)
Modified /boot/uEnv.txt according to instructions at https://gobot.io/documentation/platforms/beaglebone.

I can see all the gpio's in /sys/class/gpio.

I'm using gpio67, so I cat the value file and see 0 when button is not pushed, then see 1 when button is pushed.  I know my circuit is good.

This is my gobot code for interacting with the button:
FYI...P8_8 is gpio67

package main

import (
        "fmt"

        "gobot.io/x/gobot"
        "gobot.io/x/gobot/drivers/gpio"
        "gobot.io/x/gobot/platforms/beaglebone"
)

func main() {
        beagleboneAdaptor := beaglebone.NewAdaptor()
        button := gpio.NewButtonDriver(beagleboneAdaptor, "P8_8")

        work := func() {
                button.On(gpio.ButtonPush, func(data interface{}) {
                        fmt.Println("button pressed")
                })

                button.On(gpio.ButtonRelease, func(data interface{}) {
                        fmt.Println("button released")
                })
        }

        robot := gobot.NewRobot("buttonBot",
                []gobot.Connection{beagleboneAdaptor},
                []gobot.Device{button},
                work,
        )

        robot.Start()
}

This is what it looks like when the code runs.  No errors, etc...
Push the button and don't get any of the Println's.

2018/02/12 04:14:03 Initializing connections...
2018/02/12 04:14:03 Initializing connection BeagleboneBlack-65FB3BAE ...
2018/02/12 04:14:03 Initializing devices...
2018/02/12 04:14:03 Initializing device Button-51E1127C ...
2018/02/12 04:14:03 Robot buttonBot initialized.
2018/02/12 04:14:03 Starting Robot buttonBot ...
2018/02/12 04:14:03 Starting connections...
2018/02/12 04:14:03 Starting connection BeagleboneBlack-65FB3BAE...
2018/02/12 04:14:03 Starting devices...
2018/02/12 04:14:03 Starting device Button-51E1127C on pin P8_8...
2018/02/12 04:14:03 Starting work...

Shouldn't I be seeing "button pressed" when I press the P8_8 button?....I don't see anything when I push the button.

deadprogram, 2018-02-12:
Hi @curtiswpaul sounds like a permissions problem, possibly. If you run your program under sudo, what happens?

curtiswpaul, 2018-02-12:
Same issue.  Also tried root.

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

deadprogram, 2018-02-12:
I'll pull out one of my BBBs, grab the latest OS image, and check it out, then.

curtiswpaul, 2018-02-12:
Got a recommendation on golang-nuts from Silviu Capota Mera to try something like this just to see if the code is reading the button push...hold down the button and execute code, etc...

Something like this...
dVal, err := beagleboneAdaptor.DigitalRead("P8_8")
if err != nil {
  fmt.Println("Error reading the pin: ", err)
  return
}
fmt.Println("Pin read correctly, the value is: ", dVal)

deadprogram, 2018-02-12:
Sure, that seems reasonable.

deadprogram, 2018-02-13:
OK @curtiswpaul I spent a few moments, and thanks to some help from @RobertCNelson I have some updates that will address this, especially to the initial setup instructions. I will get some updates committed on this later today.

curtiswpaul, 2018-02-13:
Right on!

deadprogram, 2018-02-13:
Hi @curtiswpaul I just pushed this commit to the `dev` branch: https://github.com/hybridgroup/gobot/commit/f54403303d7e5caca9c737358f0b8f44f9c60a7c

Please note the small difference in pin naming for a couple of the pins. The examples have all been updated to the correct names.

Let me know how this works for you.

curtiswpaul, 2018-02-14:
So the issue was the instructions for the uEnv.txt?
I changed button pin over to P8_10 and it works.

deadprogram, 2018-02-14:
There were 2 issues, one being the setup instructions, the other being that the pin naming changed at some point, requiring a leading zero in the file name used by the pin muxing. If you never used a single digit pin number, you would never notice, hence why we did not get a report until now.

In any case, I appreciate the issue report, and we will be releasing a new version soon.

deadprogram, 2018-02-14:
This code has now been released as part of v1.9.0 thank you again for your help. Now closing.

Closed 2018-02-14.

Thread 493 (2018-02-22):

Is there any other way to install gobot?

ZLXT, 2018-02-22:
When i try to install gobot use the command "go get -d -u gobot.io/x/gobot/..." 。
My raspberry pi can't connect to the website。
Is there any other way to install it?
{
   package gobot.io/x/gobot/drivers/spi
        imports golang.org/x/exp/io/spi: unrecognized import path "golang.org/x/exp/io/spi" (https fetch:
  Get https://golang.org/x/exp/io/spi?go-get=1: dial tcp 216.239.37.1:443: i/o timeout)
  package gobot.io/x/gobot/platforms/ble
          imports golang.org/x/sys/unix: unrecognized import path "golang.org/x/sys/unix" (https fetch: Get
  https://golang.org/x/sys/unix?go-get=1: dial tcp 216.239.37.1:443: i/o timeout)
  package gobot.io/x/gobot/platforms/firmata
          imports go.bug.st/serial.v1: unrecognized import path "go.bug.st/serial.v1" (https fetch: Get
 https://go.bug.st/serial.v1?go-get=1: dial tcp 5.39.77.130:443: i/o timeout)
}
GFW is really annoying.

deadprogram, 2018-02-22:
Hello @ZLXT if what you want is to execute a compiled Gobot program on your Raspi, you can cross compile it on another system, and then move the executable to the Raspi using your local network a USB thumb drive/etc. No need to install Go or Gobot on the Raspi itself, since Go produces a standalone executable program.

Hope that helps!

trevrosen, 2018-02-22:
@ZLXT just to expand on what @deadprogram said, keep in mind that Gobot is a library and there's not a runtime to "install". Because Go produces static binaries, your compiled Gobot program is all you need. Something like this:

`GOOS=linux GOARCH=arm7 go build` will produce an ARM Linux binary. Hope that helps!

Closed 2018-02-22.

Thread 497 (2018-02-27):

Trouble with MCP3008 and Raspberry Pi

bloudermilk, 2018-02-27:
Hi there! I found this project the other day when looking for MCP3008 drivers in Go. I previously had my experiment wired up and successfully reading values from Python 3. However, I'm not having as much luck with Gobot (yet). I'm a complete Go novice and quite new to rpi/hardware in general, so it's probable that I'm making some beginner mistake. Any tips would be appreciated!

The following script is compiling and running on the pi just fine, but I only get zeros out.

```go
package main

import (
        "time"
        "fmt"

        "gobot.io/x/gobot"
        "gobot.io/x/gobot/drivers/spi"
        "gobot.io/x/gobot/platforms/raspi"
)

func main() {
        raspi := raspi.NewAdaptor()
        adc := spi.NewMCP3008Driver(raspi)

        work := func() {
                adc.Start()

                gobot.Every(1*time.Second, func() {
                        result, err := adc.Read(0)

                        if err == nil {
                          fmt.Printf("Hello world: %v\n", result)
                        } else {
                          fmt.Printf("Error\n")
                        }
                })
        }

        robot := gobot.NewRobot("logger",
                []gobot.Connection{raspi},
                []gobot.Device{adc},
                work,
        )

        robot.Start()
}
```

This is my Python script which works just fine:

```python
# simple example of reading the mcp3008 analog input channels and printing
# them all out.
# author: tony dicola
# license: public domain
import time

# import spi library (for hardware spi) and mcp3008 library.
import adafruit_gpio.spi as spi
import adafruit_mcp3008

# hardware spi configuration:
spi_port   = 0
spi_device = 1
mcp = adafruit_mcp3008.mcp3008(spi=spi.spidev(spi_port, spi_device))

print('reading mcp3008 values, press ctrl-c to quit...')
# print nice channel column headers.
print('| {0:>4} | {1:>4} | {2:>4} | {3:>4} | {4:>4} | {5:>4} | {6:>4} | {7:>4} |'.format(*range(8)))
print('-' * 57)
# main program loop.
while true:
    # read all the adc channel values in a list.
    values = [0]*8
    for i in range(8):
        # the read_adc function will get the value of the specified channel (0-7).
        values[i] = mcp.read_adc(i)
    # print the adc values.
    print('| {0:>4} | {1:>4} | {2:>4} | {3:>4} | {4:>4} | {5:>4} | {6:>4} | {7:>4} |'.format(*values))
    # pause for half a second.
    time.sleep(0.5)
```

deadprogram, 2018-03-27:
Hi @bloudermilk sorry about the delayed response, somehow just noticed this.

I pulled out my MCP3008 (the RasPiO Analog Zero) and just need to solder it up to look into this.

However, I have to travel this week, so I will probably not be able to help until next week.

deadprogram, 2018-03-27:
One thing I just noticed, you should not call `adc.Start()` in your `work` function. it is called for you by `robot.Start()`.

deadprogram, 2018-04-10:
There is a problem with reading SPI data that I am currently working on.

There is a very high probability of Gobot changing out the SPI API, which will fix the devices, but break the API for device implementors.

More soon...

bloudermilk, 2018-04-10:
@deadprogram thank you for following up. Now I must offer you an apology for going MIA on this issue. This week I will try to recompile my program without `adc.Start` to see if that has any affect. Let me know if there's anything else I can do to help you debug this. Happy to lend my Pi over SSH if that's helpful.

deadprogram, 2018-04-12:
Hi @bloudermilk the `dev` branch has a new set of code for SPI devices that should work a lot better for you, and others.

The sample program is located here: https://github.com/hybridgroup/gobot/blob/dev/examples/raspi_mcp3008.go

Please let me know if that solves your issue for your particular configuration.

deadprogram, 2018-04-20:
This has now been released as part of v1.10.0 so I am now closing this issue. Please reopen if needed, @bloudermilk and thanks.

Closed 2018-04-20.

Thread 498 (2018-03-06):

Add custom route in api.go?

FerventGeek, 2018-03-06:
I might be missing it, but can I add custom routes in API? For example, rather than open the default `/` with the Robeaux `index.html`, open a custom index page with a bot-specific custom UI, using `/API` underneath to make magic happen.  I can hack the source to refactor the current HTML into another page, but that's clumsy, and I heard a rumor you're making changes to the Robeaux/API features anyway.

FerventGeek, 2018-03-08:
Update. Close this :) I realized you can override any existing route after the API initializer is called.

```golang
a := api.NewAPI(gbot)
a.Get("/", func(res http.ResponseWriter, req *http.Request) {
		res.Write([]byte("hey there i see you!"))
	})
```

I'm good!  Thx

bloudermilk, 2018-03-09:
@FerventGeek you can actually close this issue yourself since you opened it. You should see a 'Close issue' button next to the 'Comment' button. 🍻

Closed 2018-03-09.

Thread 501 (2018-03-23):

Mifare MFRC522 RFID Reader/Writer support?

simonbrugger, 2018-03-23:
Hi,

do gobot support the Mifare MFRC522 RFID Reader/Writer in some way? I saw that there are already some SPI drivers available but not for MFRC522. Is there any default way to communicate with one SPI device?

And what is the best way to contribute a MFRC522 driver?

deadprogram, 2018-04-10:
There is a problem with reading SPI data that we are currently working on.

That means there is a very high probability of Gobot changing out the SPI API, which will fix the devices, but break the API for device implementors.

Once this work is completed, we will update the code generator to assist in creating the skeleton for new SPI drivers.

deadprogram, 2018-04-12:
Hi @simonbrugger the `dev` branch now has the new SPI implementation.

Take a look at any of the SPI driver implementations for inspiration. Seems like the MFRC522 has a complex API of its own, so there appears to be a fair bit of work needed to support all of its features.

gen2thomas, 2023-05-15:
part of release v2.0.0

Closed 2023-05-15.

Thread 503 (2018-03-26):

Joystick Xbox Controller - Never receives "0" event for x/y on either stick

ghostsquad, 2018-03-26:
Maybe I'm just not familiar with using a Joystick through this program, but I noticed that when I run some tests to get events, I never see `0` on the X/Y events for either left or right sticks when using a Xbox One controller. How do you "Zero" a joystick here?

ghostsquad, 2018-03-26:
Upon further investigation, and using this comment to guide a test:
https://github.com/hybridgroup/gobot/issues/363#issuecomment-277943574

I've setup the following which seems to work out really well. 3000 as the minimum x/y values seems to be a good at least for my joystick to consistently put me back to 0 on very low (but non-zero) values.

```go
package main

import (
	"fmt"
	"time"
	"sync/atomic"

	"gobot.io/x/gobot"
	"gobot.io/x/gobot/platforms/joystick"
)

type pair struct {
	x float64
	y float64
}

var leftX, leftY, rightX, rightY atomic.Value

func getLeftStick() pair {
	s := pair{x: 0, y: 0}
	s.x = leftX.Load().(float64)
	s.y = leftY.Load().(float64)
	return s
}

func getRightStick() pair {
	s := pair{x: 0, y: 0}
	s.x = rightX.Load().(float64)
	s.y = rightY.Load().(float64)
	return s
}

func main() {
	joystickAdaptor := joystick.NewAdaptor()
	stick := joystick.NewDriver(joystickAdaptor,
		"./xboxone.json",
	)

	leftX.Store(float64(0.0))
	leftY.Store(float64(0.0))
	rightX.Store(float64(0.0))
	rightY.Store(float64(0.0))

	work := func() {
		stick.On(joystick.LeftX, func(data interface{}) {
			val := float64(data.(int16))
			leftX.Store(val)
		})

		stick.On(joystick.LeftY, func(data interface{}) {
			val := float64(data.(int16))
			leftY.Store(val)
		})

		stick.On(joystick.RightX, func(data interface{}) {
			val := float64(data.(int16))
			rightX.Store(val)
		})

		stick.On(joystick.RightY, func(data interface{}) {
			val := float64(data.(int16))
			rightY.Store(val)
		})

		gobot.Every(10*time.Millisecond, func() {
			leftStick := getLeftStick()

			switch {
			case leftStick.y < -3000:
				fmt.Println("left_y", leftStick)
			case leftStick.y > 3000:
				fmt.Println("left_y", leftStick)
			default:
				fmt.Println("left_y", 0)
			}

			switch {
			case leftStick.x > 3000:
				fmt.Println("left_x", leftStick)
			case leftStick.x < -3000:
				fmt.Println("left_x", leftStick)
			default:
				fmt.Println("left_x", 0)
			}
		})

		gobot.Every(10*time.Millisecond, func() {
			rightStick := getRightStick()

			switch {
			case rightStick.y < -3000:
				fmt.Println("right_y", rightStick)
			case rightStick.y > 3000:
				fmt.Println("right_y", rightStick)
			default:
				fmt.Println("right_y", 0)
			}

			switch {
			case rightStick.x > 3000:
				fmt.Println("right_x", rightStick)
			case rightStick.x < -3000:
				fmt.Println("right_x", rightStick)
			default:
				fmt.Println("right_x", 0)
			}
		})
	}

	robot := gobot.NewRobot("joystickBot",
		[]gobot.Connection{joystickAdaptor},
		[]gobot.Device{stick},
		work,
	)

	robot.Start()
}
```

Closed 2018-03-26.

Thread 505 (2018-03-29):

BB Blink demo is misleading and its problems poorly documented - fix included

eric-s-raymond, 2018-03-29:
I modified the blink demo to be clear about what it''s toggling and when, and what its prerequisites are.

```
/*
 * blinktest - blink the USR1 LED on the Beaglebone once a second.
 *
 * usr1 is the blue LED third from the Ethernet port in the group
 * of four.  Normally it goes on when the SD is being accessed.
 * While this is running expect it to blink on and off with a
 * two-second cycle.
 *
 * Note: you must be running as root or be in the gpio group for
 * this to work.
 */
package main

import (
        "time"

        "gobot.io/x/gobot"
        "gobot.io/x/gobot/drivers/gpio"
        "gobot.io/x/gobot/platforms/beaglebone"

	"log"
)

func main() {
	log.Printf("Blink demo\n")
	pin := "usr1"
        beagleboneAdaptor := beaglebone.NewAdaptor()
        led := gpio.NewLedDriver(beagleboneAdaptor, pin)

        work := func() {
                gobot.Every(1*time.Second, func() {
			log.Printf("Toggling %s", pin)
                        led.Toggle()
                })
        }

        robot := gobot.NewRobot("blinkBot",
                []gobot.Connection{beagleboneAdaptor},
                []gobot.Device{led},
                work,
        )

        robot.Start()
}
```
This solves several specific problems:

1. As is, the demo has no visible result unless you happen to have an LED hooked to the P9_12 pin.

2. It can silently fail due to the permissions issue.

3. User doesn't know where to look or what success looks like.

Not mentioned in the comment: Whatever library code this demo is using fails to restore the default behavior of blinking on mmc0 access - instead it's not triggerred by anything, That's a bug.

deadprogram, 2018-03-31:
Hi @eric-s-raymond thanks for looking at this. A couple comments:

- there is a separate example for using the `usr` LED here https://github.com/hybridgroup/gobot/blob/master/examples/beaglebone_blink_usr_led.go
- We should probably add a comment somewhere in the example that mentions the need to connect an LED to that pin.
- There should not be a permissions issue if you are running the latest BBB Debian OS, as mentioned here: https://gobot.io/documentation/platforms/beaglebone/ Are you running under a different user account than `debian` on the BBB?
- Gobot does not do anything to restore other programs that were previously running using the usr LEDs, I'm not too sure how to do that, or if we even really should be. Any further info on that would be appreciated. In the meantime, we should add info to the docs page, and possibly use a different `usr` LED for the example. What do you think?

eric-s-raymond, 2018-04-01:
I am aware that you have a separate example for usr1.  Part of what I am trying to convey is that the "main" demo blinking P9_12 is poorly written as is and should be *replaced* with an example that blinks a visible LED and provides an indication in its output of when the LED should be blinking.

What is the point of a demo that doesn't demo without special attached equipment when you have one that works with the bare board?

Yes, I was running under a development account I created. I am aware that the debian account is in group gpio.  It is good practice to inform the user up front of preconditions like that.  The comment I added was as important as the minor code modification.

I don't think restoring the default LED binding is very important as long as warning that it will be left unbound until the next reboot is added to the header comment.  Again, if you do not inform users of these things they are  likely to be surprised, confused, and have unnecessary problems

I chose usr1 because in normal operation on the BB (as opposed to reflashing) the SD is only accessed if the user does so explicitly.  It is thus the least ambiguouspin to use as a success indicator

The incoming merge request addresses all these issues.  I don't know how to change the doc page in the repository; if I did, I'd replace the beaglebone_blink_usr_led,go with a link to the improveed version.

gen2thomas, 2023-07-07:
Fully agree, that a brief description for all examples will improve the usability. For me - I mostly add a "Println("now on")" or whatever if the example is not working for the first time, just to start investigating a wiring mistake. IMO this is also a good experience for new users, to learn how to investigate such problems.

So I would not add additional output to console by default for simple examples like LED or buzzer. But more important for me would be an output in case of internal errors - most examples just drop it. @eric-s-raymond what do you think about? Your provided change do not check the result of `led.Toggle()`.

eric-s-raymond, 2023-07-07:
Sorry, that was 5 years ago now and I've forgotten the context.

gen2thomas, 2023-07-07:
Yes, a quite long delay :smile: . Anyway thanks for the fast response!

@deadprogram what do you think about:
* add a brief description for all examples
* do not drop errors in examples

Thanks Thomas

gen2thomas, 2025-02-15:
I'm going to close this issue, because newer examples contains some wiring information, so the user can have a look and will see how it works in general.

Closed 2025-02-15.

Thread 508 (2018-04-02):

Override the default log with logrus?

FerventGeek, 2018-04-02:
Is there a method to override the default `import "log"`? It would be really handy to ship framework log messages off to an IoT agitator along with my app logging, rather than have them inaccessible out on the device. Centralized logging may be out of scope, but I thought I'd ask.

trevrosen, 2018-04-03:
I’ve actually wanted to do this for awhile. @deadprogam what say ye? There are a lot of good things we could do with better logging, but I’d want to make sure we deliberate a bit first on the best approach.

deadprogram, 2018-04-03:
I think it is an excellent idea.

FerventGeek, 2018-04-03:
Thanks. Easy may just be to allow drop in replacement Logs. Combining them into a logging interface would be cool, but as a start, just a method on a few of the major objects to update the log object. Thanks for this project.  Oh, also I added a webhook to the API host, and overrode the "/" path.  Super simple, so good. Gobot Metal, FTW.

trevrosen, 2018-05-12:
#528 might not be the final word here. As it stands it shouldn't really be landed because it breaks code that hasn't called `RegisterLogger`. I'm writing it as a way to start this conversation toward some more intuitive leveled logging.

I'm thinking that it could be interesting to have the platforms (even maybe drivers?) adopt a convention for leveled logging such that there's always `log` in scope.

Honestly it could make sense to have this just be dot imported into `gobot` as long as the resulting API is small enough...

gm42, 2019-05-27:
#528 has been closed.

If moving to logrus is a too big task, can we consider allowing injection of a logger through an interface instead?

andygrunwald, 2019-09-27:
Any push on this? Can we help somehow?

trevrosen, 2019-09-27:
We can inject with an interface - but Gobot is a big lib and has several different "modes" of usage. How are you guys envisioning this would work?

gm42, 2019-10-01:
Most other libraries/frameworks allow to override the default logging mechanism with a call like `SetLogger(...)`; so for gobot it could be either that or an option specified with a `.WithOption(...)` syntax.

trevrosen, 2019-10-01:
Yup. I'm asking basically the scope you're trying to get to w/ this logger. In the robot abstraction? Common to all drivers?

If not Logrus, then what standard logger? (Unfortunately there's not a logger interface in the `log` package from stdlib to use as a standard)

andygrunwald, 2019-10-01:
@gm42 Do you have a (code) example/project with the `.WithOption` API?

My goal is to use structured logging for gobot.
By this, I can analyze the logs better / machine-readable.

In terms of scope: I believe this can be incremental though the gobot project. It doesn't need a big bang.

A detail/implementation question that comes to my mind:
The stdlib `log` package offers `log.Printf....` method. This is also often used by gobot in the form like `log.Printf("my message %s foo %s bar", foo, bar)`.
`logrus` great power comes with structured logging by providing `foo` and `bar` as structured fields.

How do we add the feature of structured logging without breaking the logging format of the stdlogger?
Do we implement two "logging modes? standard and structured?
How would this have an effect on the code?

trevrosen, 2019-10-01:
I could perhaps be convinced to resurrect something along the lines of this old PR of mine that I wrote w/out merging: https://github.com/hybridgroup/gobot/pull/528

andygrunwald, 2019-10-01:
@trevrosen I saw this PR, but this just replaces log with logrus, but keeps the logs unstructured.

trevrosen, 2019-10-01:
@andygrunwald yeah I was just pointing out that you'd need to plumb it all the way into the driver level. Something like the above PR would be part of this afaik. As for structured, once you have `log` as being actual Logrus, you can just use `WithFields`, no?

I'm still not understanding completely what you want to do wrt structured logging that you couldn't just do in your own code when you're making a `Robot`'s function for `Work`. Afaict the only real issue here is being able to have the same logging lib/instance in place whether the call site is in your `Work` (where you have control of what's emitted), or in a driver/adaptor, (where you don't). In any case, you'd want those legacy calls to `log` to use the same configuration as the more sophisticated stuff in your `Work` function.

Do you have examples of call sites in drivers or adaptors or whatever that you'd like to see converted to some particular structured calls? **Many** of the calls in Gobot (nearly all?) would need significant re-working to conform to some structured output.

andygrunwald, 2019-10-20:
@trevrosen
> I was just pointing out that you'd need to plumb it all the way into the driver level

True. I am not 100% aware of the internal structure of gobot (yet).

> As for structured, once you have log as being actual Logrus, you can just use `WithFields`, no?

Yes, 100%. I thought the goal is also to have it configurable if you want to use the current (`log`) structure or the "new" / structured logging approach. If this would be the case, it leads to a lot of adjustments.

### Usecase

I have a small golang application ([things-with-buzzers-websocket](https://github.com/andygrunwald/things-with-buzzers-websocket)) that listens to the GPIO of raspberry pi, get the signals and pushes those out via a WebSocket. In the master branch, I have traditional logging (see https://github.com/andygrunwald/things-with-buzzers-websocket/blob/master/buzzer.go#L55).

I have also a branch prepared with structured logging, see https://github.com/andygrunwald/things-with-buzzers-websocket/blob/logrus/buzzer.go#L99-L101

When I start gobot, it outputs a lot of logging (which is great), but having my app + gobot outputting different styles of logs (structured and unstructured) makes it hard to read the logs and operate it in case of issues.

My use case is, (right now) not tailored for consuming the logs, but this would be a nice benefit with modern tools like Prometheus/Kibana.
Does this make more sense for you?

andygrunwald, 2019-11-02:
Thanks. I understand. Right now, I also don't have time for this, but maybe someone from the community picks it up. I think it is essential to clarify the use cases here. And this is what we did.

Regarding structured logging in driver messages, here is a quick example.
I am using `raspi.NewAdaptor`, `gpio.NewButtonDriver` and finally `gobot.NewRobot`.
Sourcecode can be found here: https://github.com/andygrunwald/things-with-buzzers-websocket/blob/master/buzzer_hardware.go
Here are the logs from the small app:

```
[...]
2019/11/02 09:55:18 Initializing connections...
2019/11/02 09:55:18 Initializing connection RaspberryPi-4FB3E01F6643C509 ...
2019/11/02 09:55:18 Initializing devices...
2019/11/02 09:55:18 Initializing device Button-16F7866257F69CC ...
2019/11/02 09:55:18 Initializing device Button-2EDC0CA5D4ED71EF ...
2019/11/02 09:55:18 Initializing device Button-54BEE31520E875E ...
2019/11/02 09:55:18 Initializing device Button-4EBBE40A02E8C49A ...
2019/11/02 09:55:18 Robot buzzerBot initialized.
2019/11/02 09:55:18 Starting Robot buzzerBot ...
2019/11/02 09:55:18 Starting connections...
2019/11/02 09:55:18 Starting connection RaspberryPi-4FB3E01F6643C509...
2019/11/02 09:55:18 Starting devices...
2019/11/02 09:55:18 Starting socket broadcast
2019/11/02 09:55:18 Starting device Button-16F7866257F69CC on pin 40...
2019/11/02 09:55:18 Starting device Button-2EDC0CA5D4ED71EF on pin 38...
2019/11/02 09:55:18 Starting device Button-54BEE31520E875E on pin 36...
2019/11/02 09:55:18 Starting device Button-4EBBE40A02E8C49A on pin 32...
[...]
```

As you can see, there are a couple of information available that can be better transformed into structured logging like the Button-ID (e.g. `Button-4EBBE40A02E8C49A`), the Pin (e.g. 32) and more.

Thread 509 (2018-04-07):

Segmentation Fault when using SPI with Beaglebone Black

bodokaiser, 2018-04-07:
I am working on a driver for the AD9910 direct-digital-synthesizer.

```go
package driver

import (
	"gobot.io/x/gobot"
	"gobot.io/x/gobot/drivers/spi"

	"github.com/bodokaiser/beagle/device/register"
)

// AD9910 communication ops.
const (
	AD9910Write byte = 0x80
	AD9910Read       = 0x00
)

// AD9910 register addresses.
const (
	AD9910CtrlFunc1 = iota
	AD9910CtrlFunc2
	AD9910CtrlFunc3
	AD9910AuxDACCtrl
	AD9910IOUpdateRate
	_
	_
	AD9910FreqTuningWord
	AD9910PhaseOffsetWord
	AD9910AmplScaleFactor
	AD9910MultichipSync
	AD9910DigitalRampLimit
	AD9910DigitalRampStepSize
	AD9910DigitalRampRate
	AD9910Profile0
	AD9910Profile1
	AD9910Profile2
	AD9910Profile3
	AD9910Profile4
	AD9910Profile5
	AD9910Profile6
	AD9910Profile7
	AD9910RAM
)

// AD9910 is the gobot driver for the AD9910 DDS.
type AD9910 struct {
	name       string
	connector  spi.Connector
	connection spi.Connection
	registers  *register.AD9910
}

// NewAD9910 returns an initialized AD9910.
func NewAD9910(c spi.Connector) *AD9910 {
	r := new(register.AD9910)
	r.CtrlFunc1Data = register.AD9910CtrlFunc1Default
	r.CtrlFunc2Data = register.AD9910CtrlFunc2Default
	r.CtrlFunc3Data = register.AD9910CtrlFunc3Default
	r.AuxDACCtrlData = register.AD9910AuxDACCtrlDefault
	r.StProfile1Data = register.AD9910StProfile0Default

	return &AD9910{
		name:      gobot.DefaultName("AD9910"),
		connector: c,
		registers: r,
	}
}

// Name returns the name of the device.
func (d *AD9910) Name() string {
	return d.name
}

// SetName sets the name of the device.
func (d *AD9910) SetName(s string) {
	d.name = s
}

// Connection returns the spi connection used by the device.
func (d *AD9910) Connection() gobot.Connection {
	return d.connection.(gobot.Connection)
}

// RunSingleTone configures AD9910 to run in single tone mode with amplite,
// frequency and phase.
func (d *AD9910) RunSingleTone(ampl uint16, freq uint32, phase uint16) error {
	d.registers.SetRAMEnable(false)
	d.registers.SetDigitalRampEnable(false)
	d.registers.SetParallelPortEnable(false)

	d.registers.SetStProfile0AmplScaleFactor(ampl)
	d.registers.SetStProfile0FreqTuningWord(freq)
	d.registers.SetStProfile0PhaseOffsetWord(phase)

	instructions := [][]byte{
		append([]byte{AD9910CtrlFunc1 | AD9910Write}, d.registers.CtrlFunc1Data[:]...),
		append([]byte{AD9910CtrlFunc2 | AD9910Write}, d.registers.CtrlFunc2Data[:]...),
		append([]byte{AD9910CtrlFunc3 | AD9910Write}, d.registers.CtrlFunc3Data[:]...),
	}

	w := []byte{}
	for _, i := range instructions {
		w = append(w, i...)
	}
	r := make([]byte, len(w))

	return d.connection.Tx(w, r)
}

// Start initializes the driver.
func (d *AD9910) Start() (err error) {
	bus := d.connector.GetSpiDefaultBus()
	mode := d.connector.GetSpiDefaultMode()
	speed := d.connector.GetSpiDefaultMaxSpeed()

	d.connection, err = d.connector.GetSpiConnection(bus, mode, speed)

	return err
}

// Halt stops the driver.
func (d *AD9910) Halt() (err error) {
	return d.connection.Close()
}
```

and running the whole thing with

```go
func main() {
	beagle := beaglebone.NewAdaptor()

	dds0 := driver.NewAD9910(beagle)
	dds0.Start()
	dds0.RunSingleTone(1<<15, 1<<30, 0)
}
```

however I am experiencing a segmentation fault when doing the spi transaction `d.connection.Tx(...)`.

I am using the official Debian stretch 9.4 image flashed to MMC. The universal cape manager is enabled. Using [adafruits BeagleBone python io package](https://github.com/adafruit/adafruit-beaglebone-io-python) I am able to successfully use the SPI interface, thus I don't think this is a hardware / os configuration problem.

deadprogram, 2018-04-10:
There is a problem with reading SPI data that I am currently working on.

There is a very high probability of Gobot changing out the SPI API, which will fix the devices, but break the API for device implementors.

One of the needed changes would accommodate setting both the device bus ID, and chip ID. This would address your particular concerns, @bodokaiser

More soon...

deadprogram, 2018-04-12:
Hi @bodokaiser please take a look at the `dev` branch which has the new SPI implementation.

All the the spi drivers now support optional params. You can now set the specific device bus and chip like this:

```go
a := raspi.NewAdaptor()
adc := spi.NewMCP3008Driver(a, spi.WithBus(1), spi.WithChip(0))
```

Which should give you access to `/dev/spidev1.0` as you require.

Please give it a try, your feedback is appreciated.

bodokaiser, 2018-04-12:
I can confirm that

```go
package main

import (
	"log"

	"gobot.io/x/gobot/platforms/beaglebone"
)

func main() {
	beagle := beaglebone.NewAdaptor()

	c, err := beagle.GetSpiConnection(1, 0, 0, 8, 5e6)
	if err != nil {
		log.Fatal(err)
	}

	w := []byte{
		8, 0, 0,
		1, 3, 64, 8, 32,
		14, 63, 255, 0, 0, 1, 137, 0, 0,
		0, 0, 128, 2, 2,
		9, 0, 0, 255, 252,
		7, 1, 137, 0, 0,
	}
	r := make([]byte, len(w))

	err = c.Tx(w, r)
	if err != nil {
		log.Fatal(err)
	}

	log.Printf("%v", r)
}
```

works as expected. Thank you!

Thread 510 (2018-04-08):

GrovePi support

lucavallin, 2018-04-08:
Hello, I tried to make Gobot work with my GrovePi (https://www.dexterindustries.com/grovepi/) but no success. I can't actually understand whether this is supported at all. So, is it?
Or should I add a new adapter to use this?

deadprogram, 2018-04-09:
Hello @lucavallin there is not yet GrovePi support for Gobot, but it looks like a relatively modest task to add a new i2c Driver for it, and then implement the DigitalReader/DigitalWriter and AnalogReader interfaces.

Let me know if I can be of assistance. I have a GrovePi+ around here in the lab somewhere...

Thanks!

lucavallin, 2018-04-09:
Hey @deadprogram! Thanks for your reply: I'd like to give it a shot, just starting with this kind of low level stuff so it'd be good for me to play around with it. However, do you know if there's documentation about the architecture of Gobot? Like, besides adding a dexter driver for the GrovePi, do I need to take care of anything else?
I am going to work on it this week, maybe the next one as it's getting busy now.

lucavallin, 2018-04-09:
Started to work on it, however not very clear to me the bigger picture (in the examples I see you can create e.g. a new GroveButtonDriver, but this is a "layer" below the button itself...).

Anyways, this is it so far: https://github.com/lucavallin/gobot/blob/feature/grovepi-i2c-driver/drivers/i2c/grovepi_driver.go

I'm not sure about the read methods in particular... I used to specify a size for the amount of data to read. I don't see support for that in the i2c connection we're using... any suggestions?

deadprogram, 2018-04-09:
Hi @lucavallin I think the functions you are looking for are `d.connection.Read()` and `d.connection.Write()`.

I would expect your implementation of `AnalogRead()` to be something like this:

```go
func (d *GrovePiDriver) AnalogRead(pin string) (value int, err error) {
	nPin, err := strconv.Atoi(pin)
	if err != nil {
		return 0, err
	}

	if _, err = d.connection.Write([]byte{CommandReadAnalog, nPin, 0, 0}); err != nil {
		return
	}

	time.Sleep(100 * time.Millisecond)

	if _, err = d.connection.Write([]byte{1, 1}); err != nil {
		return
	}

	val := make([]byte, 4)
	_, err = d.connection.Read(val)
	if err != nil {
		return
	}

	return ((int(val[1]) << 8) | int(val[2])), nil
}
```

lucavallin, 2018-04-10:
I see, looks good, that should be enough for me to go on with it.
Still two questions tho:

- You're doing strconv.Atoi(pin) but, pin can be "D7" or "A2" for example, is there a particular reason why these values should be converted to int?
- (int(val[1]) << 8) | int(val[2]) : I understand we're left shifting int(val[1]) by 8 bits and then OR it with int(val[2]). But why are we doing so? Also why are casting it to int first? (Just lacking some knowledge on this one!)

Thank you!

deadprogram, 2018-04-10:
The only reason for the mapping to "int" is that is seems like that is what is expected by the GrovePi's i2c interface.

That, along with the bitshifting, I copied from the @DexterInd repo here https://github.com/DexterInd/GrovePi/blob/master/Software/Go/grovepi/grovepi.go#L67

Also, looks like a 0x1 needs to be written as the first byte in any command sent to the GrovePi. Which means that the code above should actually be changed to this:

```go
if _, err = d.connection.Write([]byte{1, CommandReadAnalog, nPin, 0, 0}); err != nil {
	return
}
```
I have not found my GrovePi yet, so I have not been able to test it out myself.

lucavallin, 2018-04-10:
Thanks again! Tonight I will play around with it a bit more :)

lucavallin, 2018-04-11:
Update: I've successfully implemented DigitalWrite. Now I can turn on my leds...
One more question: in my project I have digitalRead, analogRead and dhtRead. The last one is basically a digitalRead, but it does something extra on the raw data because the DHT sensor sends a few bits, but some represent the humidity and some other the temperature. I think this should go to some kind of "parser" but I don't think we have such concept here. Where do you think that operation belongs?

deadprogram, 2018-04-12:
The DHTXX is a pulse based device, similar to some ultrasonic range finders. There is in fact already an issue discussing this https://github.com/hybridgroup/gobot/issues/361

The "best" solution is probably to use some edge-detection/epoll type solution. Some ongoing work in this area within Gobot, but still as of yet not released anywhere.

lucavallin, 2018-04-22:
Update: I just ordered a digital sensor from which I can read from, with this I should be able to add the digitalRead part

deadprogram, 2018-06-05:
Hi @lucavallin any chance of still getting a PR for this?

lucavallin, 2018-06-05:
Hi @deadprogram, need to check what I have left. I remember I had the digitalwrite working but no tests, then I moved to arduino because it's just simpler to work with. Will check asap.

lucavallin, 2018-06-24:
@deadprogram No luck so far, I don't think I'll be submitting a PR any soon, sorry!

deadprogram, 2018-08-14:
Hi @lucavallin I've just merged into the `dev` branch a driver for the GrovePi based to some extent on the code from your branch.

https://github.com/hybridgroup/gobot/blob/dev/drivers/i2c/grovepi_driver.go

It implements the `DigitalReader`, `DigitalWriter` and `AnalogReader` interfaces, so you can just use it with any of the GPIO or AIO drivers. Here are a couple examples:

https://github.com/hybridgroup/gobot/blob/dev/examples/raspi_grove_pi_button.go
and
https://github.com/hybridgroup/gobot/blob/dev/examples/raspi_grove_pi_rotary.go

Should be useful for anyone with the @DexterInd hardware. I will have to acquire a GrovePi Zero to test if that also works in the same way.

lucavallin, 2018-08-14:
Hi @deadprogram, that's awesome news! I will take  another look at it so I can see what I was missing, maybe I can help maintaining too or something... Thanks!!!

Thread 517 (2018-05-02):

I2C LCD Driver Example Program

adityaalviori, 2018-05-02:
Hello All,
I am newbie on Golang and used BeagleBone Board.

May I request the example how to program the LCD using I2C, from how to connect the BB to LCD then writing the string on LCD

Thanks for your help

gen2thomas, 2022-08-25:
Hi, although the question is quite old I will try to answer it to allow closing the Issue.

Meanwhile there is a driver and an example available for Tinkerboard: https://github.com/hybridgroup/gobot/blob/release/examples/tinkerboard_adafruit1109_lcd_keys.go

Possibly someone with a BB can adapt it to BB and add it to the repository.

Hope this helps.

gen2thomas, 2022-10-19:
I'm going to close this issue now. If a special device is needed, please open a device request issue.

Closed 2022-10-19.

Thread 518 (2018-05-03):

Unable to start video on ubuntu 16.04

rlanari, 2018-05-03:
Hi, I'm trying to run your example (go run tello_video.go): all seems to work (tello connection is ok.. the last message displayed is "connected"), but mplayer does not displays any video.
The command is correctly run (ps -ef | grep mplayer --> i find it as a running process with -fps 25 -)... but nothing is displayed.
DO you have any suggestiong about it ?
Many thanks in advance and congratulation for your hard work !!!

deadprogram, 2018-05-03:
Hi @rlanari does the player window open, but no video in it?

I don;t think you should find the mplayer process running separately from the go process when the go code is not running. Perhaps you need to kill a stray mplayer process?

rlanari, 2018-05-03:
I checked it but before running go process I didn't find any mplayer process: I saw mplayer process only after typing the command: go run tello_video.go
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
 I have this OS:
DISTRIB_ID=Ubuntu
DISTRIB_RELEASE=16.04
DISTRIB_CODENAME=xenial
DISTRIB_DESCRIPTION="Ubuntu 16.04.4 LTS"

What OS are you using ?

deadprogram, 2018-05-03:
I am using same Ubuntu as you, and I installed from package manager. So nothing very interesting.

What output do you get when you run `mplayer -h`?

deadprogram, 2018-05-03:
Also, what version of Go?

rlanari, 2018-05-04:
mplayer -h
Usage:   mplayer [options] [url|path/]filename

Basic options: (complete list in the man page)
 -vo <drv>        select video output driver ('-vo help' for a list)
 -ao <drv>        select audio output driver ('-ao help' for a list)
 vcd://<trackno>  play (S)VCD (Super Video CD) track (raw device, no mount)
 dvd://<titleno>  play DVD title from device instead of plain file
 -alang/-slang    select DVD audio/subtitle language (by 2-char country code)
 -ss <position>   seek to given (seconds or hh:mm:ss) position
 -nosound         do not play sound
 -fs              fullscreen playback (or -vm, -zoom, details in the man page)
 -x <x> -y <y>    set display resolution (for use with -vm or -zoom)
 -sub <file>      specify subtitle file to use (also see -subfps, -subdelay)
 -playlist <file> specify playlist file
 -vid x -aid y    select video (x) and audio (y) stream to play
 -fps x -srate y  change video (x fps) and audio (y Hz) rate
 -pp <quality>    enable postprocessing filter (details in the man page)
 -framedrop       enable frame dropping (for slow machines)

Basic keys: (complete list in the man page, also check input.conf)
 <-  or  ->       seek backward/forward 10 seconds
 down or up       seek backward/forward  1 minute
 pgdown or pgup   seek backward/forward 10 minutes
 < or >           step backward/forward in playlist
 p or SPACE       pause movie (press any key to continue)
 q or ESC         stop playing and quit program
 + or -           adjust audio delay by +/- 0.1 second
 o                cycle OSD mode:  none / seekbar / seekbar + timer
 * or /           increase or decrease PCM volume
 x or z           adjust subtitle delay by +/- 0.1 second
 r or t           adjust subtitle position up/down, also see -vf expand

 * * * SEE THE MAN PAGE FOR DETAILS, FURTHER (ADVANCED) OPTIONS AND KEYS * * *

MPlayer 1.2.1 (Debian), built with gcc-5.3.1 (C) 2000-2016 MPlayer Team

rlanari, 2018-05-04:
go version
go version go1.10.2 linux/amd64

deadprogram, 2018-05-04:
You are using pretty much the exact same versions of everything as I am.

OK one thought is are you already using port 6038 for something else? I have intentions to allow changing the port used for the video when received, but still have not implemented that: https://github.com/hybridgroup/gobot/blob/master/platforms/dji/tello/driver.go#L248

jyzadeh, 2018-05-06:
Hi @rlanari, I'm having the same issue. Have you found a fix?

NikolaeVarius, 2018-08-17:
I can't run this with arch either. The tello works fine but no video window opens

sebsto, 2018-08-26:
I had a similar issue on MacOSX and found out that my company IT enforced a firewall rule on our laptop preventing to accept UDP packets. Disabling the firewall solved the problem.

On Mac : type sudo pfctl -d

Thread 519 (2018-05-04):

Tello OpenCV with ffmpeg

jakeyzadeh, 2018-05-04:
I have an issue running the gobot/examples/tello_opencv.go example.

I have ffmpeg and opencv installed, and have run the env.sh script before running the opencv file.

When running the file, the output is flooded with "EOF", and the occasional "write |1: broken pipe".

Here is the initial output of running env.sh and tello_opencv.go:

```
Jakes-MacBook-Pro-5:~ jake$ source go/src/gocv.io/x/gocv/env.sh
Brew install detected
Environment variables configured for OSX
Jakes-MacBook-Pro-5:~ jake$ go run /Users/jake/Desktop/cv.go
2018/05/04 12:02:02 Initializing connections...
2018/05/04 12:02:02 Initializing devices...
2018/05/04 12:02:02 Initializing device Tello-7270070BB4EEB5CD ...
2018/05/04 12:02:02 Initializing device Window ...
2018/05/04 12:02:02 Robot tello initialized.
2018/05/04 12:02:02 Starting Robot tello ...
2018/05/04 12:02:02 Starting connections...
2018/05/04 12:02:02 Starting devices...
2018/05/04 12:02:02 Starting device Tello-7270070BB4EEB5CD...
2018/05/04 12:02:02 Starting device Window...
2018/05/04 12:02:02 Starting work...
EOF
...
```

Furthermore, whenever attempting to edit files in VSCode which have opencv/gocv imported, linting stops working because of errors in imgproc.cpp:
`error: expected '(' for function-style cast or type construction`
VSCode version:
`Version 1.23.0 (1.23.0)`

OS Info:
```
System Version:	macOS 10.13.4 (17E202)
Kernel Version:	Darwin 17.5.0
```

```
Jakes-MacBook-Pro-5:~ jake$ pkg-config opencv --cflags
-I/usr/local/Cellar/opencv/3.4.1_4/include/opencv -I/usr/local/Cellar/opencv/3.4.1_4/include
```

```
Jakes-MacBook-Pro-5:~ jake$ ffmpeg -version
ffmpeg version 4.0 Copyright (c) 2000-2018 the FFmpeg developers
built with Apple LLVM version 9.1.0 (clang-902.0.39.1)
configuration: --prefix=/usr/local/Cellar/ffmpeg/4.0 --enable-shared --enable-pthreads --enable-version3 --enable-hardcoded-tables --enable-avresample --cc=clang --host-cflags= --host-ldflags= --enable-gpl --enable-ffplay --enable-frei0r --enable-libass --enable-libfdk-aac --enable-libfreetype --enable-libmp3lame --enable-libopencore-amrnb --enable-libopencore-amrwb --enable-libopus --enable-librtmp --enable-libspeex --enable-libtheora --enable-libvorbis --enable-libvpx --enable-libx264 --enable-libxvid --enable-opencl --enable-videotoolbox --disable-lzma --enable-libopenjpeg --disable-decoder=jpeg2000 --extra-cflags=-I/usr/local/Cellar/openjpeg/2.3.0/include/openjpeg-2.3 --enable-nonfree
libavutil      56. 14.100 / 56. 14.100
libavcodec     58. 18.100 / 58. 18.100
libavformat    58. 12.100 / 58. 12.100
libavdevice    58.  3.100 / 58.  3.100
libavfilter     7. 16.100 /  7. 16.100
libavresample   4.  0.  0 /  4.  0.  0
libswscale      5.  1.100 /  5.  1.100
libswresample   3.  1.100 /  3.  1.100
libpostproc    55.  1.100 / 55.  1.100
```

deadprogram, 2018-05-05:
Hi @jyzadeh you might want to try the `dev` branch of GoCV to resolve the syntax on macOS linting.

I have a few time needed to restart the program (not the drone) to get the video to start, might be some timing issue not yet fully understood.

jyzadeh, 2018-05-05:
Is there some installation difference between the master and dev branch? How would I switch to using dev branch?

deadprogram, 2018-05-05:
You now appear to be missing the correct path for linking OpenCV to GoCV. What change did you make, if you did not checkout the dev branch?

The easiest way to switch to dev branch for GoCV is probably:

```
cd $GOPATH/src/gocv/x/gocv
git checkout dev
git fetch
```

jyzadeh, 2018-05-05:
I fixed the three
`expected '(' for function-style cast or type construction`
errors that I had by parenthesizing the types.

I undid the changes and swapped to the dev branch, and have same issue as above.

deadprogram, 2018-05-05:
Do you happen to have more than 1 version of OpenCV installed via homebrew? Some people have seen this sort of thing before https://github.com/hybridgroup/gocv/issues/129

jyzadeh, 2018-05-05:
I've only got the latest version installed.
```
$ brew info opencv
opencv: stable 3.4.1 (bottled)
Open source computer vision library
https://opencv.org/
/usr/local/Cellar/opencv/3.4.1_5 (551 files, 97.8MB) *
  Poured from bottle on 2018-05-04 at 15:26:31
```

deadprogram, 2018-05-05:
You do realize you have to run the `env.sh` script once per session, right?

jyzadeh, 2018-05-05:
Yep. I’ve been running it every time I open terminal. Program and linter behavior remain consistent.

deadprogram, 2018-05-05:
I do not have that version of macOS installed, and do not have that issue. Other people have used GoCV successfully on macOS perhaps one of them can chime in.

jyzadeh, 2018-05-05:
What version are you on?

I’ll try and install Linux with parallels and see if I can get anything working there.

deadprogram, 2018-05-05:
I personally use Ubuntu 16.04

jyzadeh, 2018-05-06:
I've swapped over to an Ubuntu 16.04 environment.
Everything compiles and runs properly now, and all go extensions for VSCode work.

The only issue is when running any files that use the video feed (mplayer, ffmpeg, opencv), no window opens up to show the video.

This is probably an issue with my Ubuntu rather than Go.
Even with just the mplayer example, the code properly runs and connects to the drone, but no mplayer window opens.
Do you have any ideas on whats going on?

jyzadeh, 2018-05-06:
```
$ netstat -l
Active Internet connections (only servers)
Proto Recv-Q Send-Q Local Address           Foreign Address         State
...      
udp6       0      0 [::]:6038               [::]:*
```

Looks like the data is properly coming through. The only issue is the literal mplayer/opencv player window doesnt open. Could it be a permission or firewall issue?

jyzadeh, 2018-05-06:
oh man. I should have realized this sooner.
The
`drone.On(tello.VideoFrameEvent, func(data interface{}) {`
block is never executing. What would cause that?

jyzadeh, 2018-05-06:
Tracing the call hierarchy, it looks like the code is getting stuck in
```
func (fd *FD) ReadFrom(p []byte) (int, syscall.Sockaddr, error) {
	if err := fd.readLock(); err != nil {
		return 0, nil, err
	}
	defer fd.readUnlock()
	if err := fd.pd.prepareRead(fd.isFile); err != nil {
		return 0, nil, err
	}
	for {
		n, sa, err := syscall.Recvfrom(fd.Sysfd, p, 0)
		if err != nil {
			n = 0
			if err == syscall.EAGAIN && fd.pd.pollable() {
				if err = fd.pd.waitRead(fd.isFile); err == nil {
					continue
				}
			}
		}
		err = fd.eofError(n, err)
		return n, sa, err
	}
}
```
in fd_unix.go

It gets to
`
if err = fd.pd.waitRead(fd.isFile); err == nil {
`
and never gets a return from that waitRead function.

jyzadeh, 2018-05-06:
I receive data for FlightDataEvent, just not for the VideoFrameEvent.

How can I check why no data is coming through to 6038?

deadprogram, 2018-07-10:
Hi @jyzadeh have you tried lately with the latest versions of Gobot, GoCV, and the Tello firmware?

Closed 2019-07-08.

Thread 530 (2018-05-14):

How to assign requested address for tello driver example

zlederman, 2018-05-14:
Hello,
I ran the tello driver_test.go program and it connects to wifi and when I originally ran it it threw
`imported and not used: "fmt"`
I fixed this by adding a blank identifier infront of "fmt"
Now whenever I run the program it gives me
`2018/05/14 10:45:53 Initializing connections...
2018/05/14 10:45:53 Initializing devices...
2018/05/14 10:45:53 Initializing device Tello-7F66FA413B622CC0 ...
2018/05/14 10:45:53 Robot tello initialized.
2018/05/14 10:45:53 Starting Robot tello ...
2018/05/14 10:45:53 Starting connections...
2018/05/14 10:45:53 Starting devices...
2018/05/14 10:45:53 Starting device Tello-7F66FA413B622CC0...
2018/05/14 10:45:53 Starting work...
`
then I guess it connects to the drone  but after a few minutes of nothing happening on the drone I get
`stick command error: write udp 192.168.10.2:8888->192.168.10.1:8889: write: can't assign requested address` over and over and over again and then the wifi connection for the TELLO-XXXXXX drops
so what is happening here and what can I do to fix it?
Thank you,
Zach

deadprogram, 2018-05-14:
Hi @zlederman you normally run tests in Go by running:

```bash
go test ./platforms/dji/tello
```

For which you should obtain the result:

```bash
ok      _/home/ron/Development/gobot/gobot/platforms/dji/tello  0.001s
```

Files in Go named `*_test.go` are literally tests, not example programs. You probably want to look at the examples directory for example, the file https://github.com/hybridgroup/gobot/blob/master/examples/tello.go

Hope that helps!

zlederman, 2018-05-14:
THANK YOU SO MUCH <3

deadprogram, 2018-05-24:
I'm going to close this now. Please reopen if needed.

Closed 2018-05-24.

Thread 544 (2018-05-19):

golint cleanup

niaow, 2018-05-19:
I have been looking through the code, and my IDE keeps finding golint issues. I would like to fix these issues.

jadr2ddude, 2018-05-19:
@deadprogram  should [this](https://github.com/hybridgroup/gobot/blob/6fb9c3991b5d9225e71c0e46b4239da33395251a/drivers/i2c/jhd1313m1_driver.go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) be JHD1313M1_REG_RED? It does not currently follow the convention you have been using.

deadprogram, 2018-05-20:
Probably so, yes @jadr2ddude

jadr2ddude, 2018-05-31:
I am currently busy at the moment. I will hopefully have this ready for the next release cycle.

gen2thomas, 2023-06-12:
I will try to add some more linters to golangci-lint and fix the related issues. Maybe starting with "gofmt" is a good idea.

Closed 2023-07-07.

Thread 545 (2018-05-19):

opencv_window sample doesn't work

tomo0310, 2018-05-19:
Hi.
I want to use opencv_window sample. But it doesn't work.
https://gobot.io/documentation/examples/opencv_window/

OS:OSX 10.12.6

`2018/05/19 17:32:54 Initializing devices...
2018/05/19 17:32:54 Initializing device Window ...
2018/05/19 17:32:54 Initializing device Camera ...
2018/05/19 17:32:54 Robot cameraBot initialized.
2018/05/19 17:32:54 Starting Robot cameraBot ...
2018/05/19 17:32:54 Starting connections...
2018/05/19 17:32:54 Starting devices...
2018/05/19 17:32:54 Starting device Window...
2018/05/19 17:32:54 Starting device Camera...
2018/05/19 17:32:55 Starting work...
2018-05-19 17:32:55.728 opencv_window[6016:520299] *** Terminating app due to uncaught exception 'NSInternalInconsistencyException', reason: 'nextEventMatchingMask should only be called from the Main Thread!'`

I saw that issue.
https://github.com/hybridgroup/gocv/issues/31

So, I Add this code to the main function.But It doesn't work too.
`runtime.LockOSThread()`

Does anyone know how to solve the problem?

emf42, 2018-05-20:
For Mac OS, all opencv code must be run from the main thread, so using the goroutines provided by gobot are out of the question.
Use this instead https://github.com/hybridgroup/gocv/blob/master/cmd/capwindow/main.go

tomo0310, 2018-05-23:
Thank you for your answer. I finally want to run tello_opencv.go. It doesn't work because of the same reason. I'll use my old windows PC until opencv for Mac OS supports multi thread.

gen2thomas, 2023-07-07:
Since this is now closed in [Allure](AllureOfTheStars/Allure/issues/79) - is it also fixed for gobot?

Thread 547 (2018-05-19):

Joystick: Dualshock 4 Mapping Off?

SMerrony, 2018-05-19:
Just got a Sony Dualshock 4 and the mappings in platforms/joystick/joystick_dualshock4.go seem to be way off.

Checking with a couple of tools seems to confirm this.

Happy for me to fix this?

SMerrony, 2018-05-20:
It's trivial to correct the existing code - I just wanted to make sure that others are also seeing wrong mappings with the current version. Eg, buttons mixed up, RH stick not mapped etc.

deadprogram, 2018-05-20:
I've been using my DS3 controllers mostly, so it is very likely that whatever you are seeing is whatever everyone is. In other words, PR appreciated please!

deadprogram, 2018-05-31:
Version 1.11.0 has just been released that includes these fixes. Now closing, thank you everyone!

mulysatest, 2018-07-27:
this code using this joystick lib, but for some reason it doesn't map the dualshock4 joystick properly on OSX any idea?
https://www.drone-engineer.com/articles/76

Closed 2018-05-31.

Thread 553 (2018-05-24):

[BUG] Joystick: xbox360 Controller certain button not working

imathno, 2018-05-24:
I have been messing around with mapping the Xbox Controller to the Tello. I have found that RT, LT, and DPAD buttons aren't being registered. I tested with multiple controllers and the problem persists.

deadprogram, 2018-05-24:
You should try the `dev` branch @imathno

imathno, 2018-05-24:
@deadprogram I checked out the dev branch and it seems to still be a problem.

imathno, 2018-05-24:
I figured out a fix should I open a PR?

deadprogram, 2018-05-24:
Yes, please and thank you.

deadprogram, 2018-05-31:
Version 1.11.0 has just been released that includes this. Now closing, thanks everyone!

Closed 2018-05-31.

Thread 558 (2018-05-30):

Recover support

Coolerfall, 2018-05-30:
Hi guys,
Thanks for sharing this awesome project. I got `panic` for some reason whatever, and the program exited. I checked the source code, there's no ·recover· for `panic` sutiation. So any plan to add `recover` support to keep gobot alive?

jadr2ddude, 2018-05-30:
Can you please share where the panic came from? In go, panic/recover is usually bad.

trevrosen, 2018-05-30:
Are you wanting to see it as like a middleware in `api`?

Coolerfall, 2018-05-30:
@jadr2ddude, some foo bar panic,  maybe we didn't get it when testing. There always come some unknown bugs and maybe these bugs will crash.
@trevrosen, yes. Maybe we should keep them alive for further updates.

jadr2ddude, 2018-05-30:
While I do think this is possible to implement, this definitely should definitely not be the default behavior. Panic is considered bad practice, with the exception of 2 conditions:
1. Conditions indicating that there is an unrecoverable error and it is impossible to continue
2. Programmer error (e.g. null deference/index out of bounds)

In neither of these conditions is it safe to continue. If you hit a bug and decide to continue, there is an indeterminate state which could/would result in a cascade of more bugs.

trevrosen, 2018-05-30:
(cc @deadprogram since this is potentially a fairly fundamental discussion)

We could think through some middleware-style patterns that let us intercept and recover from a panic in situations where that makes sense. Would need to be configurable, I'd be in favor of offering such an option.

It can be argued that the robot work construct in Gobot is very similar to an `http.HandlerFunc` in the sense that it's a chunk of code whose execution really shouldn't negatively affect the supervisory entity. It's very common practice in Go (and many other langs) to handle exceptions in such a way that a server doesn't terminate but merely logs the issue. See [Negroni](https://github.com/urfave/negroni/blob/master/recovery.go) or [grpc-ecosystem's recovery interceptor](https://github.com/grpc-ecosystem/go-grpc-middleware/tree/master/recovery) for examples of recovery concepts in a server context.

trevrosen, 2018-06-02:
Thinking out loud here:

- We could start by adding some basic recover-and-log to the [Robot work goroutine](https://github.com/hybridgroup/gobot/blob/master/robot.go#L169-L172). This would enable the user to do something with their failure panic traces before the program exits and could be very useful for anyone working with a collection of Robots, especially in some scenario where they're set up to do remote work and an operator wants to collect a mass of diagnostic info.

- Past that, we could extend with some re-try functionality. This would enable the supervisor function (`Robot.Start()`) to re-start the `Robot.Work` function a configurable number of times, logging each crash via the previous functionality. This would be useful in scenarios where failure conditions inside a `Robot.Work` function are rare or acceptable.

deadprogram, 2018-06-05:
I like where this is going. We can certainly also allow the developer to disable any auto-recovery in the case they are using "metal Gobot", but I suspect that most devs want it to "just work".

trevrosen, 2018-06-05:
@deadprogram "metal Gobot" is basically just directly accessing hardware using provided drivers and connectors, right? If so, yeah I'd not even want to touch that line of use cases here. I'm specifically thinking about making the `Robot` orchestration concept more robust in the face of specific failure modes. I'll have something whipped up for you to react to this weekend. 😃

trevrosen, 2018-06-10:
@deadprogram here's a [first stab](https://github.com/hybridgroup/gobot/compare/dev...trevrosen:feature/558/recover-support?expand=1) at what recovery support might look like. Things to note:

* **this is still a work in-progress**
* A general API improvement here is the addition of support for [functional options](https://dave.cheney.net/2014/10/17/functional-options-for-friendly-apis) to `Robot`. Due to the nature of how `NewRobot` takes arguments, you add these and then call them with `AddConfigFunc()` and `RunConfigFuncs()` after initializing a new `Robot`.
* `Robot` now also has a mutex-guarded `lastError` field that can be set with `SetLastError(error)`. This enables a panicking `Work` function to note a failure before exit. This isn't super useful right now but **1)** it gives me something relatively easy/meaningful to test and **2)** it would be very useful if/when we take the next step and implement retries.
* I added a `sync.WaitGroup` on `Robot` to make testing of concurrent code possible/easier. As a bonus, this makes it simpler to synchronize other concurrent Go code along w/ a Robot's work.
* There's a new `_gobot_test` directory that implements a `gobot_test` package. There is a single test in there now showing how a user would work with the new config func/panic handler stuff. But this also represents the beginning of some over-all refactoring I'd like to do on some of our tests:
  * Remove usage of the `gobottest` package in favor of the more widely known and capable [Testify](https://github.com/stretchr/testify) lib
  * Leverage the `TestMain` function for global init/teardown needs
  * Test the `gobot` package's primary functionality from outside the package itself, helping to enforce some API boundaries.

### Further Discussion/Questions

* Should we leave `Stop()` to be called within the panic handler function itself as I've done in the test **or** should we take the more restrictive (but possibly more responsible) approach of automatically calling `Stop()` once the panic handler has executed? **This is the key question of this new functionality, IMO.**
* How do we feel about the new WaitGroup support? I **think** the code as written is fine to keep this from breaking existing instances of `Robots` people have, but we should double-check before I finalize this into a PR.
* Anything I've missed in this overall approach?

Thread 560 (2018-06-05):

Unable to compile raspi sample from docs

algogrit, 2018-06-05:
Hi, I am not sure what exactly is causing this:

For me I am trying to compile the sample code @ https://gobot.io/documentation/platforms/raspi/

It doesn't compile and gives the following error:

    vendor/gobot.io/x/gobot/drivers/spi/spi.go:82:21: cannot use maxSpeed (type int64) as type physic.Frequency in argument to p.Connect

The code for the above is located @ https://github.com/gauravagarwalr/gobot-ble-example/blob/rpi3/main.go

Please help!

deadprogram, 2018-06-06:
This is due to a breaking change in the periph package used for Gobot's SPI support. You can solve this by installing the 2.3 version of periph:

```shell
cd $GOPATH/src/periph.io/x/periph
git fetch
git checkout v2.3.0
```

Now you can change back to your Gobot directory and should be able to build correctly. There is also a PR not yet merged with the same change but to the dep file #561

gauravagarwalr, 2018-06-06:
To anyone using `dep` & coming to this issue, add the following to your `Gopkg.toml`:

```
[[override]]
  name = "periph.io/x/periph"
  version = "2.3.0"
```

It fixes the issue for now.

gen2thomas, 2022-12-11:
@deadprogram it seams this is outdated, because we use v3.x of "periph.io/x/periph" now. So I'm going to close this issue. Please reopen it, if I'm wrong.

Closed 2022-12-11.

Thread 565 (2018-06-10):

Stopping and Starting Robot with Raspberry Pi Adapter and LED Driver - LED does not toggle on restart

acarlonvs, 2018-06-10:
**Summary**
Starting, Stopping and Starting robot with Raspi Adapter and LED driver does not work on the second Start(). The LED does not toggle and Toggle returns "pin has not been exported".

**Cause**
Given the sample code from [https://gobot.io/documentation/platforms/raspi/](url):

```
func main() {
        r := raspi.NewAdaptor()
        led := gpio.NewLedDriver(r, "7")
        work := func() {
                gobot.Every(1*time.Second, func() {
                        led.Toggle()
                })
        }
        robot := gobot.NewRobot("blinkBot",
                []gobot.Connection{r},
                []gobot.Device{led},
                work,
        )
        robot.Start()
}
```
If the robot is stopped and then restarted, the LED does not blink. The reason is in raspi_adapter.go. When the robot is stopped raspi_adapter.go `Finalize()` will `Unexport` the pins, but the pins are retained in the map. So, when the robot is again started and `DigitalWrite() -> DigitalPin() -> getExportedDigitalPin()` is called, we get to the following code:

```
        if r.digitalPins[translatedPin] == nil {
		r.digitalPins[translatedPin] = sysfs.NewDigitalPin(translatedPin)
		if err = r.digitalPins[translatedPin].Export(); err != nil {
			return
		}
	}
```
Note, the pin is still in the map, but is now unexported. This results in the "pin has not been exported" error.

**Fix**

First remove the map initialization from `NewAdaptor()`
```
 func NewAdaptor() *Adaptor {
        r := &Adaptor{
-               mutex:       &sync.Mutex{},
-               name:        gobot.DefaultName("RaspberryPi"),
-               digitalPins: make(map[int]*sysfs.DigitalPin),
-               pwmPins:     make(map[int]*PWMPin),
+               mutex: &sync.Mutex{},
+               name:  gobot.DefaultName("RaspberryPi"),
 }
```
Second, add to `Connect()`:
```
 func (r *Adaptor) Connect() (err error) {
+       r.digitalPins = make(map[int]*sysfs.DigitalPin)
+       r.pwmPins = make(map[int]*PWMPin)
        return
 }
```
This will ensure that a new map is used each time the Robot is started. Not sure if there are any unintended effects of doing this, but at least it highlights what the problem is.
I can try to do a pull request on dev with this change if that is helpful.

deadprogram, 2018-06-10:
Hi @acarlonvs I think this sounds like a very good idea. You are correct, that some tests will need to be changed to accommodate this. It also seems to me that this probably needs to be consistent across all Adaptors that support the various GPIO interfaces.

Anyone else want to weigh in on this?

acarlonvs, 2018-06-10:
@deadprogram, judging by the comments it seems that at one point Connect() was responsible for creating the digital and pwm pin adaptor maps:

```
// Connect starts connection with board and creates
// digitalPins and pwmPins adaptor maps
func (r *Adaptor) Connect() (err error) {
	return
}
```

acarlonvs, 2018-06-11:
@deadprogram, also PWM does not work quite right. Currently, pwm_pin.go does this:
```
func (p *PWMPin) Unexport() error {
	return p.piBlaster(fmt.Sprintf("release %v\n", p.pin))
}
```
`release` will actually remove this pin from the known pins in pi blaster - see `release_pin` in [https://github.com/sarfata/pi-blaster/blob/master/pi-blaster.c](url)
This means when the Robot is started, the pin can no longer be used. Error on pi-blaster is "GPIO <gpio pin> is not enabled for pi-blaster."

Ideally it would be possible to call `release_pin2gpio`, but since this is not available, the next best is to set the PWM to 0:
```
func (p *PWMPin) Unexport() error {
	return p.piBlaster(fmt.Sprintf("%v=%v\n", p.pin, 0))
}
```
A workaround would have been to set the duty cycle to 0, but pwm_pin.go does not allow it. there is the block:
```
func (p *PWMPin) SetDutyCycle(duty uint32) (err error) {
        ...
	// never go below minimum allowed duty for pi blaster
        if val < 0.05 {
		val = 0.05
	}
```
This seems incorrect, 0 should be allowed to turn off PWM without Stopping robot.

gen2thomas, 2022-11-27:
Fixed for digital pin with #887 . This was tested with sysfs and character device driver. The fix is done in the new "DigitalPinAdaptor", which is included now by "composition" in the raspi adaptor.

Following platforms are also affected, most likely:
* beaglebone
* chip
* dragonboard (no pwm)
* edison
* joule
* jetson
* tinkerboard
* up2

gen2thomas, 2022-12-05:
The release part of pi-blaster was already fixed. The PWM pin cache problem is now fixed for all affected platforms with #890 .

gen2thomas, 2023-05-15:
part of release v2.0.0

Closed 2023-05-15.

Thread 568 (2018-06-19):

MCP23017 driver and Raspberry Pi - Read Buffer not correct

barrowkwan, 2018-06-19:
I am trying to use MCP23017 with Raspberry PI to turn PortA pin 0-7 ON ( ie write "1" to port A , pin 0-7).  However,  the driver didn't keep already "ON" pin to stay "ON".  Basically it can only keep one and only one of the pin 0-7 "ON".  There is no way to turn more than one pin ON at the same time.

After some debugging, it turns out the "read" function in mcp23017_driver.go return the wrong buffer.  "IODIR" supposed to be in buf[20] but it was in buf[19].

I don't know if this is a problem specific to RPi.  I have tried both RPi2 and RPi3.   In order to fix this, I have to change "read" function to return buf[register-1] instead.

	if register != 0 {
		return buf[register-1], nil
	} else {
		return buf[register], nil
	}

deadprogram, 2018-06-19:
@ulisesflynn any comments on this?

ulisesflynn, 2018-06-20:
@barrowkwan I am looking into this now, I'll get back with you by tomorrow.

deadprogram, 2018-06-24:
Hi @barrowkwan there is a PR from @ulisesflynn that appears should fix things that is located here:
https://github.com/hybridgroup/gobot/pull/569

Are you able to test it out and ensure it solves your specific issues?

barrowkwan, 2018-06-28:
Yes that fixed it.  thanks!

barrowkwan, 2018-06-28:
Hi
  I think this clean up has introduce another bug.  I used mcp23017 to drive a 16 relay board, before the fix, I can turn the relay on or off ( I have to use the PinMode method to set the pin input/output mode ).  Right now the PinMode function has gone and I can't change the PIN's mode.

After looking at the code, I think the problem is with the WriteGPIO.  We should be able to set 1 or 0 to the pin ( ie on or off ).  However, if we try to send a value "1" ( ie write 1 to the output pin, it will change the pin to be input instead of output ).

barrowkwan, 2018-06-29:
The problem is with the WriteGPIO function.  It should always use clearBit and write to IODIR.  so instead of

```

ulisesflynn, 2018-06-30:
I'll look at this tomorrow and see what's going on, I apologize for my slow response

Get Outlook for Android<https://aka.ms/ghei36>

________________________________
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

ulisesflynn, 2018-06-30:
@barrowkwan I've pushed up a PR for the writegpio/readgpio code, let me know if this fixes it.

ulisesflynn, 2018-07-02:
Thanks again @barrowkwan for testing this out.

deadprogram, 2018-07-10:
This has just been released as part of v1.11.1 so now closing. Thanks again!

gen2thomas, 2022-03-19:
The rework of read() and other cleanups (except leftover #810) in PR #569 and #576 are fine and improve the code readability.

So, for completeness only, after some investigation for #810:
The root cause of the issue #568 is caused by the missing reset of read pointer in function read() before each read operation. This leads to something like a "random read" of any address after the last access.

The first assumption of the issuer, that "return buf[register-1], nil" would fix the bug, could maybe work in special cases, but will not work in general.

The smallest fix would be adding following lines before start reading, e.g. (first 3 lines with code added):
```
func (m *MCP23017Driver) read(reg uint8) (val uint8, err error) {
	// reset to position 0, that fixes the originated problem of #568
	// because the sequential read will change the pointer on each access
	if _, err = m.connection.Write([]uint8{0x00}); err != nil {
		return val, err
	}
	// read
	register := int(reg)
	bytesToRead := register + 1
	buf := make([]byte, bytesToRead)
	bytesRead, err := m.connection.Read(buf)
```

Closed 2018-07-10.

Thread 570 (2018-06-22):

MQTT: how do I resubscribe after reconnect?

neewbee, 2018-06-22:

neewbee, 2018-06-22:
```golang
// +build example
//
// Do not build by default.

package main

import (
	"fmt"
	"time"

	"gobot.io/x/gobot"
	"gobot.io/x/gobot/platforms/mqtt"
)

func main() {
	mqttAdaptor := mqtt.NewAdaptor("tcp://localhost:1883", "pinger")

	work := func() {
		mqttAdaptor.On("hello", func(msg mqtt.Message) {
			fmt.Println("hello")
		})
		mqttAdaptor.On("hola", func(msg mqtt.Message) {
			fmt.Println("hola")
		})
		data := []byte("o")
		gobot.Every(1*time.Second, func() {
			mqttAdaptor.Publish("hello", data)
		})
		gobot.Every(5*time.Second, func() {
			mqttAdaptor.Publish("hola", data)
		})
	}

	robot := gobot.NewRobot("mqttBot",
		[]gobot.Connection{mqttAdaptor},
		work,
	)

	robot.Start()
}
```
several seconds after stopping mqtt server, reconnect will happen. But Work no longer works

deadprogram, 2018-06-22:
@trevrosen this is one of the things we want to be able to solve with your latest work in progress.

trevrosen, 2018-06-22:
@deadprogram indeed! Speaking of which you want me to proceed to PR w/ the implementation basically as it stands? Should we talk through some implications for existing installs etc?

grtfou, 2018-12-19:
I use two settings and it looks fine to my case. (gobot v1.12.0)
Maybe it's a solution if we're hard to monitor connection status.
```go
mqttAdaptor.SetAutoReconnect(true)
mqttAdaptor.SetCleanSession(false)
```

trevrosen, 2018-12-19:
@neewbee sorry for my silence on this -- it fell through the cracks. There's a new construct in the `dev` branch called RobotWork which gives you some external control of the workloads a robot is using. Please have a look at that and let me know (via this thread) whether it gives you the semantics you need to help solve your issue.

trevrosen, 2019-01-03:
Hi @neewbee I believe that [this PR](https://github.com/hybridgroup/gobot/pull/650) may also help you. I'm going to close this issue for now.

Closed 2019-01-03.

Thread 574 (2018-06-24):

Improve error handling in joystick driver

carl-ranson, 2018-06-24:
There are a couple of unhanded error cases in the joysick_driver.go code

the Start method begins with a switch statement to handle a various conditions. The default case is to call loadFile(). The error that is returned from loadFile is discarded meaning an error in the config file path goes undetected.

Secondly, within the loadFIle method, is a call to json.Unmarshal. the error returned by this is also ignored which means a structural error in the config file goes undetected

Both of these paths should generate an error events consistent with the other error handling in this file.

gen2thomas, 2022-09-20:
The error of [json.Unmarshal](https://pkg.go.dev/encoding/json#Unmarshal) call is still [unhandled](https://github.com/hybridgroup/gobot/blob/d8081f912d324f570c6e3fa74aba7c203e53bb27/platforms/joystick/joystick_driver.go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).

Closed 2023-07-07.

Thread 575 (2018-06-25):

MCP2515 CAN Controller Driver and CAN Interface

ssnover95, 2018-06-25:
Hello,
I'm an embedded engineer and I stumbled on Gobot while searching around for a good framework for developing hardware in order to learn Go. I'd like to contribute by developing a driver for the MCP2515 which is a useful IC which lets a device communicate with a CAN network over SPI.

However, I'm aware that Go has some different styles and idioms. My thought was that this driver should also be paired with an implementation of some kind of CAN interface such that further implementation built on top could be agnostic with respect to whether CAN access is courtesy of this IC in the case of say a Raspberry Pi or internal CAN controller hardware in the case of the BeagleBone Black.

Are there any plans to implement a CAN interface in Gobot and if not any suggestions on designing this interface in a way idiomatic to Go?

jadr2ddude, 2018-06-26:
For builtin CAN devices handled by OS, x/sys/unix should be used for this interface:

https://godoc.org/golang.org/x/sys/unix#SockaddrCAN

ssnover95, 2018-06-28:
Ah good to know there's already existing utility for this. I've used SocketCAN before so I know it also works on the Raspberry Pi with this CAN controller IC.

Closed 2018-06-28.

Thread 585 (2018-07-21):

Transitioning from Arduino to Gobot and need help

carldanley, 2018-07-21:
Not sure if this is the right place to get feedback but I'm having trouble converting this code into something useable with gobot.

This arduino sketch works for me: https://gist.github.com/carldanley/81fc25e0c0899eadf21b0836cf43a5f8.

The area I'm stuck most with is converting `motor.writeMicroseconds()` and `motor.write()` to gobot related code. So far, I was trying this:

```
package main

import (
	"fmt"
	"time"

	"gobot.io/x/gobot"
	"gobot.io/x/gobot/drivers/gpio"
	"gobot.io/x/gobot/platforms/firmata"
)

var adapter *firmata.Adaptor
var esc *gpio.DirectPinDriver

func writeMicrosecond(us int) {
	fmt.Printf("turning esc on for %d us...\n", us)
	esc.DigitalWrite(1)
	time.Sleep(time.Microsecond * time.Duration(us))
	esc.DigitalWrite(0)
}

func setSpeed(value int) {
	fmt.Printf("setting speed to %d...\n", value)
	esc.ServoWrite(byte(value))
}

func delay(ms int) {
	fmt.Printf("waiting for %d ms...\n", ms)
	time.Sleep(time.Millisecond * time.Duration(ms))
}

func armForward() {
	brake()
	writeMicrosecond(1510)
	delay(60)
	writeMicrosecond(1500)
	delay(60)
}

func brake() {
	writeMicrosecond(1500)
	delay(60)
}

func armBackward() {
	brake()
	writeMicrosecond(1200)
	delay(100)
	writeMicrosecond(1500)
	delay(250)
}

func main() {
	adapter = firmata.NewAdaptor("/dev/cu.usbmodem1D161")
	esc = gpio.NewDirectPinDriver(adapter, "11")

	work := func() {
		armForward()
		setSpeed(135)
		delay(1000)
		brake()
	}

	robot := gobot.NewRobot("traxxas-slash",
		[]gobot.Connection{adapter},
		[]gobot.Device{},
		work,
	)

	robot.Start()
}
```

Note: it will `armForward()` but I cannot `armBackward()` the same... I also don't think I translated everything correctly...

trevrosen, 2019-01-03:
The Slack channel (`#gobot` in Gophers Slack) is the best place to ask these kinds of questions. I'm going to close this now, but hopefully you've figured out your issue. Thanks for your interest in Gobot!

Closed 2019-01-03.

Thread 590 (2018-08-09):

digispark i2c

vendelin8, 2018-08-09:
Hi,

I'd like to use PCA9685Driver with Digispark, through i2c. I checked the examples, code, documentations, but I can't figure it out, how to connect them.
I tried with this:

	digisparkAdaptor := digispark.NewAdaptor()
	pca9685 := i2c.NewPCA9685Driver(digisparkAdaptor.connector, i2c.WithAddress(0x27))

but it gives me:

    digisparkAdaptor.connector undefined (type *digispark.Adaptor has no field or method connector)

Please help!

vendelin8, 2018-08-11:
I started to write the missing parts, but it doesn't seem to work.
https://github.com/hybridgroup/gobot/compare/master...vendelin8:master

I'm using this code to get it work:

	digisparkAdaptor := digispark.NewAdaptor()
	pca9685 := i2c.NewPCA9685Driver(digisparkAdaptor, i2c.WithAddress(0x27))

	work := func() {
		val := 0
		gobot.Every(50 * time.Millisecond, func() {
			val += 50
			if val > 4096 {
				val = 0
			}
			pca9685.SetPWM(0, 0, val)
			fmt.Println(val)
		})
	}

	robot := gobot.NewRobot("pwmBot",
		[]gobot.Connection{digisparkAdaptor},
		[]gobot.Device{pca9685},
		work,
	)

	defer func() {
		pca9685.SetPWM(channel, 0, 0)
	}()
	robot.Start()

When I tried to add

    pca9685.SetPWMFreq(60)

It broke with:

    panic: runtime error: invalid memory address or nil pointer dereference
    [signal SIGSEGV: segmentation violation code=0x1 addr=0x40 pc=0x4af58c]

    goroutine 1 [running]:
    gobot.io/x/gobot/drivers/i2c.(*PCA9685Driver).SetPWMFreq(0xc4200620c0, 0xc442700000, 0xc420057ef8, 0x1)

I'm quite new to gobot, cgo and low level programming, that's what I could figure out by myself. If you have some time, please look at it. Thanks!

vendelin8, 2018-08-17:
I found this example, that helped me with the issue:
https://github.com/littlewire/Little-Wire/blob/master/software/examples/i2c_blinkM.c

So I improved the code. I added a Test functionality that is able to check available addresses, with a code like:

    digisparkAdaptor.TestConnection(0, 127, func(a int) {
        fmt.Println(a)
    })

It gives me 0 and 64 (=0x40), so I changed the calling code to this

    pca9685 := i2c.NewPCA9685Driver(digisparkAdaptor, i2c.WithAddress(0x40))

But it still doesn't work, not sure why. Still waiting for any help, please.

deadprogram, 2018-08-22:
Hello @vendelin8 in order for an Adaptor to support i2c it needs to implement both the `I2cOperations` interface https://github.com/hybridgroup/gobot/blob/master/drivers/i2c/i2c.go#L29 as well as the `Connector` interface https://github.com/hybridgroup/gobot/blob/master/drivers/i2c/i2c.go#L48

You can verify this is complete if you add the following lines here https://github.com/hybridgroup/gobot/blob/master/platforms/digispark/digispark_adaptor_test.go#L18

```
var _ i2c.I2cOperations = (*Adaptor)(nil)
var _ i2c.Connector = (*Adaptor)(nil)
```

vendelin8, 2018-08-22:
Ok, I added

    var _ i2c.Connector = (*Adaptor)(nil)

to the test file, and wrote some new tests as well. I think that the other line shouldn't be necessary. Because:
1. not the Adaptor itself, but the connection returned by `GetConnection` should implement `i2c.I2cOperations`.
2. if a connection returned by `GetConnection` implements `i2c.Connection`, it will implement `i2c.I2cOperations` also.
3. I grepped the whole project for `I2cOperations`, and I found it only in https://github.com/hybridgroup/gobot/blob/master/drivers/i2c/i2c.go

So my current branch looks like this:
https://github.com/hybridgroup/gobot/compare/master...vendelin8:master

It compiles, tests are passing, but it doesn't seem that my PCA9685 sends appropriate PWM signals. Possible errors are:
1. I made something wrong in the code.
2. I failed to connect hardware parts properly. Not very likely, but I'm really new to this field.

deadprogram, 2018-08-22:
Take a look at https://github.com/littlewire/littlewire.rb/blob/master/lib/i2c.rb for a working client lib that uses the i2c interface of littlewire.

vendelin8, 2018-08-23:
Nice, thanks!
https://github.com/hybridgroup/gobot/pull/598

deadprogram, 2018-08-24:
Hi @vendelin8 thank you very much for the PR. I made a few small tweaks, but it worked for me with 2 different i2c devices:

- BlinkM
- MPL115A2

I flashed my DIgispark with Littlewire firmware using Gort.

Then I connected my Digispark via P0 (SDA) P2 (SCL) 5V and GND pins to the i2c devices.

The 2 new examples that I wrote both worked as expected.

What I would suggest is to make sure that you have flashed your Digispark correctly, and also make sure that your device has 10K pullup resistors on both SDA and SCL if needed for your device.

I have now merged the PR thank you again for working on this!

I will close this issue after the next release of Gobot.

vendelin8, 2018-08-25:
Ok, finally I was able to make it work. Thanks for the assistance, and for this awesome tool! :)

Thread 593 (2018-08-14):

Allow SetPeriod() in raspi/pwm_pin.go

starryalley, 2018-08-14:
**Summary:**

I think to correctly use pi-blaster on raspberry pi, SetPeriod() in platforms/raspi/pwm_pin.go should be allowed to change the now-constant value of piBlasterPeriod.

**Details:**

On my board I modified pi-blaster CYCLE_TIME_US to suit my application. Only when we allow SetPeroid() to change piBlasterPerioid value, can one correctly use SetDutyCycle() to write correct duty cycle to pi-blaster.

**Example:**

For example, my CYCLE_TIME_US is set to 20000us (which is 20000000ns, currently it's fixed to 10000000). To set 1.5ms PWM signal the correct command to write to `/dev/pi-blaster` is `18=0.075`.  (where 18 is the pin 12). However, the following code
```
pin, _ := r.PWMPin("12")
pin.SetDutyCycle(1.5 * 1000 * 1000)
```
will write `18=0.15`.

deadprogram, 2018-08-15:
Hello, @starryalley that seems like a very useful, and modest change. Perhaps we can just change `piBlasterPeriod` to a public member of the Adaptor ala `PiBlasterPeriod` so it can be set before the work routine starts.

I'd be happy to accept a PR with this update!

starryalley, 2018-08-15:
Thanks for the suggestion and also this great project. I just sent a PR https://github.com/hybridgroup/gobot/pull/594

Let me know what you think.

starryalley, 2018-08-27:
PR merged. Closing.

Closed 2018-08-27.

Thread 600 (2018-08-29):

More than 2 Sphero SPRK+ devices doesn't work

nilskuhn, 2018-08-29:
Hi there,

first of all thanks a lot for the beautiful work. I have a lot of fun with it!

I've created a game server that receives ROLL / ROTATE / SET_RGB - Actions from mqtt topic's which than should be executed by different gobot controlled Sphero SPRK+ bots: https://github.com/iteratec/sphero-rallye-server/blob/master/sphero/sphero.go

Everything works fine so far if I control up to two Spheros. But for more than 2 devices no Bluetooth LE connection gets established :(

I am running the server from my local laptop (Dell Latitude 7480) running kde neon / ubuntu. Can anybody say if I have to do something to establish more than two Bluetooth LE connections? Could it be a hardware limitation? I haven't found anything about it so far. Or is this a bug / problem in Gobot library? Anyone else experiences with Sphero swarms of more than two Sphero SPRK+ bots?

Thanks in advance, Nils

deadprogram, 2018-08-29:
Hello @nilskuhn you probably will need to update your kernel in order to use multiple BLE connections to at least 4.13+ or at least that was my experience.

nilskuhn, 2018-08-30:
```
$ uname -a
Linux iteratec-laptop 4.15.0-32-generic #35~16.04.1-Ubuntu SMP Fri Aug 10 21:54:34 UTC 2018 x86_64 x86_64 x86_64 GNU/Linux
```
By multiple you mean more than two? Because two are already working.

nilskuhn, 2018-09-03:
The problem was my laptop or the kernel version/os on it.
On a raspberry pi version 3 it worked :)

Closed 2018-09-03.

Thread 603 (2018-08-31):

Incorrect data events when having multiple analog sensors with GrovePi

mabu, 2018-08-31:
The step6 program of https://github.com/hybridgroup/gophercon-2018/tree/master/sensor/raspi/ had a couple issues:

- Rotary movement is ignored;
- When the light sensor value changes to X, two messages are produced: "Light: X" and "Dial: X".

If I change the order of devices on [line 75](https://github.com/hybridgroup/gophercon-2018/blob/c8c0466f1425505f0f7acfcb2928f1708b906087/sensor/raspi/step6/main.go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) from "dial, light" to "light, dial", then the other sensor works:

- Light change is ignored;
- When I turn the rotary and its value changes to X, two messages are produced: "Light: X" and "Dial: X".

So, it looks like only the sensor that is listed last in the device slice works, and its events are sent to the handlers of both sensors.

deadprogram, 2018-09-06:
This appears to be an issue with the GrovePi+ as I just brought up here: https://github.com/DexterInd/GrovePi/pull/423

deadprogram, 2019-05-22:
This code was release in v1.13.0 thank you! Now closing.

Closed 2019-05-22.

Thread 609 (2018-09-10):

Bebop 2 doesn't always land when it should

krancour, 2018-09-10:
I'm using the client directly, e.g.:

```
// Connect
bebop := client.New()
if err := bebop.Connect(); err != nil {
	log.Fatalf("Connection error: %s\n", err)
}
log.Println("Connected.")
```

Later, I take off.

My program _ends_ with this:

```
// Land
if err := bebop.Land(); err != nil {
		log.Fatalf("Landing error: %s\n", err)
}
log.Println("We have touch down!")
```

While this program always exits without error, _sometimes_ after doing so, the drone continues flying. The first time this happened, I had to very quickly write a short, new "emergency landing" program that just issues the land command again.

But sometimes the program works as expected.

I am wondering if `bebop.Land()` might sometimes be returning prematurely, before the drone has ACK'ed the request to land.

deadprogram, 2018-09-10:
That is a very possible scenario. Please do report back with whatever you discover!

krancour, 2018-09-11:
@deadprogram I could be reading the bebop client code all wrong, but if I'm not, it looks a lot like the client doesn't receive any state, events, or even acks from the drone. Looking at similar libraries written in other languages, this seems like a conspicuous absence from this one... I'm not sure how to reasonably control a drone when I cannot query any of its state.

deadprogram, 2018-09-11:
The method `packetReceiver()` needs to be extended to parse the messages coming from the Bebop. Please see https://github.com/hybridgroup/gobot/blob/master/platforms/parrot/bebop/client/client.go#L526

Many of the values are already in https://github.com/hybridgroup/gobot/blob/master/platforms/parrot/bebop/client/constants.go and just need to get hooked up.

```go
if frame.Id == int(BD_NET_DC_EVENT_ID) {
    // parse the frame.Data header here
    project := uint(frame.Data[0])
    class := uint(frame.Data[1])
    commandId := int(frame.Data[2]) + int(frame.Data[3]) << 8

    // handle the now identified event...
}
```

For example,

```go
if project == ARCOMMANDS_ID_PROJECT_ARDRONE3 && class == ARCOMMANDS_ID_ARDRONE3_CLASS_PILOTINGSTATE && commandId == ARCOMMANDS_ID_ARDRONE3_PILOTINGSTATE_CMD_FLYINGSTATECHANGED {
    // next 4 bytes contain the actual flying state as little-endian int32
}
```

https://github.com/hybridgroup/gobot/blob/master/platforms/parrot/bebop/client/constants.go

My Bebop drones are currently in storage so I'm sorry I cannot directly help much at the moment. Hopefully this can point you in the right direction.

krancour, 2018-09-11:
Thanks @deadprogram.

As I pour over docs, I'm finding this client somewhat incomplete and out-of-date (as you had acknowledged). It seems the ARNetwork/ARNetworkAL protocol is only partially implemented here-- for instance, there are no retries executed for frames that time out waiting for an ack. Logic for dropping duplicate and out-of-sequence frames in the manner described by the protocol is also missing.

I'm sure you can imagine how the above could be a critical factor in a request to land seemingly having gone unacknowledged.

I'm to actually try my hand at writing a complete ARNetwork/ARNetworkAL protocol library first then I'll retrofit existing commands to use that library. I'll also probably write a layer that consumes device --> client events (much as you suggested in your previous comment) and state information so that it will become possible to do things like "land and then wait for flying state to be 'landed'".

Last, if I nail all of the above (which is all pretty generic / protocol oriented) it may be possible for me pretty easily add client support for dozens of supported commands that aren't included today.

I think in the end, what I'm going to end up with is going to be indistinguishable from the client that exists now, so I'm going to start this effort as its own library and then maybe we can discuss later if / how to fold it back into gobot.

deadprogram, 2018-09-11:
You can certainly do that. However one thing that makes writing it within Gobot a LOT easier is having the whole event system built-in. Check out the Firmata adaptor/client for example of what I mean: https://github.com/hybridgroup/gobot/tree/master/platforms/firmata

In any case, keep us all informed on your progress.

krancour, 2018-09-11:
> However one thing that makes writing it within Gobot a LOT easier is having the whole event system built-in.

Totally agree. However, as it stands now, the bebop client, as you have noted, takes all events that the drone sends it over the ARNetwork protocol and drops them on the floor. Before I can think about propagating such events up to higher levels of abstraction (i.e. a robot), I need to implement some kind of event-handling within the client itself... that's all I was referring to.

deadprogram, 2018-09-12:
So turns out I have 1 of my Bebops in the closet here, not all off them in storage. I will try to take a look at some of this next week.

krancour, 2018-09-25:
@deadprogram I'm closing in on a more complete implementation of the arnetwork and arnetworkal protocols. These will actually wait for acks for outbound data that is intended to receive an ack.

When I am done, I'd be happy to donate those. It should be fairly easy to plug the existing client into that.

I am working on my own client as well because I need a client that receives/understand drone state and makes this available to the client's user. This may be of less interest to you, but I'd be happy to donate that as well if you wanted it.

Closed 2021-09-30.

Thread 610 (2018-09-10):

Bebop 2 start/stop recording doesn't work as expected

krancour, 2018-09-10:
I'm running the latest firmware and I've encountered a few unexpected behaviors with the camera:

1. As soon as a flight begins, video is being captured. This is unexpected, as I would assume it's necessary to call `StartRecording()`.

1. In light of no. 1, I've attempted calling `StopRecording()` before take off-- it has no effect. Video is still captured.

1. Thinking it was possible (but not documented) that `StopRecording()` is only meant to be called after take off, I moved the call to immediately after takeoff. That, too, had no effect and video was captured for the entire duration of the flight.

Bottom line is it's not clear how, if at all, video capture can be suspended.

**EDIT:** I've now also noticed that starting and later stopping a recording while grounded has no effect. i.e. You can't capture video unless you're flying. This _should_ be possible because the Parrot mobile app / controller allows you to do it.

With this added bit of information, I'm questioning whether the start/stop recording functions are doing anything at all.

krancour, 2018-09-10:
@deadprogram it seems there's something in the API for setting whether video is automatically recorded from take off to a moment after landing:

https://github.com/Parrot-Developers/arsdk-xml/blob/master/xml/ardrone3.xml#L2220-L2234

The Bebop client in gobot doesn't seem to expose this. I think it would be easy enough for me to add, but I am trying to understand whatever code generation is in play for generating this client, as many of the functions have an appearance of having been generated.

Any chance of pointing me in the right direction?

deadprogram, 2018-09-10:
All of the Gobot code was written by hand, we do not have a code generator for this task. It certainly would be possible to create one...

krancour, 2018-09-10:
Well... if it's written by hand, that certainly makes it a little easier for me to wrap my head around how to expose this setting. :)

But just to confirm... in the following, example, `ARCOMMANDS_Generator_GenerateARDrone3PilotingTakeOff` in the comment is _not_ indicative of some generation?

```
func (b *Bebop) TakeOff() error {
	//
	//  ARCOMMANDS_Generator_GenerateARDrone3PilotingTakeOff
	//

	cmd := &bytes.Buffer{}

	cmd.WriteByte(ARCOMMANDS_ID_PROJECT_ARDRONE3)
	cmd.WriteByte(ARCOMMANDS_ID_ARDRONE3_CLASS_PILOTING)

	tmp := &bytes.Buffer{}
	binary.Write(tmp, binary.LittleEndian, uint16(ARCOMMANDS_ID_ARDRONE3_PILOTING_CMD_TAKEOFF))

	cmd.Write(tmp.Bytes())

	_, err := b.write(b.networkFrameGenerator(cmd, ARNETWORKAL_FRAME_TYPE_DATA, BD_NET_CD_NONACK_ID).Bytes())
	return err
}
```

deadprogram, 2018-09-10:
That comment was added by hand to provide some reference point back to the original place it came from, which was part of the old Parrot tools. It was never used to generate Go code.

krancour, 2018-09-10:
@deadprogram thanks for the explanation!

Closed 2021-09-30.

Thread 614 (2018-09-12):

Does gobot currently support Raspberry Pi Zero/Raspberry Pi Zero Wireless?

gilgameshskytrooper, 2018-09-12:
I have tried the basic Pi example with the LED and I can't seem to get it to work.

The hardware layout I used was copied from [here](http://www.tom-bennett.co/article/blink-an-led-with-raspberry-pi-zero-and-python). The Python script they provided worked as advertised.

However, using the following code in Go, I cannot seem to get the LED to blink on my Raspberry Pi Zero with the following code:

```go
package main

import (
	"time"

	"gobot.io/x/gobot"
	"gobot.io/x/gobot/drivers/gpio"
	"gobot.io/x/gobot/platforms/raspi"
)

func main() {

	r := raspi.NewAdaptor()
	led := gpio.NewLedDriver(r, "17")

	work := func() {
		gobot.Every(1*time.Second, func() {
			led.Toggle()
		})
	}

	robot := gobot.NewRobot("blinkBot",
		[]gobot.Connection{r},
		[]gobot.Device{led},
		work,
	)

	robot.Start()

}
```
I also tried using pin "13" since technically, the board numbering is 13.

gilgameshskytrooper, 2018-09-12:
Also tried the idiomatic method.

```go
package main

import (
	"time"

	"gobot.io/x/gobot/drivers/gpio"
	"gobot.io/x/gobot/platforms/raspi"
)

func main() {

	r := raspi.NewAdaptor()

	led := gpio.NewLedDriver(r, "17")
	led.Start()

	for {
		led.Toggle()
		time.Sleep(1000 * time.Millisecond)
	}

}
```

(And I tried `13`)

lucavallin, 2018-09-16:
Not sure if the case, but remember to add these flags when compiling:

`GOOS=linux GOARCH=arm GOARM=6 go build`

I remember I had some issue because of the missing GOARM

gilgameshskytrooper, 2018-09-17:
I believe this was a hardware issue. Sorry to bother you guys!

Closed 2018-09-17.

Thread 620 (2018-09-16):

No event emitted when reading from Grove Light Sensor via GrovePi

lucavallin, 2018-09-16:
```
r := raspi.NewAdaptor()
	gp := i2c.NewGrovePiDriver(r)
	light := aio.NewGroveLightSensorDriver(gp, "A2")

	work := func() {
		light.On("data", func(data interface{}) {
			fmt.Println(data)
		})
	}

	robot := gobot.NewRobot("hytta",
		[]gobot.Connection{r},
		[]gobot.Device{gp, light},
		work,
	)

	robot.Start()
```

That event never fires, if I "force" with light.Read() what I get back as value is -1. Is it an issue with Gobot or something else?

lucavallin, 2018-09-16:
Hello, just updated, it works! Thanks!

deadprogram, 2018-09-29:
OK now closing. Thanks for confirming that it works! :)

Closed 2018-09-29.

Thread 623 (2018-09-24):

platforms/chip: quickstart sample/doc broken

ahmetb, 2018-09-24:
I'm following https://gobot.io/documentation/platforms/chip/ on macOS and seeing a compilation error in the sample program:

    undefined: gobot.On

## Repro steps

I ran `go get -d -u gobot.io/x/gobot/...` (worked)

Pasted the sample listed to main.go:

```
package main

import (
    "fmt"

    "gobot.io/x/gobot"
    "gobot.io/x/gobot/drivers/gpio"
    "gobot.io/x/gobot/platforms/chip"
)

func main() {
    chipAdaptor := chip.NewAdaptor()
    button := gpio.NewButtonDriver(chipAdaptor, "XIO-P0")

    work := func() {
        gobot.On(button.Event("push"), func(data interface{}) {
            fmt.Println("button pressed")
        })

        gobot.On(button.Event("release"), func(data interface{}) {
            fmt.Println("button released")
        })
    }

    robot := gobot.NewRobot("buttonBot",
        []gobot.Connection{chipAdaptor},
        []gobot.Device{button},
        work,
    )

    robot.Start()
}
```

then I ran `GOARM=7 GOARCH=arm GOOS=linux go build .` as instructed and this cmd gives error:

    ./main.go:16:9: undefined: gobot.On
    ./main.go:20:9: undefined: gobot.On

ahmetb, 2018-09-24:
similarly chip-pro instructions are broken, too https://gobot.io/documentation/platforms/chip-pro/

It seems like `gobot.On` isn't really a thing anymore. But I can't really find an `On` method for `platforms/chip` package to handle button press to refactor/fix the example code.

Skgamer38, 2020-03-25:
I have an arduino nano with a atmel atmega328p microcontroller and idk if it can emulate a HID, to act like a keyboard and mouse. Someone can help me?

gen2thomas, 2023-07-07:
Also there is a mismatch in dragonboard docu and example. I will fix this together.

gen2thomas, 2023-10-30:
available since v2.2.0

Closed 2023-10-30.

Thread 625 (2018-09-27):

How would you "abstract" the readable devices?

lucavallin, 2018-09-27:
To reduce boilerplate, I am using something like the following:

```
	var sensors map[string]gobot.Device
	sensors["sound"] = aio.NewGroveSoundSensorDriver(gp, "A0")
	sensors["temperature"] = aio.NewGroveTemperatureSensorDriver(gp, "A1")
	sensors["light"] = aio.NewGroveLightSensorDriver(gp, "A2")

	work := func() {
		gobot.Every(timeInterval, func() {
			for name, driver := range sensors {
				val, _ := driver.Read()
				json, _:= json.Marshal(messages.NewReading(name, val))
				mqttAdaptor.Publish("from", json)
			}
		})
	}
```

This won't compile since gobot.Device does not implement a Read() method. Any idea?

lucavallin, 2018-10-05:
I see this is tagged as enhancement, but in the meantime, do you have any suggestions about how to wrap this up? Maybe by wrapping each sensor in some object which implements an interface, and then having a big list of sensors to loop through?

gen2thomas, 2023-07-07:
Hi @lucavallin , IMO this can be solved now by using "AnalogSensorDriver".

old: `var sensors map[string]gobot.Device`
new: `var sensors map[string]aio.AnalogSensorDriver`

Best regards Thomas

gen2thomas, 2023-07-07:
A more generic solution (interfaces in Go at client side):
```
type MyReader interface {
	Read() (float64, error)
}

func main() {
	gp := edison.NewAdaptor()

	sensors := make(map[string]MyReader)
	sensors["sound"] = aio.NewGroveSoundSensorDriver(gp, "A0")
	sensors["temperature"] = aio.NewGroveTemperatureSensorDriver(gp, "A1")
	sensors["light"] = aio.NewGroveLightSensorDriver(gp, "A2")
...
```

gen2thomas, 2023-11-10:
I'm going to close this issue, because this is more programming language related and do not affect gobot.

Closed 2023-11-10.

Thread 639 (2018-11-18):

lsm303DLHC Magnetometer output not updating

jobale, 2018-11-18:
Hello,
I am currently trying to write a driver for the **lsm303DLHC** sensor. It's a part of [Adafruit 9DOF sensor](https://learn.adafruit.com/adafruit-9-dof-imu-breakout) composed of l3gd20h and [lsm303DLHC](https://www.google.com/url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).
I can successfully read l3gd20h sensor and the lsm303DLHC's accelerometer output but I have a problem with the magnetometer: I can read all 3 values, but they are not updated. I am stuck with the same outputs values.

I precise the sensor works perfectly with an arduino and Adafruit C++ library.

### Devices used

 - Raspberry Pi 2 with raspbian - i2c enabled - /dev/i2c-1 working
 - Adafruit 9DOF sensor composed of l3gd20h + lsm303DLHC

### Details
The magnetometer output is composed of 6 registers continuously updated.
The sensor automatically increment the register address when you read the output (default behavior).

If I am not mistaken, here is how it goes:
 - Master write to 1st output register to initiate output reading
 - lsm303 device send back the 1st register output value
 - Master send **ACK** signal after reading the first output value
 - lsm303 receive the **ACK** signal, increment the register address and transmit the 2nd value
 - Master receive the 2nd output, etc...
 - lsm303 device send back the 6th and **last** output value and wait for a **NACK** signal this time.

 This is where the problem lies I think: If the lsm303 sensor receive a **NACK** signal it update the output values. If it receive an **ACK** signal, it doesn't update and just send the next output value (if any).
 So after sending the 6th and last register output, the sensor wait for a different signal before updating the outputs values. It wait for a **NACK** signal. Not an **ACK**.

 I based my opinion  [on this stackexchange post ](https://electronics.stackexchange.com/questions/101753/stm32f3discovery-lsm303dlhc-magnetic-field-data-not-updating) (read the last post)

Official [lsm303DLHC Datasheet](https://www.google.com/url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) doesn't mention any of this.

The lsm303DLHC works with an arduino. So I am wondering:
Does the raspberry pi 2 send a NACK signal automatically at the end of a buffer read ?
I looked at the [SMSBus and i2c documentation in the linux kernel](https://www.kernel.org/doc/Documentation/i2c/functionality) but I didn't found yet a definitive answer to my question.

I tried using [i2c_Device.go](https://github.com/hybridgroup/gobot/blob/master/sysfs/i2c_device.go) functions directly without success. I tried reading the value with *ReadByteData()* function. Nothing change. Same output every loop.

## My driver code to read the magnetometer output

    const lsm303RegisterMagOutXLSB = 0x03

    // MagneticField returns the magnetic field value for the 3 axis
	// result's unit is in microTesla (mT)

	func (d *LSM303Driver) MagneticField() (x, z, y float32, err error) {
	if _, err = d.connection.Write([]byte{lsm303RegisterMagOutXLSB}); err != nil {
		return 0, 0, 0, err
	}

	measures := make([]byte, 6)
	if _, err = d.connection.Read(measures); err != nil {
		return 0, 0, 0, err
	}

	var rawXh, rawXl, rawZh, rawZl, rawYh, rawYl uint8

	buf := bytes.NewBuffer(measures)

	binary.Read(buf, binary.BigEndian, &rawXh)
	binary.Read(buf, binary.BigEndian, &rawXl)
	binary.Read(buf, binary.BigEndian, &rawZh)
	binary.Read(buf, binary.BigEndian, &rawZl)
	binary.Read(buf, binary.BigEndian, &rawYh)
	binary.Read(buf, binary.BigEndian, &rawYl)
	...
	x := ...
	y := ...
	z := ...
	return x, z, y, nil
    }

This code is stripped of error check and unit conversion for readability.

Thanks for taking the time to read this. I tried to submit this problem the right way. I apologize if I miss or broke any rule doing it.

jobale, 2018-11-21:
I managed to get updated magnetic field values now. My code works from that point of view. My displaying of measures was the culprit. It wasn't precise enough to see the variations, hence the false impression of a never updated output. Nothing related to i2c protocol.

As for the raspberry pi 2 itself and i2c protocol I learn the following:

- It doesn't implement all SMBUS  functions on linux. To know which subset is available on your platform you can use this command on linux: `i2cdetect -F 1` (or i2cdetect -F X if you use bus X). Raspberry Pi2 lacks 2 functions: `SMBus Block Read` and `SMBus Block Process Call`.

- If you want know more about SMBus protocol you can read [this documentation on kernel.org.](https://www.kernel.org/doc/Documentation/i2c/smbus-protocol). It contains the breakdown of each SMBus function (ACK,NACK,STOP signals and more)

I still have to make sense of those outputs values. They are quite strange but this is another story ;-)
 This issue is without purpose now so I close it.

gen2thomas, 2022-10-19:
Hi @jobale , thanks for pointing this out and try to provide a new driver. Sorry for the long delay. Meanwhile I have changed and fixed some i2c related behavior (currently available on "dev" branch). Possibly your driver will now work. It would be helpful if you can provide a branch or a Draft-PR to find some further problems.

jobale, 2022-10-19:
Hi @gen2thomas, Thanks for the attention. Just to inform hybridgroup/Gobot that I won't be able to help anymore on this issue: I don't write in Go anymore and I don't have lsm303DLHC chip anymore :-( . Sorry.

gen2thomas, 2022-10-19:
@jobale thanks for the fast reply. IMO the device request can be left open. I will try to order the module and implement the driver, based on your work. Thanks again!

Closed 2018-11-21.

Thread 641 (2018-11-27):

* The system cannot find the path specified.

recabyte008, 2018-11-27:
Install gobot and gort with firmata for Arduino on Windows 10.

go run the following sample code :
package main

import (
        "time"
        "gobot.io/x/gobot"
        "gobot.io/x/gobot/drivers/gpio"
        "gobot.io/x/gobot/platforms/firmata"
)

func main() {
        firmataAdaptor := firmata.NewAdaptor("/dev/ttyACM0")
        led := gpio.NewLedDriver(firmataAdaptor, "13")

        work := func() {
                gobot.Every(1*time.Second, func() {
                        led.Toggle()
                })
        }
        robot := gobot.NewRobot("bot",
                []gobot.Connection{firmataAdaptor},
                []gobot.Device{led},
                work,
        )
        robot.Start()
}

Error Message :

D:\go\projects>go run test1.go
2018/11/27 12:28:19 Initializing connections...
2018/11/27 12:28:19 Initializing connection Firmata-1FAE66071409C015 ...
2018/11/27 12:28:19 Initializing devices...
2018/11/27 12:28:19 Initializing device LED-76D7E1BEAB86A5DF ...
2018/11/27 12:28:19 Robot bot initialized.
2018/11/27 12:28:19 Starting Robot bot ...
2018/11/27 12:28:19 Starting connections...
2018/11/27 12:28:19 Starting connection Firmata-1FAE66071409C015 on port ./dev/ttyACM0...
2018/11/27 12:28:19 1 error occurred:
        * The system cannot find the path specified.

How to solve this problem

deadprogram, 2018-11-28:
Hello @recabyte008 when using Windows your port for connecting to the Arduino is named differently than on Linux. See https://github.com/hybridgroup/gobot/tree/master/platforms/firmata#windows for more information.

trevrosen, 2018-12-17:
Do we need further work on this issue or can I close?

Closed 2019-01-02.

Thread 644 (2018-12-15):

Set QoS for MQTT Publish/Subscribe

wieringen, 2018-12-15:
It would be nice to be able to set the QoS when subscribing/publishing to events. The config stream in google cloud iot-core for instance recommends a QoS of 1.

trevrosen, 2018-12-17:
@deadprogram the QoS is currently hardcoded to `0` in the [subscription code](https://github.com/hybridgroup/gobot/blob/master/platforms/mqtt/mqtt_adaptor.go#L142) and also in the [publishing code](https://github.com/hybridgroup/gobot/blob/master/platforms/mqtt/mqtt_adaptor.go#L133). I can alter this API to allow a user to set in a variety of ways, but I'm looking to you for your opinion/direction here. For instance, variadic argument added to the function calls would be backwards compatible, but also kind of a hack. We could also add new version of the functions (not a big fan of that idea) or we could just live with a backwards-incompatible change (tho I'm not sure what that does to our semver assertions b/c I'm not certain what's covered by the versioning yet).

deadprogram, 2018-12-17:
Seems like adding a method like `SetQoS(val int)` to allow overriding this value, and keeping a sensible default, is the least intrusive. What do you think?

trevrosen, 2018-12-17:
yeah that can work as long we we're not looking for per-message granularity

deadprogram, 2018-12-17:
That works for me, since that is mostly how the current use case is setup.

wieringen, 2018-12-19:
You guys are fast! However I do think this needs to be granular for every subscription.
Take a look at this example from Google:
https://github.com/GoogleCloudPlatform/nodejs-docs-samples/blob/master/iot/mqtt_example/cloudiot_mqtt_example_nodejs.js

On line 257 you will see this:
```
// Subscribe to the /devices/{device-id}/config topic to receive config updates.
// Config updates are recommended to use QoS 1 (at least once delivery)
client.subscribe(`/devices/${argv.deviceId}/config`, {qos: 1});

// Subscribe to the /devices/{device-id}/commands/# topic to receive commands
// commands is recommended to use QoS 0 (at most once delivery)
client.subscribe(`/devices/${argv.deviceId}/commands/#`, {qos: 0});
```

trevrosen, 2018-12-19:
Yeah I tend to agree. Your only other option here would be to setup / teardown multiple clients, which would likely have other issues.

@deadprogram I think we're down to either:

1. Variadic arg at the end of the existing function signature
2. A totally new function/interface
3. Altering the existing function signature (backwards-incompatible change)

Let me know which you prefer and I'll make it happen. I'm currently leaning toward **1** as it solves the current issue and doesn't break back compat.

wieringen, 2018-12-19:
New methods and deprecating the old ones seems reasonable?

trevrosen, 2018-12-19:
Yeah honestly it's more about how @deadprogram wants to manage the semver implications of a back-incompat change in this area of Gobot.

trevrosen, 2019-01-02:
I like it. I'll make it happen.

trevrosen, 2019-01-03:
@wieringen check it out and let me know what you think: https://github.com/hybridgroup/gobot/pull/650

Closed 2019-01-26.

Thread 648 (2018-12-31):

NewRelayDriver should allow for creating inverted relay

andrewebdev, 2018-12-31:
Currently `.On()` sets the relay state to high, and `.Off()` sets the relay state to low.

We have realays boards in one of our projects that are actually inverted.
This causes us to do things in the code like `relayDriver.On()` when we want it switched off, and of course it leads to some confusion down the line.

It may be a good idea for NewRelayDriver to allow for this use case?

deadprogram, 2019-05-31:
Seems like a good idea. A PR that added this would be gladly accepted.

andrewebdev, 2019-06-15:
@deadprogram just a ping to remind that I have done a PR for this. (just in case this issue was overlooked)

kneerunjun, 2019-10-16:
```go
func (l *RelayDriver) On() (err error) {
	if err = l.connection.DigitalWrite(l.Pin(), 1); err != nil {
		return
	}

	if l.Inverted {
		l.high = false
	} else {
		l.high = true
	}

	return
}
```
I notice you are still writing 1 to DigitalWriter (Outside the Inverted if logic) in Driver.On - this is hardly helping. Most of the relays close NO-C on LOW ! Wouldn't it help to check Inverted before you DigitalWrite 1.

stuartleeks, 2020-03-29:
As @kneerunjun noted, `On()` always writes `1` and `Off()` always write `0`. I expected `inverted` to invert the value that was written as well. Unfortunately this means that I'm still having to use `Off()` to turn on the component attached to the relay.

Would you accept a PR that takes the `Inverted` field into account when writing?

deadprogram, 2020-03-29:
Yes, please, and thanks!

stuartleeks, 2020-03-29:
Great :-)

andrewebdev, 2020-03-31:
@stuartleeks Thank for this. I saw this email yesterday and was going to start updating this today; Then I noticed you already submitted a pull request :)

Not sure how I missed that it still writes 1 instead of 0. Our code that uses this functionality is currently still doing the old manual if-check, so we never actually caught this bug in our code.

Good job catching it!

stuartleeks, 2020-03-31:
Thanks @andrewebdev. I was working on a home project with my raspberry pi and thought I'd misunderstood gobot or mis-wired my relay. After checking my circuits and code I started digging in to the gobot code and found what @kneerunjun described which led me to this issue.

Hopefully we can get the PR merged and the change released soon, and then I can use the `Inverted` setting and remove the big `NOTE` comment I have in my code explaining the use of `Off()` for `On()` :grin:

gen2thomas, 2023-01-28:
Seems to be fixed. Otherwise please try "WithPinActiveLow()", available on "dev" branch.

Closed 2023-01-28.

Thread 649 (2019-01-02):

Raspi SPI seems to disconnect

schmorrison, 2019-01-02:
Hello,

I am using GoBot in a project that uses the Raspberry Pi and the MCP3008 driver to read analog sensors over SPI. It works nearly perfectly, however after about 5 days, sometimes as long as 20 days, the program stops reading analog values. Errors do not seem to be returned in the calls to the MCP3008 device. But I do get a SPI device already disconnected error when shutting down the program after the problem occurs.

I am not very familiar with the Debian SPI device so debugging this problem is a bit beyond me. Any help would be appreciated.

Thanks and happy new year.

trevrosen, 2019-02-13:
@schmorrison thanks for your interest in Gobot, and apologies for getting back late on this. Unfortunately we don't have the bandwidth to help folks debug their individual devices over GitHub. You can always reach out on Gopher Slack in #gobot and frequently there's someone there who'll have some insights.

Closed 2019-02-13.

Thread 661 (2019-03-29):

macOS BLE stack requires update for Mojave

mrubelmann, 2019-03-29:
I'm trying to run both of the BB-8 example programs on macOS, but it won't connect to the device.  It gets as far as trying to start the connection, but then never makes it into the work() function.  I added `println("In work")` to the top of work(), but as you can see, it never gets called:

```
bash-3.2$ GODEBUG=cgocheck=0 go run examples/bb8.go BB-FCOB
2019/03/28 23:37:55 Initializing connections...
2019/03/28 23:37:55 Initializing connection BLEClient-76ABEF2F2928F188 ...
2019/03/28 23:37:55 Initializing devices...
2019/03/28 23:37:55 Initializing device BB8-6C8E7A10A90D57A9 ...
2019/03/28 23:37:55 Robot bbBot initialized.
2019/03/28 23:37:55 Starting Robot bbBot ...
2019/03/28 23:37:55 Starting connections...
2019/03/28 23:37:55 Starting connection BLEClient-76ABEF2F2928F188...
```

Is it possible that the firmware has changed and the gobot driver no longer works, or am I just doing something wrong?

mrubelmann, 2019-04-16:
It turns out this is a Mac issue.  I couldn't get it to work on Mojave (10.14.4), but it's working on Ubuntu.

deadprogram, 2019-05-31:
It would be great to get some people to collaborate on macOS BLE stack updates for Go. Anyone who might want to help out and knows CGo please make yourself known! :)

deadprogram, 2019-10-25:
The https://github.com/raff/goble repo has been updated for macOS Catalina.

Also this fork of the original `gatt` package seems active https://github.com/bettercap/gatt

Bit of history, Gobot originally used gatt... seems funny to imagine going back.

Just wondering out loud if anyone would be able to look at replacing `go-ble` in Gobot with this fork of `gatt`?

gen2thomas, 2024-11-01:
Hi @mrubelmann , @deadprogram can we close this issue, maybe because we has updated our BLE drivers or Mojave is out of interest?

Thanks Thomas

deadprogram, 2024-11-01:
Closing as no longer needed.

Closed 2024-11-01.

Thread 663 (2019-04-11):

SSD1306 Screen garbled

TinHead, 2019-04-11:
Hello,

I know you can't possibly support all variants of those displays but here we go.

I have one of these:
https://www.aliexpress.com/item/0-96-Inch-SPI-OLED-Display-Module-White-blue-color-128X64-OLED-7Pin-Yellow-blue/32850341305.html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

The blue one and yes *spi* setup by default. I have modded it to i2c by moving r3 resistor to r1 and bridging r8.

I have tested it with adafruit https://github.com/adafruit/Adafruit_SSD1306 and it worked flawlessly after setting the i2c address to 0x3c, as opposed to the default 0x3d on the original ones.

Then I have tried it with gobot using the same arduino nano running firmata and the ssd1306 i2c driver in the master branch, and after fiddling with toggling the RES pin to reset the display I had it turn on and display .... completely random pixels. And this is where I'm stuck.

Questions:
1. In the datasheet and the adafruit code the 0x00 byte is used to signal a command and 0x40 to signal data however in gobot we send 0x80 for command ... Why?
2. Transfer speed seems a lot slower than adafruit looking at the scope ... 100kHz vs 400kHz is i2c bus setup to 100kHz in Gobot? Could not find anywhere.
3. Anyone else seen these issues?

Thank you,
Razvan

deadprogram, 2019-05-31:
You might want to try the latest release of Gobot as there are several commits from @ulisesflynn specific to these displays.

The I2C bus speed is usually determined on the host system, and depends on what it can support. The devices are usually more tolerant of different speeds/volatages than the hosts are capable of varying.

Anyhow, hope that helps. I use a couple of variations of these displays with no problems, but YMMV.

TinHead, 2019-05-31:
Hi,
OK I'll try the updated version, also next week I'll be able to try some factory I2C displays which I have ordered.

Thanks for your reply and keep up the good work :)

TinHead, 2019-07-14:
Closing as i don't really had much time to play.

Closed 2019-07-14.

Thread 684 (2019-07-21):

github.com/gobuffalo/uuid syntax error on Raspbian

paul-wolf, 2019-07-21:
Trying to run example on Raspberry PI 3 from <https://gobot.io/documentation/getting-started/> that makes an LED light blink and getting this error:

```
# github.com/gobuffalo/uuid
../../go/src/github.com/gobuffalo/uuid/generator.go:44: syntax error: unexpected = in type declaration
```

Am I missing something?

System info:
```
pi@raspberrypi:~/prj/gobot $ cat /etc/debian_version
9.4
pi@raspberrypi:~/prj/gobot $ cat /etc/os-release
PRETTY_NAME="Raspbian GNU/Linux 9 (stretch)"
NAME="Raspbian GNU/Linux"
VERSION_ID="9"
VERSION="9 (stretch)"
pi@raspberrypi:~/prj/gobot $ cat /proc/cpuinfo
processor       : 0
model name      : ARMv7 Processor rev 4 (v7l)
BogoMIPS        : 38.40
Features        : half thumb fastmult vfp edsp neon vfpv3 tls vfpv4 idiva idivt vfpd32 lpae evtstrm crc32
CPU implementer : 0x41
CPU architecture: 7
CPU variant     : 0x0
CPU part        : 0xd03
CPU revision    : 4

Hardware        : BCM2835
Revision        : a22082
Serial          : 00000000d8172f8c
```

deadprogram, 2019-08-12:
Perhaps is a breaking change in the `uuid` package. You might want to install the v2.0.5 version as is specified here https://github.com/hybridgroup/gobot/blob/master/Gopkg.lock#L64

paul-wolf, 2019-08-13:
Thanks, @deadprogram. I appreciate it.

redmercury, 2019-09-08:
Sounds like it might be a go version issue?

https://github.com/google/go-jsonnet/issues/172

Closed 2019-08-13.

Thread 685 (2019-07-29):

Beaglebone Green: GPIO already exported

akhudek, 2019-07-29:
On the Beaglebone Green it turns out that GPIO pins start already exported. This causes Gobot to fail on the first run because it can't export the already exported pin. However, once Gobot shuts down, it unexports the pins and subsequently works on being restarted.

This is easy enough to work around by manually unexporting pins on device boot, but it would be nice if Gobot either more gracefully handled this situation or at least provided a way for the user to handle it.

akhudek, 2019-08-04:
Actually, this is way more complicated. Turns out the beaglebone exports all the pins by default, and unexport doesn't work, it just errors out. But, if you try to export an already exported pin, *it unexports* it. Obviously unwanted behaviour.

I have a patch for gobot that checks if the pin is already exported, but it's also more complicated than I thought due to some fixed needed to the gobot testing system. Not sure if it's worth doing a PR for this given it should probably be fixed in the beaglebone firmware.

gen2thomas, 2024-11-01:
Hi @akhudek , do you know, if this is fixed now in BB green?

Thanks Thomas

akhudek, 2024-11-01:
No clue, it's been years since I've used a beaglebone at this point. Usually I just get pi's now.

gen2thomas, 2024-11-01:
Thanks for the fast response, so I'm going to close this issue, because out of interest.

Closed 2024-11-01.

Thread 691 (2019-09-15):

How do I use gobot to control servo on raspberry pi?

erkexzcx, 2019-09-15:
Hi. Spent several hours trying to find any tutorial or documentation on how to control servo on raspberry pi using gobot.

No documentation there: https://gobot.io/documentation/drivers/servo/

Nothing is working from here either: https://github.com/hybridgroup/gobot/issues/166 (tried code from there as well).

Currently trying this code, but nothing is working. My C code works just fine on raspberry pi to control servo, but can't get it to work on gobot. This is the code I am trying to use:
```go
package main

import (
        "log"
        "time"

        "gobot.io/x/gobot"
        "gobot.io/x/gobot/drivers/gpio"
        "gobot.io/x/gobot/platforms/raspi"
)

func main() {
        r := raspi.NewAdaptor()
        servo := gpio.NewServoDriver(r, "18")
        work := func() {
                gobot.Every(2*time.Second, func() {
                        i := uint8(gobot.Rand(180))
                        log.Printf("Moving servo to %d", i)
                        servo.Move(i)
                })
        }

        robot := gobot.NewRobot("blinkBot",
                []gobot.Connection{r},
                []gobot.Device{servo},
                work,
        )

        robot.Start()
}
```
Output:
```
2019/09/15 17:47:31 Initializing connections...
2019/09/15 17:47:31 Initializing connection RaspberryPi-FDF7316 ...
2019/09/15 17:47:31 Initializing devices...
2019/09/15 17:47:31 Initializing device Servo-AD871A0 ...
2019/09/15 17:47:31 Robot blinkBot initialized.
2019/09/15 17:47:31 Starting Robot blinkBot ...
2019/09/15 17:47:31 Starting connections...
2019/09/15 17:47:31 Starting connection RaspberryPi-FDF7316...
2019/09/15 17:47:31 Starting devices...
2019/09/15 17:47:31 Starting device Servo-AD871A0 on pin 18...
2019/09/15 17:47:31 Starting work...
2019/09/15 17:47:33 Moving servo to 100
2019/09/15 17:47:35 Moving servo to 47
2019/09/15 17:47:37 Moving servo to 3
2019/09/15 17:47:39 Moving servo to 80
```
But servo is not moving. It is connected it to `GPIO18`.

Any help is appreciated.

erkexzcx, 2019-09-16:
What I found out when I tested go program using LED that I need to use is index number of pin, not GPIO pin number.

For example:
- `GPIO18` - incorrect
- `18` - incorrect
- `12` - **OK**

But that still doesn't change the fact that I can't get servo to work...

deadprogram, 2019-09-16:
Please see our docs page https://gobot.io/documentation/platforms/raspi/ for the section labeled "Enabling PWM output on GPIO pins."

Hope that helps!

erkexzcx, 2019-09-16:
So these are the instructions:
1. Set-up [pi-blaster](https://github.com/sarfata/pi-blaster) on Raspberry pi.
2. Connect servo to Raspberry Pi, to pin 12 (`GPIO18`). Note that `gobot` uses pin index numbers.
3. Create file `servo.go` on your raspberry pi:
```go
package main

import (
        "log"
        "time"

        "gobot.io/x/gobot"
        "gobot.io/x/gobot/drivers/gpio"
        "gobot.io/x/gobot/platforms/raspi"
)

func main() {
        adaptor := raspi.NewAdaptor()
        servo := gpio.NewServoDriver(adaptor, "12")

        work := func() {
                gobot.Every(1*time.Second, func() {
                        i := uint8(gobot.Rand(180))
                        log.Printf("Moving servo to %d", i)
                        servo.Move(i)
                })
        }

        robot := gobot.NewRobot("Servo robot",
                []gobot.Connection{adaptor},
                []gobot.Device{servo},
                work,
        )

        robot.Start()

}
```
4. Compile it `go build servo.go`.
5. Run it `./servo.go`. Try it as root if it doesn't work (I have this issue) with command `sudo ./servo.go`.

Servo works, but somewhat not as expected (randomly doesn't work), but this is different issue anyway.

Closed 2019-09-16.

Thread 692 (2019-09-16):

Raspi servo does not work as expected

erkexzcx, 2019-09-16:
**Description**

So servo should do a 180 degrees spin using this code:
```go
package main

import (
	"time"

	"gobot.io/x/gobot/drivers/gpio"
	"gobot.io/x/gobot/platforms/raspi"
)

func main() {
	adaptor := raspi.NewAdaptor()
	adaptor.Connect()

	servo := gpio.NewServoDriver(adaptor, "12")
	servo.Start()

	for i := uint8(0); i <= 180; i++ {
		servo.Move(i)
		time.Sleep(100 * time.Millisecond)
	}
}
```
To be exact, this below code should do a 180 degree servo spin:
```go
for i := uint8(0); i <= 180; i++ {
	servo.Move(i)
	time.Sleep(100 * time.Millisecond)
}
```
So according to documentation, `gpio.NewServoDriver` provides function `Move(uint8)` that expects numbers from 0 to 180 (represents a servo degree).

Unfortunately, my servo from AliExpress (says it's _Tower Pro Micro Servo 9G SG90_) does a full rotation on a range between 9 to 45, so range from 0 to 180 is useless and does not work correctly.

**Expected behavior**

Servo fully rotates to one side when I set `Move(0)` and should do 180degree spin when I set `Move(180)`.

**Actual behavior**

Servo doesn't do anything when I set `Move(0)` and doesn't do anything when I set `Move(180)`.

Instead, It fully rotates to one side when I set `Move(9)` and fully rotates to another side when I set `Move(45)`.

**Additional notes**

This is not an issue. It's just different servo. Tower Pro SG90 has pulse width of 500-2400 µs and it also struggles with pi-blaster as well (acceptable values are from 0.05 to 0.25 for 180 degree spin).

Is it possible to change some settings or set pulse width in gobot?

erkexzcx, 2019-09-16:
Below code works as expected:
```go
package main

import (
	"time"

	"gobot.io/x/gobot/platforms/raspi"
)

func main() {
	adaptor := raspi.NewAdaptor()
	adaptor.Connect()

	for i := uint8(0); i <= 180; i++ {
		adaptor.ServoWrite("12", i)
		time.Sleep(40 * time.Millisecond)
	}
}
```

Why is everything so complicated? :(

erkexzcx, 2019-09-16:
This is likelly my own issue. `Tower Pro SG90` has pulse width of `500-2400 µs`.

Is it possible to change it?

pancakestack-io, 2022-03-19:
hi @erkexzcx

i know it has been super long since you posted this - but this helped me solve my issues. i can also only rotate 45 which ends up being 180 degrees. i am not sure if it is that the smaller servos only move in 4 degree increments or what.  if you managed to change it to move 180 degree angle let me know or if you kept it at every 1 = 4 degrees

gen2thomas, 2022-09-20:
It looks like the "servo_driver.go" needs additional parameters, e.g. NewServoDriver(a, pin, minValue, maxValue) or, much better, we should add the options functionality like i2c drivers have (e.g. "WithLimits(min, max)").

I think this would be a nice enhancement.

gen2thomas, 2023-11-10:
I'm going to close this issue as a duplicate, because it is now referenced by an issue which collect all the various problems with raspi and gpio.servo.

Closed 2023-11-10.

Thread 698 (2019-09-27):

[i2c] Example rotary sensor code on grovepi with raspi doesn't work

didrocks, 2019-09-27:
With latest gobot v1.13.0.

Trying to run the example rotary sensor code doesn't seem to work: https://github.com/hybridgroup/gobot/blob/master/examples/raspi_grove_pi_rotary.go.
My rotary sensors is connected to A1 as well, and no callback for the "On" event is called when rotating it.

Note that the rotary sensor is functional, a minimal program using `grovepi.go` directly works:
```golang
package main

import (
	"fmt"
	"log"
	"time"

	"github.com/didrocks/foo/grovepi"
)

func main() {
	var g grovepi.GrovePi
	g = *grovepi.InitGrovePi(0x04)
	err := g.PinMode(grovepi.A1, "input")
	if err != nil {
		fmt.Println(err)
	}

	t := time.NewTicker(time.Second)
	defer t.Stop()
	for {
		select {
		case <-t.C:
			i, err := g.AnalogRead(grovepi.A1)
			if err != nil {
				log.Printf("couldn't read value from rotary sensor: %v\n", err)
			}
			fmt.Println(i)
		}
	}
}
```

However, you can't mix this code of code with gobot, as after initializing gobot, the values returned by an `g.AnalogRead()` call always return the max value (I think gobot initialization change some gpio operation state?).

erkexzcx, 2019-12-08:
https://github.com/hybridgroup/gobot/issues/692

It's broken - this framework is useless for me. Instead I am using below code for my automation:

```
package main

import (
        "fmt"
        "log"
        "net/http"
        "time"

        piblaster "github.com/ddrager/go-pi-blaster"
)

const pin = 18 // GPIO18
var blaster = piblaster.Blaster{}

func main() {

        // Initialize blaster
        blaster.Start([]int64{pin})

        // Do a servo routine
        for i := 0; i < 7; i++ {
                setAngle(142)
                time.Sleep(600 * time.Millisecond)
                setAngle(129)
                time.Sleep(120 * time.Millisecond)
        }
        setAngle(48)

}

// Move servo to requested angle
func setAngle(angle uint8) {
        blaster.Apply(pin, angleToServo(angle))
}

// helper function - converts angle to servo value (aka 'map' function)
func angleToServo(val uint8) float64 {
        return (float64(val)-0)*(0.25-0.05)/(180-0) + 0.05
}

```

gen2thomas, 2024-11-01:
Hi @didrocks , the driver was reworked a bit in the last years. Do you be able to re test it?

Thanks Thomas

gen2thomas, 2025-02-15:
I'm going to close this issue due to no response and maybe it is working now after heavily rework.

Closed 2025-02-15.

Thread 700 (2019-10-20):

Spi panics when closing program with Raspberry and mcp3008

tux-eithel, 2019-10-20:
Hello!

I'm using gobot @ 1.14.0, but the problem occurs also with 1.13.0.

I'm having a panic when I hit ctrl-c to close my program. Let's see the details.

## What

I'm doing a simple example with mcp3008 chip and RaspberryPI. All works fine, until ctr-c is hit and the software crash. This is the stack:

```
^C2019/10/20 14:57:58 Stopping Robot Light Sensor ...
panic: runtime error: invalid memory address or nil pointer dereference
[signal SIGSEGV: segmentation violation code=0x1 addr=0x10 pc=0xec6a4]

goroutine 1 [running]:
periph.io/x/periph/host/sysfs.(*SPI).Close(0x1cb2000, 0x0, 0x0)
	/home/example-user/Go/pkg/mod/periph.io/x/periph@v3.6.2+incompatible/host/sysfs/spi.go:62 +0x70
gobot.io/x/gobot/drivers/spi.(*SpiConnection).Close(0x1c840c0, 0x1c6a8c0, 0x1c63e1c)
	/home/example-user/Go/pkg/mod/gobot.io/x/gobot@v1.14.0/drivers/spi/spi.go:69 +0x28
gobot.io/x/gobot/platforms/raspi.(*Adaptor).Finalize(0x1c90120, 0x0, 0x0)
	/home/example-user/Go/pkg/mod/gobot.io/x/gobot@v1.14.0/platforms/raspi/raspi_adaptor.go:123 +0x2fc
gobot.io/x/gobot.(*Connections).Finalize(0x1c740b0, 0x0, 0x0)
	/home/example-user/Go/pkg/mod/gobot.io/x/gobot@v1.14.0/connection.go:64 +0x78
gobot.io/x/gobot.(*Robot).Stop(0x1c86050, 0x0, 0x1c82240)
	/home/example-user/Go/pkg/mod/gobot.io/x/gobot@v1.14.0/robot.go:208 +0xb8
gobot.io/x/gobot.(*Robot).Start(0x1c86050, 0x0, 0x0, 0x0, 0x1, 0x1c84060)
	/home/example-user/Go/pkg/mod/gobot.io/x/gobot@v1.14.0/robot.go:194 +0x1f0
main.main()
	/home/example-user/Go/src/gitlab.com/eithel/stupid-smart-things/mcp/main.go:38 +0x1bc
```

What I was expecting is a normal ending of the program.

## How to reproduce

This is the simple program to reproduce the issue.

```go
package main

import (
	"log"
	"time"

	"gobot.io/x/gobot"
	"gobot.io/x/gobot/drivers/spi"
	"gobot.io/x/gobot/platforms/raspi"
)

func main() {

	// Create the reaspberry.
	r := raspi.NewAdaptor()

	// Create the MCP driver.
	// This driver is useful to read some analogic.
	mcp := spi.NewMCP3008Driver(r, spi.WithSpeed(1350000))
	work := func() {
		for {
			newValue, err := mcp.Read(2)
			if err != nil {
				log.Println("Error:", err)
			}
			log.Println(newValue)
			<-time.After(200 * time.Millisecond)
		}
	}

	lightRobot := gobot.NewRobot("Light Sensor",
		[]gobot.Connection{r},
		[]gobot.Device{mcp},
		work,
	)

	err := lightRobot.Start()
	if err != nil {
		log.Fatalln("Unable to start robots:", err)
	}

}
```
after running the software, if you hit ctrl-c, panic occurs.

## Why

Looking at the panic output, the nil pointer dereference occurs here https://github.com/google/periph/blob/v3.6.2/host/sysfs/spi.go#L62 because the `s.conn.f` is nil. As you can see, the function itself sets `s.conn.f` to nil (row 65). I thought that maybe that function is called twice.

Looking how a robot is closed, https://github.com/hybridgroup/gobot/blob/v1.14.0/robot.go#L201-L216 , I saw that all the devices will be `Halt`, and all the connections will be `Finalize`.

Here is where the double call happens: the device, mcp3008, close the spi connection here: https://github.com/hybridgroup/gobot/blob/v1.14.0/drivers/spi/mcp3008.go#L70-L74 then the raspberry spis connection will be finalized here https://github.com/hybridgroup/gobot/blob/v1.14.0/platforms/raspi/raspi_adaptor.go#L121-L127 . This second call causes the panic.

## Thoughts for a solution

I don't know if the bug is imputable to:

1. my program is wrong
2. how gobot manage spi devices
3.  a missing nill check on periph library
4. it behaves as design

If is "1", please, let me know what I'm doing wrong!

If you think is only the "3", feel free to close the issue, and eventually I'll open an issue on periph repo.

Looking at the current code state I think there is also a little bit of "2": every drivers/spi/* use `Start` function to initialize the driver.
This function use the connector to create the spi connection `d.connector.GetSpiConnection(bus, chip, mode, bits, maxSpeed)`, so why don't we give the same **responsibility** - to the connector - also to close the channel?

If it is 4, sorry for this issue, feel free to close it.

For now, I've edit a little bit my program, so panic doesn't occur:

```go
package main

import (
	"log"
	"time"

	"gobot.io/x/gobot"
	"gobot.io/x/gobot/drivers/spi"
	"gobot.io/x/gobot/platforms/raspi"
)

func main() {

	// Create the reaspberry.
	r := raspi.NewAdaptor()

	// Create the MCP driver.
	// This driver is useful to read some analogic.
	mcp := spi.NewMCP3008Driver(r, spi.WithSpeed(1350000))
        mcp.Start() // We manually start the device
	work := func() {
		for {
			newValue, err := mcp.Read(2)
			if err != nil {
				log.Println("Error:", err)
			}
			log.Println(newValue)
			<-time.After(200 * time.Millisecond)
		}
	}

	lightRobot := gobot.NewRobot("Light Sensor",
		[]gobot.Connection{r},
		work, // We don't pass anymore the device to the robot
	)

	err := lightRobot.Start()
	if err != nil {
		log.Fatalln("Unable to start robots:", err)
	}

}
```

Thanks for the help!

deadprogram, 2020-01-11:
Hello @tux-eithel thanks you for looking at this.

I think you are absolutely correct, the `Halt()` of a `Driver` is only supposed to cleanup after itself, not close anything on the `Connection`.

This is the only one that is actually correct: https://github.com/hybridgroup/gobot/blob/v1.14.0/drivers/spi/ssd1306_driver.go#L273

All of the other SPI drivers need to have that line removed e.g. https://github.com/hybridgroup/gobot/blob/v1.14.0/drivers/spi/mcp3304.go#L72

We would be most grateful to receive a PR with this if you have time.

Thank you!

Closed 2022-12-11.

Thread 703 (2019-10-26):

Can't move servo using raspberry pi adapter and servo driver

ezerw, 2019-10-26:
Here is my code

```go
package main

import (
	"log"
	"time"

	"gobot.io/x/gobot"
	"gobot.io/x/gobot/drivers/gpio"
	"gobot.io/x/gobot/platforms/raspi"
)

func main() {
	r := raspi.NewAdaptor()
	servo := gpio.NewServoDriver(r, "11")
	work := func() {
		gobot.Every(10*time.Second, func() {
			i := uint8(gobot.Rand(180))
			log.Printf("Moving servo to %d", i)
			servo.Move(i)
		})
	}
	robot := gobot.NewRobot(
		"servoBot",
		[]gobot.Connection{r},
		[]gobot.Device{servo},
		work,
	)

	robot.Start()
}

```

I've also have installed and running `pi-blaster` but still not able to move the servo. The program runs and I can see the logs but it seems that the signal is not being sent to the servo.

I tried using different pins and also following the indications on pi-blaster repo (`You must use the GPIO number (BCM xx in the diagram below).` but nothing works.

Any ideas how to debug or what's going on?

here the output of `pi-blaster`:

```
pi@raspberrypi:~/pi-blaster $ sudo ./pi-blaster
MBox Board Revision: 0xa020d3
DMA Channels Info: 0x7f35, using DMA Channel: 14
Using hardware:                   PWM
Number of channels:                32
PWM frequency:                 100 Hz
PWM steps:                       1000
Maximum period (100  %):      10000us
Minimum period (0.100%):         10us
DMA Base:                  0x3f007000
Initialised, Daemonized, Reading /dev/pi-blaster.
```

erkexzcx, 2019-12-08:
https://github.com/hybridgroup/gobot/issues/692

It's broken - this framework is useless for me. Instead I am using below code for my automation:

```
package main

import (
        "fmt"
        "log"
        "net/http"
        "time"

        piblaster "github.com/ddrager/go-pi-blaster"
)

const pin = 18 // GPIO18
var blaster = piblaster.Blaster{}

func main() {

        // Initialize blaster
        blaster.Start([]int64{pin})

        // Do a servo routine
        for i := 0; i < 7; i++ {
                setAngle(142)
                time.Sleep(600 * time.Millisecond)
                setAngle(129)
                time.Sleep(120 * time.Millisecond)
        }
        setAngle(48)

}

// Move servo to requested angle
func setAngle(angle uint8) {
        blaster.Apply(pin, angleToServo(angle))
}

// helper function - converts angle to servo value (aka 'map' function)
func angleToServo(val uint8) float64 {
        return (float64(val)-0)*(0.25-0.05)/(180-0) + 0.05
}

```

gen2thomas, 2023-11-10:
I'm going to close this issue as a duplicate, because it is now referenced by an issue which collect all the various problems with raspi and gpio.servo.

gen2thomas, 2023-12-09:
> PWM frequency:                 100 Hz

* pi-blaster needs to be set to 50Hz for most servos, otherwise the servo is not working at all or not working stable
* the current implementation in gobot maybe use the wrong range for the servo, this is fixed with #1046

Closed 2023-11-10.

Thread 711 (2019-12-14):

You are just a STOP-BOT

StefanL38, 2019-12-14:
the https://gobot.io -homepage offers no contact possability at all. So I chosed this way to get in contact with the gobot-creators.
Admin of this part of github if you know a better way to transport this feedback to the gobot-makers please do so and delete this issue as it is no classcial github-issue at all. I'm aware of that.

gobot-makers: Do you really think that highly sophisticated short explanations like

"go get -d -u gobot.io/x/gobot/..."  are an EASY way for totally newbees to learn about coding??

NO WAY!! . And the fact that you don't offer any feedback-possability on your website is showing that you are just nerds that are too lazy to step down from the github-heaven down to earth for really introductional material.

You should rename some parts on your homepage to say the truth:
We offer a platform for a lot of devices on a professional level. People who would like to work with this should have a good knowledge about linux, installing packages, etc.
it is NOT convenient for beginners.

ohiaia, 2020-01-03:
OK, it seems to me that you could have open an issue about the documentation.

And I would have agreed with you. A better example, some bits of code here and there (I had to search a lot, google has been my friend, right, but not a very close one! and I succeeded just because I was really curious and stubborn) in the documentation would be great!

But: there's no need to be so aggressive mate!

deadprogram, 2020-01-11:
Closing due to being too mean. Sorry if it was not all you hoped for.

Closed 2020-01-11.

Thread 712 (2019-12-22):

Run function of StepperDriver has no sleep

tdaira, 2019-12-22:
Run function of StepperDriver does not working properly because there is no Sleep function.
This function calls step function very first cycle and should have a sleep like Move function.

Current Move function which has a sleep: https://github.com/hybridgroup/gobot/blob/master/drivers/gpio/stepper_driver.go#L214

Current loop of Run function without Sleep:
https://github.com/hybridgroup/gobot/blob/master/drivers/gpio/stepper_driver.go#L127

deadprogram, 2020-01-11:
Hi @tdaira I think the idea there is that `Run()` would just keep turning the stepper continuously.

I thought that the pause in `Move()` was to ensure that the stepper only moves by the requested number of steps.

Probably adding any very short delay into `Run()` would address your issue. If you were to try that and it works perhaps you would be so kind as to submit a PR with the change.

gen2thomas, 2022-08-25:
@deadprogram the fix is merged already, can we close the Issue?

Closed 2022-09-02.

Thread 717 (2019-12-31):

Platform request: ESP32

theoretick, 2019-12-31:
I'd love to see support for ESP32 at some point. Based on https://github.com/hybridgroup/gobot/issues/301 it sounds like it might be straightforward once the upstream support for ESP32 is handled within firmata https://github.com/firmata/arduino/issues/315, but figured I'd open this issue to track this request and see if I'm missing  anything else.

Thank you for gobot ❤️

deadprogram, 2020-01-11:
Hi @theoretick I think your assessment sound correct regarding Firmata on the ESP32.

Probably everything that applies to using the ESP8266 would be the same for the ESP32 if using WiFiFirmata.

Please let us all know if you get to try this out, and how it goes.

nilsmagnus, 2021-02-04:
@theoretick have you had a chance to try this out yet?

theoretick, 2021-02-04:
> @theoretick have you had a chance to try this out yet?

@nilsmagnus no, I haven't. I was simply waiting on https://github.com/firmata/arduino/issues/315 to close, but it does look like there's a test branch available from `soundanalogous` if you're interested in trying that out. I haven't really dug into setting anything up

gen2thomas, 2023-07-07:
Hi @theoretick , @nilsmagnus and @deadprogram the [issue](https://github.com/firmata/arduino/issues/315) is now closed with the comment "ESP32 is supported for ConfigurableFirmata." Should we close our issue now or is there anything to do in gobot?

Thanks Thomas

tlindsay, 2023-09-12:
@gen2thomas According to [this comment](https://github.com/hybridgroup/gobot/issues/665#issuecomment-829943748), ESP32 is already supported? Not sure if it's accurate or not.

gen2thomas, 2023-09-13:
Hi @tlindsay , it seems nobody has tested this yet. Could you do this? I'm not experienced with firmata.

gen2thomas, 2025-02-15:
I'm going to close this issue, because is should work in general with firmata.

Closed 2025-02-15.

Thread 723 (2020-01-15):

Using PIR Motion Sensor HC-SR501 with Raspberry Pi Model 3

r3rivera, 2020-01-15:
I've been trying to use the example provided https://gobot.io/documentation/drivers/pir-motion-sensor/ but used a different pin. The code can be found in https://play.golang.org/p/f1UQDG1htvP

However, using the /dev/ttyACM0 gives me an error saying that the directory is not found. it looks like most of the search result is pointing to Arduino. I checked /dev/ folder and the one that I can see that close enough is /dev/ttyS0 and /dev/ttyAMA0.

I tried both but it gives me the error of :

2020/01/14 23:00:00 Initializing connections...
2020/01/14 23:00:00 Initializing connection Firmata-3C07783D ...
2020/01/14 23:00:00 Initializing devices...
2020/01/14 23:00:00 Initializing device PIRMotion-4B88C798 ...
2020/01/14 23:00:00 Initializing device LED-3F3261EF ...
2020/01/14 23:00:00 Robot motionBot initialized.
2020/01/14 23:00:00 Starting Robot motionBot ...
2020/01/14 23:00:00 Starting connections...
2020/01/14 23:00:00 Starting connection Firmata-3C07783D on port /dev/ttyAMA0...
2020/01/14 23:00:15 1 error occurred:
	* unable to connect. Perhaps you need to flash your Arduino with Firmata?

r3rivera, 2020-01-16:
Nevermind. I just used the default raspi driver. https://play.golang.org/p/TTQDDMgNN0W

Closed 2022-09-01.

Thread 725 (2020-01-15):

Can't run `Hello, World of Things` example on Arduino UNO

msclp, 2020-01-15:
What I have done:
1. Installed gort with homebrew
2. Ran `gort arduino install`
3. Ran `gort scan serial`
3. Ran `gort arduino upload firmata /dev/tty.usbmodem14201 -b uno`
4. Installed gobot with `go get -d -u gobot.io/x/gobot/...`
5. Copied _Hello, World of Things_ code example to `main.go` file (changed `"/dev/ttyACM0"` to `"/dev/tty.usbmodem14201"`
6. Ran `go run main.go`

Got error:
```
# github.com/go-ble/ble/darwin
../../../../go/src/github.com/go-ble/ble/darwin/device.go:67:12: cannot use d (type *Device) as type ble.DeviceOption in argument to opt:
	*Device does not implement ble.DeviceOption (missing SetConnectedHandler method)
```

gen2thomas, 2022-09-01:
Either the given code relation is outdated or the issue relates to another repository. Therefore I going to close this issue. Feel free to reopen with more/new information.

Closed 2022-09-01.

Thread 730 (2020-03-05):

gpio with DMA configuration

kelah, 2020-03-05:
does the raspi adaptor pin support dma configuration? I see that periph.io pin support dma config but not gobot adaptor. platform like AlphaBot2 need to use dma for their LED strip.

gen2thomas, 2025-02-15:
I'm going to close this issue, because there is no capacity to fix it. Also gpiodev is mostly used as a modern alternative to sysfs.

Closed 2025-02-15.

Thread 733 (2020-03-09):

How to read the value of MCP3002 via  Raspberry Pi's SPI

u2yto, 2020-03-09:
I tried to read the temperature sensor value using MCP3002 via Raspberry Pi's SPI but it didn't work.

I ran the following code but got the error:
```golang
package main

import (
	"log"

	"gobot.io/x/gobot"
	"gobot.io/x/gobot/platforms/raspi"
	"gobot.io/x/gobot/drivers/spi"
)

func main() {
	r := raspi.NewAdaptor()
	d := spi.NewMCP3002Driver(r)

	gobot.NewRobot("robot",
		[]gobot.Connection{r},
		[]gobot.Device{d},
		func() {
			log.Println(d.AnalogRead("19"))
		},
	).Start()
}
```
The hardware layout:
 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

gen2thomas, 2022-09-01:
If this is still relevant, please could you provide the output (the error). Otherwise we can't do or recomment anything without having the exact same hardware.

gen2thomas, 2023-01-28:
I will going to close this issue, because a huge rework was done for SPI. Possibly the original failure is gone. Otherwise, please test with dev branch first and reopen or file a new one.

Closed 2023-01-28.

Thread 734 (2020-03-09):

[feature request] Dji Robo Master support

elonzh, 2020-03-09:
Dji released the sdk for Robo Master, see https://github.com/dji-sdk/RoboMaster-SDK

gen2thomas, 2022-09-01:
The robot is designed as a composition of some single components. Some of them are most likely already available in gobot (e.g. servo), but some maybe not.

To prevent the need to buy such an complete robot, it would be nice if you you or anybody who owns such an robot, could provide a list for the missing devices. So there is a better chance to get it in the near future.

gen2thomas, 2025-02-15:
I'm going to close this issue due to no response and most parts should work with gobot.

Closed 2025-02-15.

Thread 741 (2020-03-28):

go get -d -u gobot.io/x/gobot/... on windows failing

Sumanth-R-Y, 2020-03-28:
go version:
go version go1.14.1 windows/amd64

>go get -d -u gobot.io/x/gobot/...
**# cd xxxxxxxxx\go\src\go.bug.st\serial.v1; git pull --ff-only
fatal: not a git repository (or any of the parent directories): .git
package go.bug.st/serial.v1: exit status 128**

Sumanth-R-Y, 2020-04-05:
Tried today and it is working.

urban-wombat, 2020-10-29:
I'm seeing something similar:

$ go get -d -u gobot.io/x/gobot/...
# cd xxxxxxxxxx\golang\src\gobot.io\x\gobot; git pull --ff-only
fatal: not a git repository (or any parent up to mount point /cygdrive)
Stopping at filesystem boundary (GIT_DISCOVERY_ACROSS_FILESYSTEM not set).
package gobot.io/x/gobot/...: exit status 128

pinnaclesystemsgroup, 2023-03-13:
Could SOMEONE PLEASE UPDATE THE SITE'S WEBPAGE AND MAKE IT THE INSTALL COMMAND CONSISTENT WITH THE GOLANG STANDARD THAT DEPRECATED THE "go get -d -u gobot.io/x/gobot/.." install command!!!!

gen2thomas, 2023-03-13:
Hi @pinnaclesystemsgroup , thanks for pointing this out. PR's are greatly appreciated. So at least for the README.md this can be fixed by anyone.

gen2thomas, 2023-06-04:
The CLI was removed and the documentation was updated. Currently there is a [known issue](https://github.com/hybridgroup/gobot/issues/920) with v2+ modules.

Closed 2023-07-07.

Thread 749 (2020-04-19):

raspberry gpio open value permission denied bad behavior

pseidemann, 2020-04-19:
hello,
while using the raspi adapter, there seems to be a problem how `LedDriver`'s `On()`/`Off()` behaves in an error case.

minimal code for reproduction on a raspberry pi:

```go
package main

import (
	"log"

	"gobot.io/x/gobot/drivers/gpio"
	"gobot.io/x/gobot/platforms/raspi"
)

const pinBCM18 = "12"

func main() {
	adp := raspi.NewAdaptor()
	led := gpio.NewLedDriver(adp, pinBCM18)

	for i := 0; i < 3; i++ {
		if err := led.On(); err != nil {
			log.Println(err)
		} else {
			log.Println("success - start program again")
			break
		}
	}

	adp.Finalize()
}
```

when this program is run, in ~ 1/10 of cases, the opening of the pin's value is failing with "permission denied".

that is the line failing: https://github.com/hybridgroup/gobot/blob/ea371766fb4c8d84feeeb9e164bc664786896432/sysfs/digital_pin.go#L124

this is how the output of the program looks:
```
2020/04/17 17:26:20 open /sys/class/gpio/gpio18/value: permission denied
2020/04/17 17:26:20 pin has not been exported
2020/04/17 17:26:20 pin has not been exported
```

there are now two issues:
1. why is opening `/value` sometimes failing, but most of the time it's not and how to fix this? this only happens if the pin was not exported before the program was run.
2. when `On()`/`Off()` is tried again, it surrenders making the pin available and the error changes, making some retry mechanism implementation impossible. probably caused by this (there is also a comment about some potential issue with the current implementation): https://github.com/hybridgroup/gobot/blob/ea371766fb4c8d84feeeb9e164bc664786896432/sysfs/digital_pin.go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

Closed 2020-05-10.

Thread 753 (2020-06-07):

Servo doesn't work on raspberry pi

rochinworks, 2020-06-07:
I am having trouble getting a servo to move on a raspberry pi using the go1.13. I have never been able to get this to work. Is there something I'm missing?
```
package main
import (
        "time"
	"fmt"

        "gobot.io/x/gobot"
        "gobot.io/x/gobot/drivers/gpio"
        "gobot.io/x/gobot/platforms/raspi"
)

func main() {
        r := raspi.NewAdaptor()
        servo := gpio.NewServoDriver(r, "24")

        work := func() {
		servo.Center()
		time.Sleep(1*time.Second)
		fmt.Println("moving servo to center")

		servo.Min()
		time.Sleep(1*time.Second)
		fmt.Println("moving servo to min")

		servo.Max()
		time.Sleep(1*time.Second)
		fmt.Println("moving servo to max")
        }

        robot := gobot.NewRobot("servoBot",
                []gobot.Connection{r},
                []gobot.Device{servo},
                work,
        )

        robot.Start()
}
```

a1xon, 2020-08-10:
https://raspberrypi.stackexchange.com/questions/70878/error-gpio-num-is-not-enabled-for-pi-blaster
You have to
`sudo ./pi-blaster --gpio 13`

gen2thomas, 2023-11-10:
I'm going to close this issue as a duplicate, because it is now referenced by an issue which collect all the various problems with raspi and gpio.servo.

Closed 2023-11-10.

Thread 759 (2020-07-06):

Adafruit Driver wrongfully assumes both the Servo and DC Motors Hats are present

crazyquark, 2020-07-06:
This issue is at this line:
https://github.com/hybridgroup/gobot/blob/master/drivers/i2c/adafruit_driver.go#L152
If a Servo HAT is not installed, the driver Start method will return without trying to connect to the DC Motors HAT.

This makes it impossible to use the Adafruit DC Motors HAT(https://www.adafruit.com/product/2348):

I think if the connection to the Servo HAT fails(which is this product https://www.adafruit.com/product/2327) it should be just set to nil and then try to connect to the motors HAT. It shouldn't be mandatory to have both hats connected for this driver to work,

gandaldf, 2021-02-05:
Can you please check if my proposed solution #783 works for you?

gen2thomas, 2022-08-25:
@deadprogram it seems this fix is merged already, can we close the Issue?

Closed 2022-09-01.

Thread 763 (2020-08-29):

Bebop2 battery level

marcodiiga, 2020-08-29:
I'm using the bebop driver and adaptor and I couldn't find a way to receive a battery level event, something like

```go
drone.On(drone.BatteryLevel, func(data interface{}) {
	log.Printf("battery level: %d\n", data)
})
```
similar to the minidrone driver.

Is this missing or am I just overlooking something trivial?

gen2thomas, 2022-09-20:
@marcodiiga I think there is nothing implemented yet for the bebop.

gen2thomas, 2024-02-10:
@marcodiiga after get a deeper look in the BLE adapter and driver implementation I can provide the following information (provided names are based on current dev branch state).

The parrot minidrone has implemented a characteristic `batteryChara      = "9a66fb0f0800919111e4012d1540cb8e"` with a subscription to that and an event `parrot.BatteryEvent`. This implementation is not available for parrot bebop. The parrot bebop implementation is TCP based, not BLE, so there is no fast way to take over the existing implementation.

If there is no objection, I will close this issue in the next few days.

Closed 2024-11-01.

Thread 765 (2020-09-19):

[BLE] can not run the code twice because of this ble error

HasanFarag, 2020-09-19:
when I run sudo ./minidrone D0:3A:7F:0D:E6:21 on ubuntu 20.04 i got that error if i want to run the code again after landing
```
2020/09/19 17:36:29 Initializing connections...
2020/09/19 17:36:29 Initializing connection BLEClient-32A33693B9E2A9F9 ...
2020/09/19 17:36:29 Initializing devices...
2020/09/19 17:36:29 Initializing device Minidrone-5CF68D44CFC83AD2 ...
2020/09/19 17:36:29 Robot minidrone initialized.
2020/09/19 17:36:29 Starting Robot minidrone ...
2020/09/19 17:36:29 Starting connections...
2020/09/19 17:36:29 Starting connection BLEClient-32A33693B9E2A9F9...
2020/09/19 17:36:39 1 error occurred:
	* can't connect to device default: can't get device: can't init hci: no devices available: (hci0: can't down device: device or resource busy)
```
or
* can't discover profile: can't discover services: ATT request failed: input channel closed: io: read/write on closed pipe

gen2thomas, 2024-02-10:
Hi @HasanFarag , since 2020 the used library has changed a bit. Additionally some things has changed recently in adapator and driver on dev branch. If this is still of interest, please can you repeat your test with the current implementation on dev branch and provide your running example.

Furthermore I can see missing usage of error return values in gobot examples. I will fix this.

gen2thomas, 2024-11-05:
Fixed with [v2.4.0](https://github.com/hybridgroup/gobot/releases/tag/v2.4.0)

Closed 2024-11-05.

Thread 772 (2020-12-17):

Support for Jetson Nano platform

soerenbrockmann, 2020-12-17:
Do you plan to support Jetson Nano platform which runs on Ubuntu?
They mention that their platform (GPIO Pins) is equal to Raspberry PI. They only provide a Python :-(( GPIO Library.

deadprogram, 2020-12-17:
Yes, absolutely planning on this.

soerenbrockmann, 2020-12-17:
That would be amazing :-)

soerenbrockmann, 2020-12-17:
I just tested this example here:

`
package main

import (
        "gobot.io/x/gobot/platforms/raspi"
)

func main() {
		r := raspi.NewAdaptor()
		fmt.Println(r)
}
`

I got this value returned:

&{0x400001c358 RaspberryPi-62F43657CD24D5FD  map[] map[] 0 [<nil> <nil>] 0 0 [<nil> <nil>] 0 0 10000000}

Is it a good sign?

Is there a way to test connectivity without using a pin (I am afraid of breaking my board :-) )

dlstjq7685, 2021-08-01:
@soerenbrockmann
i just add feature jetson nano Adaptor.
check this branch.
https://github.com/hybridgroup/gobot/pull/799

gen2thomas, 2023-05-15:
part of release v2.0.0

Closed 2023-05-15.

Thread 774 (2020-12-21):

MPU6500 gyro freezes after a few seconds

willmendil, 2020-12-21:
High,

I got a raspberry 4 with an arduino Due,

I tried the MPU6050 code running with i2C, running this example https://gobot.io/documentation/examples/firmata_mpu6050/

I get some readings but after a few seconds it freezes and I need to restart the script. It feels like some buffer is filling up, but I'm not sure. The only main difference is that i'm using the MPU6500 instead of the 6050.

After some digging, it looks like it freezes when it's trying to read line 101

```
...
100	data := make([]byte, 14)
101	_, err = h.connection.Read(data)
102	if err != nil {
...
```

in https://github.com/hybridgroup/gobot/blob/master/drivers/i2c/mpu6050_driver.go

Any idea? thanks

gen2thomas, 2022-09-20:
Hi @willmendil , possibly this is caused by a wrong initialization, see #838 .

Please could you test your device with the code of the provided PR #839 ?
Unfortunately I have only Tinkerboard and Digispark adaptors and use the MPU6050, so I can not say anything about your constellation.

gen2thomas, 2022-10-03:
MPU6050 is working with #839 on Digispark and Tinkerboard without freezing. So I'm going to close this issue, because it relates to MPU6500.

Closed 2022-10-03.

Thread 782 (2021-02-05):

write /dev/i2c-1: remote I/O error on Raspberry 4 and Adafruit Motorhat

gandaldf, 2021-02-05:
Hi, I'm trying to run this example: https://github.com/hybridgroup/gobot/blob/release/examples/raspi_adafruit_dcmotor.go on my Raspberry Pi 4B 4GB to work with two simple DC motors connected to a single Adafruit Motorhat.
The wiring seems right (I tried the default Python example from Adafruit website and it run smoothly) but when I try `go run main.go` I get this error:
```
2021/02/05 15:07:16 Initializing connections...
2021/02/05 15:07:16 Initializing connection RaspberryPi-5F8E62B9 ...
2021/02/05 15:07:16 Initializing devices...
2021/02/05 15:07:16 Initializing device AdafruitMotorHat-F82D156 ...
2021/02/05 15:07:16 Robot adaFruitBot initialized.
2021/02/05 15:07:16 Starting Robot adaFruitBot ...
2021/02/05 15:07:16 Starting connections...
2021/02/05 15:07:16 Starting connection RaspberryPi-5F8E62B9...
2021/02/05 15:07:16 Starting devices...
2021/02/05 15:07:16 Starting device AdafruitMotorHat-F82D156...
2021/02/05 15:07:16 1 error occurred:
	* write /dev/i2c-1: remote I/O error
```
I tried to build the example and then run it under `sudo` but I get the same problem.

I checked to have enabled the I2C interface from `raspi-config` and when I run `sudo i2cdetect -y 1` I get this:
```
     0  1  2  3  4  5  6  7  8  9  a  b  c  d  e  f
00:          -- -- -- -- -- -- -- -- -- -- -- -- --
10: -- -- -- -- -- -- -- -- -- -- -- -- -- -- -- --
20: -- -- -- -- -- -- -- -- -- -- -- -- -- -- -- --
30: -- -- -- -- -- -- -- -- -- -- -- -- -- -- -- --
40: -- -- -- -- -- -- -- -- -- -- -- -- -- -- -- --
50: -- -- -- -- -- -- -- -- -- -- -- -- -- -- -- --
60: 60 -- -- -- -- -- -- -- -- -- -- -- -- -- -- --
70: 70 -- -- -- -- -- -- --
```

So I can't really understand what is wrong, because with Python I have no problem.
Can someone please help me?

@deadprogram @erkkah @maruel

gandaldf, 2021-02-05:
After a bit research I found @crazyquark was right in #759 issue: if you are just using the "DC part" of Adafruit Motorhat the driver can't get the DC connection because it get stuck here: https://github.com/hybridgroup/gobot/blob/master/drivers/i2c/adafruit_driver.go#L152

gandaldf, 2021-02-05:
#783

gandaldf, 2021-02-05:
I just proposed a solution here: #783

Thread 784 (2021-02-10):

Still have this! "ndefined: uuid.V2"

lloyd-g, 2021-02-10:
This issue was closed https://github.com/hybridgroup/gobot/issues/777
but I still get this
```
$GOARM=6 GOARCH=arm GOOS=linux go build go/src/gobot.io/x/gobot/examples/raspi_blink.go
# github.com/gobuffalo/uuid
go/src/github.com/gobuffalo/uuid/generator.go:32:13: undefined: uuid.NewV2
go/src/github.com/gobuffalo/uuid/uuid.go:41:7: undefined: uuid.V2
```
if you trace it down
uuid.V2 is not defined in that package

line 41 of go/src/github.com/gobuffalo/uuid/uuid.go:41:7
reads
	V2 = guuid.V2
not  uuid.V2
does this help?

I'm using
go version
go version go1.15.7 linux/arm
on raspberry pi 3
but get same on
Debian 10 with go1.15.7

deadprogram, 2021-02-10:
No release has gone out yet. That is why. Thanks for your patience. In the meantime, you can use the `dev` branch.

rafi0101, 2021-03-29:
Hi @deadprogram I have the same issue. When do you think you will release the next version?

jim-at-jibba, 2021-04-06:
Im new to go and so not sure how to use the dev branch of a package.

Should I clone it and build?

I tried to `go get` a specific branch but getting errors about the name of the package

```
go: github.com/hybridgroup/gobot dev => v1.15.1-0.20210127175256-97d23a5aec43
go get: github.com/hybridgroup/gobot@v1.15.1-0.20210127175256-97d23a5aec43: parsing go.mod:
        module declares its path as: gobot.io/x/gobot
                but was required as: github.com/hybridgroup/gobot
```

Thanks for the help

rafi0101, 2021-04-06:
Hi @jim-at-jibba it is very easy, once you know it :)
You go to your GOPATH (usually the go folder in your home directory). Then go to the directory: `go/src/github.com/gobuffalo/uuid/` and now you are in the git repository and can change the branch with `git checkout dev`

jim-at-jibba, 2021-04-06:
> Hi @jim-at-jibba it is very easy, once you know it :)
> You go to your GOPATH (usually the go folder in your home directory). Then go to the directory: `go/src/github.com/gobuffalo/uuid/` and now you are in the git repository and can change the branch with `git checkout dev`

Ha, I feel silly now! Thanks for your help

peterkingsbury, 2021-04-07:
Followed these steps:

```
go get -d -u gobot.io/x/gobot/...
go build
(got the gobuffalo uuid.NewV2 errors)
(google'd, found the closed issue, searched the issue history, ended up here)
cd $GOPATH/src/github.com/gobuffalo/uuid/
git status
> On branch master, etc
git checkout dev
> error: pathspec 'dev' did not match any file(s) known to git
git fetch
git branch -a
> * master
>   remotes/origin/HEAD -> origin/master
>   remotes/origin/master
```
Any help would be appreciated! Many thanks :-)

gen2thomas, 2021-04-07:
Hi @deadprogram you mean with...
> No release has gone out yet. That is why. Thanks for your patience. In the meantime, you can use the `dev` branch.

... the dev branch of this repo (gobot)?

Hi @peterkingsbury , @jim-at-jibba I have made my local change in $GOPATH/src/github.com/gobuffalo/uuid/ folder (on master branch without commit and push) to make it work like this:

```
diff --git a/generator.go b/generator.go
index 886d39c..718e785 100644
--- a/generator.go
+++ b/generator.go
@@ -29,7 +29,7 @@ import (
 var NewV1 = guuid.NewV1

 // NewV2 returns DCE Security UUID based on POSIX UID/GID.
-var NewV2 = guuid.NewV2
+//var NewV2 = guuid.NewV2

 // NewV3 returns UUID based on MD5 hash of namespace UUID and name.
 var NewV3 = guuid.NewV3
diff --git a/uuid.go b/uuid.go
index da62416..d01a838 100644
--- a/uuid.go
+++ b/uuid.go
@@ -38,7 +38,7 @@ type UUID = guuid.UUID
 // UUID versions
 const (
        V1 = guuid.V1
-       V2 = guuid.V2
+       //V2 = guuid.V2
        V3 = guuid.V3
        V4 = guuid.V4
        V5 = guuid.V5

```

benhadad, 2021-05-19:
I am new to Gobot, but this issue makes me feel I am starting out on a dead pathway with a project that isn't being fully supported anymore.   Last update was 6 months ago and didn't address this issue?

cwinters8, 2021-09-29:
For posterity, I was able to build successfully after doing the following to get the dev branch updates for uuid.

```sh
go get gobot.io/x/gobot@dev
```

charliemcelfresh, 2022-06-19:
This worked for me : `go get -u github.com/gobuffalo/validate`

gen2thomas, 2022-09-01:
@deadprogram because the dev branch was merged for v1.16.0 in May 2022, is this bug now resolved?

deadprogram, 2022-09-11:
Oops, forgot to close. Yes. :smile_cat:

Closed 2022-09-11.

Thread 793 (2021-05-25):

Dji Tello Halt does not terminate all the related goroutines and may wait forever when it is called multiple times

st-user, 2021-05-25:
(parent commit [27c76b4585807e829965ec6a4551cadc28f430fe](https://github.com/hybridgroup/gobot/commit/27c76b4585807e829965ec6a4551cadc28f430fe))

I tried Dji Tello Driver and found the following two problem related to `Halt` method.

If these are issues that need to be fixed, I’d like to make a pull request.

## Problems
### 1. Halt stops only one of the three infinite loops.

The Driver runs the **three** infinite loops(*). However `Halt` stops only one of the three because:

- `case <- d.doneCh: break…` is defined in **two** of the three.
- `Halt` calls `d.doneCh <- struct{}{}` only once.

(*)
  - https://github.com/hybridgroup/gobot/blob/release/platforms/dji/tello/driver.go#L289
  - https://github.com/hybridgroup/gobot/blob/release/platforms/dji/tello/driver.go#L308
  - https://github.com/hybridgroup/gobot/blob/release/platforms/dji/tello/driver.go#L949

So, only one of the three infinite loops can read `d.doneCh` and stop.

 ### 2. Halt may wait forever when it is called multiple times.

Simply because `Halt` is blocked by `d.doneCh <- struct{}{}`, if we call `Halt` after the driver has been halted, It blocked forever.

## My test case and bug fixes

### Test case

The test cases below simulate the problems.
These two test methods don't stop.
(https://github.com/st-user/gobot/commit/1ffc13879c54a4625591add72b7ccf74661e3771)

```
// Only output one line ('Done routine x.')
func TestHaltShouldTerminateAllTheRelatedGoroutines(t *testing.T) {
	d := NewDriver("8888")
	d.cmdConn = &WriteCloserDoNothing{}

	var wg sync.WaitGroup
	wg.Add(3)
	go func() {
		<-d.doneCh
		wg.Done()
		fmt.Println("Done routine 1.")
	}()
	go func() {
		<-d.doneCh
		wg.Done()
		fmt.Println("Done routine 2.")
	}()
	go func() {
		<-d.doneCh
		wg.Done()
		fmt.Println("Done routine 3.")
	}()

	d.Halt()
	wg.Wait()
}

func TestHaltNotWaitForeverWhenCalledMultipleTimes(t *testing.T) {
	d := NewDriver("8888")
	d.cmdConn = &WriteCloserDoNothing{}

	d.Halt()
	d.Halt()
	d.Halt()
}
```
### Try fixing

I tried fixing the problems at the commit(https://github.com/st-user/gobot/commit/8c5ac6f0acbdbdce4a8d71b5176ca3c41d601033) by:

 - Defining `case <- d.doneCh: break…` in every infinite loops.
 - Calling `d.doneCh <- struct{}{}` as many times as the running infinite loops.

joeyberkovitz, 2023-02-08:
On this topic, `NewDriverWithIP` doesn't initialize the `doneCh` (https://github.com/hybridgroup/gobot/blob/dev/platforms/dji/tello/driver.go#L238), so Halt is guaranteed to hang due to writing to a nil channel. I can submit a PR if needed to fix that function as well, although it's a trivial change

gen2thomas, 2023-05-19:
Hi @joeyberkovitz thanks for pointing this out. A PR would be great.

Thanks!

Thread 794 (2021-05-27):

spi.SpiConnection is not gobot.Connection: missing method Connect

davidvanlaatum, 2021-05-27:
```package main

import (
	"gobot.io/x/gobot"
	"gobot.io/x/gobot/api"
	"gobot.io/x/gobot/drivers/spi"
	"gobot.io/x/gobot/platforms/raspi"
)

func main() {
	mbot := gobot.NewMaster()

	a := api.NewAPI(mbot)
	a.Start()

	r := raspi.NewAdaptor()
	ai := spi.NewMCP3008Driver(r, func(config spi.Config) {
		config.WithBus(1)
	})

	robot := gobot.NewRobot(
		[]gobot.Connection{r},
		[]gobot.Device{ai},
	)

	mbot.AddRobot(robot)

	mbot.Start()
}
```

```2021/05/27 20:31:14 Initializing API on :3000...
2021/05/27 20:31:14 WARNING: API using insecure connection. We recommend using an SSL certificate with Gobot.
2021/05/27 20:31:14 Initializing connections...
2021/05/27 20:31:14 Initializing connection RaspberryPi-78E59E2465D100FE ...
2021/05/27 20:31:14 Initializing devices...
2021/05/27 20:31:14 Initializing device MCP3008-5E4954DB19DCBD4B ...
2021/05/27 20:31:14 Robot 6A2A7C251008C969 initialized.
2021/05/27 20:31:14 Starting Robot 6A2A7C251008C969 ...
2021/05/27 20:31:14 Starting connections...
2021/05/27 20:31:14 Starting connection RaspberryPi-78E59E2465D100FE...
2021/05/27 20:31:14 Starting devices...
2021/05/27 20:31:14 Starting device MCP3008-5E4954DB19DCBD4B...
2021/05/27 20:31:14 Starting work...
2021/05/27 20:31:34 http: panic serving 192.168.83.91:60963: interface conversion: *spi.SpiConnection is not gobot.Connection: missing method Connect
goroutine 49 [running]:
net/http.(*conn).serve.func1(0x400014c000)
	/usr/local/Cellar/go/1.16.2/libexec/src/net/http/server.go:1824 +0x110
panic(0x28a5a0, 0x40002d6600)
	/usr/local/Cellar/go/1.16.2/libexec/src/runtime/panic.go:971 +0x424
gobot.io/x/gobot/drivers/spi.(*MCP3008Driver).Connection(0x40000b8230, 0x40002a2140, 0x12)
	/Users/david/go/pkg/mod/gobot.io/x/gobot@v1.15.0/drivers/spi/mcp3008.go:53 +0x40
gobot.io/x/gobot.NewJSONDevice(0x33f798, 0x40000b8230, 0x400005d500)
	/Users/david/go/pkg/mod/gobot.io/x/gobot@v1.15.0/device.go:26 +0x10c
gobot.io/x/gobot.NewJSONRobot.func1(0x33f798, 0x40000b8230)
	/Users/david/go/pkg/mod/gobot.io/x/gobot@v1.15.0/robot.go:37 +0x40
gobot.io/x/gobot.(*Devices).Each(0x40000a6120, 0x400013b5f0)
	/Users/david/go/pkg/mod/gobot.io/x/gobot@v1.15.0/device.go:51 +0x70
gobot.io/x/gobot.NewJSONRobot(0x4000190000, 0x0)
	/Users/david/go/pkg/mod/gobot.io/x/gobot@v1.15.0/robot.go:36 +0x208
gobot.io/x/gobot.NewJSONMaster.func1(0x4000190000)
	/Users/david/go/pkg/mod/gobot.io/x/gobot@v1.15.0/master.go:29 +0x30
gobot.io/x/gobot.(*Robots).Each(0x40000a60a8, 0x400013b788)
	/Users/david/go/pkg/mod/gobot.io/x/gobot@v1.15.0/robot.go:100 +0x50
gobot.io/x/gobot.NewJSONMaster(0x40000b8190, 0x2279f0)
	/Users/david/go/pkg/mod/gobot.io/x/gobot@v1.15.0/master.go:28 +0x1cc
gobot.io/x/gobot/api.(*API).mcp(0x40000fc000, 0x33e5d0, 0x4000074460, 0x40002a4500)
	/Users/david/go/pkg/mod/gobot.io/x/gobot@v1.15.0/api/api.go:188 +0x38
net/http.HandlerFunc.ServeHTTP(0x4000097230, 0x33e5d0, 0x4000074460, 0x40002a4500)
	/usr/local/Cellar/go/1.16.2/libexec/src/net/http/server.go:2069 +0x40
github.com/bmizerany/pat.(*PatternServeMux).ServeHTTP(0x40000a60c0, 0x33e5d0, 0x4000074460, 0x40002a4500)
	/Users/david/go/pkg/mod/github.com/bmizerany/pat@v0.0.0-20170815010413-6226ea591a40/mux.go:117 +0x104
gobot.io/x/gobot/api.(*API).ServeHTTP(0x40000fc000, 0x33e5d0, 0x4000074460, 0x40002a4500)
	/Users/david/go/pkg/mod/gobot.io/x/gobot@v1.15.0/api/api.go:65 +0x2b8
net/http.(*ServeMux).ServeHTTP(0x55d0e0, 0x33e5d0, 0x4000074460, 0x40002a4500)
	/usr/local/Cellar/go/1.16.2/libexec/src/net/http/server.go:2448 +0x190
net/http.serverHandler.ServeHTTP(0x400010c000, 0x33e5d0, 0x4000074460, 0x40002a4500)
	/usr/local/Cellar/go/1.16.2/libexec/src/net/http/server.go:2887 +0xbc
net/http.(*conn).serve(0x400014c000, 0x33ec20, 0x4000072280)
	/usr/local/Cellar/go/1.16.2/libexec/src/net/http/server.go:1952 +0x71c
created by net/http.(*Server).Serve
	/usr/local/Cellar/go/1.16.2/libexec/src/net/http/server.go:3013 +0x318
```

Just going to :3000/  shows this, am I doing something wrong?

gen2thomas, 2023-05-15:
part of release v2.0.0

Closed 2023-05-15.

Thread 798 (2021-06-15):

Tello driver FlightData fields description

orsinium, 2021-06-15:
The `FlightData` struct fields use a lot of abbreviations and don't have descriptions. What is `EmOpen`? `ElectricalMachineryState`? `FlyMode`? `FrontLSC`? `ImuState`? What are the possible values for `CameraState`? Is there a place where I can read about it?

orsinium, 2021-06-15:
Found about IMU: [Ryze Tello IMU Calibration](https://droneguides.net/en/ryze-tello-imu-calibration/). So I guess `ImuState` says if the drone needs IMU calibration. It's still not clear what are the values for `ImuCalibrationState`, though.

orsinium, 2021-07-02:
Tello SDK (Tello EDU only?) has a description for the state fields:
https://dl-cdn.ryzerobotics.com/downloads/Tello/Tello%20SDK%202.0%20User%20Guide.pdf

It is different from what we have but there are a few matching fields.

orsinium, 2021-07-02:
`FlightData.LightStrength` field appears to be unused 🤔

gen2thomas, 2022-09-20:
Hi @orsinium , I'm not a user of this device, so I can not tell something about the structure elements. Because it seems you are (were) a novice for using this driver you are best suited for adding some comments for the next new user.

So, please could you provide a PR with some comments besides the elements or at least provide a complete list here so anyone else can prepare an PR? This would be perfect.

orsinium, 2022-09-20:
I don't remember much at this point, only what I wrote in this issue. But I think I haven't found anything else.

I'm pretty sure I'm not the first one to use the driver. I vaguely remember @deadprogram showing people how to fly a DJI Tello drone at some conferences. And then there is [this article](https://muetsch.io/flying-a-dji-tello-drone-with-go.html). So, I hope there are some people in the world who can uncover the mysteries of the fields I didn't uncover.

I'll try to find some time in a week and contribute comments to the fields that I described in this thread. The rest I don't know yet.

gen2thomas, 2022-09-20:
Thanks, that would be great!

Thread 802 (2021-08-30):

Raspberry pi PICO

hasanAjsf, 2021-08-30:
Is gobot working with the new raspberry pi pico controller, different in the setup required from running raspberry pi with gobot, or every thing is the same as both having almost same processor?

https://www.raspberrypi.org/documentation/rp2040/getting-started/

gen2thomas, 2022-09-20:
Hi @hasanAjsf , it seems there is no information available at this point. In the meantime, do you have made some experiences with the PICO, which you can share with us?

jackjameshoward, 2023-01-09:
has there been any more consideration given for support to this device?
I don't know how similar gobot is to tinygo, but there is support for the pico over there.
https://tinygo.org/docs/reference/microcontrollers/pico/

gen2thomas, 2023-01-13:
As far as I can tell Microcontrollers are supported by [firmata](https://github.com/hybridgroup/gobot/tree/release/platforms/firmata) protocol in gobot. So, if the firmata firmware supports the hardware it should work, but I have no experience with that. The "normal [Raspi](https://github.com/hybridgroup/gobot/tree/release/platforms/raspi)", which is supported by gobot, is a computer with installed Linux OS.

gen2thomas, 2023-07-07:
I'm going to close this issue, because there are 2 alternative ways available to use the PICO microcontroller. @hasanAjsf feel free to reopen the issue with providing more information why you need/want to use gobot over tinygo.

Closed 2023-07-07.

Thread 808 (2022-02-22):

Is the project abandon?

arthuravila26, 2022-02-22:
I'm thinking in start to practice Go using my IoT ideas but I'm kind worried to use this framework and it is abandon as the last merge in the code was in 2020. If it is, does some know another framework that is good to use Go in IoT projects?

gen2thomas, 2022-09-20:
Hi @arthuravila26 , no it is not abandon, but a little bit slow ;o}. Help to fix some bugs or make some new device drivers is greatly appreciated.

Closed 2022-09-20.

Thread 809 (2022-02-23):

write /dev/i2c-1: remote I/O error on Raspberry Pi Zero 2 W and Adafruit Motorhat

kevensen, 2022-02-23:
I am trying to run https://github.com/hybridgroup/gobot/blob/release/examples/raspi_adafruit_stepper.go. I am receiving the following error:

```
2022/02/22 18:21:36 Initializing connections...
2022/02/22 18:21:36 Initializing connection RaspberryPi-6579FA62 ...
2022/02/22 18:21:36 Initializing devices...
2022/02/22 18:21:36 Initializing device AdafruitMotorHat-323C1392 ...
2022/02/22 18:21:36 Robot adaFruitBot initialized.
2022/02/22 18:21:36 Starting Robot adaFruitBot ...
2022/02/22 18:21:36 Starting connections...
2022/02/22 18:21:36 Starting connection RaspberryPi-6579FA62...
2022/02/22 18:21:36 Starting devices...
2022/02/22 18:21:36 Starting device AdafruitMotorHat-323C1392...
2022/02/22 18:21:36 1 error occurred:
	* write /dev/i2c-1: remote I/O error
```
When I run `sudo i2cdetect -y 1` I get the following
```
     0  1  2  3  4  5  6  7  8  9  a  b  c  d  e  f
00:          -- -- -- -- -- -- -- -- -- -- -- -- --
10: -- -- -- -- -- -- -- -- -- -- -- -- -- -- -- --
20: -- -- -- -- -- -- -- -- -- -- -- -- -- -- -- --
30: -- -- -- -- -- -- -- -- -- -- -- -- -- -- -- --
40: -- -- -- -- -- -- -- -- -- -- -- -- -- -- -- --
50: -- -- -- -- -- -- -- -- -- -- -- -- -- -- -- --
60: 60 -- -- -- -- -- -- -- -- -- -- -- -- -- -- --
70: 70 -- -- -- -- -- -- --
```

My wiring is correct and verified by a Python example.

This seems similar to https://github.com/hybridgroup/gobot/issues/782.  Any help is appreciated.

gen2thomas, 2023-11-10:
Hi @kevensen , I have reworked the driver by splitting it to one driver for each HAT, which is more gobot style and also gives the possibility to reuse the code from i2c device PCA9685. My test was done with PCA9685 based board, but not the adafruit HAT, but should working also for the HAT. This is still released with [2.2.0](https://github.com/hybridgroup/gobot/releases/tag/v2.2.0). So I'm going to close this issue for now. Feel free to reopen if it is not working for you.

Closed 2023-11-10.

Thread 815 (2022-03-30):

return int in AnalogSensorDriver.Read() prevents nice implementation

gen2thomas, 2022-03-30:
I'm currently implementing an generic temperature sensor driver for linear scaling (PT100, PTC) and NTC scaling.
IMO the best way would be wrapping the AnalogSensorDriver, but the return value is integer, which not really fits the need of an analog reading in my opinion. My suggestion is to change the interface to float64 and adjust all the examples (I would and can do that).

Another way around would be extend the driver by a new function "ScaledRead() float64" and some unattractive adjustments inside the driver.

@deadprogram what do you think?

deadprogram, 2022-04-09:
Hmm, it is a breaking change, but not a very large one.

I'd say, let's go for it unless anyone else objects.

gen2thomas, 2022-04-24:
I've completely forgotten this question and your answer and to make some changes to #814 before merging (which the advantage that is currently backward compatible). But I think, now we can see the "unattractive adjustments" I mentioned in the "analog_sensor_driver.go". There are two new functions named ReadValue() and Value() which the name "value" is meaningless in this context.

I will prepare a PR in the next few days to improve this according to your answer and I hope we can see, that the result is more readable. This has also the advantage to see the difference more clearly. If the improvement does not outweigh the disadvantage of the small breaking change, we can just drop the PR and close this issue.

gen2thomas, 2023-05-15:
part of release v2.0.0

Closed 2023-05-15.

Thread 816 (2022-04-08):

Does this Lib. Still Work w/ the BeagleBone Black?

silver2row, 2022-04-08:
Hello,

I have not tried this out yet. I plan on trying it out to handle some LED to start via the BeagleBone Black and RelayCape.

Here: https://github.com/hybridgroup/gobot/tree/master/platforms/beaglebone

Is this still current or would I need to update in my cloned repo. a way to handle this lib?

Seth

gen2thomas, 2023-01-23:
Hi @silver2row have you been able to check this out yet ? Could you test the dev branch for your requirements?

stevstrong, 2023-10-18:
The newest package does have a problem at install.
I followed this page:
https://gobot.io/documentation/platforms/beaglebone/
Having Go already installed, I started to install gobot with:
`go get -d -u gobot.io/x/gobot/...`
And after downloading a lot f packages, it throws these lines:
```
gobot.io/x/gobot/drivers/spi imports
        periph.io/x/periph/conn/physic: cannot find module providing package periph.io/x/periph/conn/physic
gobot.io/x/gobot/drivers/spi imports
        periph.io/x/periph/conn/spi: cannot find module providing package periph.io/x/periph/conn/spi
gobot.io/x/gobot/drivers/spi imports
        periph.io/x/periph/host/sysfs: cannot find module providing package periph.io/x/periph/host/sysfs
```
So I assume something is wrong there.
Can someone help to fix this?

gen2thomas, 2023-10-18:
Hi @stevstrong , the documentation at [this page](https://gobot.io/documentation/platforms/beaglebone/) is outdated. We only support the v2 of gobot. Please have a look at this example instead: https://github.com/hybridgroup/gobot/blob/release/examples/beaglebone_blink.go.

gen2thomas, 2023-10-18:
This depends on your start point. If you already have a go program or project for your platform a `go mod tidy` should be sufficient (after you have changed the old imports to "gobot/v2"). Otherwise, please read the guide and try it step by step.

gen2thomas, 2024-11-01:
Hi @stevstrong , do you have any progress on that? Can we close this issue?

Thanks Thomas

stevstrong, 2024-11-02:
Hi,
 I abandoned this project, so feel free to close this if you think that it is not relevant anymore.

gen2thomas, 2024-11-05:
Hi @stevstrong , thanks for the fast response, so I will close this issue.

Closed 2024-11-05.

Thread 818 (2022-04-22):

New ASUS Tinkerboard firmware "TinkerOS" changed pwm path

gen2thomas, 2022-04-22:
Currently tinkerboard adaptor uses the sysfs/pwm_pin.go file. The default Path is set to "/sys/class/pwm/pwmchip0" (pwm0 for pin 33 and pwm1 for pin 32). This does not work, at least with the new TinkerOS. After some try and error it seems the path for pin 32 (PWM3) is "/sys/class/pwm/pwmchip3/pwm0" and for pin 33 (PWM2) it is "/sys/class/pwm/pwmchip2/pwm0".

In addition it seems like the call of "newPin.SetPeriod(10000000)" must be done before call of "newPin.InvertPolarity(false)" in the adaptor PWMPin() function.

This seems to be changed with newer kernels and maybe affect also other adaptors.

I will do some further investigation and can hopefully provide an bugfix for that in a few days.

gen2thomas, 2022-04-24:
Lets startup with some debugging notes.

### Investigate state
```
$ ls /sys/class/pwm/
pwmchip0  pwmchip1

```
pwmchip0 and pwmchip1 seems to be not usable (unknown, which functionality make use of that, maybe fan?)

### Activate
When there is no pwm2, pwm3, this can be activated.
Open the file /boot/config.txt and add lines/remove comment sign and adjust:

intf:pwm2=on
intf:pwm3=on

Then save the file, close and reboot.

After reboot check the state:
```
$ ls /sys/class/pwm/
pwmchip0  pwmchip1  pwmchip2  pwmchip3

```
pwmchip2: the pin 33 is usable
pwmchip3: the pin 32 is usable

When only one pwm was enabled it will be always "pwmchip2". In this case, the activated pin can be found by investigating the sysmbolic link of the device:
```
# ls -la /sys/class/pwm/
total 0
drwxr-xr-x  2 root root 0 Apr 24 14:11 .
drwxr-xr-x 66 root root 0 Apr 24 14:09 ..
lrwxrwxrwx  1 root root 0 Apr 24 14:09 pwmchip0 -> ../../devices/platform/ff680000.pwm/pwm/pwmchip0
lrwxrwxrwx  1 root root 0 Apr 24 14:09 pwmchip1 -> ../../devices/platform/ff680010.pwm/pwm/pwmchip1
lrwxrwxrwx  1 root root 0 Apr 24 14:09 pwmchip2 -> ../../devices/platform/ff680030.pwm/pwm/pwmchip2
```

ff680020 => pwm2, pin33
ff680030 => pwm3, pin32

### Test
For example only pwm3 was activated to use pin32. Connect a oscilloscope or at least a meter to the pin 32.

switch to root user by "su -"

investigate state:
```
# ls -la /sys/class/pwm/pwmchip2/
total 0
drwxr-xr-x 3 root root    0 Apr 24 14:17 .
drwxr-xr-x 3 root root    0 Apr 24 14:17 ..
lrwxrwxrwx 1 root root    0 Apr 24 14:17 device -> ../../../ff680030.pwm
--w------- 1 root root 4096 Apr 24 14:17 export
-r--r--r-- 1 root root 4096 Apr 24 14:17 npwm
drwxr-xr-x 2 root root    0 Apr 24 14:17 power
lrwxrwxrwx 1 root root    0 Apr 24 14:17 subsystem -> ../../../../../class/pwm
-rw-r--r-- 1 root root 4096 Apr 24 14:17 uevent
--w------- 1 root root 4096 Apr 24 14:17 unexport
```
### Creating pwm0
`echo 0 > /sys/class/pwm/pwmchip2/enable`
investigate result:
```
# ls /sys/class/pwm/pwmchip2/
device	export	npwm  power  pwm0  subsystem  uevent  unexport
# ls /sys/class/pwm/pwmchip2/pwm0/
capture  duty_cycle  enable  period  polarity  power  uevent
# cat /sys/class/pwm/pwmchip2/pwm0/period
0
# cat /sys/class/pwm/pwmchip2/pwm0/duty_cycle
0
# cat /sys/class/pwm/pwmchip2/pwm0/enable
0
# cat /sys/class/pwm/pwmchip2/pwm0/polarity
inversed
```
### Initialization
Note: Before writing the period all other write actions will cause an error "-bash: echo: write error: Invalid argument"
```
echo 10000000 > /sys/class/pwm/pwmchip2/pwm0/period # this is a frequency divider for 1GHz (1000 will produce a frequency of 1MHz, 1000000 will cause a frequency of 1kHz, her we got 100Hz)
echo "normal" > /sys/class/pwm/pwmchip2/pwm0/polarity
echo 3000000 > /sys/class/pwm/pwmchip2/pwm0/duty_cycle # this means 30%
echo 1  > /sys/class/pwm/pwmchip2/pwm0/enable

```
Now we should measure a value of around 1V with the meter, because the basis value is 3.3V and 30% leads to 1V.

Try to inverse the sequence:
`echo "inversed" > /sys/class/pwm/pwmchip2/pwm0/polarity`
Now we should measure a value of around 2.3V with the meter, which is the difference of 1V to 3.3V.

If we have attached an oscilloscope we can play around with the values for period and duty_cycle and see what happen.

gen2thomas, 2023-05-15:
part of release v2.0.0

Thread 827 (2022-08-25):

ads1x15 driver not working stable when reading multiple inputs

gen2thomas, 2022-08-25:
Currently I'm testing a module with ADS1115 and 2 used analog input pins. Most of the time the values of both inputs are converted as the same, although the voltage differs (measured by a meter).

The main reason seems to be the wait [line 350 in driver code](https://github.com/hybridgroup/gobot/blob/d8081f912d324f570c6e3fa74aba7c203e53bb27/drivers/i2c/ads1x15_driver.go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) which tries to delay, but is to small or at the wrong position.

According to the datasheet of the ADS111x:
* in the section "Output Data Rate and Conversion Time" "Conversions in the ADS111x settle within a single cycle; thus, the conversion time is equal to 1 / DR.", which the above mentioned line of gobot driver code tries to implement
* in the table "Config Register Field Descriptions" the "OS can only be written when in power-down state and **has no effect when a conversion is ongoing.**", which is not implemented yet

A raw implementation of a "wait for bit15 is 1" seems to fix the problem.

I will make further tests and can possibly provide a fix by one of the both approaches or add a With...() function for that.

gen2thomas, 2022-08-25:
Some further investigations shows that the implemented delay is quite correct (7.912ms for 128 SPS). According to the datasheet the device is compatible with standard, fast and high-speed mode, so this should be no cause for the problem. In the section "Single-Shot Mode", the wake-up time should be fast enough "When the OS bit is asserted, the
device powers up in approximately **25 μs**, resets the OS bit to 0, and starts a single conversion.", so this should also be no cause of the problem.

My device needs arround 32ms for one conversion. Possibly the purchased device is of low quality and don't fulfill the specifications.

So I will go with the safest approach and implement the code like in python. By adding a With...() function, this default behavior can be disabled.

deadprogram, 2022-08-30:
Sounds great @gen2thomas thanks!

gen2thomas, 2023-05-15:
part of release v2.0.0

Closed 2023-05-15.

Thread 830 (2022-08-31):

HMC5883L driver returns wrong values

gen2thomas, 2022-08-31:
According to the datasheet section "Data Output X Registers A and B" the values should be in 2s complement form +0xF800 ... 0x07FF (-2048 ... +2047). In case of an overflow, the value gets "-4096 (0xF000)".

In my first test case, the values of X,Y, Z jump in a high range. All values can exceed 2048 and don't lock to -4096 for a strong magnetic field.

A first investigation shows, that a missing byte-swap after reading the MSB, LSB data with "ReadWordData()" could be the root cause.

I will provide a fix after some further tests, maybe together with #805 .

gen2thomas, 2022-09-01:
After reading the [SMBus specification](http://www.smbus.org/specs/SMBus_3_2_20220112.pdf), I come to the conclusion, that the order is defined as LSB, MSB. This means the direct usage of the SMBus access in sysfs/i2c_device leads to the wrong order for I2C usage for my Tinkerboard in combination with the HMC5883L driver (without swap).

gen2thomas, 2022-09-03:
I have tested the HMC5883L driver today with my digispark platform and the same problem happen. So I looked again to the digispark driver implementation, and I was wrong with my statement that the bytes become swapped, because it reads 2 bytes and the first becomes the low byte, the second the high byte. I will correct my comments above.

gen2thomas, 2022-09-03:
To clarify, how a word read "normally" works, I installed my mcp2221 USB-to-UART/I2C serial converter and connected the HMC5883L to it. Than I initializes the device and read the data for X in different ways:
* i2cget -y 7 0x1e 0x03 --> 0xff
* i2cget -y 7 0x1e 0x04 --> 0xfd
* i2cget -y 7 0x1e 0x03 w --> 0xfdff

This means, that also the commonly used i2cget binary will return a word as LSB, MSB, which matches the implementation of all our platforms. So the HMC5883L driver (and maybe the two others) needs to be fixed.

deadprogram, 2022-09-06:
Looks like something must have gotten mixed up at some point. Thanks for finding this issue!

gen2thomas, 2023-05-15:
part of release v2.0.0

Closed 2023-05-15.

Thread 834 (2022-09-12):

How to set pin is pulled high or pulled low or not pulled?

hacktronics, 2022-09-12:
How to set pin is pulled high or pulled low or not pulled? The question is specific to Raspberry Pi, but in general I couldn't find in the button driver, how to set the pin is pulled or not.
In one support question, I found how to change the default push state, but does gobot support pull characteristics of a pin?

gen2thomas, 2022-09-12:
Please could you specify which driver you use. Maybe I could help, although I have no Raspi but Tinkerboard, most parts are implemented identically.

hacktronics, 2022-09-20:
I mean for buttons, how do you set the pulled mode in the Raspberry Pi.
https://gobot.io/documentation/examples/raspi_button/
I found how to change the default push state, but does gobot support pull characteristics of a pin?

gen2thomas, 2022-09-20:
Possibly you mean a pullup or pulldown resistor to prevent floating input, e.g. for button or an open collector (e.g. when using opto couplers). Not all devices have internal resistors and some, which have them, are not all supported by gobot. So the best way is to apply an external resistor.

In case you have an pulldown resistor and an button to positive voltage, this will just cause inverse logic.

Please also have in mind that some debouncing logic should be added in case you will count something or pulses are not allowed for your actuator. Maybe this is good enough filtered by the 10ms poll interval, but this depends on your special hardware.

gen2thomas, 2023-01-23:
the internal pull up/down feature will be implemented with #897

gen2thomas, 2023-05-15:
part of release v2.0.0

Closed 2023-05-15.

Thread 835 (2022-09-12):

How to dispose a pin?

hacktronics, 2022-09-12:
I have created a leddriver for a pin, let say its no longer needed. In that case, how to dispose that pin and free resources, so that I can make that pin as input button?

gen2thomas, 2022-09-12:
Which adapter do you use and which driver?

Normally you can just switch the pin from output to input by using the related function. But which use case do you have for such an on-the-fly switching?

hacktronics, 2022-09-20:
I am building a MIT Scratch based block based coding software for kids. So in https://ide.codeskool.cc/, this kids can assign a pin and perform some task. Now its hard to stop them from assigning the pin back as a button from a LED. So, for example in https://gobot.io/documentation/examples/raspi_button/, if the pin is previously a LEDDriver, how to dispose that pin and create a new button driver.

gen2thomas, 2022-09-20:
Nice project!

IMO this is a special use case for simulation / code generation only. In reality the hardware is plugged or soldered together, which means a pin is not changeable during the software is running. Therefor also a pin direction will not change. This will be only happen if the hardware will be reworked.

When the count of GPIOs are not enough, and therefore a pin should be used for more than one In/Out, using a multiplexer or an bus (i2c) would be my choice.

Possibly this practical idea behind should be also part of your project? This means, if a pin is added/removed/changed, the system needs to be stopped and initialized afterwards (maybe in the background for easy user experience). Is there a gobot code generator in the background?

hacktronics, 2022-09-21:
https://youtu.be/Kp_Isk_9Mu8, the gobot is an executable running on the Raspberry Pi, its not a code generator. For kids, they won't be writing code or compiling it. So, the executable would be running just once, hence I don't want the system/exe to be stopped and rerun again when the user make a button from a pin, that was earlier a LED. To keep it simple, there is no hardware shield, we are not selling hardware like SunFounder, etc. its a free solution. So the idea of multiplexer won't work here.
So, from this discussion, if something breaks, for example on pin switching, the only way is for the user to rerun the program, which would remove all previous assignments. But I thought a Pin dispose method would be good and wouldn't require shutting program done and running it again and reconnecting to CodeSkool.

gen2thomas, 2022-09-21:
Thanks for the information. Please could you provide your fixed gobot code to have a look, how a button or an LED is defined at first time. What will happen, when a kid change the pin of LED (without changing the direction) - is this currently working - how the code handle this? Do you have already tested a Halt-ChangeType-Start - sequence?

gen2thomas, 2023-06-16:
Hi @hacktronics could you find a solution for your problem? Maybe it is possible now by using the gpiod (cdev) based implementation on your hardware.

gen2thomas, 2023-07-07:
I close this issue due to no activity since some month. Feel free to reopen if this is still a question.

Closed 2023-07-07.

Thread 838 (2022-09-18):

MPU6050 wrong initialize and reduced temperature resolution, missing convert of accel and gyro to physical units

gen2thomas, 2022-09-18:
The initialization routine seems to be an adaptation of the [https://github.com/adafruit/Adafruit_CircuitPython_MPU6050](https://github.com/adafruit/Adafruit_CircuitPython_MPU6050/blob/4ec1d2c264816bfb1340b1191b8242abd9b45eb3/adafruit_mpu6050.py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) but have some mistakes:
* "RWBits" and "RWBit" working in a different way like "i2c.Write()", which only supports a list of bytes to write, this leads to
 * wrong configuration for PWR1 FS_SEL register (should be 0x01, is 0x00 - "8Ghz internal" should be avoided according to data sheet)
 * accidentally set of of PWR2 register with 0x03 and afterwards 0x00
 * wrong configuration of GYRO register (should be 0x00 is 0x04), but FS_SEL seems to be correct with 0x00
 * wrong configuration of ACCEL register (should be 0x00 is 0x04), but AFS_SEL seems to be correct with 0x00
 * access of undefined registers (0x6D, 0x1D, 0x1E)
* reset of general config register (0x1A) is missing
* the reset call is missing, which is also suggested by the data sheet (DEVICE_RESET and SIGNAL_PATH_RESET) when using the SPI interface

The temperature is stored in °C but only as int16. The resolution is 16bit, so it should be possible to have an resolution of at least "1/340" (according to the data sheets equation). Also the python implementation use a slightly other offset of "+ 36.53", gobots implementation us 12412 / 340 = 36,506.

The acceleration and gyroscopic values are stored as int16 without apply the currently used gain. This leads to the requirement of converting the value at user side. Together with some wrong initialization (see above), this could maybe not possible.

gen2thomas, 2023-05-15:
part of release v2.0.0

Closed 2023-05-15.

Thread 844 (2022-09-21):

L3GD20H scale is not used without restart - wrong scale used

gen2thomas, 2022-09-21:
Change of scale must be transferred to the device. This is currently done in the initialization routine (called by Start()). If the scale is set with the provided SetScale() it will modify the used scale for next measurement call by "XYZ()". This cause wrong values, because the real used scale was not changed.

In addition:
* The full scale range is 245 instead of used 250 in the constant name. This seems to be just a cosmetically error, because the real used scale is 0.00875, which corresponds to the data sheet table3 page 10 (8.75 mdps/digit).
* The default value of scale of the used switch/case is "0", which leads to an return value of "0" - an error should be returned in this case or in case of "0x20" this leads to dps2000 (70 mdps/digit) according to data sheets "0x1x" definition.

gen2thomas, 2023-05-15:
part of release v2.0.0

Closed 2023-05-15.

Thread 848 (2022-09-22):

go run error - go version go1.19.1 darwin/amd64

mstrYoda, 2022-09-22:
```bash
❯ go run main.go
# golang.org/x/sys/unix
../../pkg/mod/golang.org/x/sys@v0.0.0-20201126233918-771906719818/unix/syscall_darwin.1_13.go:29:3: //go:linkname must refer to declared function or variable
../../pkg/mod/golang.org/x/sys@v0.0.0-20201126233918-771906719818/unix/zsyscall_darwin_amd64.1_13.go:27:3: //go:linkname must refer to declared function or variable
../../pkg/mod/golang.org/x/sys@v0.0.0-20201126233918-771906719818/unix/zsyscall_darwin_amd64.1_13.go:40:3: //go:linkname must refer to declared function or variable
../../pkg/mod/golang.org/x/sys@v0.0.0-20201126233918-771906719818/unix/zsyscall_darwin_amd64.go:28:3: //go:linkname must refer to declared function or variable
../../pkg/mod/golang.org/x/sys@v0.0.0-20201126233918-771906719818/unix/zsyscall_darwin_amd64.go:43:3: //go:linkname must refer to declared function or variable
../../pkg/mod/golang.org/x/sys@v0.0.0-20201126233918-771906719818/unix/zsyscall_darwin_amd64.go:59:3: //go:linkname must refer to declared function or variable
../../pkg/mod/golang.org/x/sys@v0.0.0-20201126233918-771906719818/unix/zsyscall_darwin_amd64.go:75:3: //go:linkname must refer to declared function or variable
../../pkg/mod/golang.org/x/sys@v0.0.0-20201126233918-771906719818/unix/zsyscall_darwin_amd64.go:90:3: //go:linkname must refer to declared function or variable
../../pkg/mod/golang.org/x/sys@v0.0.0-20201126233918-771906719818/unix/zsyscall_darwin_amd64.go:105:3: //go:linkname must refer to declared function or variable
../../pkg/mod/golang.org/x/sys@v0.0.0-20201126233918-771906719818/unix/zsyscall_darwin_amd64.go:121:3: //go:linkname must refer to declared function or variable
../../pkg/mod/golang.org/x/sys@v0.0.0-20201126233918-771906719818/unix/zsyscall_darwin_amd64.go:121:3: too many errors
```

gen2thomas, 2023-07-07:
Hi @mstrYoda , please can you provide some more information of your main program and which example or driver you try to implement?

mstrYoda, 2023-07-07:
> Hi @mstrYoda , please can you provide some more information of your main program and which example or driver you try to implement?

Hi @gen2thomas, I am so sorry I do not know how I created an issue like this without any context of further information.

I forgot the case in here so may be it is better to close this issue.

gen2thomas, 2023-07-07:
@mstrYoda thanks for your fast response!

Best regards, Thomas

Closed 2023-07-07.

Thread 865 (2022-10-16):

Driver for HC-SR04

Juan1ll0, 2022-10-16:
Hi guys,
  I'm writing some code with Gobot for an IOT device that need to measure a water tank level. I'm think that using an HC-SR04 is a good option but i find that Gobot doesn't have support for this sensor. I found library at https://github.com/raspberrypi-go-drivers/hcsr04 that works fine. I know that this sensor can not be used under "firmata" adaptor because of "pulseIn" function is not implemented, but with another adaptor like "raspi" Can I found any solution?. Is any sensor supported by Gobot similar to this?

I'm trying to write a new Gobot Driver adopting code of https://github.com/raspberrypi-go-drivers/hcsr04 to gobot using a "DirectPinDriver" but doesn't work. Can somebody tell me if is posible?

gen2thomas, 2022-10-19:
Like already mentioned, firmata is not best suitable because "pulsIn". I just add some issues as reference:
* #152
* #246
* #361
* [firmata PR](https://github.com/firmata/arduino/pull/396)

gen2thomas, 2022-10-20:
Hi @Juan1ll0 , please could you provide your new driver (with an example) by a Draft-PR to dev-branch. So maybe we can find a solution.

Juan1ll0, 2022-10-21:
> Hi @Juan1ll0 , please could you provide your new driver (with an example) by a Draft-PR to dev-branch. So maybe we can find a solution.

Juan1ll0, 2022-10-21:
Sorry it doesn't work the code only compiles. I try to transform code like structs, pins and similar but it doesn't work. For example the mentioned project used [github.com/stianeikeland/go-rpio/v4](url) and i transform pins to DirectPinDriver gobot implementation and similar things. If you want I can send you the code.

gen2thomas, 2022-10-21:
@Juan1ll0 please create a branch with your code and file a Draft-PR or add the files here (e.g. as zip) and I can do that.

Juan1ll0, 2022-10-21:
>

OK. I'll do it

Juan1ll0, 2022-10-21:
> @Juan1ll0 please create a branch with your code and file a Draft-PR or add the files here (e.g. as zip) and I can do that.

You've got at [https://github.com/hybridgroup/gobot/pull/872](url). Sorry about my code but i'm not an experto on go. Than you by your interest.

gen2thomas, 2022-10-21:
Ok, could you please describe:
* which adaptor do you use and which specific hardware and installed OS/FW
* how is the setup (e.g. you could provide an example in your PR)
* what exactly does not work (Do you have a specific error, timeout etc?)

Juan1ll0, 2022-10-21:
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
I use a raspberry pi 4 with Raspian, with Gobot 1.16 and Go 1.18.
Adaptor: raspi
Setup: On pins 11 for trigger and 13 for echo
Error: Timeout - message: ERRO[0000] impossible to measure distance                error="echo not received after 60 milliseconds"

I thought the problem is on function StartDistanceMonitor or in getPinStateChangeTime

gen2thomas, 2022-10-23:
@Juan1ll0 please see my remarks in PR.

gen2thomas, 2023-10-30:
available since v2.2.0

Closed 2023-10-30.

Thread 868 (2022-10-18):

joystick：Compiling and running exceptions

wushu037, 2022-10-18:
Thanks a lot for providing the joystick library, it works fine on Mac, but there are exceptions on windows

I used the [sample code](https://github.com/hybridgroup/gobot/tree/release/platforms/joystick#examples) from joystick's readme to run

The first is a compilation error: joystick relies on [go-sdl2](https://github.com/veandco/go-sdl2), and this error occurs when it is compiled cross-platform from Mac to Windows and directly on Windows.
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

For this error. I raised an [issue](https://github.com/veandco/go-sdl2/issues/542) with go-sdl2, and later I replaced it with 0.4.25 as suggested, and it compiled successfully. So maybe joystick should update the version of go-sdl2

However, joystick is running into problems again: I'm using Xbox Wireless Controller (xsx2020) and it only occasionally listens to the trigger button, but not to all other keys!

I also tried to run scanner.go, but it quits immediately
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

gen2thomas, 2022-10-19:
Hi @wushu037, currently "github.com/veandco/go-sdl2 v0.3.3" is referenced by [go.mod](https://github.com/hybridgroup/gobot/blob/b285544e43d20e69d3b3ea19d9b236002b66006c/go.mod#L23). Your suggestion was to use "0.4.25". Therefor I assumed this means the module version, but maybe I'm wrong.

wushu037, 2022-10-20:
Hi @gen2thomas ,i read the issue you linked to, maybe I didn't understand it and didn't see any connection to the go-sdl2 module version.
but yes, go-sdl2 needs to be replaced with the latest version in order to compile properly on windows. Also, even if it runs successfully, there are issues to troubleshoot during runtime (see first comment)

gen2thomas, 2022-10-20:
Hi @wushu037 , I have now fixed the old modules on dev branch. I started "go run scanner.go" like you have done, but without any joystick attached and in a Linux box - it do not exit immediately, it waits. Unfortunately I have no windows system to test it.

What do you mean with "it works fine on Mac"? Do you have used the same example? I ask, because the example use a "dualshock3" type. Is this compatible with your "Xbox Wireless Controller (xsx2020)"?

wushu037, 2022-10-20:
Hi, @gen2thomas , thank you for your investigation of the problem
Here's the thing. I tested it on Mac and Windows, and it works fine on Mac, but on Windows it appears to be abnormal. I didn't test it on Linux

It is the example of the sample. I didn't give my program for the sake of describing the problem. Although the example uses "dualshock3", on Mac, my xsx2020 joystick still has multiple keys that can be listened to. But on Windows, only the trigger key is occasionally listened to

To better solve the problem, I give my program file. It implements a very simple function: mapping the joystick's share keys to the system's share keys. In this program, the configuration file is set up by me running scanner.go on my Mac, and also only the trigger key is responded to.

[归档.zip](https://github.com/hybridgroup/gobot/files/9828891/default.zip)

If you don't have Windows, you can install a virtual machine and the effect should be the same. Either on a win virtual machine or a win physical machine, I tried

gen2thomas, 2022-10-20:
Hi @wushu037 , I need to stop my support here, because windows and no joystick available.

Please could you change the headline to which is more pointing to the remaining problem, e.g. this words/phrases should be included "windows, scanner.go, only one key". So someone can pick up the issue with existing hardware and deeper knowledge.

gen2thomas, 2024-11-01:
Hi @wushu037 , the sdl dependency is now replaced by another module. Maybe you can test again your device on Windows with the new implementation.

Thanks Thomas

Thread 920 (2023-05-19):

installation problems with "v2"

gen2thomas, 2023-05-19:
latest recognized version seems to be 1.16.0:
```
go install gobot.io/x/gobot@latest
go: downloading gobot.io/x/gobot v1.16.0

```
try to install version 2.0.0 will result in an error:
```
go install gobot.io/x/gobot@v2.0.0
go: gobot.io/x/gobot@v2.0.0: gobot.io/x/gobot@v2.0.0: invalid version: module contains a go.mod file, so module path must match major version ("gobot.io/x/gobot/v2"
```
For root cause, see e.g.: https://research.swtch.com/vgo-import

the solution: https://github.com/golang/go/wiki/Modules#semantic-import-versioning

example: https://github.com/cpuguy83/go-md2man/blob/master/go.mod

gen2thomas, 2023-05-21:
Version v2.0.1 is released to fix this problem, but it don't. The new version can not be found with an external example project.

```
go list -u -m all
go: unrecognized import path "gobot.io/x/gobot/v2": reading https://gobot.io/x/gobot/v2?go-get=1: 404 Not Found
go: gobot.io/x/gobot/v2@v2.0.1: missing go.sum entry; to add it:
	go mod download gobot.io/x/gobot/v2
```

I have found different resources for v2+ modules:
* https://go.dev/blog/v2-go-modules --> suggests to create a folder "v2" with a copy of code, due to best backward compatibility
* https://donatstudios.com/Go-v2-Modules --> outlines the history of v2+
* https://therootcompany.com/blog/bump-go-package-to-v2/ --> the result can be a caching problem

gen2thomas, 2023-05-21:
v1:
```
go list -m -json gobot.io/x/gobot@latest
{
	"Path": "gobot.io/x/gobot",
	"Version": "v1.16.0",
	"Query": "latest",
	"Time": "2022-05-02T19:56:19Z",
	"Dir": "/home/thkoh/go/pkg/mod/gobot.io/x/gobot@v1.16.0",
	"GoMod": "/home/thkoh/go/pkg/mod/cache/download/gobot.io/x/gobot/@v/v1.16.0.mod",
	"GoVersion": "1.13"
}
```
v2+:
```
go list -m -json gobot.io/x/gobot/v2@latest
go: gobot.io/x/gobot/v2@latest: unrecognized import path "gobot.io/x/gobot/v2": reading https://gobot.io/x/gobot/v2?go-get=1: 404 Not Found

```

gen2thomas, 2023-05-21:
It seems the simple version increasing will not work in our case, see https://github.com/golang/go/wiki/Modules#releasing-modules-v2-or-higher.

citation: "(Note that this advice regarding incrementing the major version when first adopting modules does not apply to pre-existing repos or packages whose latest versions are v0.x.x or v1.x.x)"

Hi @deadprogram , how we should proceed with this issue? IMO we have some possibilities:
* create a folder v2
* create a branch v2 (see also https://research.swtch.com/vgo-module)
* move v1 code away to another branch/folder (not sure if this will work)
* use a "v1.x.y+incompatible" release instead of v2+

Any suggestions/ideas?

Thanks, Thomas

deadprogram, 2023-05-21:
Yes, only if we had started with our various code in a `gobot` folder inside of the main package would the module naming used by https://github.com/google/go-github work.

Considering our options here... :thinking:

deadprogram, 2023-05-21:
"create a folder v2" is the most common pattern and would be least surprising to developers.

gen2thomas, 2023-05-21:
@deadprogram , thanks for your immediate answer. So I will remove the current releases/tags first, than create the folder and will release the "v2.0.0" again, right?

deadprogram, 2023-05-21:
Not sure about the tags, maybe better to just add new one 2.0.3

gen2thomas, 2023-05-21:
@deadprogram do you really mean 2.0.3? Normally the next version increment would be 2.0.2.

I would move the code to the new "v2" folder according to this example https://github.com/googleapis/gax-go. What do you think?

gen2thomas, 2023-05-22:
Thanks, and I was wrong with my given example. There was done a copy to v2 folder, so the development can also continue on version 0.x/1.x, IMO there is no other reason for this. In our case, I think, nobody wants to maintain the old version v1.x. So I move the code to the v2 folder.

gen2thomas, 2023-05-23:
After releasing v2.0.2 it is not working completely. This means `go list -m -json gobot.io/x/gobot/v2@latest` is still not working, but the following call works (with 2.0.1,  2.0.2 and latest):

```
go list -m -json  github.com/hybridgroup/gobot/v2@v2.0.1
{
	"Path": "github.com/hybridgroup/gobot/v2",
	"Version": "v2.0.1",
	"Time": "2023-05-21T14:05:39Z",
	"GoMod": "/home/user/go/pkg/mod/cache/download/github.com/hybridgroup/gobot/v2/@v/v2.0.1.mod",
	"GoVersion": "1.17",
	"Origin": {
		"VCS": "git",
		"URL": "https://github.com/hybridgroup/gobot",
		"Ref": "refs/tags/v2.0.1",
		"Hash": "20a92a378584154b2cba2f3344e92e30e31c53ac"
	}
}
```
It seems there is a missing forward from the website or something else. If we can get it to work with v2.0.1 this would be nice, because moving the code to the v2 subfolder in v2.0.2 has some drawbacks.

@deadprogram do you have any idea to fix this?

gen2thomas, 2023-05-24:
Now I have tested v2+ with a new branch "v2":
* created from release and released as v2.0.3
* branch content reverted to the tag "v2.0.1" (the one without v2 subfolder) and released as v2.0.4-pre1

both with the same result:
* `gobot.io/x/gobot/v2` is not working
* `github.com/hybridgroup/gobot/v2` is working

I'm running out of ideas.

gen2thomas, 2023-05-24:
It seems "periph.io" runs in the same problem 2017 and solved this with a [new start in 2020](https://periph.io/news/2020/a_new_start/). See also this version history https://pkg.go.dev/periph.io/x/periph?tab=versions - it begins with a "v2.0.0+incompatible" tag.

Possibly this is the only solution at the moment?

gen2thomas, 2023-05-26:
Hi  @deadprogram , here for [uuid](https://github.com/gofrs/uuid/issues/61) we can find a good description of the problem with a nice [solution](https://github.com/gofrs/uuid/issues/61#issuecomment-440128310) (read also the later comments to get an idea of the steps to be taken)

I will try to sum up it later for gobot as a base for discussion.

deadprogram, 2023-05-26:
Thanks @gen2thomas I will take a look.

gen2thomas, 2023-05-28:
@deadprogram  here you can find an excellent wrap up of all possible solutions with its pros and cons. This was done by investigation of multiple projects: https://github.com/KateGo520/Hero/issues/1.

gen2thomas, 2023-05-28:
After some more investigation I'm more wondering than before and still have no idea what went wrong. Here you can find my document: [WORKFLOW_V2+.md](https://github.com/gen2thomas/gobot/blob/doc/try_fix_v2%2B/WORKFLOW_V2%2B.md)

Conclusion:
* the transition is almost always done like we have done (change go.mod and adjust internal paths by adding "/v2", or sometimes "/v3" or "/v4")
* I have not found any project, which uses a folder "v2", some uses a branch "v2", "v3", "v4 for smooth transition of GOPATH users (as far I can tell, this do not affect module mode in any form)
* most projects run from the beginning in GOPATH mode, and just introduce v2.0.0 in GOPATH mode, which automatically produce "v2.0.0+incompatible" releases and afterward, with a newer version to module mode (e.g. "/v3"), without any problem
* some projects start with go.mod from the beginning and the transition is the same without any problem
* 1 project was investigated with the same precondition like gobot, but the same transition went well without any problem

gen2thomas, 2023-05-29:
Because there is already an "v2.0.0+incompatible" version (GOPATH, but defective), and all v2+ versions (model mode) are not available for download, I will moving forward in this direction:
* revert the move of code to the sub directory and remove the go.mod file
* **release** this state as "2.0.5+incompatible", this should fix the usage of v2 in GOPATH mode
* re-add go.mod and release this as "v2.1.0", with the hope that will then work for v2+ in module mode (last try for v2.x, unless there are more ideas)
* upgrade to go 1.18 and module dependencies
* prepare code for v3 (go.mod and switch all paths of local files)
* release this state as v3.0.0, hopefully this will resolve our problems for this issue

gen2thomas, 2023-05-31:
Unfortunately, the new v2+ package (v2.1.0) package is [still not available](https://pkg.go.dev/gobot.io/x/gobot?tab=versions). But if you click on [Open Source Insights ](https://deps.dev/go/gobot.io%2Fx%2Fgobot/v1.16.0)  at this page, you can see [the package](https://deps.dev/go/gobot.io%2Fx%2Fgobot%2Fv2).

On the [dependencies](https://deps.dev/go/gobot.io%2Fx%2Fgobot%2Fv2/v2.1.0/dependencies) there is a problem with [tinygo.org/x/bluetooth](https://deps.dev/go/tinygo.org%2Fx%2Fbluetooth/v0.6.0).

Maybe this prevents publishing the new package, because this is now important in module mode, but was not in GOPATH mode.

So a new idea would be to deactivate/remove the ble adaptor and remove the problematic dependency from gobot for a test with a new version 2.2.0.

@deadprogram  what do you think?

gen2thomas, 2023-06-01:
>  problem with the Gobot build.
There is no build problem, but there is a small chance, that the publishing of the "module mode releases" (like 2.1.0) are blocked due to this missing modules. This is only a "static" dependency problem.

deadprogram, 2023-06-06:
I think the core problem here is we were missing the needed custom domain redirect to handle the `v2` suffix.

```
$ go get gobot.io/x/gobot/v2@v2.1.0+incompatible                                                                                                                     
go: gobot.io/x/gobot/v2@v2.1.0+incompatible: unrecognized import path "gobot.io/x/gobot/v2": reading https://gobot.io/x/gobot/v2?go-get=1: 404 Not Found             
```

I added this PR to the `gobot-site` repo:
https://github.com/hybridgroup/gobot-site/pull/81

Now the v2 Gobot package appears to be working as I expect from one of the repos that I have which uses it:
https://github.com/hybridgroup/gophercon-2022/commit/e4e3f1a5706b0b6e79855b0b4981c6acb579f2ea

This was what I first ran to update the `go.mod` file in that repo:
```
$ go get gobot.io/x/gobot/v2@v2.1.0+incompatible                                                                                                                     
go: gobot.io/x/gobot/v2@v2.1.0+incompatible: invalid version: +incompatible suffix not allowed: major version v2 is compatible                                       
```

Hmm now it is compatible? Sweet!

```
$ go get gobot.io/x/gobot/v2@v2.1.0                                                                                                                                  
go: downloading gobot.io/x/gobot/v2 v2.1.0                                                                                                                           
go: upgraded github.com/gofrs/uuid v4.3.0+incompatible => v4.4.0+incompatible                                                                                        
go: added gobot.io/x/gobot/v2 v2.1.0                                                                                                                                 
go: upgraded golang.org/x/sys v0.1.0 => v0.8.0                                                                                                                       
```

After that I was able to build my code using v2 and Bluetooth:

```
$ go build -o keyboard-control ./keyboard/

$ ls -l keyboard-control
-rwxrwxr-x 1 ron ron 6460290 jun  6 12:53 keyboard-control
```

gen2thomas, 2023-06-06:
Hi @deadprogram , Thanks!

It sounds like a hack, but it works, also for [pkg.go.dev](https://pkg.go.dev/gobot.io/x/gobot/v2). Lets see what happen with v3 - depending on gobot-site for all upcoming versions feels wrong to me.

gen2thomas, 2023-06-07:
Hi @deadprogram , thanks for the enlightenment, although I have not understand the content of the provided links completely. I thought the redirect is done "automatically" in the background but I see now that there was the same for the v0/v1 [present at gobot-site](https://github.com/hybridgroup/gobot-site/blob/master/source/x/gobot/index.html). So my earlier guess, was not so bad :smile::

> It seems there is a missing forward from the website or something else

Thanks again, so we are prepared for v3 and I can close this issue immediately.

deadprogram, 2023-06-07:
I wish I had noticed your earlier guess, you had the right idea about what was going wrong!

Closed 2023-06-07.

Thread 968 (2023-07-03):

cannot find modules on install

jney, 2023-07-03:
Install `go get -d -u gobot.io/x/gobot/...` terminate with the following errors

```
gobot.io/x/gobot/drivers/spi imports
	periph.io/x/periph/conn/physic: cannot find module providing package periph.io/x/periph/conn/physic
gobot.io/x/gobot/drivers/spi imports
	periph.io/x/periph/conn/spi: cannot find module providing package periph.io/x/periph/conn/spi
gobot.io/x/gobot/drivers/spi imports
	periph.io/x/periph/host/sysfs: cannot find module providing package periph.io/x/periph/host/sysfs
```

gen2thomas, 2023-07-06:
Hi @jney , please use "gobot/v2/" or after creating your application use "go mod tidy" instead.

gen2thomas, 2023-07-07:
A new documentation is released now, so I will close this issue. Feel free to reopen if we should do something more.

tlindsay, 2023-12-08:
@gen2thomas The [GoBot Getting Started](https://gobot.io/documentation/getting-started/) guide still lists this as the first step:
```
$ go get -d -u gobot.io/x/gobot/...
```

gen2thomas, 2023-12-08:
@tlindsay yes, this is outdated in many places, but there is no time to [fix it](https://github.com/hybridgroup/gobot-site/issues/61).

Closed 2023-07-07.

Thread 1004 (2023-10-19):

roadmap(ble): implement support for more peripherals

gen2thomas, 2023-10-19:
see https://en.wikipedia.org/wiki/Bluetooth_Low_Energy

gen2thomas, 2024-01-31:
Milestones:
* [ ] move drivers to drivers/ble
* [ ] try to unify drivers
* [ ] improve test coverage
* [ ] improve README
* [ ] add new drivers or one as example

gen2thomas, 2024-02-12:
Simple drivers can be added by copy the battery driver and replace the short characteristic value (0x2A6F for Humidity). The developer should own the related device. So implementing arbitrary drivers is not useful at the moment, but can be done with less effort when needed. For further reading see https://www.bluetooth.com/specifications/assigned-numbers/

gen2thomas, 2024-11-05:
Fixed with [v2.4.0](https://github.com/hybridgroup/gobot/releases/tag/v2.4.0)

Closed 2024-11-05.

Thread 1007 (2023-10-20):

Support for Sphero BOLT

dennisgove, 2023-10-20:
Sphero sells a device called [Sphero BOLT](https://sphero.com/products/sphero-bolt) which is similar (in appearance) to the SPRK+. However it appears that the Ollie driver code doesn't work with it. In particular, the device characteristics don't match what's defined in [ollie_driver.go](https://github.com/hybridgroup/gobot/blob/release/platforms/sphero/ollie/ollie_driver.go#L30-L40).

These are the characteristics read from the BLE adapter during connection, but all of them appear to have this `unreadable: unknown or unsupported kind: "invalid"` value.

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

I'd like to try putting together driver code for the BOLT but I'm not quite sure where to go from here. I haven't been able to find if the BOLT is based on the same Ollie core that the SPRK+ and bb8 appear to be. If not I imagine I'd be starting from scratch but if it is I'm not sure how I'd go about determining which characteristic ID maps to which action (like `wake`, `command`, and `response`).

Do you have advice on where I should go from here? Thank you!

gen2thomas, 2023-10-20:
Hi @dennisgove , I have no experience with sphero toys at all. But there is at least one difference in the python code: The [ToyType](https://github.com/artificial-intelligence-class/spherov2.py/tree/main/spherov2/toy) ends with ".06" for all old devices and with ".075" for the new one. This seems to be the command safe interval. Maybe this is only a timing problem?

My suggestion is to start with a copy of ollie-driver and fix all calls. After that it is possible to optimize the architecture, for the duplicated code parts. Maybe only some constants needs to be different.

If you provide an PR I can support you for the architecture optimization part.

Good luck, Thomas

dennisgove, 2023-10-20:
Thank you, @gen2thomas. I'll peruse that python code and see how far I can get with it. This is a great starting point.

deadprogram, 2023-10-22:
Please see https://github.com/nicholasjackson/sphero-mini for how this can be done using Golang.

Perhaps a new Gobot driver that wraps this package? Or else learn for how it does things and add to the current one? Someone can perhaps take a deep look to decide which of those options seems better.

Thread 1013 (2023-10-25):

avoid master/slave terminology

gen2thomas, 2023-10-25:
SPI: redefine signal names, see: https://www.oshwa.org/a-resolution-to-redefine-spi-signal-names/
* MOSI/MISO/SS --> SDO/SDI/CS
* Master/Slave --> Controller/Peripheral

gen2thomas, 2024-02-13:
Additionally:
* same as above for usages in I2C
* substitute wrong github-paths `https://github.com/hybridgroup/gobot/<blob/tree>/master` to the "release" path
* master.go with manager.go, same for related types
* search for remaining occurrences of "master" and replace e.g. by one of the following names:
` controller, default, director, host, initiator, leader, manager, primary, principal, root`
* search for remaining occurrences of "slave" and replace e.g. by one of the following names:
` agent, client, device, performer, peripheral, replica, responder, satellite, secondary, subordinate, worker`

gen2thomas, 2024-11-05:
Fixed with [v2.4.0](https://github.com/hybridgroup/gobot/releases/tag/v2.4.0)

Closed 2024-11-05.

Thread 1017 (2023-10-27):

code and test contains data race

gen2thomas, 2023-10-27:
run tests with race, e.g. by `make test_race` gives multiple data race errors

* fix those errors
* add some remarks to documentation for new contributors
* maybe activate "-race" flag by default
* maybe add remark to PR template

gen2thomas, 2023-10-30:
* aio
* gpio
* i2c --> affects all adaptors, which support i2c

gen2thomas, 2024-01-07:
fix released with [v2.3.0](https://github.com/hybridgroup/gobot/releases/tag/v2.3.0)

Closed 2024-01-07.

Thread 1032 (2023-11-10):

raspi with gpio.servo not work (like expected)

gen2thomas, 2023-11-10:
I create this new issue to collect all various former issues related to gpio.ServoDriver().
The ServoWriter interface is used. For raspi, it should normally work also without [pi-blaster](https://github.com/sarfata/pi-blaster) for [PWM0, PWM1](https://www.raspberry-pi-geek.de/ausgaben/rpg/2020/04/grundlagen-der-pulsweitenmodulation/). But this seems to be not implemented, because always the `/dev/pi-blaster` will  be returned from the pwmPin() function.

So it seems this parts should be solved (something like a roadmap):

* [x] introduce variadic function for gpio drivers, see #998
* [x] introduce usage of normal PWM pin, without pi-blaster (with variadic functions)
* [x] endpoints/angle not work like expected (adjustable with variadic functions), see #692
* [x] fix pi-blaster usage (or the description how it needs to be configured), see #703 , #753

I'm going to close all the old referenced issues in favor of this one.

gen2thomas, 2024-01-07:
fix released with [v2.3.0](https://github.com/hybridgroup/gobot/releases/tag/v2.3.0)

Closed 2024-01-07.

Thread 1050 (2023-12-27):

HX711 Support

Juan1ll0, 2023-12-27:
Hi guys,
  Is it possible to write a new driver for HX711 weight cells in Gobot?. Can i use some other device driver supported by Gobot as example?

Thanks.

gen2thomas, 2023-12-27:
Hi @Juan1ll0 , it seems it has a plain serial interface, so it is currently not supported and there is no example driver. As far as I remember there was already an issue to implement a serial interface.

Maybe you can choose [another one](https://www.sparkfun.com/products/15242) or try to use a converter, e.g. to i2c.

Juan1ll0, 2023-12-28:
Thank you very much @gen2thomas I didn't know this kind of sensors. I bought one to test it. I will try to write a driver for Gobot.

Regards.

gen2thomas, 2024-11-01:
Hi @Juan1ll0 , maybe the new serial driver is a start point for your implementation now. Do you have any progress?

Thread 1077 (2024-03-12):

Write pwm export() failed for id xx "with open gpiochip0"

idalmasso, 2024-03-12:
Trying to write pwm to a LedDriver with a raspberry pi 4 (fresh install of raspbian) fives the error export() failed for id 26 "with open gpiochip0" (trying to use the pin "37" that is actually GPIO 26).
This error is actually new in v2.3.0 of gobot (I just reverted to 2.2 and everything works fine).

gen2thomas, 2024-03-14:
Hi @idalmasso , thanks for finding and report this issue. I will have a look in the next few days.

gen2thomas, 2024-03-17:
Hi @idalmasso , the PWM usage has changed a bit since 2.3.0.
Until 2.2.0 the pi-blaster was used by default. Now the internal PWMs are used by default and the usage of pi-blaster must be forced by "adaptors.WithPWMUsePiBlaster()". I missed to add this to the migration guide, but it is described in the [README](https://github.com/hybridgroup/gobot/blob/v2.3.0/platforms/raspi/README.md#using-pi-blaster).

If it will not work , please can you provide your program or at least the part for creating the raspi-adaptor and the lines which creates the error output.

Thanks Thomas

idalmasso, 2024-03-18:
Hello @gen2thomas , thanks for your answer. Yes, I just retried with the WithPWMUsePiBlaster and it seems to be working fine, sorry I had to improve my RTFM capabilities, sorry to have made you lose time!

gen2thomas, 2024-03-18:
You are welcome, good to hear that it's working now.

Closed 2024-03-18.

Thread 1079 (2024-03-18):

Stepper driver DRV8825

Juan1ll0, 2024-03-18:
Hi friends,

Is it posible to use DRV8825 stepper driver with gobot?

Thank you, very much.

Juan1ll0, 2024-03-19:
YES, I answer myself. I'm happy that is something quite simple. I will try to write a driver for Gobot for DRV8825 stepper driver.  This is a sample code, that works for me on a RPI4 (If it doesn't work play with time on gobot.Every sentence):

```
package main

import (
	"time"
	"gobot.io/x/gobot/v2"
	"gobot.io/x/gobot/v2/platforms/raspi"
)

func main() {
	r := raspi.NewAdaptor()

	work := func() {
		// Direction Pin (DRV8825 DIR)
		r.DigitalWrite("37", 1)

		step := true
		gobot.Every(1*time.Millisecond, func() {
			if step {
                               // Step pin (DRV8825 STP)
				r.DigitalWrite("35", 1)
				step = false
			} else {
				r.DigitalWrite("35", 0)
				step = true
			}
		})

		return
	}

	robot := gobot.NewRobot("stepperBot",
		[]gobot.Connection{r},
		[]gobot.Device{},
		work,
	)

	robot.Start()
}
```

Thread 1087 (2024-08-31):

[HC-SR04] write /dev/i2c-1: connection timed out

TuringZhu, 2024-08-31:
Hello, I a beginner gobot & raspberry pi.

Now I use [examples/raspi_grove_pi_ultrasonic.go](https://github.com/hybridgroup/gobot/blob/release/examples/raspi_grove_pi_ultrasonic.go) to check with Raspberry Pi Model B and ultrasonic model with HC-SR04.

I have some problems can not be solved.

 HC-SR04 has 4 Pin with VCC,GND,Trig_RX-SCL_I/O, ECHO_DX_SDA but the code just defined `ultrasonicPin = "4"`,  so how can I connect
my raspberry pi with HC-SR04

and no matter what pin i connect  the code always output `write /dev/i2c-1: connection timed out`. I want to know why.

in addition, I hope to have a website or other chat groups can get other developer's help quickly. I would be extremely grateful.

gen2thomas, 2024-09-16:
Hello @TuringZhu ,

do you have really an I2C ultrasonic Model with the name HC-SR04? Normally this is an analog one. Please try to use this example instead:
https://github.com/hybridgroup/gobot/blob/release/examples/raspi_hcsr04.go

Good luck, Thomas

gen2thomas, 2024-11-01:
Hi @TuringZhu do you have any progress or further questions on that?

Maybe we can close this issue?

Thanks Thomas

Closed 2025-01-11.

Thread 1098 (2024-11-06):

[HCSR04] no clean finish for discrete edge polling with gpiod

gen2thomas, 2024-11-06:
If  "WithHCSR04UseEdgePolling()" is used, stopping the robot by CTRL-C hangs. This is only tested with gpiod driver, not sysfs.

This is caused by the reconfiguration of the pin with this call hierarchy:
* DigitalPinsAdaptor.Finalize()
* pin.Unexport()
* digitalPinGpiodReconfigure()
* digitalPinGpiodReconfigureLine()
* startEdgePolling()
* call of a go - function with a loop, like this

```
	wg := sync.WaitGroup{}
	wg.Add(1)

	go func() {
...
		var firstLoopDone bool
		for {
			select {
			case <-quitChan:
				return
			default:
...				if !firstLoopDone {
					wg.Done()
					firstLoopDone = true
				}
			}
		}
	}()

	wg.Wait()
```

The wait group ensures, that the first reading is done for the edge detection. But for the "Finalize()" call the quitChan will be closed immediately and the waitgroup is not done. This is more clean and will fix the problem:

```
for {
			select {
			case <-quitChan:
				if !firstLoopDone {
					wg.Done()
				}
				return
			default:
```

gen2thomas, 2025-02-16:
fixed in v2.5.0

Closed 2025-02-16.

Thread 1102 (2024-11-14):

sprk+ panic read not permitted

aolney, 2024-11-14:
I'm on

- go version go1.23.3 linux/amd64
- Description:	Ubuntu 22.04.5 LTS

with

```bash
go build bleclient_sprkplus_collision.go
sudo ./bleclient_sprkplus_collision SK-955D
```

I get this output

```bash
2024/11/14 16:49:02 Initializing connections...
2024/11/14 16:49:02 Initializing connection BLEClient-2F161359000C8B7F ...
2024/11/14 16:49:02 Initializing devices...
2024/11/14 16:49:02 Initializing device SPRKPlus-6FF4B646F0CF43D4 ...
2024/11/14 16:49:02 Robot sprkplus initialized.
2024/11/14 16:49:02 Starting Robot sprkplus ...
2024/11/14 16:49:02 Starting connections...
2024/11/14 16:49:02 Starting connection BLEClient-2F161359000C8B7F...
2024/11/14 16:49:05 Starting devices...
2024/11/14 16:49:05 Starting device SPRKPlus-6FF4B646F0CF43D4...
2024/11/14 16:49:05 Starting work...
panic: Read not permitted

goroutine 280 [running]:
gobot.io/x/gobot/v2/drivers/ble/sphero.(*OllieDriver).initialize.func2()
	/home/aolney/go/pkg/mod/gobot.io/x/gobot/v2@v2.4.0/drivers/ble/sphero/sphero_ollie_driver.go:237 +0x65
created by gobot.io/x/gobot/v2/drivers/ble/sphero.(*OllieDriver).initialize in goroutine 1
	/home/aolney/go/pkg/mod/gobot.io/x/gobot/v2@v2.4.0/drivers/ble/sphero/sphero_ollie_driver.go:234 +0x14a
```

I can avoid this error by commenting out references to `ball`, e.g.
``` go
ball := sphero.NewSPRKPlusDriver(bleAdaptor)
```
In other words, if I have a robot with just the bleclient, there is no error. So the problem seems to be with NewSPRKPlusDriver.

Any suggestions appreciated :) This is my first `go` project

gen2thomas, 2024-11-15:
Hi @aolney , thanks for adding this issue. Unfortunately I had no hardware for testing this after I have done some rework. Only the existing tests helped me a little bit, but you can see there are not that much.

Back to your finding:
The panic comes from a go-routine in line 234 of the base driver sphero_ollie_driver.go (asynchronous execution each 100ms). Surprisingly it calls ReadCharacteristic(), but drops the return value except the error.

It seems you are using the [example](https://github.com/hybridgroup/gobot/blob/release/examples/bleclient_sprkplus_collision.go). So the initialize() function is called from your main in line [47](https://github.com/hybridgroup/gobot/blob/4a19dee361071c18db7a9b9cb724dc52de86ae12/examples/bleclient_sprkplus_collision.go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) (robot.Start()).

My first idea is to drop this go function completely, because in line [220](https://github.com/hybridgroup/gobot/blob/4a19dee361071c18db7a9b9cb724dc52de86ae12/drivers/ble/sphero/sphero_ollie_driver.go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) we subscribe on changes of "responseChara". If a cyclic call is needed, maybe the device is not ready until this call.

For this a second idea comes up, change the [go function](https://github.com/hybridgroup/gobot/blob/4a19dee361071c18db7a9b9cb724dc52de86ae12/drivers/ble/sphero/sphero_ollie_driver.go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), so the error is logged only and increase sleep:
```
go func() {
		for {
			if _, err := d.Adaptor().ReadCharacteristic(responseChara); err != nil {
				// panic(err)
                                fmt.Printf("error issue 1102: %v",err)
			}
			// time.Sleep(100 * time.Millisecond)
                        time.Sleep(1000 * time.Millisecond)
		}
	}()
```

I am looking forward to your feedback, Thomas

aolney, 2024-11-26:
Thanks for those suggestions @gen2thomas

Deleting the function seems to be the way to go. If you modify it with the message as suggested, it just seems to print out the message forever.

After deleting, I got correct behavior with `go run examples/bleclient_bb8-collision.go SK-955D`

gen2thomas, 2024-11-27:
Hi @aolney , thanks for your detailed answer. I will re-open this issue and mark it as a bug. The fix can be the removing of the complete go function. If you encounter a related problem when you make further tests, please add information to this issue.

gen2thomas, 2025-02-16:
fixed in v2.5.0

Closed 2025-02-16.

Thread 1109 (2024-12-21):

[nanopi, raspi, tinkerboard]: system.WithDigitalPinGpiodAccess() can not be overriden

gen2thomas, 2024-12-21:
Because the option "system.WithDigitalPinGpiodAccess()" is set on constructor and there is no "system.WithDigitalPinSysfsAccess()", it is not possible to test (and unit-test) the sysfs behaviour on a board which supports gpiod. Especially all unit tests run OK on server or on machines where the feature is not activated because there is a fallback programmed to use sysfs in this case.

If unit tests of e.g. tinkerboard or nanopi platform are started on a machine with activated gpiod, the test tries to use gpiod, which can be critical for the machine, if the gpiod access rights are configured properly and the used pin is not busy. In any case this tests will fail in raspi_adaptor_test.go, tinkerboard/adaptor_test.go , nanopi/nanopi_adaptor_test.go:
* TestDigitalIO
* TestFinalizeErrorAfterGPIO

The fix should include:
* introduce "system.WithDigitalPinSysfsAccess()" to override the constructors default
* use gpiod as default in constructor for all those adaptors without the "system.WithDigitalPinGpiodAccess" call
* change all examples and unit-tests to use "system.WithDigitalPinSysfsAccess()"
* try to introduce unit-tests for gpiod (-mock, on starting with gpiod there was no simple solution for that)

gen2thomas, 2025-02-16:
fixed in v2.5.0

Closed 2025-02-16.
