hybridgroup/gobot/(list of files, drawings)

Other design files:
platforms/gpio/docs/breadboards/analog_sensor.fzz
platforms/gpio/docs/breadboards/button.fzz
platforms/gpio/docs/breadboards/led.fzz
platforms/gpio/docs/breadboards/makey_button.fzz
platforms/gpio/docs/breadboards/maxbotix.fzz
platforms/gpio/docs/breadboards/motor.fzz
platforms/gpio/docs/breadboards/servo.fzz
platforms/i2c/docs/breadboards/blinkm.fzz
platforms/i2c/docs/breadboards/hmc6352.fzz
platforms/i2c/docs/breadboards/lcd.fzz
platforms/i2c/docs/breadboards/mpl115a2.fzz
