hybridgroup/gobot/platforms/digispark/littleWire_servo.c

/*
	Higher level servo driving library for Little Wire.

	Copyright (C) <2013> ihsan Kehribar <ihsan@kehribar.me>
	
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
	THE SOFTWARE IS PROVIDED "AS IS", WITHOUT WARRANTY OF ANY KIND, EXPRESS OR
	IMPLIED, INCLUDING BUT NOT LIMITED TO THE WARRANTIES OF MERCHANTABILITY,
	FITNESS FOR A PARTICULAR PURPOSE AND NONINFRINGEMENT. IN NO EVENT SHALL THE
	AUTHORS OR COPYRIGHT HOLDERS BE LIABLE FOR ANY CLAIM, DAMAGES OR OTHER
	LIABILITY, WHETHER IN AN ACTION OF CONTRACT, TORT OR OTHERWISE, ARISING FROM,
	OUT OF OR IN CONNECTION WITH THE SOFTWARE OR THE USE OR OTHER DEALINGS IN THE
	SOFTWARE.
*/

#include "littleWire_servo.h"

/********************************************************************************
* Useful definitions
********************************************************************************/
const float MIN_LIMIT = 0.45; // in miliseconds
const float MAX_LIMIT = 2.45; // in miliseconds
const float STEP_SIZE = 0.062; // in miliseconds
const float RANGE = 180.0; // in degrees
/*******************************************************************************/

/********************************************************************************
* Servo module initialization
********************************************************************************/
void servo_init(littleWire* lwHandle)
{
	pwm_init(lwHandle); // Initialize the PWM hardware.
	pinMode(lwHandle,PWMA,OUTPUT); pinMode(lwHandle,PWMB,OUTPUT); // Set PWM pins output.
	pwm_updatePrescaler(lwHandle,1024); // Make sure the PWM prescaler is set correctly.
}
/*******************************************************************************/

/********************************************************************************
* Servo locations update
*	locationChannelA in degrees
*	locationChannelB in degrees
********************************************************************************/
void servo_updateLocation(littleWire* lwHandle,unsigned char locationChannelA,unsigned char locationChannelB)
{
	locationChannelA=(((locationChannelA/RANGE)*(MAX_LIMIT-MIN_LIMIT))+MIN_LIMIT)/STEP_SIZE;
	locationChannelB=(((locationChannelB/RANGE)*(MAX_LIMIT-MIN_LIMIT))+MIN_LIMIT)/STEP_SIZE;
	pwm_updateCompare(lwHandle,locationChannelA,locationChannelB);
}
/*******************************************************************************/
