hybridgroup/gobot/(commit log)

2013-10-22 WIP connections and devices
2013-10-26 Update timers and fix issues
2013-10-29 Correctly start drivers
2013-10-29 Add Driver channel for events
2013-12-02 adaptor and driver generator
2013-12-18 Switch to adaptor, driver, connection and device interfaces
2013-12-30 Remove Params from driver struct
2013-12-31 Add device test coverage
2013-12-31 Add Publish function for driver events
2014-03-26 Update platforms and drivers
2014-03-27 Add more GPIO devices to README
2014-03-31 Add Halt function to DriverInterface
2014-03-31 Add Init function to DriverInterface
2014-04-16 Update generated driver
2014-04-19 Format device and connection type
2014-04-26 WIP combine all seperate adaptor and driver repos into a single repo
    [analog_sensor.fzz, blinkm.fzz, button.fzz, hmc6352.fzz, lcd.fzz, led.fzz, makey_button.fzz, maxbotix.fzz]
2014-04-27 added Halt() to a collection of devices
2014-04-28 Update i2c package
2014-04-28 Update sphero driver and examples
2014-04-29 WIP project restructure
    [analog_sensor.fzz, blinkm.fzz, button.fzz, hmc6352.fzz, lcd.fzz, led.fzz, makey_button.fzz, maxbotix.fzz]
2014-05-21 Update ardrone adaptor, driver and examples
2014-06-06 Makey button now uses Interval to manage polling
2014-06-06 I2c inteface now uses byte instead of uint16
2014-06-08 Fix Wiichuck driver
2014-06-10 Updating pebble with new structure
    Movinf events creation to newPebbleDriver method
    Adding basic button support
    Ignoring sass-cache and robeaux
    Adding accelerometer example
    Adding tap support
    Use custom server instead of classic martini
    This is to disable logs and avoid noise
    Adding correct format to code
    Adding notification support to pebble driver
    Adding tests and correcting PendingMessage
    Updating documentation
    Format to example accel
    Removing logging changes in api
    Removing temp fix in api, will be attended later
    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
2014-06-11 Add direct pin example
2014-06-11 Switch to plain net/http with pat as a pattern muxer
2014-06-12 Refactor driver commands
2014-06-12 Update platforms for new device command syntax
2014-06-13 refactor device and driver
2014-06-13 Update i2c tests
2014-06-14 Refactor ardrone driver
2014-06-15 refactor generated name for robot, device and connection
2014-06-16 The Driver struct now has an Adaptor field
2014-06-24 WIP refactor device and connection
2014-06-29 Add analog sensor data event
2014-06-30 implement direct pin for beaglebone
2014-07-01 Ensure slots are not already written into the capemanager
    Ref PR https://github.com/hybridgroup/gobot-beaglebone/pull/4
    Conflicts:
    platforms/beaglebone/beaglebone_adaptor.go
2014-07-01 Write to pwm pin when its ready
2014-07-03 Alias Connection to AdaptorInterface and Device to DriverInterface
2014-07-04 Update gpio platform and driver interface
2014-07-09 Clean up devices and connections type
2014-07-10 Fix LedDriver test
2014-07-10 Clean up drivers
2014-07-11 Fix issue with halting a sphero driver
2014-07-15 fix Port calls in leap motion adapter
    "Message" should be capitalized to match event in driver
    fix capitalization again (in example)
    last event capitalization fix: hands example
2014-07-15 fix "message" capitalization in leap driver
    fix leap examples
2014-07-17 Add more driver and adaptor test coverage
2014-08-05 pass argument DeviceID to func craftPacket to identify virtual device the packet is intended for
2014-08-21 Add dorect pin dirver to README for GPIO
2014-09-07 Adding leap + servos example (robotic hand)
2014-09-17 Add support for blinking usr leds
2014-09-18 Tests for I2C
2014-09-24 Add Edison Support
    Digital write works
    Add PWMWrite
    Add AnalogRead
    Refactor edison adaptor
    Enable more digital pins
    Enable all digital pins
    Add i2c support
    Properly close i2c device
    Restore proper examples
    Add test stub
    Add Edison README
2014-09-24 Add Edison Support
    scripts/travis.sh
    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
2014-10-22 Adding godocs documentation to i2c package
2014-10-28 Update docs
    [analog_sensor.fzz, blinkm.fzz, button.fzz, hmc6352.fzz, lcd.fzz, led.fzz, makey_button.fzz, maxbotix.fzz]
2014-10-30 WIP switching linux sysfs io to shared package
2014-11-04 Update list of platforms/drivers
2014-11-04 Add digital io and i2c tests
2014-11-04 Tests for digital io and i2c
2014-11-04 Simple case is working
2014-11-04 Add pwm and analog test coverage
2014-11-07 Add a filesystem interface, mock, and tests for the mock.
    This allows testing sysfs based drivers by swapping out the real
    filesystem for a mock one.
2014-11-10 Don't use analog slot before it's ready
2014-11-11 WIP on MPL115A2 More WIP on mpl115a2 Even more WIP This pumps out data
2014-11-11 Support for MPU6050 - Add initial support for MPU6050 - Add real simple test impl - Add proper formatting - This pumps out data
2014-11-16 Update platforms to support the new Driver and Adaptor interfaces
2014-11-17 Added support for Sensor Data Streaming in shpero driver
2014-11-19 Remove panic from servo_driver
2014-11-20 Add error to i2c interface
2014-11-20 Update beaglebone package for new i2c interface
2014-11-20 Update firmata package for new i2c interface
2014-11-20 Update edison package for new i2c interface
2014-11-20 Update raspi package for new i2c interface
2014-11-20 Update Adaptor and Driver interface to use []error
2014-11-21 Completely overhaul driver and adaptor interfaces
2014-11-22 Refactor gpio to use new driver interface
2014-11-23 Refactor ardrone to use new driver and adaptor interfaces
2014-11-23 Refactor i2c to use new driver interface
2014-11-23 Refactor joystick to use new driver and adaptor interfaces
2014-11-29 Refactor leap to use new driver and adaptor interfaces
2014-11-29 Refactor mavlink to use new driver and adaptor interfaces
2014-11-29 Refactor neurosky to use new driver and adaptor interfaces
2014-11-29 Refactor opencv to use new driver interfaces
2014-11-29 Refactor pebble to use new driver and adaptor interfaces
2014-11-29 Refactor sphero to use new driver and adaptor interfaces
2014-11-29 Add optional interval parameter for drivers which poll at an interval
2014-11-29 Clean up button driver
2014-11-29 Pins are tired of pining
2014-11-29 Refactor gpio driver interfaces
2014-11-29 Refactor i2c driver interfaces
2014-11-29 Enforce I2c interface
2014-12-03 Account for devices which are not commanders
2014-12-07 Add more error handling for unknown robots, devices and connections
2014-12-14 Add missing device descriptions to README
2014-12-19 Update opencv window and camera tests
2014-12-22 Increase i2c test coverage
2014-12-23 Fix stack trace on close
2014-12-24 Refactor pwm operations
2014-12-24 Add driver, adaptor and project subcommands to generator
2015-02-17 Almost done on LIDAR-Lite support
    Wait for 20ms between operations
    All ints all the time, unless a very good reason
2015-03-27 Add lidar example
2015-04-07 Add SSE test coverage
    Add a Stream type that handle the request to /events/:event and write tests for event stream
    Add a test for the events/:event endpoint that actually tests the endpoint response
    Using <-time.After in a 'select' creates one channel every time, let's use a time.Timer instead so that we reuse the same channel
2015-05-01 Forgot to add LIDAR-Lite to list of i2c devices
2015-06-30 Refactor firmata client library into seperate package
    Green tests
    Refactor tests to table driven
    Refactor analog, digital and i2c
    Fix tests
    golint client package
    Fix tests
    Add ServoConfig
    Rename query and i2c functions
    Fix tests
    Fix typo
2015-06-30 Add raspi pwm pi-blaster support
2015-07-04 Refactor sysfs I2C implementation and add Address parameter to I2C interface functions
2015-07-04 Add buzzer gpio driver
2015-07-04 Add grove temperature sensor driver
2015-07-04 Add relay driver
2015-07-04 Add alias drivers for sensors in the grove starter kit
2015-07-04 Add JHD1313M1 driver
2015-07-08 Corrected dependency install instructions for all current platforms
2015-07-09 Fix panic during finalize if no i2c device has been initialized
2015-07-09 add basic keyboard driver using stty
2015-07-10 Add missing grove driver alias
2015-07-12 Update lidar implementation
2015-08-21 Update pin assignments to be correct for my beaglebone.
2015-08-28 Wrong analog input mapping for BeagleBone
    According to https://github.com/CircuitCo/BeagleBone-Black/raw/master/BBB_SRM.pdf Page 105 these are the right mappings:
    P9_36 -> AIN5
    P9_35 -> AIN6
2015-09-29 Add repo setup and PR landing steps
    Fixes #230
2015-09-30 Separate error case of Particle nee Spark tests to avoid confusion
2015-09-30 Isolates shutdown-logic to Robot/Robots/Gobot.Stop
    Gobot no longer hijacks the os.Interrupt signal handler, leaving any
    shutdown logic to the user.
2015-10-05 Bebop hull protection setting and beginning of test coverage
2015-10-23 Update README with full list of current drivers/platforms
2015-11-07 Fixed event race condition
    If this is anything like the Bebop, then taking off immediately fires the "flying" event, but these events aren't buffered so attaching an event handler afterwards achieves nothing. When I ran the same code for the Bebop (as suggested on the site) it never landed, prompting an emergency connect-with-phone-hammer-buttons scramble. Swapping the event registration with the takeoff method call fixed the problem immediately.
2016-01-30 Add support for the CHIP platform
    This includes support for GPIO and I2C interfaces.
2016-02-03 Adds MCP23017 i2c device to README
2016-02-07 Get I2C functionality before doing SMBus block I/O
    In the sysfs i2cDevice implementation, use an ioctl to get the adapter
    functionality mask. Prefer SMBus block I/O but if it's not available,
    perform read/write calls directly on the file descriptor.
    Improve Wiichuck error handling. Add a 1 ms delay between I/O operations
    to the Wiichuck; this dramatically improves reliability.
2016-02-07 Add MMA7660 accelerometer example for C.H.I.P.
2016-02-08 Name C.H.I.P. pins according to printed names
    It's more convenient to refer to a pin by the name that's printed right
    on the header itself instead of having to count the pin number.
2016-02-08 Increase test delay hack for button tests
2016-02-10 Better I2C device descriptions in README
2016-02-16 Increase button delay hack for test suite
2016-02-16 Can see BLE devices, and connect to a specific one
2016-02-17 Revert "Increase button delay hack for test suite"
    This reverts commit fe221a963346150f1b90315808bdcc5fc5d658b6.
2016-02-17 Fix #236 & fix #239 by correcting initialization and temperature conversion for MPU-6050
2016-02-19 Pin 229 value left out of test fixture on edison
2016-02-20 Use OpenCV 2.4, as well as switch to main fork of go-opencv
2016-02-20 Adds support for Dualshock4 wireless gamepad
2016-03-03 Almost reading battery info
2016-04-01 Added example of how to use temp36 temperature sensor with firmata
2016-05-13 [gpio] Add support for RGB LED
2016-05-13 [gpio] Correct go formatting on RGB LED
2016-05-14 [core] Don't cut it so close when testing Every being told to be done
2016-05-15 [gpio] Improve pin logging for RGB LED
2016-05-25 [audio] Test coverage for execution of audio driver
2016-05-25 [audio] Refactor audio driver to simplify interface
2016-06-14 support gpio pin turn on and off
2016-07-03 Switching to currantlabs fork of gatt, and some related refactoring
2016-07-03 [ble] Device information service
2016-07-04 [ble] Able to connect and retrieve battery notifications
2016-07-04 [ble] Battery and status events
2016-07-04 [ble] Flying and landing and landed
2016-07-05 [ble] Rename files to match current naming scheme
2016-07-21 Fix the ServoConfig byte order
2016-07-27 Add unit tests for ServoConfig
2016-07-27 Add ServoConfig to the FirmataAdaptor
2016-07-27 Fix a typo and update the doc comment for FirmataAdaptor.ServoConfig
2016-08-02 Initial commit of driver code, with accompanying example, for the Adafruit_MotorHat.
2016-08-16 Adding two API funcs for the Adafruit driver with respect to the DC Motor, fleshing out the raspi_adafruit example with a runner function.
2016-08-17 File rename, adding a test file for the Adafruit driver, and slight func naming changes.
2016-08-23 Initial significant changes to the Adafruit Motor HAT driver to support Stepper Motors.
2016-08-25 More explicit initialization in Start, slight refactor, and separate DC Motor and Stepper Motor examples.
2016-08-25 Starting support for Intel Joule with the built-in LEDs and more
2016-08-25 joule: go fmt the multi-LED example
2016-08-25 joule: add pin mapping info to README
2016-08-25 joule: adds pin mappings from the second header
2016-08-26 Adding support for the Adafruit Servo/PWM HAT. This required a slight refactor to the existing Motor HAT code to support multiple I2C addresses.
2016-08-26 Adding a Servo example program for the Adafruit Servo Hat driver code.
2016-08-26 joule: add i2c example and notes to README about pullup resistors
2016-08-27 misc: update all LICENSE files for current year
2016-08-30 core: Refactoring to allow 'metal' development using Gobot adaptors/drivers.
2016-08-30 core: Refactor examples to allow 'metal' development using Gobot adaptors/drivers.
2016-08-30 core: Refactor tests to allow 'metal' development using Gobot adaptors/drivers.
2016-08-30 Adding tests for the Adafruit driver, and corresponding minor driver changes.
2016-08-31 Bug fix in the Adafruit stepper code, specifically with respect to the AdafruitDouble step-style.
2016-09-04 Remove debug message from i2c_device.go
2016-09-07 Add PinMode test case
    Add PinMode test case
2016-09-12 core: correct behavior in Mavlink driver, correct tests to match
2016-09-25 core: Starting refactor of new adaptor/new driver function signatures with ARDrone
2016-09-25 core: Refactor audio platform for new adaptor/driver signatures
2016-09-25 core: Move GPIO and I2C drivers into appropriately named 'drivers' directory
2016-09-25 core: Refactor GPIO drivers for new Driver creation signatures
2016-09-25 core: Refactor I2C drivers for new Driver creation signatures
2016-09-25 core: Refactor Bebop platform for new Adaptor/Driver creation signatures
2016-09-25 core: Refactor BLE platform for new Adaptor/Driver creation signatures
2016-09-25 core: Refactor Joystick platform for new Adaptor/Driver creation signatures
2016-09-25 docs: Update README with new Adaptor/Driver creation signatures
2016-09-25 core: Refactor Keyboard platform for new Driver creation signatures
2016-09-25 core: Refactor Leap Motion platform for new Adaptor/Driver creation signatures
2016-09-25 core: Refactor Mavlink platform for new Adaptor/Driver creation signatures
2016-09-25 core: Refactor MegaPi platform for new Adaptor/Driver creation signatures
2016-10-01 core: update tests to include new drivers location
2016-10-01 core: Refactor Neurosky platform for new Adaptor/Driver creation signatures
2016-10-01 core: Refactor OpenCV platform for new Driver creation signatures
2016-10-01 core: Refactor Pebble platform for new Adaptor/Driver creation signatures
2016-10-01 core: Refactor Sphero platform for new Adaptor/Driver creation signatures
2016-10-03 core: Convert all examples to use new Adaptor/Driver signatures
2016-10-03 core: Ensure that all drivers have default names
2016-10-08 tools: Clarify purpose of gobot CLI being to generate new platforms, adaptors, and drivers
2016-10-10 i2c: correct signature for Adafruit Motor Hat driver to match latest refactor
2016-10-10 edison: Experimental support for other breakout boards besides Arduino
2016-10-15 Correct adafruit examples to use new drivers package location
2016-10-15 examples: Correct adafruit examples to use new drivers package location
2016-10-18 examples: small refactor to metal button example that shows how to use Gobot event channels
2016-10-18 examples: add Firmata button metal example
2016-10-27 Adds support for Grove Magnetic Switch Sensor
    - http://wiki.seeed.cc/Grove-Magnetic_Switch/
2016-10-27 Uses NewTimer() instead of time.After() to be more efficient since the later creates new timers in a tight loop.
    - Adds more assertions to tests
    - Adds some comments to help contributors understand
    that the send occurs after the Once.
2016-10-27 Adds tests for grove temperature sensor driver
2016-10-30 gpio: PIR Motion sensor now working
2016-10-30 docs: update README with missing devices
2016-11-01 docs: update README for gpio drivers
2016-11-06 Adds tests for grove drivers
2016-11-07 core: update GPIO drivers to return simply errors
2016-11-07 core: update I2C drivers to return simply errors
2016-11-21 Adds note about the kernel version for CHIP
    - The current ChipAdaptor will only support OS 4.3 because of the
    GPIO pin mapping.
    See http://docs.getchip.com/chip.html#gpio for more details.
2016-11-26 joule: extract Tuchuck pin mapping into separate file
2016-11-27 beaglebone: map usr LEDs to match all kernels
2016-11-27 chip: auto-detect OS version to adjust pin mappings
2016-11-27 chip: default to latest OS version to adjust pin mappings
2016-12-09 ble: rename drivers to make them more obvious, and add test placeholders
2016-12-20 docs: update Raspberry Pi to latest info
2016-12-20 aio: separate analog drivers from gpio drivers
2016-12-20 docs: move AIO drivers into separate section of README
2016-12-20 aio: remove direct pin, does not make sens here
2016-12-20 i2c: godocs and separation of testing concerns
2016-12-21 docs: correct Raspberry Pi README link
2016-12-21 docs: correct I2C README link
2016-12-23 gpio: move test def for LED into test file
2016-12-27 minidrone: elaborate on which specific models are currently supported
2016-12-27 ble: move device information test code to test file
2016-12-27 ble: add generic access service driver
2016-12-27 ble: update docs to include reference to included drivers
2016-12-29 Add the I2C driver for BMP180
    https://www.adafruit.com/products/1603
2016-12-30 Change the driver API
2016-12-30 Add the I2C driver for L3GD20H gyroscope
2017-01-02 sysfs: Should fix #272 by using first byte of data as command register for I2C reads
2017-01-02 firmata: some WIP on TCP connection to WiFi connected device
2017-01-03 Add a driver for the sht3x chip.
2017-01-03 docs: update list of currently supported i2c devices
2017-01-04 particle: address #160 by adding support for tinker-servo sketch if installed on Particle device
2017-01-04 particle: add godoc comment about tinker-servo being required
2017-01-11 Tweaked test to match new gpio pin defs
2017-01-14 ollie: switch to newer ble package API
2017-01-14 minidrone: switch to use new API signatures for updated ble package
2017-01-14 ble: move new ble client device creation under Gobot's own control
2017-01-18 ble: basic serial over BLE working with Arduino101 with StandardFirmataBLE
2017-01-25 gpio: correct servo driver to pass along angle to adaptor to sort out implementation
2017-01-25 gpio: removed scaling function from servo driver
2017-01-25 mqtt: add driver for syntactical sugar around virtual devices
2017-01-31 nats: add driver to make it easier to create virtual devices
2017-02-02 i2c: use new improved default namer to avoid API conflicts
2017-02-06 Change to make I2C support more than one bus, and use other access methods than block operations.
    Added ReadWordData to i2c connection
    Code cleanup
2017-02-06 Added word sized i2c write operation
2017-02-06 Updated all i2c drivers to new interface
    Fixed I2C interface bugs
2017-02-06 Refactored platforms to new I2C interfaces
2017-02-07 docs: fix #363 by using atomic.Value to protect current values used by mutiple goroutines
2017-02-07 firmata: correct error in I2C reads not listening to board events
2017-02-07 blinkm: correct initialization params order for new I2C connection
2017-02-08 beaglebone: correct i2c buses to match actual mapping
2017-02-08 docs: add examples for i2c platforms to use BlinkM
2017-02-08 firmata: correct test awaiting i2c response
2017-02-09 i2c: add interface and implementation to allow i2c devices to be connected to alternate i2c buses than default
2017-02-09 i2c: update function signatures to have correct types
2017-02-09 i2c: complete adding optional param with alternative i2c bus for all i2c drivers
2017-02-09 i2c: add godocs for updated i2c functionality
2017-02-09 i2c: update mpu6050 for bus interface
2017-02-09 i2c: completed implemetation of I2cConfig interface
2017-02-09 i2c: correct godocs to match new constructor signatures with optional params
2017-02-10 i2c: refactoring of the interface/implementations based on feedback and golinter
2017-02-10 i2c: reorder driver implementations based on suggestions from @goinggo
2017-02-10 i2c: reorder core implementation based on suggestions from @goinggo
2017-02-10 i2c: example of using optional params
2017-02-11 i2c: ensure all current i2c drivers (except for wiichuck) use a standard i2c style request/response interaction pattern
2017-02-11 i2c: increase test coverage for drivers
2017-02-11 i2c: refactor mpl115a2 to more cleanly return desired data as methods
2017-02-11 i2c: add some additional comments for godocs awesomeeness
2017-02-13 i2c: move Config into separate file for clarity
2017-02-14 i2c: refactor MCP23017 driver to support new optional params
2017-02-14 i2c: additional refactoring MCP23017 driver to support new optional params
2017-02-14 i2c: extremely minimal tests for Connection
2017-02-14 i2c: a few more tests for Connection
2017-02-14 i2c: just one more tests for Connection
2017-02-14 i2c: increase test coverage
2017-02-14 ble: more WIP on multiple ble devices
2017-02-14 ble: test examples to excercise multiple BLE devices at once
2017-02-15 i2c: small README update
2017-02-16 chip: correct docs to describe valid pin mappings
2017-02-20 New driver for Adafruit DRV2605L
    Cleanup, added more tests for DRV2605L driver
    Fixed documentation + formatting
2017-02-20 Updated DRV2605L driver to new I2C interface
2017-02-20 Adapted DRV2605L driver to latest i2c changes
2017-02-20 Added driver for Adafruit TSL2561
2017-02-20 Updated tsl2561 driver to use new I2cConnector
2017-02-20 Fixed TSL2561 driver tests
2017-02-20 Updated TSL2561 driver to latest i2c changes
2017-02-22 core: write test for robot's devices Halt()
2017-02-24 i2c: update list of supported i2c devices
2017-02-27 Added more capabilities checks for I2C
2017-02-28 microbit: initial implementation for LEDs
2017-02-28 microbit: initial implementation for built-in buttons
2017-02-28 microbit: improve button implementation, add integrated example
2017-03-01 microbit: add accelerometer implementation
2017-03-13 Added PWM0 support to c.h.i.p
    Updated C.H.I.P README
2017-03-13 Added basic test for CHIP PWM functions
2017-03-13 Added more tests for PWM
2017-03-18 microbit: add magnetometer driver
2017-03-18 microbit: add temperature driver
2017-03-18 microbit: add supported driver to README
2017-03-18 i2c: increase jhd1313m1 test coverage
2017-03-20 i2c: test coverage for Close()
2017-03-21 i2c: minor adjustments to remove metalinter warnings
2017-03-21 gpio: increase test coverage for buzzer and relay drivers
2017-03-21 gpio: increase test coverage for button, buzzer, direct pin, led, motor, and rgb led drivers
2017-03-21 gpio: increase test coverage for buzzer driver
2017-03-21 gpio: increase test coverage for relay driver
2017-03-21 gpio: increase test coverage for PIR and servo drivers
2017-03-21 gpio: increase test coverage for motor driver
2017-03-23 aio: additional test coverage for Grove Temperature Sensor
2017-03-23 aio: additional test coverage for Analog Sensor
2017-03-25 Significantly speed up travis and make runs
    - Inline ci/travis.sh into .travis.yml
    - Use two go test steps instead of once for speed up
    - Drop the whitelist and use all the packages as listed from $(go list ./...).
    This removes the need to do bookeeping in both .travis.yml and Makefile during
    refactoring.
    - Trimmed the Makefile significantly. Removed "go test -i" as while this is
    extremely helpful when cross compiling, it doesn't help when compiling for the
    host.
    - Added deps as a phony target, made this step faster. I'm not sure of the
    usefulness of this step though and would recommend to remove it.
    - 'make examples' is currently broken so I didn't add it to .travis.yml.
    I experi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
2017-03-31 Initial ssd1306 driver implementation
2017-03-31 Increased PWM frequency
2017-03-31 Some cleanup, bme280 driver works fine
2017-03-31 i2c: WIP on adding BME280 support
2017-03-31 i2c: Placeholder method for doing humidity adjustment for BME280 support
2017-03-31 Remove bad old bme280 driver
2017-03-31 i2c: ensure bmp180 returns Temperature() error, if any
2017-03-31 i2c: refactoring since the bme280 is not the same as the bmp180
2017-03-31 i2c: add bmp280 driver, then encapsulate it with bme280 and add Humidity
2017-03-31 i2c: bmp280/bme280 raw reading in place, just need the conversions
2017-03-31 i2c: add Humidity() to bme280 example
2017-03-31 i2c: update bme280 example
2017-03-31 i2c: BME280 readings coming in, still working on conversion functions
2017-03-31 Revert "Increased PWM frequency"
    This reverts commit 899c70d6831bfd78e9e0acdd48548e30e9c464e2.
2017-03-31 i2c: functional bmp180 temperature/pressure and bme280 humidity
2017-03-31 i2c: add BME280, BMP280 and update SSD1306 in README
2017-04-01 i2c: adds Altitude() function to BMP280/BME280
2017-04-01 i2c: add test coverage for bmp280
2017-04-01 i2c: add test coverage for bme280
2017-04-01 i2c: add bme280 and bmp280 to list of supported drivers
2017-04-02 i2c: eliminate race conditions introduced by tests
2017-04-03 i2c: increase test coverage for bme280 and bmp280
2017-04-03 i2c: increase test coverage for bme280
2017-04-03 i2c: increase test coverage for Grove LCD and JHD1313M1
2017-04-04 i2c: increase test coverage for mma7660 and mpu6050
2017-04-04 i2c: increase test coverage for mma7660 and mpl115a2
2017-04-04 i2c: increase test coverage for tsl2561
2017-04-04 examples: correct build errors in all current examples
2017-04-04 i2c: increase test coverage for lidar-lite
2017-04-04 i2c: increase test coverage for l3gd20h
2017-04-04 i2c: return error correctly, increase test coverage for l3gd20h
2017-04-04 gpio: increase test coverage for direct pin driver
2017-04-04 i2c: increase test coverage for bmp180 and jdh1313m1 drivers
2017-04-04 i2c: change example for bmp180 to match current method signature
2017-04-05 ble: refactoring drivers to use BLEConnector interface and provide tests
2017-04-05 ble: increase test coverage for battery, device information, and generic access drivers
2017-04-05 microbit: increase driver test coverage
2017-04-06 firmata: correctly handle i2cwrite operations of >16 bytes by chunking them
2017-04-06 firmata: increase test coverage for i2c commands
2017-04-07 i2c: increase test coverage for Adafruit Motor HAT
2017-04-09 i2c: increase test coverage for adafruit motor hat driver
2017-04-11 i2c: remove panics and increase test coverage for tsl2561
2017-04-11 i2c: refactor and increase test coverage for tsl2561
2017-04-11 i2c: increase test coverage for drv2605l
2017-04-11 i2c: increase test coverage for jhd1313m1
2017-04-11 i2c: correctly return error, and increase test coverage for adafruit hat driver
2017-04-11 edison: refactor digital pin creation process method
2017-04-12 microbit: address #404 by adding info about required magnetometer calibration step to README
2017-04-12 docs: add explanations for scp/ssh workflow on SoC boards to README
2017-04-12 docs: improve explanations for scp/ssh workflow on SoC boards to README
2017-04-12 i2c: copy wiichuck joystick data to avoid race conditions
2017-04-12 i2c: copy wiichuck joystick data in test to avoid race conditions
2017-04-12 i2c: increase test coverage for mpu6050
2017-04-12 i2c: small refactor and increase test coverage for tsl2561
2017-04-12 i2c: small refactor and increase test coverage for l3gd20h
2017-04-15 microbit: add example showing gpio Button and LED
2017-04-15 microbit: explain how to use IOPinDriver with gpio and aio drivers
2017-04-15 microbit: correctly read bit status for AD and IO pin status on Start
2017-04-15 microbit: correct example pin mappings
2017-04-16 mqtt: add a (topic, payload) event type.
    Used for wildcard subscriptions such as 'device/topic/#'.
2017-04-17 mqtt: update the README to match the new On() prototype.
2017-04-19 mqtt: increase test coverage for driver
2017-04-19 edison: auto-detect arduino breakout board, if no specific board is expected
2017-04-19 edison: ensure that we initialize tristate if arduino breakout board
2017-04-21 sysfs: shared pwm pin implementation
2017-04-21 sysfs: increase test coverage for pwm pin
2017-04-21 sysfs: add Chip to be able to change pwmchip, and some related refactoring
2017-04-21 sysfs: changes needed to allow use of PWMPin from Adaptors
2017-04-21 intel-iot: update Edison and Joule to use sysfs.PWMPin
2017-04-22 chip: refactoring to use sysfs.PWMPin implementation
2017-04-22 chip: add back ServoWrite implementation
2017-04-22 sysfs: increase test coverage for PWMPin
2017-04-22 chip: ensure implements PwmWriter interface
2017-04-24 i2c: initial WIP on support for ADS1015
2017-04-24 i2c: support working for ads1015 adc providing AnalogReader interface
2017-04-24 i2c: add ads1015 adc to README
2017-04-24 i2c: correct reads to use simple file reads for ads1015 adc, and increase test coverage
2017-04-25 sysfs: make PWMPinner interface more consistent
2017-04-25 chip: corrections needed for sysfs.PWMPin
2017-04-25 edison: corrections needed for sysfs.PWMPin
2017-04-25 joule: corrections needed for sysfs.PWMPin
2017-04-25 tinkerboard: initial PWM implementation
2017-04-25 tinkerboard: corrections needed for sysfs.PWMPin
2017-04-26 tinkerboard: add examples for ASUS Tinker Board
2017-04-27 tinkerboard: better handling of pwm pin initialization and more test coverage
2017-04-27 docs: add CHIP Pro and Tinker Board to README
2017-04-27 Merged both 1015 drivers into one!
2017-04-27 i2c: add ads1115 to list of supported devices
2017-04-27 i2c: increase ads1x15 test coverage
2017-04-27 i2c: small refactoring and increase test coverage for bmp180
2017-04-27 gpio: avoid possible race condition in button test
2017-04-28 sysfs: export DigitalPin to make it more like PWMPin
2017-04-28 chip: export DigitalPin and PWMPin adaptor methods
2017-04-28 dragonboard: export DigitalPin and PWMPin adaptor methods
2017-04-28 edison: export DigitalPin and PWMPin adaptor methods
2017-04-28 joule: export DigitalPin and PWMPin adaptor methods
2017-04-29 tinkerboard: export DigitalPin and PWMPin adaptor methods
2017-04-29 nats: minor increase test coverage for driver
2017-04-29 joule: export PWMPin adaptor methods
2017-05-01 raspi: add implementation for PWMPinner interface that wraps pi blaster
2017-05-01 sysfs: define DigitalPinnerProvider and PWMPinnerProvider interfaces
2017-05-01 raspi: implement DigitalPinnerProvider and PWMPinnerProvider interfaces
2017-05-01 chip: implement DigitalPinnerProvider and PWMPinnerProvider interfaces
2017-05-01 edison: implement DigitalPinnerProvider and PWMPinnerProvider interfaces
2017-05-01 joule: implement DigitalPinnerProvider and PWMPinnerProvider interfaces
2017-05-01 tinkerboard: implement DigitalPinnerProvider and PWMPinnerProvider interfaces
2017-05-01 build: switch Travis build to use Ubuntu Trusty 14.04
2017-05-02 build: switching to Travis builds using Ubuntu 14.04 Trusty
2017-05-03 beaglebone: implement DigitalPinner and PWMPinner interfaces
2017-05-03 joule: remove incorrect pin assignment and improve test coverage
2017-05-04 raspi: add PWM example for Raspberry Pi
2017-05-05 cleanup driver and sample, additional documentation
2017-05-05 i2c: add INA3221 Voltage Monitor to README under supported i2c devices
2017-05-05 i2c: increase test coverage for INA3221Driver
2017-05-05 joule: correct pin mappings and add PWM example
2017-05-06 use real sensor data in tests
2017-05-06 joule: add examples using Joule with ADS1015 ADC
2017-05-06 joule: add pin naming system changes to README
2017-05-06 beaglebone: protect against pin map races
2017-05-06 chip: protect against pin map races
2017-05-06 dragonboard: protect against pin map races
2017-05-06 edison: protect against pin map races
2017-05-06 joule: protect against pin map races
2017-05-06 tinkerboard: protect against pin map races
2017-05-07 i2c: ensure lock of i2c bus for each individual operation
2017-05-09 joule: ensure built-in LEDs are labeled same as the expansion board
2017-06-15 firmata: switch to using go-serial package
2017-06-15 mavlink: switch to using go-serial package
2017-06-15 megapi: switch to using go-serial package
2017-06-15 neurosky: switch to using go-serial package
2017-06-15 sphero: switch to using go-serial package
2017-06-15 i2c: remove unused test code
2017-06-15 joystick: add needed constants for all PS3 buttons
2017-06-15 ble: allow override of specific HCI device to use
2017-06-15 Fixed PWM init bug for C.H.I.P
2017-06-15 Fixed PWM duty cycle calculation for C.H.I.P ServoWrite
2017-06-15 Issue #424: Enables humidity readings in the BME280 driver by enforcing the write to the 'ctrl_meas' register, as per Section 5.4.3 of the BME280 data sheet
2017-06-15 edison: refactor auto-discovery of Edison board option
2017-06-15 Made C.H.I.P PWM init robust for already enabled state
2017-06-15 Updated Tinkerboard and sysfs tests to updated PWM polarity contract
2017-06-15 curie: WIP on adding support for Intel Curie IMU
2017-06-15 curie: Accelerometer, Gyroscope, and Temperature sensors implemented
2017-06-15 firmata: make it possible to test external devices that use firmata adaptor
2017-06-23 gpio: correct docs formatting for Servo driver
2017-06-23 i2c: initial implementation for PCA9685 servo driver
2017-06-23 i2c: example for PCA9685 servo driver
2017-06-23 i2c: add PCA9685 servo driver to README
2017-06-23 i2c: improve docs and test coverage for PCA9685
2017-07-12 i2c: refactor i2c interface definitions out of sysfs into i2c package
2017-07-12 build: see if api and all drivers can pass tests under Windows using Appveyor
2017-07-12 i2c: exclude sysfs oriented tests on Windows, at least for now
2017-07-16 Add Linux specific step to Intel Curie docs
    - My Ubuntu 16.04 installation was initially unable to communicate with
    the intel TinyTile with "unable to connect. Perhaps you need to flash
    your Arduino with Firmata?"
    - After digging through some forums, the fix is to add some `udev`
    rules. Although I'm not sure of the specific effect of these rules, I can
    confirm the running `sudo go run main.go` is not sufficient to connect to the board.
    - Rule script:
    https://raw.githubusercontent.com/01org/corelibs-arduino101/master/scripts/create_dfu_udev_rule
2017-07-24 Mostly working driver
2017-08-25 First cut of the GoPiGo3 driver, lacking grove peripherals.
2017-09-12 Remove address from spi code
2017-09-13 Removed gopigo3 adaptor, updated gopigo3 driver
2017-09-14 docs: some helpful edits for the initial spi implementation
2017-10-05 opencv: Switchover to use GoCV and OpenCV 3.3
2017-10-05 opencv: read the image frames as fast as possible
2017-10-18 Switch to use custom domain for GoCV package
2017-10-19 holystone: some needed changes for proper driver
2017-10-19 holystone: rename driver file to keep consistent
2017-10-22 gpio: Add ButtonDriver.DefaultState to allow for 'reverse' buttons (ones that go from HIGH to LOW)
2017-10-22 i2c: SSD1306.WithDisplayHeight() and SSD1306.WithDisplayWidth() for SSD1306 that use different display ratios
2017-10-31 firmata: correct problem where last analog pin(s) were being ignored from capabilities query
2017-11-05 Change init payload sequence within jhd1313m1 driver Start() func.
    + code transposed from github.com/Seeed-Studio/Grove_LCD_RGB_Backlight/blob/master/rgb_lcd.cpp.
    + this fix ensures that the 2 lcd lines are addressable.
2017-12-02 Adding stepper motor module
2017-12-02 adding example for stepper motor
2017-12-07 docs: add GoPiGo3 and Stepper Motor to list of supported devices
2017-12-12 fixed set/get bug with motor dps
2017-12-13 up2: initial work on support for UP2 board
2017-12-13 up2: extract shared SPI init code into spi package
2017-12-13 raspi: extract shared SPI init code into spi package
2017-12-13 docs: use correct UP2 board name
2017-12-13 apa102: adding initial support for APA102 LEDs, thanks to code sample from @rakyll
2017-12-13 docs: mention SPI driver interface and APA102 support
2017-12-13 spi: add support for MCP3004 A/D converter
2017-12-13 spi: add support for MCP3008 A/D converter
2017-12-13 spi: correct support for MCP3004/MCP3008 A/D converters
2017-12-13 spi: add MCP3002 A/D converter
2017-12-13 spi: Add MCP3202, MCP3204, MCP3208, and MCP3304 drivers
2017-12-13 spi: Add MCP3202, MCP3204, MCP3208, and MCP3304 drivers to README
2017-12-16 beaglebone: use glob to find variations of pwm for mappings
2017-12-19 beaglebone: use universal io cape manager to initialize board setup
2017-12-19 beaglebone: no more slots, add docs on configuring u-boot overlays
2017-12-19 beaglebone: add SPI support and remove last vestiges of slots
2017-12-20 sysfs: pause briefly to allow udev rules to apply when exporting PWMPin
2017-12-21 roadmap: spi is now on the menu
2017-12-26 Support for more commands in ollie_driver - Set Stabilization - Set Rotation Rate - Boost - Set Raw Motor Values - Set Back LED Output
2018-01-11 Added basic driver for BH1750 (light sensor), board GY-302
2018-01-27 added documentation to private structs change filenames to lower case
2018-02-13 beaglebone: update pin naming, docs, and examples for the latest Debian OS releases
2018-02-14 docs: add references to new drivers for ADXL345, BH1750, and TM1638.
2018-02-17 Added initial support for AIP1640 led driver, used in Wemos D1 mini's matrix LED shield
2018-02-23 added spi ssd1306
2018-04-12 tello: able to fetch speed, battery, and flight time data from drone
2018-04-12 spi: switch to using periph.io for SPI interfaces
2018-04-12 spi: add optional params such as bus/chip to all current drivers
2018-04-12 spi: update README to mention new periph.io implementation.
2018-04-16 spi: remove unneeded code as suggested by @maruel
2018-04-16 spi: remove unneeded type and cleanup GoDocs
2018-04-16 spi: complete refactoring to spi.Connection
2018-04-18 joystick: correct events used by gamepad-style up/down/left/right buttons
2018-04-19 docs: add recently contributed GPIO devices to README
2018-04-20 tello: switch simple video playback example to use MPlayer
2018-04-23 tello: switch to using external crc8 and cr16 packages
2018-05-05 Initial support for MAX7219 (gpio) led driver
2018-05-18 Update driver.go
    According to my reverse-engineering, it should be like this.
2018-05-18 Update driver.go
    Add Throw & Go support(Usage same as TakeOff() function)
2018-05-20 Correct Dualshock4 controller mappings and add ps/left/right buttons
2018-05-21 slow/fast mode switch function
2018-05-25 Update the joystick driver test to read DPAD properly
2018-05-28 Improve Stepper Driver
    * Ensure StepperDriver embeds gobot.Commander to allow for command
    driven workflow
    * Add a few core commands available out of the box for control via
    command workflow
2018-06-21 restore driver interface test
2018-06-23 update gopigo3 with default spi values, cleanup
2018-07-03 Bump periph.io/x/periph to v3.0.0
    There was one breaking change in the spi.Port and spi.Conn interfaces.
    As I ran "dep ensure" with dep v0.4.1, it decided to reformat the Gopkg.lock
    file. :/
2018-07-09 Remove scaling of user input and add comments to SetPWMFreq function in PCA9685 i2c driver
2018-07-10 examples: update Tello examples for main thread friendly macOS/Windows, add Tello face tracker
2018-08-05 [#574] added error handling for config loading in joystick driver
2018-08-07 i2c: add ShowImage() function to ssd1306 driver based on @mikegleasonjr suggestion
2018-08-07 spi: add ShowImage() function to ssd1306 driver based on @mikegleasonjr suggestion
2018-08-11 Added i2c to digispark, but not working yet
2018-08-13 i2c: work in progress on GrovePi plus driver
2018-08-13 i2c: GrovePi digitalwrite implemented
2018-08-14 i2c: implemented DigitalRead, DigitalWrite, and AnalogRead for GrovePi
2018-08-14 i2c: update GrovePi to v1.3.0 firmware
2018-08-14 i2c: add missing methods so the GrovePi fully implements the Adaptor interface
2018-08-15 i2c: mention that GrovePi requires running firmware 1.3.0
2018-08-15 i2c: improve godocs for PCA9685
2018-08-15 i2c: add commands to PCA9685Driver
2018-08-15 i2c: add commands to JHD1313MDriver
2018-08-15 examples: add example that uses both the API and also a custom handler with MJPEG streaming from an attached camera
2018-08-16 raspi: export PiBlasterPeriod in Adaptor
    By setting PiBlasterPeriod to a raspi.Adaptor, the PWM pin will now
    reflect the correct duty cycle to /dev/pi-blaster.
2018-08-17 Digispark i2c fixes, added Test for checking available addresses
2018-08-22 Added some tests for digispark i2c connector
2018-08-24 digispark: remove test that is expected to ofail, but passes when digispark board is actually connected
2018-08-24 digispark: add examples using digispark with i2c devices blinkm and mlp115a2
2018-08-29 i2c: update PCA9685 driver to use same protocol as Adafruit Python lib
2018-08-30 Added rudiementary support for TH02 Grove Sensor
    This commit adds basic support for a TH02 based Grove Sensor which is
    silkscreened as
    Temperature&Humidity Sensor (High-Accuracy & Mini ) v1.0
    https://www.seeedstudio.com/Grove-Temperature-Humidity-Sensor-High-Accuracy-Min-p-1921.html
    This is a modified variant of a SHT2* driver, and still needs some
    changes to be more useable. It is written to assume you want to use the
    High Precisions (slow sample rate)
2018-08-31 More reworking
    - Added ability to add heating profile
    - waitForReady now takes a variable timeout value
    - Added ability to change the sample accuracy
2018-09-03 add 128x32 and 96x16 sizes to the i2c ssd1306 driver
2018-09-05 up2: correct i2c default bus information to match correct values
2018-09-06 grovepi: add mutex to control transactionality of the device communication
2018-09-07 up2: add support for built-in LEDs
2018-09-08 up2: useful constant values to access the built-in LEDs
2018-09-14 Adde unit tests for TH02 & Minor improvement
    - Added ability to change sample resolution
    - Added unit tests for TH02Driver. The way the functions are written,
    it will be hard to get a fully working .Sample() coverage with my
    limited understanding of gobot's testing API. The chip is rather needy,
    and each sample requires multiple read and write steps, so getting both
    read and write for 2 independant measurements it a little over my head
    without some more code viewing.
    Id rather get this checked in and think of a better way to do this.
    Otherwise, this does test the functionality
2018-09-14 Add SparkFun’s EasyDriver (and BigEasyDriver)
2018-10-04 tello: update FlightData struct
    - Correct the name of EmSky, EmGround and GroundSpeed to Flying,
    OnGround and VerticalSpeed.
    - Remove FlySpeed, WifiDisturb and WifiStrength as these are not part
    of the data.
    - Add AirSpeed() and GroundSpeed() for calculating the airspeed and
    ground speed.
2018-10-09 build out the ccs811 driver
2018-10-15 Hot-fix driver.go
    drone.Hover() was not showing expected behavior in stopping the movement due to missing d.lx type.
2019-01-24 pwm_pin - Fix DutyCycle() parse error, need to trim off trailing '\n' before calling strconv.Atoi(), as other functions in this package do
2019-02-13 Added methods to read Sphero Power States
2019-05-21 Stop using Red parameter for brightness value
    This change corrects using Red parameter of RGBA for the Brightness value, to using the Alpha parameter of RGBA.
    As the brightness max value for APA102 is `31` the `math.Min` stops the driver from using any value higher than 31.
2019-05-21 spi: correct param used for APA102 Draw() method
2019-05-31 Apa102 use default brightness (#671)
    * spi/apa102: use uint8 type with a max of 31 for brightness
2019-06-25 Added ability to make a relay driver inverted (#674)
    * gpio: Added ability to make a relay driver inverted
2020-01-11 Added tello edu driver
2020-01-14 #700 - Avoid to close the connection.
    Each spi drivers must not close the connection: it's not its responsibility.
    Robots should close the connection.
2020-03-17 Add graceful halt for Tello driver
    * graceful terminate connections for video and command communication
2020-03-31 Update RelayDriver to invert value written on Inverted
2020-06-21 Initial support for SHT2x Temperature/Humidity sensor driver
2020-10-28 Support for BMP388 Barometric Pressure/Temperature/Altitude Sensor
2020-10-28 [test] Implement driver tests
2020-10-29 Resolve issue with PWM for PWMWrite
    4096 is outside of the value that is able to be written to a pin. Lowered the scale and updated the comments
2020-11-27 feat(ultrasonic): Add ultrasonic i2c
    add ultrasonic support for i2c driver
    add basic test for ultrasonic sensor
    fix length and update test for i2c driver
2020-11-28 gpio: correct test for hd44780 driver to match newer signature
2020-11-28 Add delay for Run function of StepperDriver.
2021-04-14 Fix servo and DC motors presence
    Fix the presumption both servo and DC motors are present
2021-11-14 MCP3004: correct number of channels
    the MCP3004 has 4 channels, not 3.
    Fixes: b0160105("spi: Add MCP3202, MCP3204, MCP3208, and MCP3304
    drivers")
2022-04-08 switch off debug
2022-04-08 don't panic on 'With*' allow simpler wrapping of drivers
2022-04-17 digispark fix ReadByte & WriteByte, rework and add i2c tests
2022-04-17 digispark remove useless code in i2c test
2022-04-24 add AnalogActuatorDriver, analog temperature sensor, driver for PCF8591 (with 400kbit stabilization), driver for YL-40
2022-04-24 fix raspi PWMPin.SetDutyCycle (#800)
    raspi: PWMPin.SetDutyCycle
    - value 0 is allowed in pi blaster
    - for pi-blaster, duty should not going below 2us, unless the duty is 0
2022-04-30 fix tinkerboard i2c0 to i2c4, improve comments in pin map, improve README
2022-07-13 adjust analog sensor driver to prevent ReadValue() to get float64
2022-09-24 BUGFIX: new pwm behaviour of tinkerboard
2022-09-24 switch to golang 1.19 and to new cimg
2022-09-25 fix PWM related read/write tests
2022-09-25 Add diagonal hat directions
    Diagonal directions are simply the 2 buttons hit added.
    Tested on a PowerA Xbox controller
2022-09-27 fix examples and gopigo3 driver
2022-10-01 NEW: i2c.ReadBlockData(), BUGFIX: Read*Data() in digispark and some small other fixes
2022-10-02 introduce generic i2c.Driver with example for digispark fix missing/wrong entries in README stabilize test
2022-10-02 introduce PCA9501 driver inspired by mcp23017_driver and example for digispark
2022-10-02 BUGFIX/Improvement: TH02 wrong register for heater, use i2c.Driver
2022-10-21 GrovePi add read firmware version and DHT sensors
2022-10-22 fix jetson nano pwm feature
2022-10-22 i2c PCF8583 clock and counter driver introduced
2022-10-23 change JSBlasterPeriod to pwmDefaultPeriod
2022-10-23 Jetson nano add missing SetPolarity
2022-11-09 Added support for Dualsense joystick (PlayStation 5) (#880)
    * Dualsense base files copied from Dualshock4
    * Buttons and axis corrected for Sony Dualsense
2022-11-13 adjust README for gpio, pwm, i2c and add example
2022-11-13 add PCA953x i2c driver
2022-11-27 gpio: add support for new character device Kernel ABI
2022-12-05 Bugfix/Improvement: Use PWMPinsAdaptor for platforms
2022-12-05 Bugfix: raspi pwm cache
    as addendum to #890
2022-12-08 Introduce I2cBusAdaptor for composition in platforms
2022-12-10 Improve: use base driver for all I2C devices
2022-12-17 Bugfix/Improvement: Introduce SpiBusAdaptor and spi.Driver for composition in platforms/drivers
    and fix for #794
2023-01-05 SPI using GPIO's plus driver for MFRC522
2023-01-28 add advanced digital pin options (pull, bias, drive, debounce, event)
2023-02-04 BUGFIX: I2C connection-bus caching and multiple device usage
2023-02-14 Add support for Radxa's Rock Pi 4(C+) Single Board Computers (#902)
2023-03-23 Add configuration for Nintendo Switch controllers (#903)
2023-05-19 Fix(build): linter findings of "gosimple", "govet" and "staticcheck" (#917)
    Fix also encoder and dps overflow in gopigo3 "GetMotorStatus()". Problem found by "staticcheck".
2023-05-22 Build(v2): fix usage by moving code to a v2 subfolder (#927)
    [littleWire.c, littleWire.h, littleWire_servo.c, littleWire_servo.h]
2023-05-29 Build(v2): revert move to v2 subfolder (#932)
    * revert move to v2 subfolder
    * fix CI and adjust CHANGELOG
    [littleWire.c, littleWire.h, littleWire_servo.c, littleWire_servo.h]
2023-05-29 Build(v2): revert move to v2 subfolder (#932) (#938)
    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
    [littleWire.c, littleWire.h, littleWire_servo.c, littleWire_servo.h]
2023-06-04 Build(go, deps): switch to Go 1.18 and update modules (#940)
2023-06-19 system(syscall): switch to x/sys (#963)
2023-09-26 sphero: Add support for calibration
    - Includes a sample program to show how it works.
2023-10-19 adaptors(PWM): fix wrong duty cycle after kill program (#994)
2023-10-20 test(all): switch to test package stretchr testify (#1006)
2023-10-20 build(go, deps): switch to Go 1.19 and update modules (#1008)
2023-10-20 build(style): switch to gofumpt and add linters (#1009)
2023-10-27 gpio(hcsr04): add driver for ultrasonic ranging module (#1012)
2023-10-28 jetson(PWM): fix set period (#1019)
2023-10-29 i2c(PCA9685, adafruit): clean up architecture and fix init (#1021)
2023-11-01 gpio: fix data race in ButtonDriver (#1027)
2023-11-09 gpio: fix data race in StepperDriver (#1029)
2023-11-11 i2c(core): fix problems with usage of uintptr (#1033)
2023-11-12 lint(all): switch to 1.55.2 and adjust linter issues (#1036)
2023-11-26 aio(analog sensor): fix deadlock in cyclic reading (#1042)
2023-11-26 platforms(adaptors): add a generic analog pin adaptor (#1041)
2023-11-27 aio(thermalzone): add driver for read a thermalzone from system (#1040)
2023-12-05 adaptors(pwm): introduce scale option for servo (#1046)
2023-12-11 raspi(pwm): add support for sysfs and fix pi-blaster (#1048)
2024-02-04 ble: introduce in drivers folder (#1057)
2024-02-12 neurosky: use serialport adaptor and move driver to drivers/serial (#1061)
2024-02-12 megapi: use serialport adaptor and move driver to drivers/serial (#1062)
2024-02-13 build(go, deps): switch to Go 1.20 and update modules (#1067)
2024-02-13 i2c/spi: remove offensive terminology (#1071)
2025-08-23 build(go, deps): switch to Go 1.24 linter 2.4.0 and update modules (#1162)
2025-10-04 i2c(all): ensure halt is idempotent (#1171)
2025-10-04 spi(all): ensure halt is idempotent (#1173)
2025-10-04 1-wire(all): ensure halt is idempotent (#1174)
2025-10-08 i2c(bme280): fix default name (#1177)
2025-10-08 drivers: fix nil connector check (#1178)
2025-10-08 i2c(mcp23017): fix missing code for halt is idempotent (#1175)
2025-10-08 i2c(adafruit1109): rework debug messages (#1182)
